Creality3DPrinting/Ender-3/Ender-3 Mechanical/Ender-3 Parts/ender_lcd.png

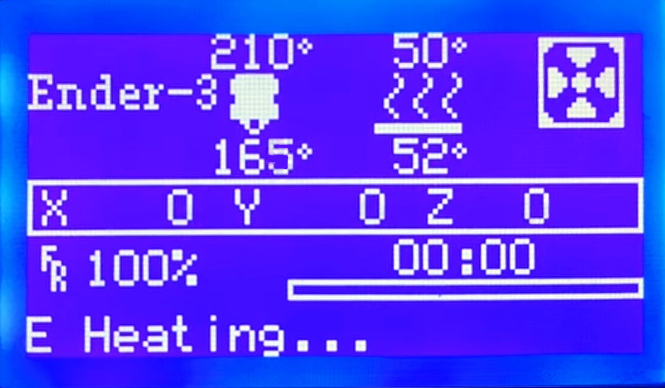
Ender-3 Mechanical/Ender-3 Parts/ender_lcd.png
