Creality3DPrinting/Ender-3/README.md

# Ender-3
The Creality3D Ender-3, a fully Open Source 3D printer perfect for new users on a budget.
