Creality3DPrinting/Ender-3/Ender-3 SD/2.Software and USB Driver/CURA/Reference data/Ender 3 Reference data.pdf

# Ender 3 Reference data

Shenzhen Creality3D Technology CO.,LTD.

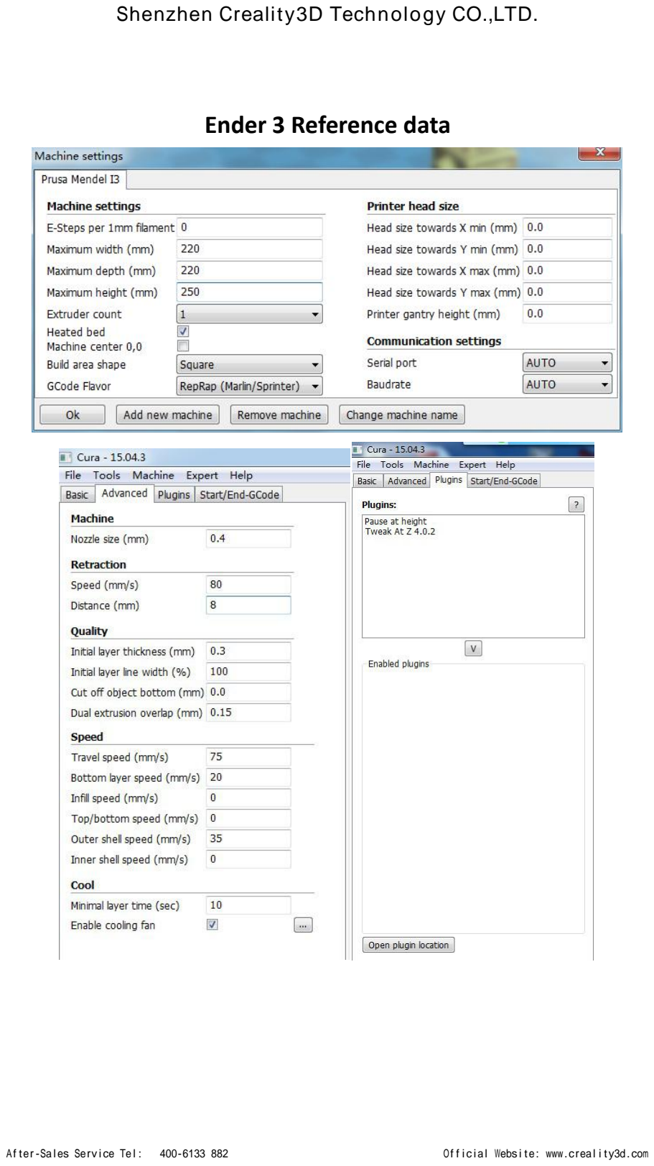
[picture p2: page 1]

After-Sales Service Tel: | 400-6133 882 | Official Website: www.creality3d.com

Shenzhen Creality3D Technology CO.,LTD.

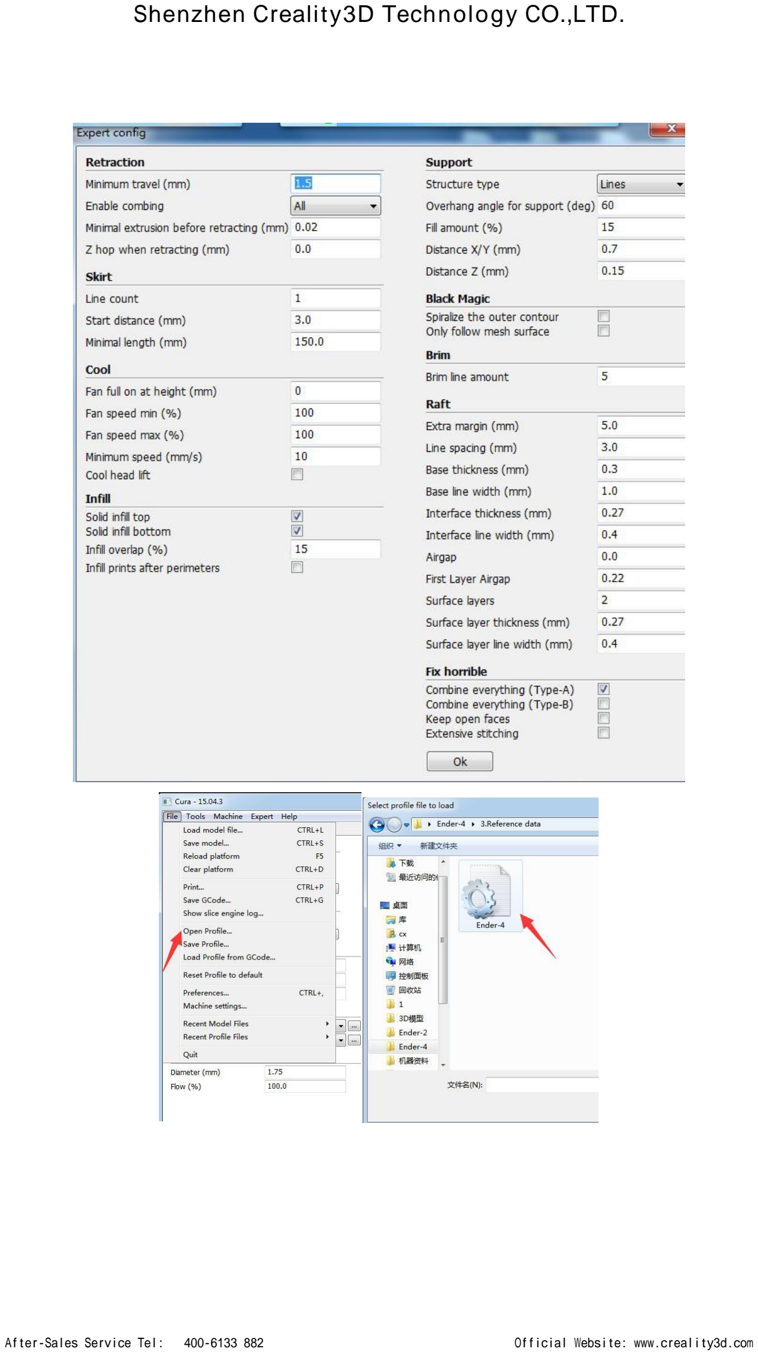
[picture p3: page 2]

After-Sales Service Tel: | 400-6133 882 | Official Website: www.creality3d.com
