Creality3DPrinting/Ender-3/Ender-3 Mechanical/Ender-3 Parts/ender-3.jpg

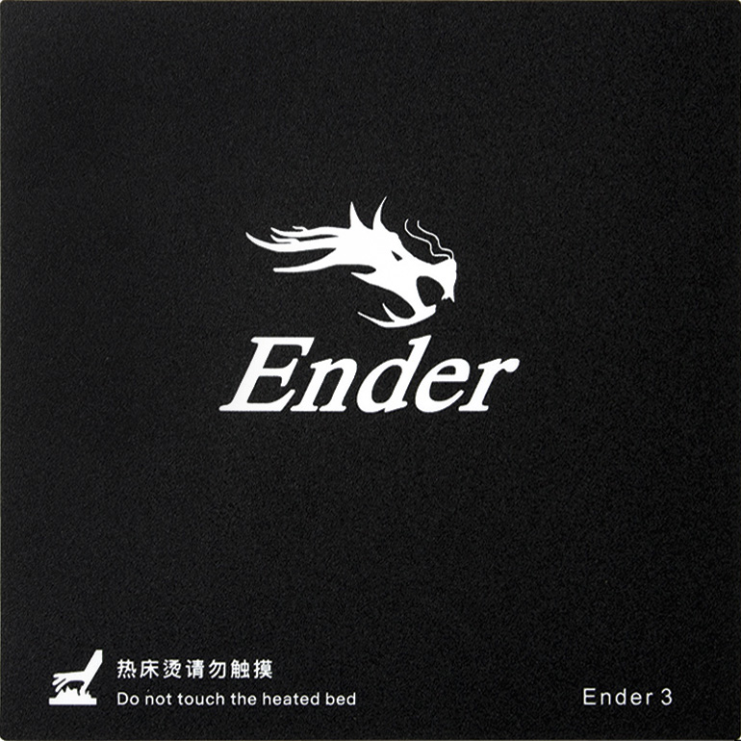
Ender-3 Mechanical/Ender-3 Parts/ender-3.jpg
