Creality3DPrinting/Ender-3/Ender-3 Mechanical/Ender-3 Parts/ASM X-Axis.SLDASM

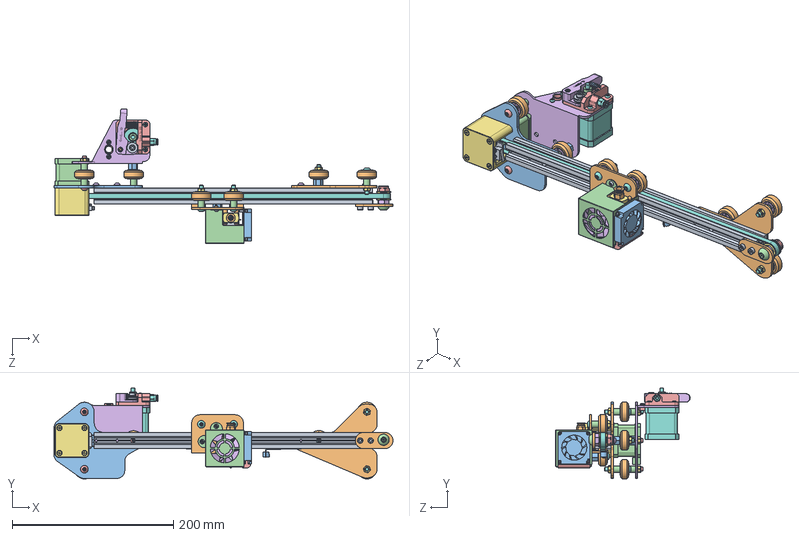
[picture p8: CAD file, 2018-09-13]
Ender-3 Mechanical/Ender-3 Parts/ASM X-Axis.SLDASM
420.0 x 112.6 x 166.7 mm
2020 profile
Z Stent
X motor bracket
42-34 motor
z nut
E motor bracket
X limit switch bracket
X belt
limit switch
2GT-pulley
Copper cover x 2
M4 Split Washer x 5
M3 Split Washer x 4
M4X16 Pan Head Screw x 4
M3X40-P x 4
M3X10 Pan Head Screw x 8
M3X6Pan Head Screw x 4
Rollers x 9
Eccentric column x 3
Spacers for rollers x 9
M5X40 Pan Head Screw x 3
625pillow x 18
M5 Self-locking nut x 9
40-42 motor
624U pillow
M3X18 Socket Head Screw
Extrusion Spring
E gear
E housing 2
E idler tensioner
M3X10 Flush Head Screw
M6 Pneumatic joint
M4X8 Socket Head Screw x 3
X Adjustment Block
M5 T-Slot Nut x 2
M8X25 Pan Head Screw
M8 Self-locking nut
M8 nut
F688 pillow x 2
M5X30 Pan Head Screw x 6
M5 Split Washer
E plate
Cold section fan
Fan cover
Nozzle fan duct
Nozzle fan
Radiator
nozzle
Heat block
Pneumatic joint
Nozzle thermistor
Heater
M3X16 Pan Head Screw x 2
M3×18 Flush Head Screw x 2
M3 Screw x 2
M5 washer
M2X8 Socket Head Screw x 4
