Creality3DPrinting/Ender-3/Ender-3 Mechanical/Ender-3 Parts/ASM Roller Y-Axis.SLDASM

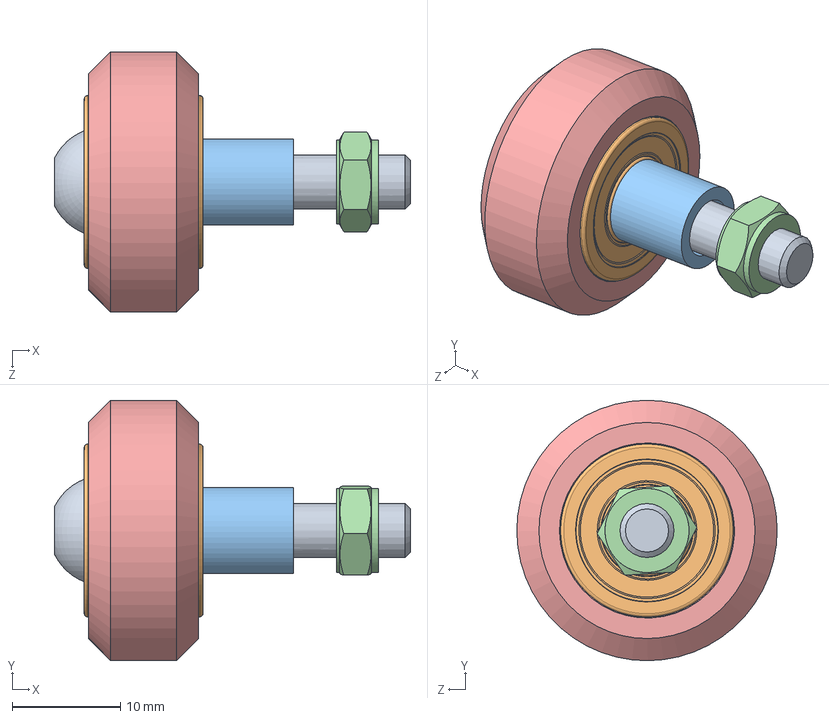
[picture p9: CAD file, 2018-09-13]
Ender-3 Mechanical/Ender-3 Parts/ASM Roller Y-Axis.SLDASM
33.0 x 24.1 x 24.1 mm
M5X30 Pan Head Screw
625pillow x 2
Spacers for rollers
M5 Self-locking nut
Rollers
