Creality3DPrinting/Ender-3/Ender-3 Mechanical/Ender-3 Parts/ASM Extruder.SLDASM

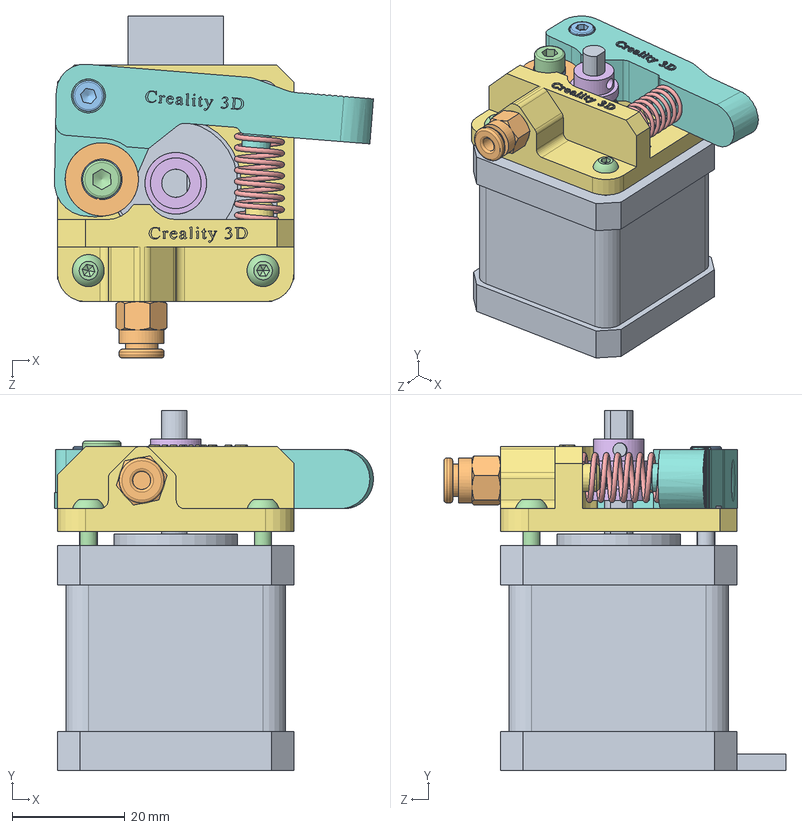
[picture p10: CAD file, 2018-09-13]
Ender-3 Mechanical/Ender-3 Parts/ASM Extruder.SLDASM
56.7 x 64.0 x 60.7 mm
40-42 motor
624U pillow
M3X18 Socket Head Screw
M3X10 Pan Head Screw x 2
Extrusion Spring
E gear
E housing 2
E idler tensioner
M3X10 Flush Head Screw
M6 Pneumatic joint
M4 Split Washer
M4X8 Socket Head Screw
