Creality3DPrinting/Ender-3/Ender-3 Mechanical/Ender-3 Parts/ASM Heating Unit.SLDASM

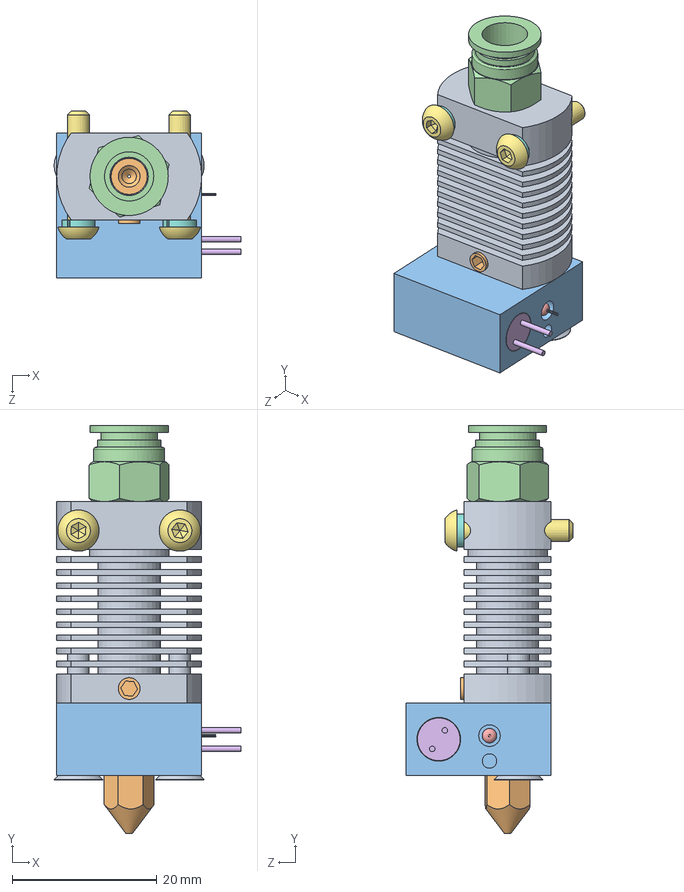
[picture p11: CAD file, 2018-09-13]
Ender-3 Mechanical/Ender-3 Parts/ASM Heating Unit.SLDASM
25.8 x 56.3 x 23.0 mm
Radiator
nozzle
Heat block
Pneumatic joint
Nozzle thermistor
Heater
M3X16 Pan Head Screw x 2
M3 Split Washer x 2
M3×18 Flush Head Screw x 2
M3 Screw x 2
