Creality3DPrinting/Ender-3/Ender-3 Mechanical/Ender-3 Parts/ASM Eccentrical Roller Y-Axis.SLDASM

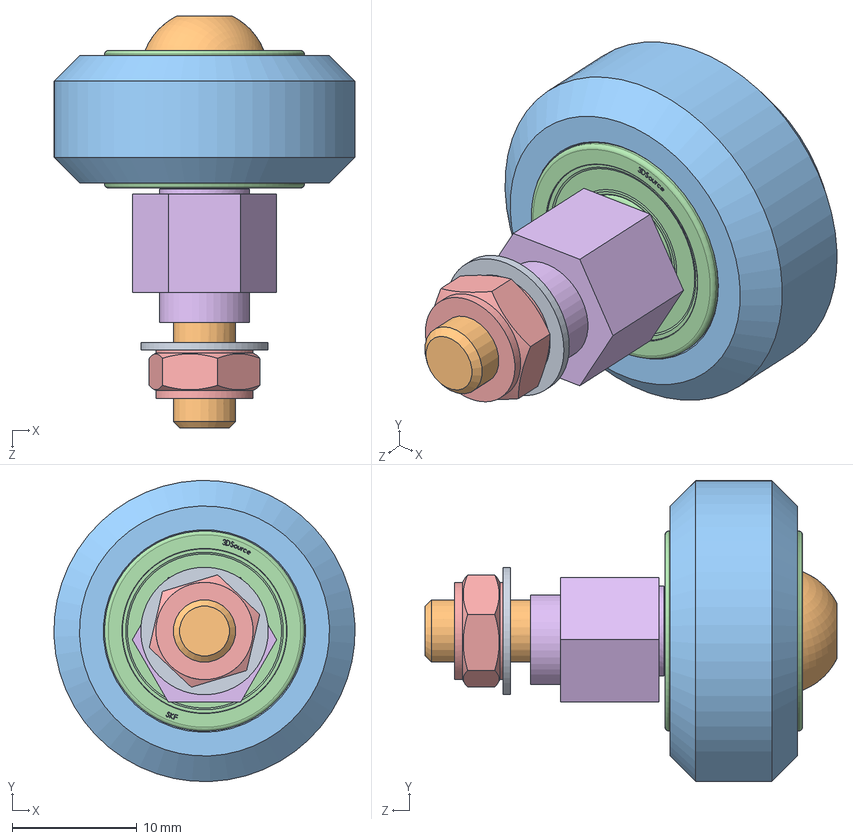
[picture p12: CAD file, 2018-09-13]
Ender-3 Mechanical/Ender-3 Parts/ASM Eccentrical Roller Y-Axis.SLDASM
24.1 x 24.1 x 33.0 mm
M5 washer
M5X30 Pan Head Screw
Rollers
625pillow x 2
M5 Self-locking nut
Eccentric column
