Creality3DPrinting/Ender-3/Ender-3 Mechanical/Ender-3 Parts/ASM X-Belt Tensioner.SLDASM

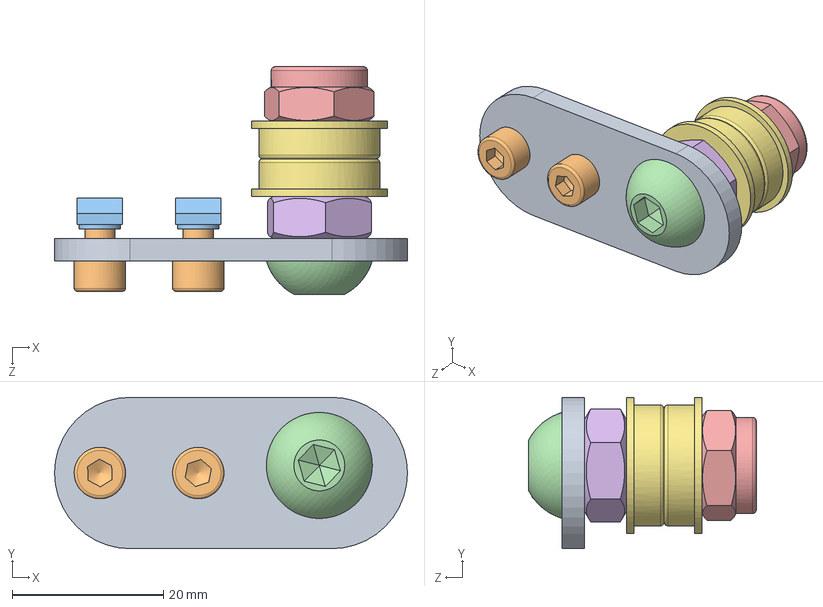
[picture p14: CAD file, 2018-09-13]
Ender-3 Mechanical/Ender-3 Parts/ASM X-Belt Tensioner.SLDASM
46.7 x 20.0 x 30.1 mm
X Adjustment Block
M4X8 Socket Head Screw x 2
M5 T-Slot Nut x 2
M8X25 Pan Head Screw
M8 Self-locking nut
M8 nut
F688 pillow x 2
