Creality3DPrinting/Ender-3/Ender-3 Mechanical/Ender-3 Parts/ASM Printing Head.SLDASM

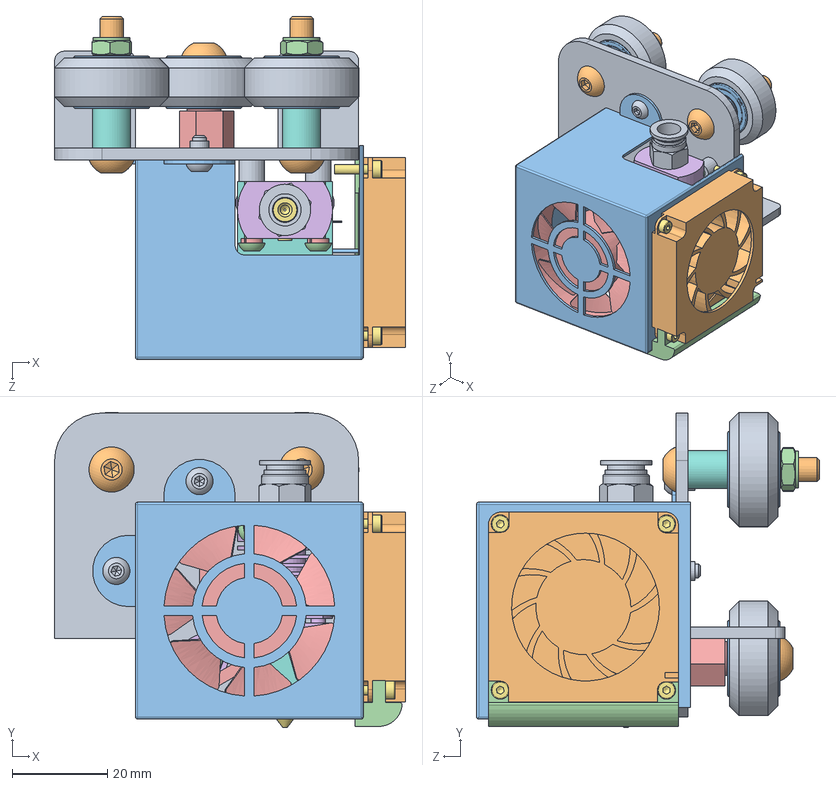
[picture p17: CAD file, 2018-09-13]
Ender-3 Mechanical/Ender-3 Parts/ASM Printing Head.SLDASM
73.9 x 66.4 x 72.2 mm
E plate
Cold section fan
Fan cover
Nozzle fan duct
Nozzle fan
Radiator
nozzle
Heat block
Pneumatic joint
Nozzle thermistor
Heater
M3X16 Pan Head Screw x 2
M3 Split Washer x 2
M3×18 Flush Head Screw x 2
M3 Screw x 2
Spacers for rollers x 2
Rollers x 3
M5X30 Pan Head Screw x 3
625pillow x 6
M5 Self-locking nut x 3
Eccentric column
M5 washer
M2X8 Socket Head Screw x 4
M3X10 Pan Head Screw x 4
M3X6Pan Head Screw x 2
