Creality3DPrinting/Ender-3/Ender-3 Mechanical/Ender-3 Parts/ASM Spool Holder.SLDASM

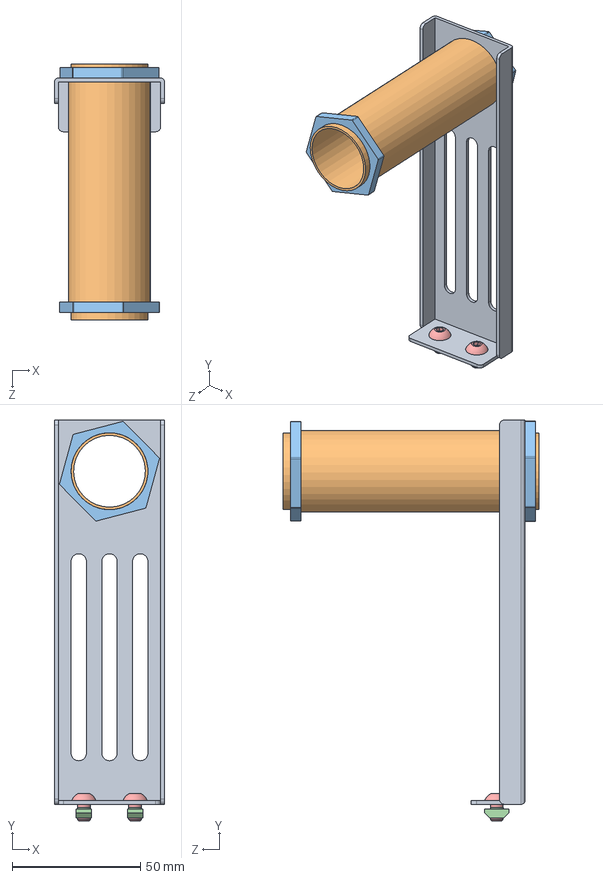
[picture p18: CAD file, 2018-09-13]
Ender-3 Mechanical/Ender-3 Parts/ASM Spool Holder.SLDASM
43.0 x 156.5 x 100.0 mm
Support frame
Support tube
M30 Plastic nut x 2
M4 T-Slot Nut x 2
M5X8Pan Head Screw x 2
