Creality3DPrinting/Ender-3/Ender-3 Mechanical/Ender-3 Parts/ASM Eccentrical Roller Z-Axis Left.SLDASM

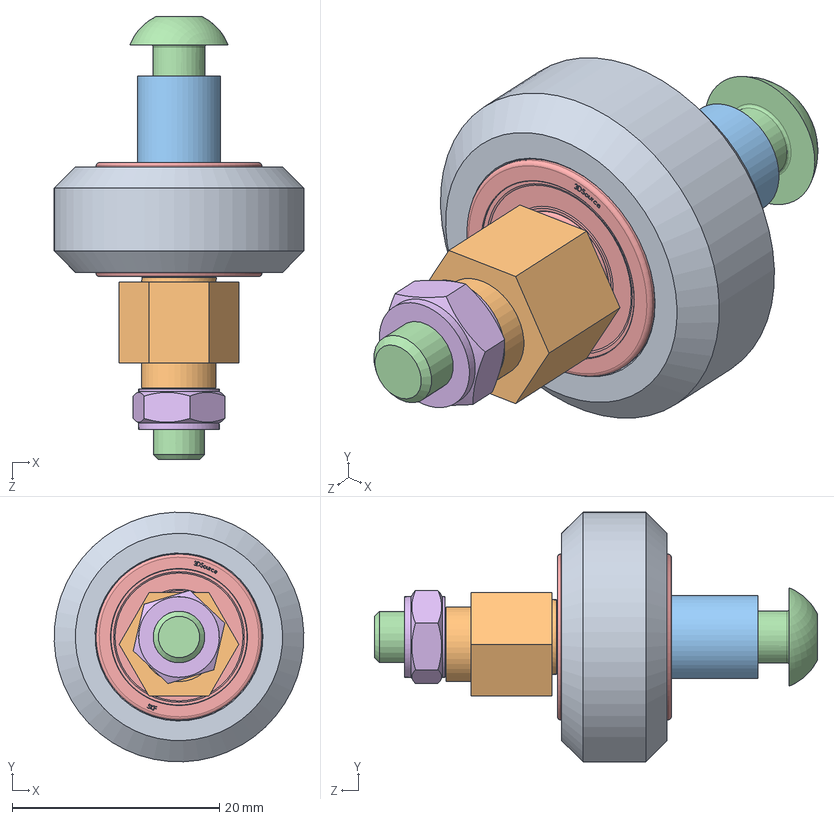
[picture p24: CAD file, 2018-09-13]
Ender-3 Mechanical/Ender-3 Parts/ASM Eccentrical Roller Z-Axis Left.SLDASM
24.1 x 24.1 x 42.8 mm
Rollers
Eccentric column
Spacers for rollers
M5X40 Pan Head Screw
625pillow x 2
M5 Self-locking nut
