Creality3DPrinting/Ender-3/Ender-3 Mechanical/Ender-3 Parts/ASM Roller Z-Axis Left.SLDASM

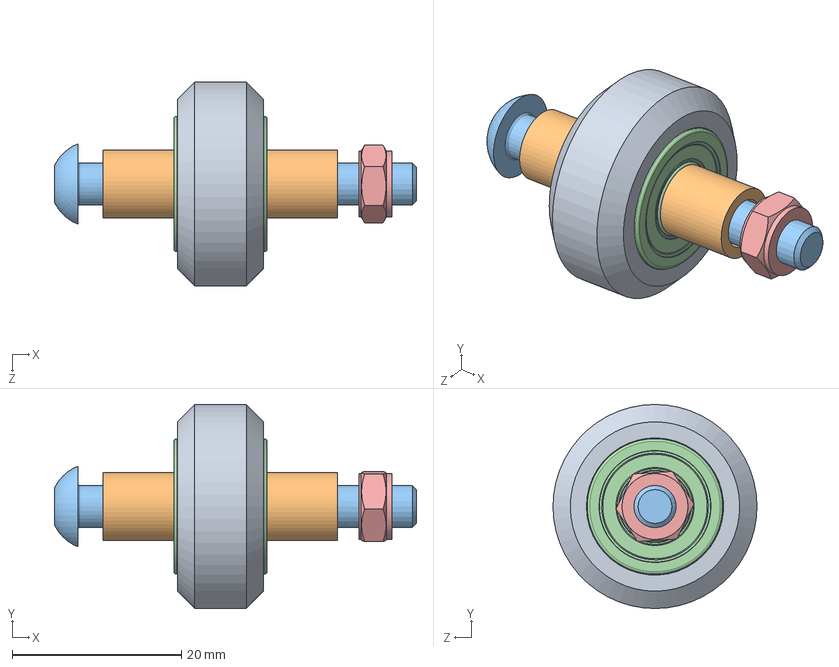
[picture p25: CAD file, 2018-09-13]
Ender-3 Mechanical/Ender-3 Parts/ASM Roller Z-Axis Left.SLDASM
42.8 x 24.1 x 24.1 mm
Rollers
Spacers for rollers x 2
M5X40 Pan Head Screw
625pillow x 2
M5 Self-locking nut
