Creality3DPrinting/Ender-3/Ender-3 Mechanical/Ender-3 Parts/V Wheel Component.SLDASM

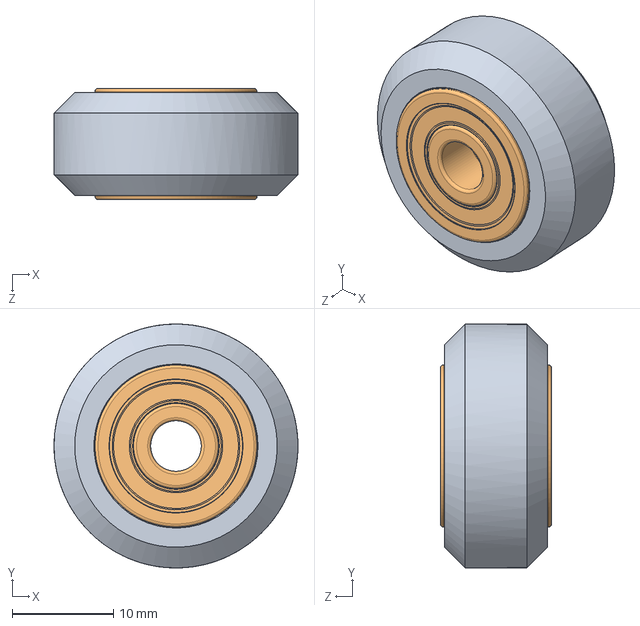
[picture p27: CAD file, 2018-06-30]
Ender-3 Mechanical/Ender-3 Parts/V Wheel Component.SLDASM
24.1 x 24.1 x 11.0 mm
Rollers
625pillow x 2
