Creality3DPrinting/Ender-3/Ender-3 Mechanical/Ender-3 Parts/Fan assembly.SLDASM

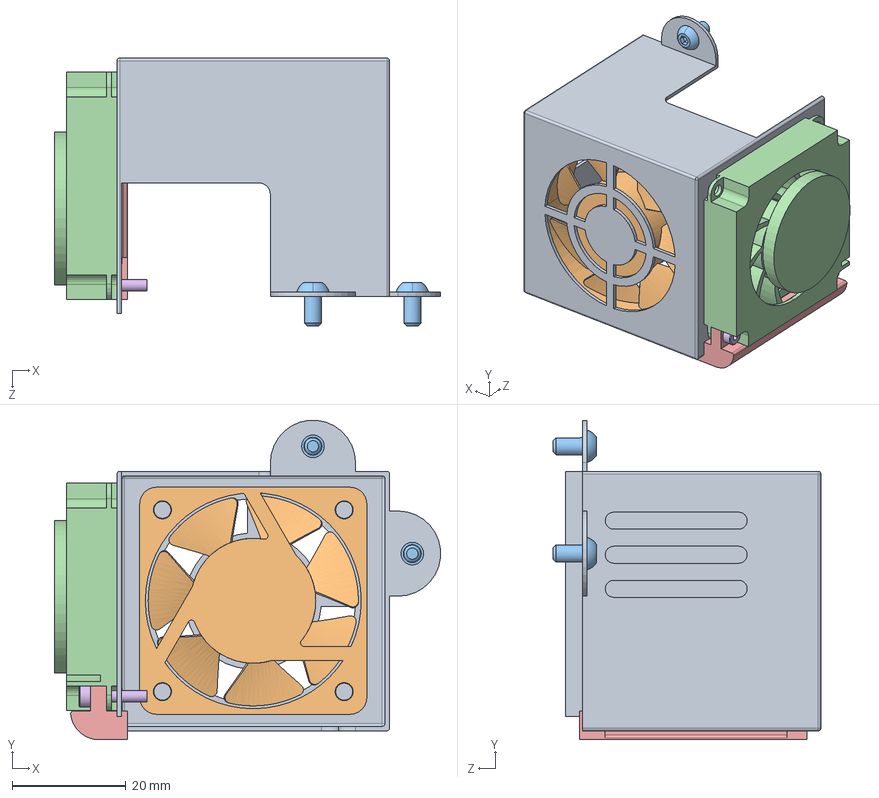
[picture p28: CAD file, 2018-06-30]
Ender-3 Mechanical/Ender-3 Parts/Fan assembly.SLDASM
68.0 x 56.2 x 47.2 mm
Fan cover
Nozzle fan
M3X6Pan Head Screw x 2
Cold section fan
Nozzle fan duct
M2X10杯头 x 2
