Creality3DPrinting/Ender-3/Ender-3 Mechanical/Ender-3 Parts/Z Limit Switch assembly.SLDASM

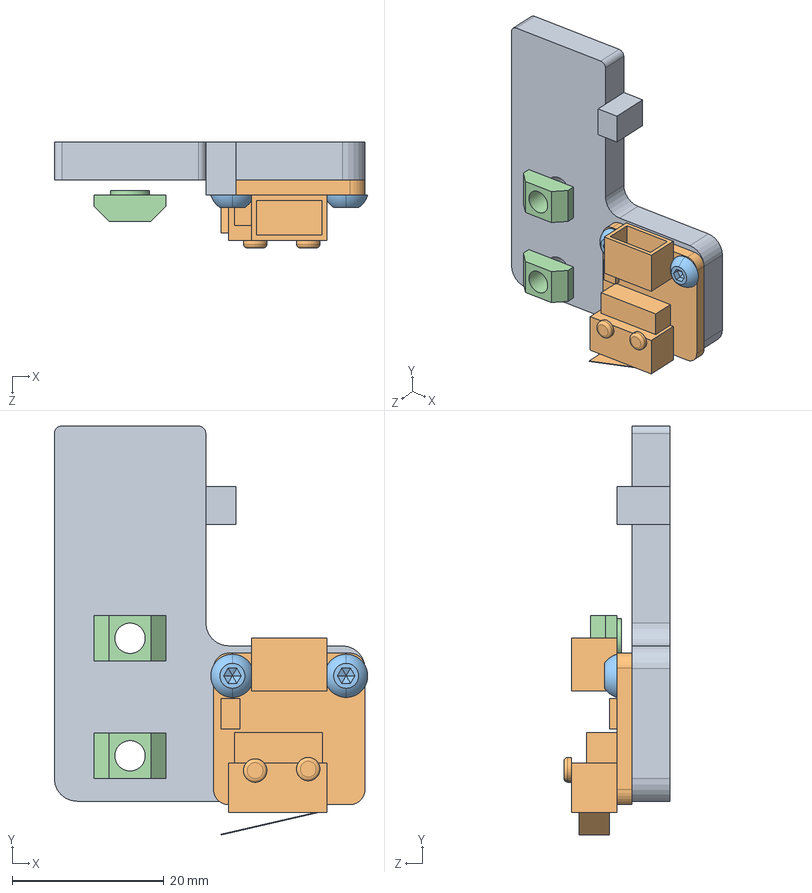
[picture p29: CAD file, 2018-06-30]
Ender-3 Mechanical/Ender-3 Parts/Z Limit Switch assembly.SLDASM
41.4 x 54.0 x 14.0 mm
Z limit switch bracket
limit switch
M3X6Pan Head Screw x 2
M4 T-Slot Nut x 2
