Creality3DPrinting/Ender-3/Ender-3 Mechanical/Ender-3 Parts/Sprinkler assembly.SLDASM

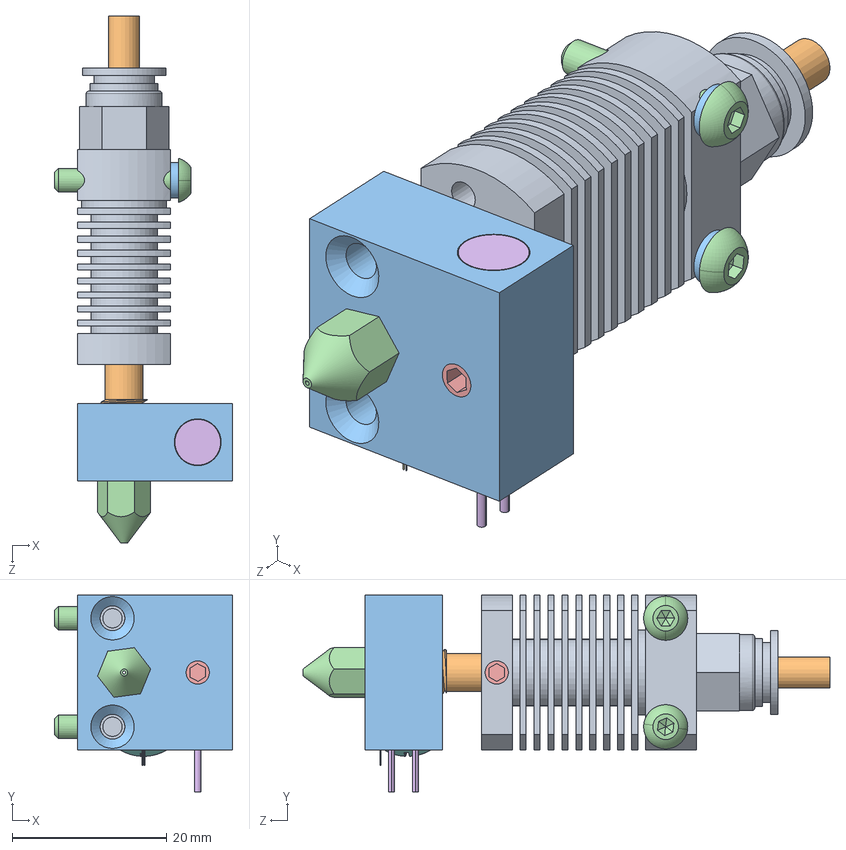
[picture p30: CAD file, 2018-06-30]
Ender-3 Mechanical/Ender-3 Parts/Sprinkler assembly.SLDASM
23.0 x 25.4 x 68.0 mm
Radiator
Catheter
Heat block
nozzle
M3 Screw x 2
Heater
Nozzle thermistor
M3X4 Screw
Pneumatic joint
D4 Teflon tube
M3 Split Washer x 2
M3X16 Pan Head Screw x 2
