Creality3DPrinting/Ender-3/Ender-3 Mechanical/STP/Z Stent.step

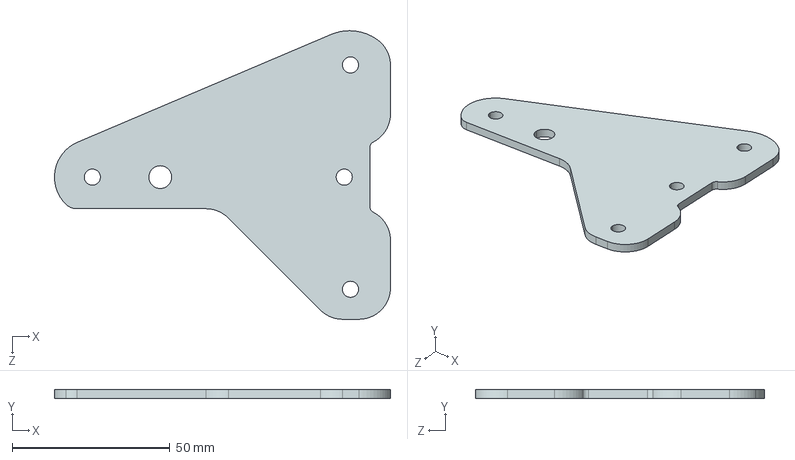
[picture p31: CAD file, 2018-06-30]
Ender-3 Mechanical/STP/Z Stent.step
106.3 x 3.00 x 91.3 mm
