Creality3DPrinting/Ender-3/Ender-3 SD/4.Modle/test/test-dog.stl

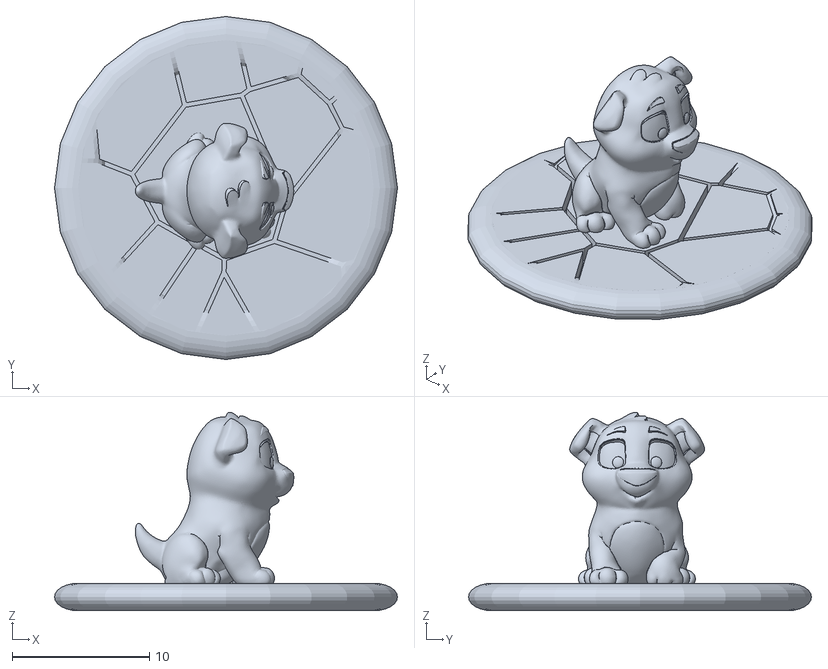
[picture p32: CAD file, 2019-12-11]
Ender-3 SD/4.Modle/test/test-dog.stl
25.0 x 25.0 x 14.5
