Creality3DPrinting/Ender-3/Ender-3 Mechanical/Ender-3 Parts/E housing 2.SLDPRT

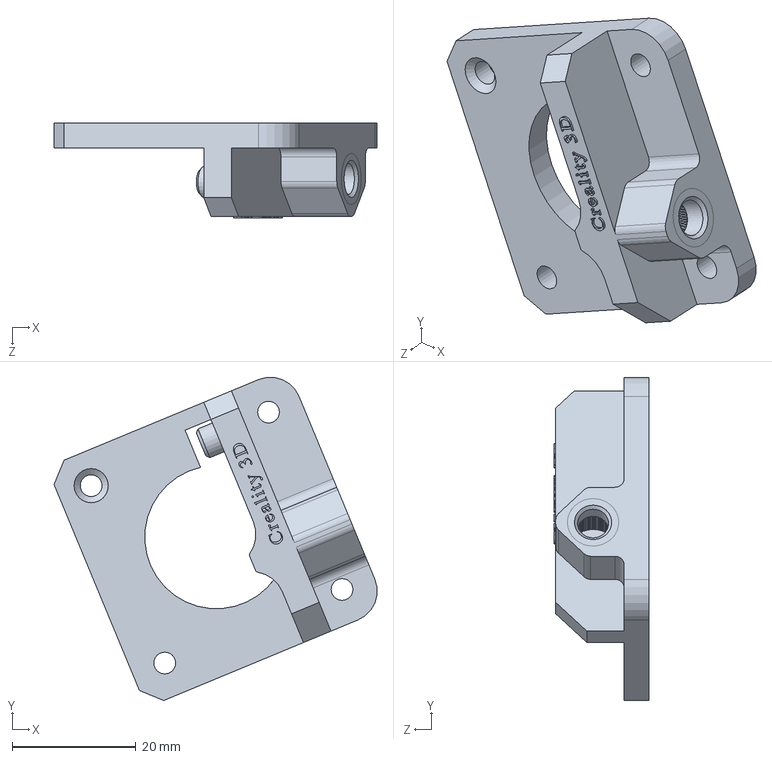
[picture p33: CAD file, 2018-09-13]
Ender-3 Mechanical/Ender-3 Parts/E housing 2.SLDPRT
52.2 x 52.2 x 15.4 mm
