Creality3DPrinting/Ender-3/Ender-3 Mechanical/Ender-3 Parts/2020 Endcap.SLDPRT

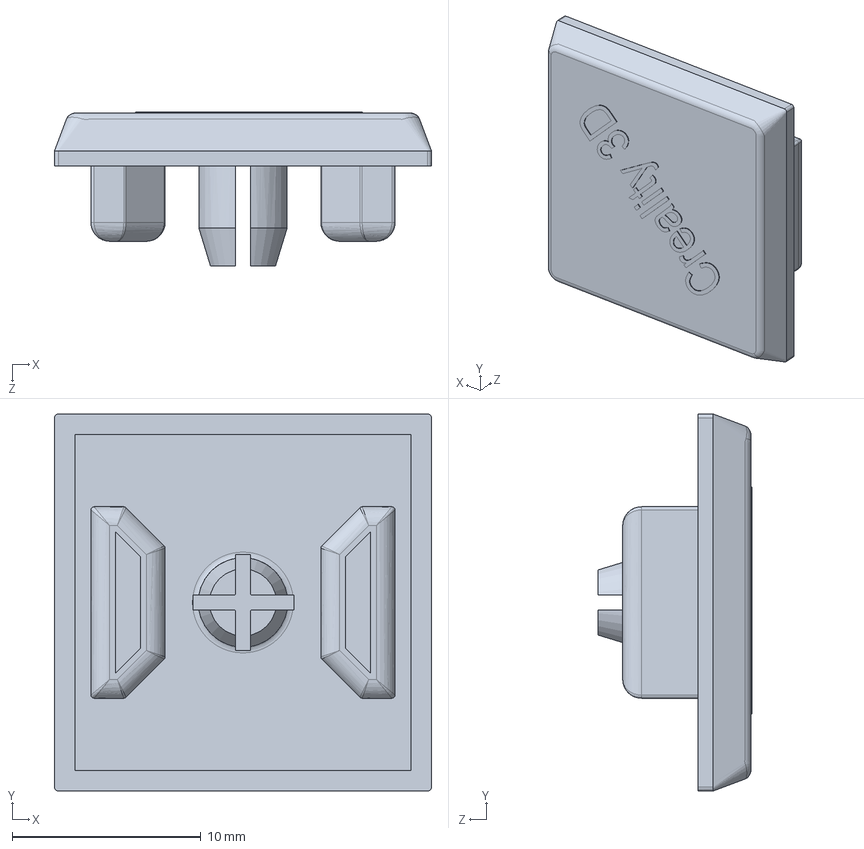
[picture p34: CAD file, 2018-09-13]
Ender-3 Mechanical/Ender-3 Parts/2020 Endcap.SLDPRT
20.0 x 20.0 x 8.15 mm
