Creality3DPrinting/Ender-3/Ender-3 Mechanical/STP/Z threaded rod.step

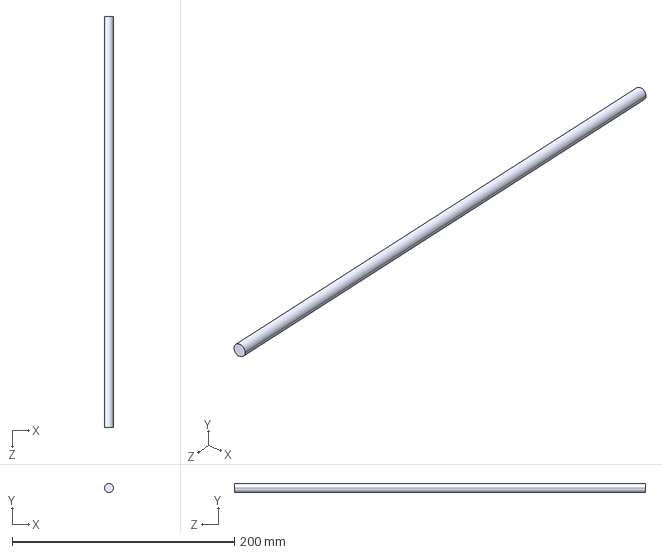
[picture p35: CAD file, 2018-06-30]
Ender-3 Mechanical/STP/Z threaded rod.step
8.00 x 8.00 x 370.0 mm
