Creality3DPrinting/Ender-3/Ender-3 Mechanical/Ender-3 Parts/Y plate.SLDPRT

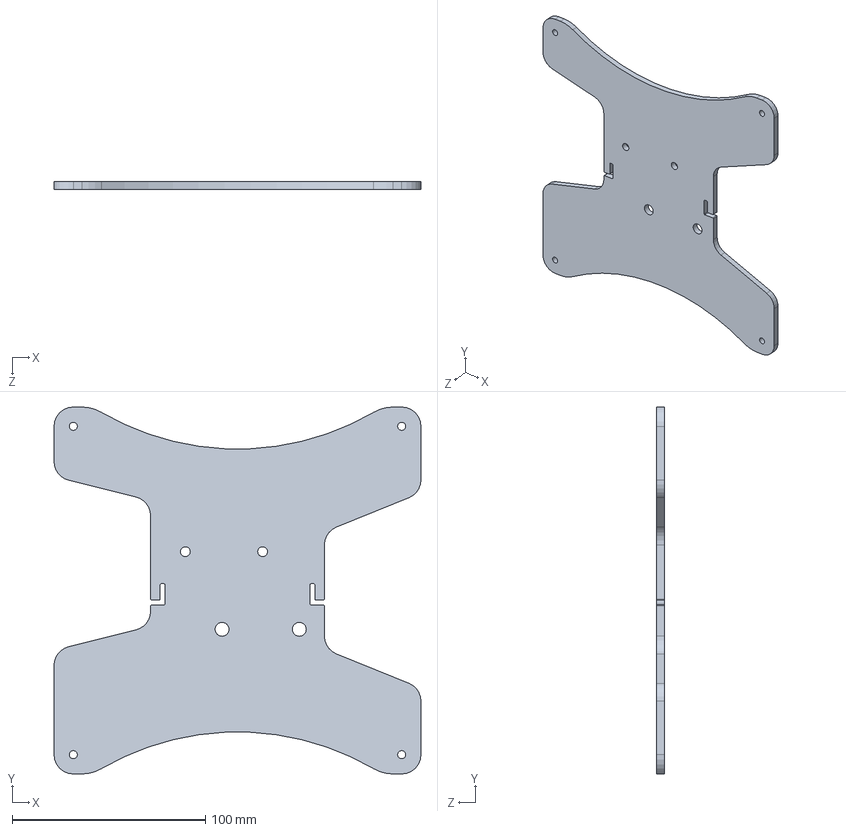
[picture p36: CAD file, 2018-09-13]
Ender-3 Mechanical/Ender-3 Parts/Y plate.SLDPRT
190.0 x 190.0 x 4.00 mm
