Creality3DPrinting/Ender-3/Ender-3 Mechanical/STP/Heat block.step

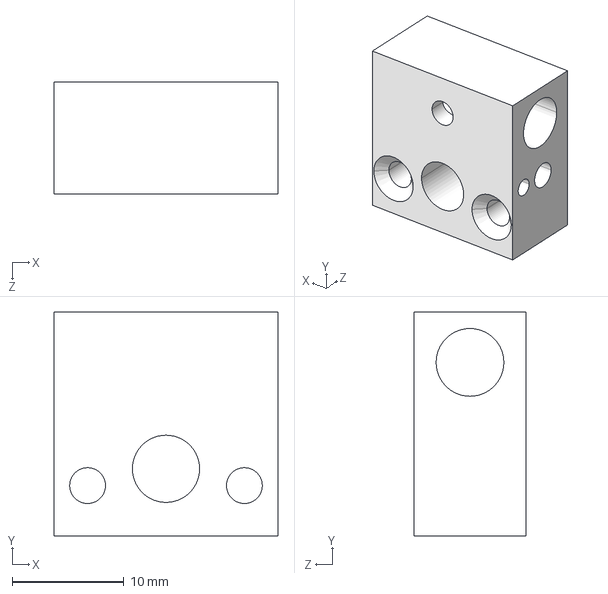
[picture p37: CAD file, 2018-06-30]
Ender-3 Mechanical/STP/Heat block.step
20.0 x 20.0 x 10.0 mm
