Creality3DPrinting/Ender-3/Ender-3 Mechanical/Ender-3 Parts/lcd.SLDPRT

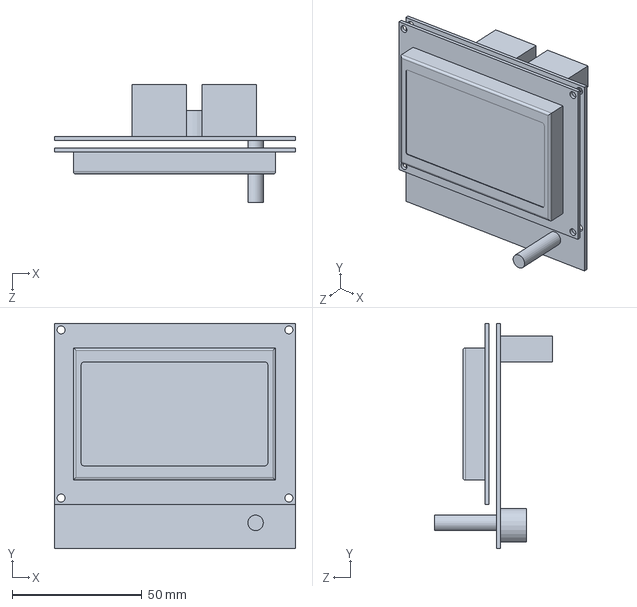
[picture p39: CAD file, 2018-09-13]
Ender-3 Mechanical/Ender-3 Parts/lcd.SLDPRT
93.0 x 87.0 x 45.5 mm
