Creality3DPrinting/Ender-3/Ender-3 Mechanical/Ender-3 Parts/X motor bracket.SLDPRT

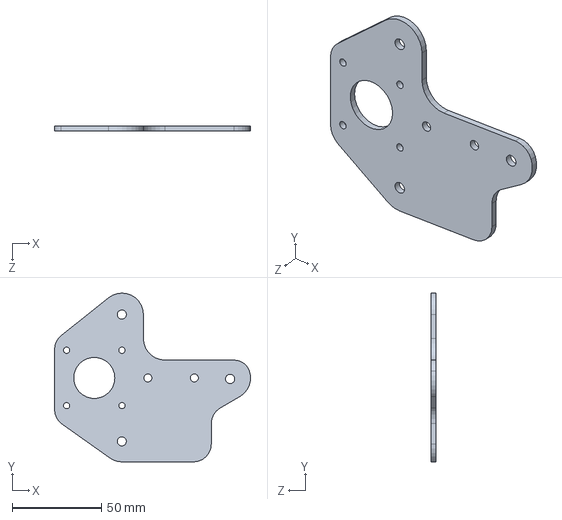
[picture p41: CAD file, 2018-09-13]
Ender-3 Mechanical/Ender-3 Parts/X motor bracket.SLDPRT
109.7 x 94.5 x 3.00 mm
