Creality3DPrinting/Ender-3/Ender-3 Mechanical/STP/42-34 motor.step

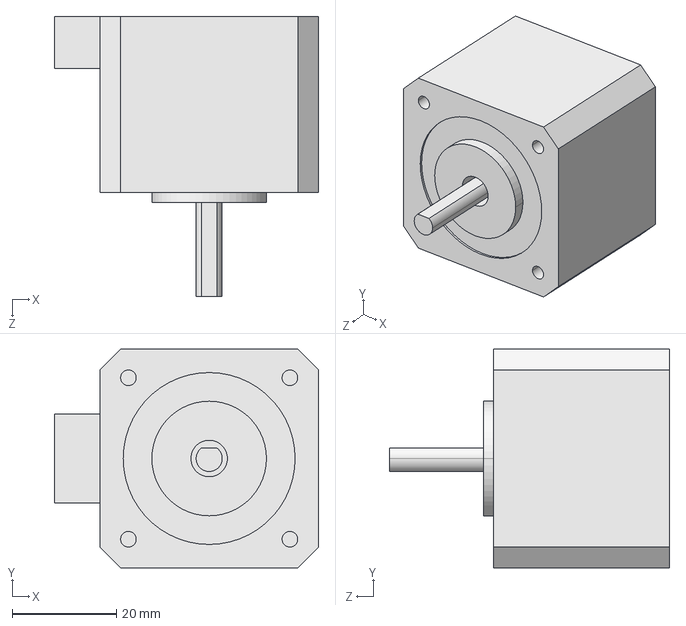
[picture p42: CAD file, 2018-06-30]
Ender-3 Mechanical/STP/42-34 motor.step
50.7 x 42.0 x 53.8 mm
