Creality3DPrinting/Ender-3/Ender-3 Mechanical/Ender-3 Parts/Heater.SLDPRT

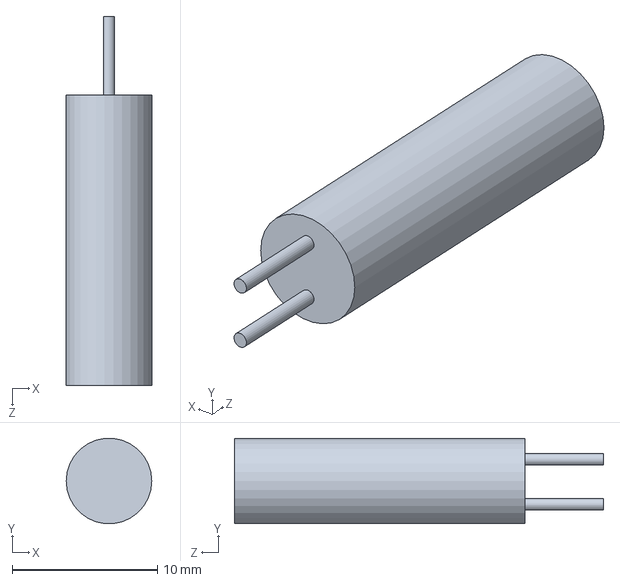
[picture p43: CAD file, 2018-09-13]
Ender-3 Mechanical/Ender-3 Parts/Heater.SLDPRT
5.90 x 5.87 x 25.4 mm
