Creality3DPrinting/Ender-3/Ender-3 Mechanical/STP/Nozzle thermistor.step

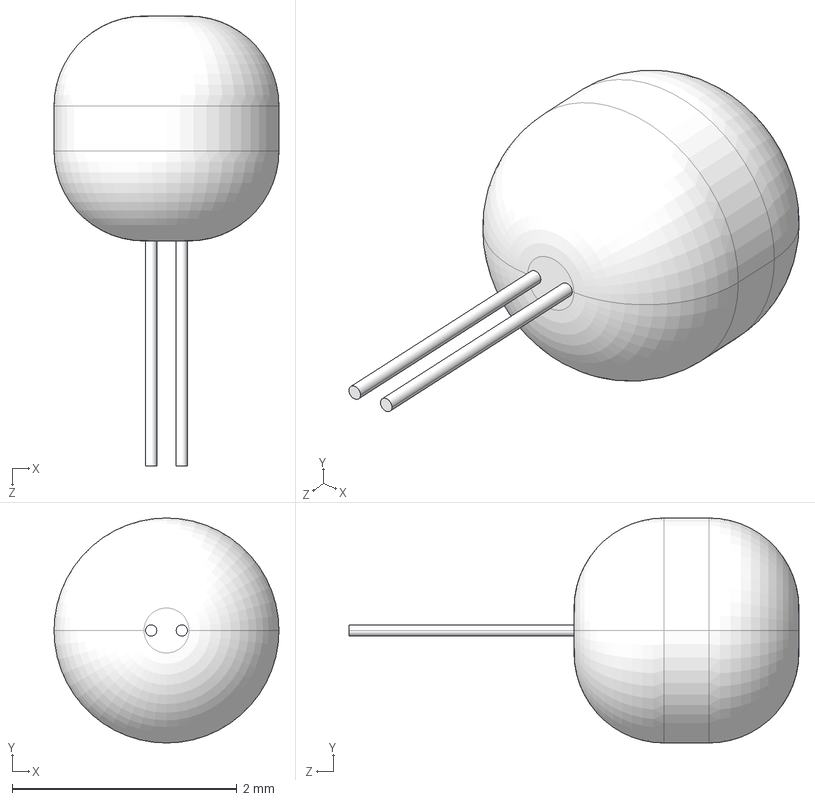
[picture p44: CAD file, 2018-06-30]
Ender-3 Mechanical/STP/Nozzle thermistor.step
2.00 x 2.00 x 4.00 mm
