Creality3DPrinting/Ender-3/Ender-3 Mechanical/STP/X belt.step

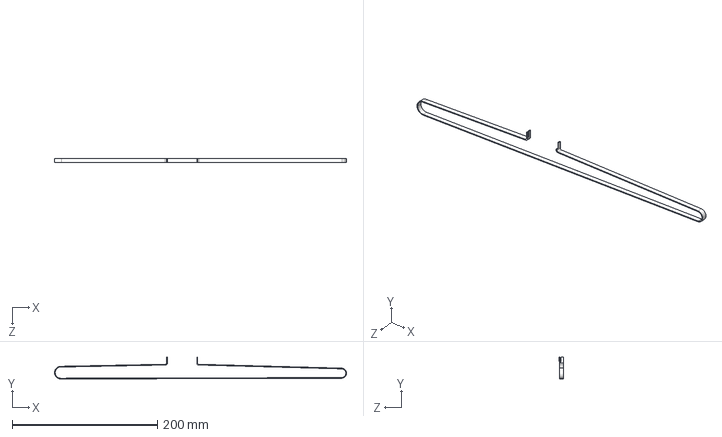
[picture p45: CAD file, 2018-06-30]
Ender-3 Mechanical/STP/X belt.step
401.8 x 30.2 x 6.00 mm
