Creality3DPrinting/Ender-3/Ender-3 Mechanical/Ender-3 Parts/Bed level springs.SLDPRT

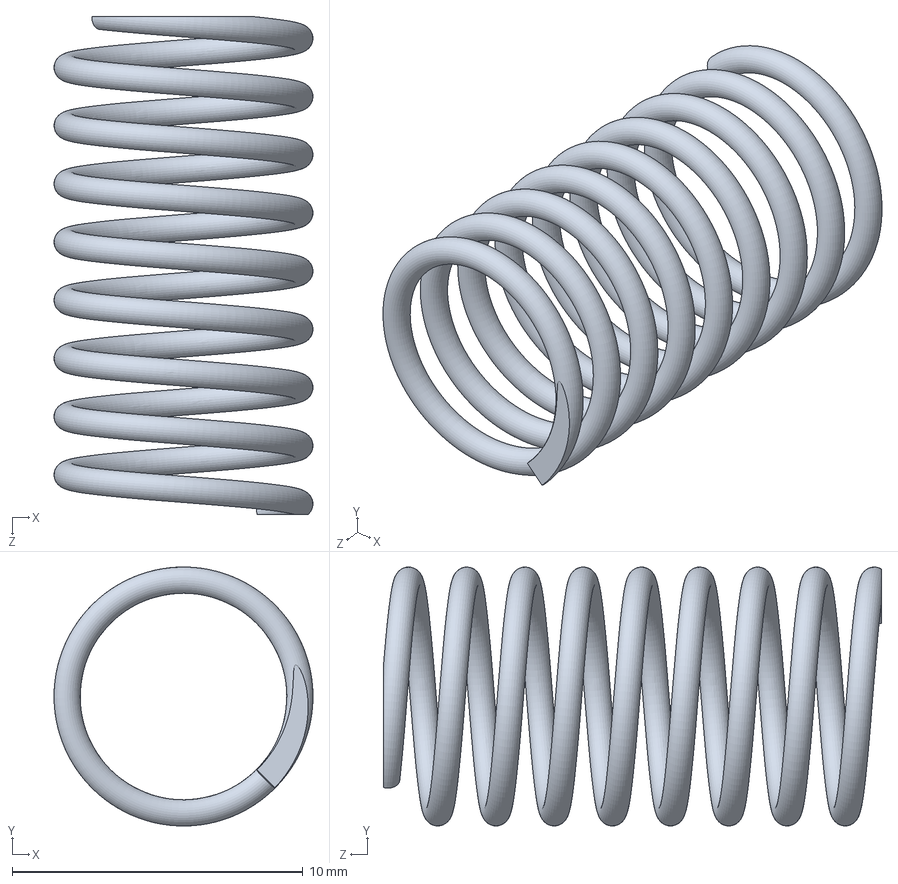
[picture p46: CAD file, 2018-09-13]
Ender-3 Mechanical/Ender-3 Parts/Bed level springs.SLDPRT
8.90 x 8.90 x 17.1 mm
