Creality3DPrinting/Ender-3/Ender-3 Mechanical/STP/625pillow.step

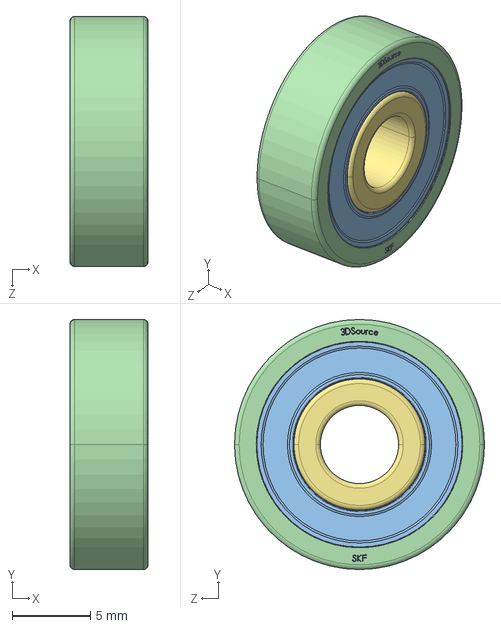
[picture p47: CAD file, 2018-06-30]
Ender-3 Mechanical/STP/625pillow.step
5.00 x 16.0 x 16.0 mm
