Creality3DPrinting/Ender-3/Ender-3 Mechanical/Ender-3 Parts/Sheetmetal enclosure bottom.SLDPRT

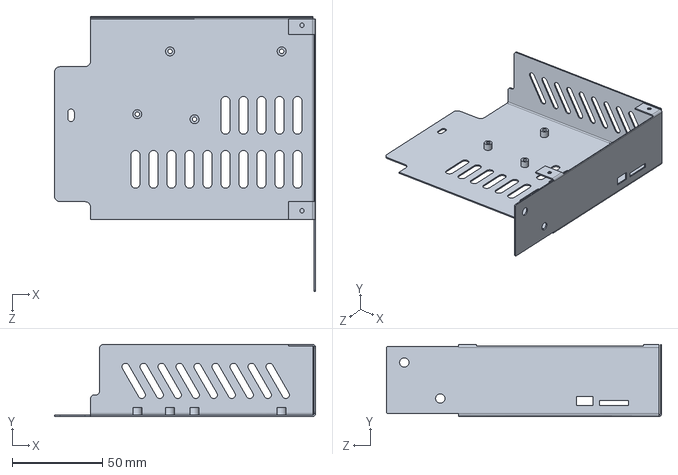
[picture p48: CAD file, 2018-09-13]
Ender-3 Mechanical/Ender-3 Parts/Sheetmetal enclosure bottom.SLDPRT
145.0 x 40.0 x 153.0 mm
