Creality3DPrinting/Ender-3/Ender-3 Mechanical/STP/M6 Pneumatic joint.step

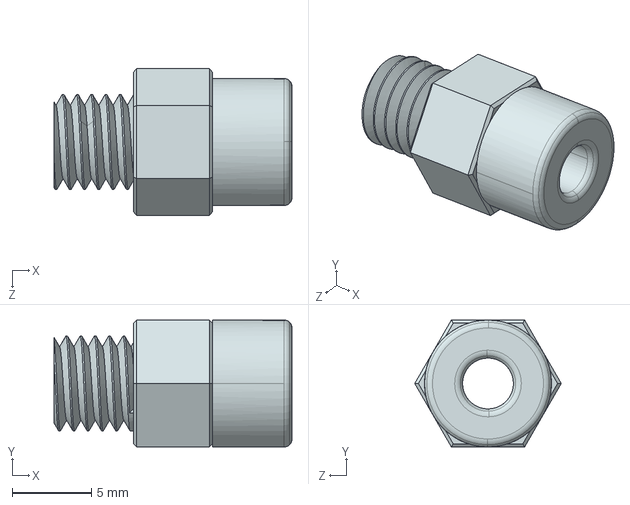
[picture p49: CAD file, 2018-06-30]
Ender-3 Mechanical/STP/M6 Pneumatic joint.step
15.0 x 8.00 x 9.24 mm
