Creality3DPrinting/Ender-3/Ender-3 Mechanical/STP/Cold section fan.step

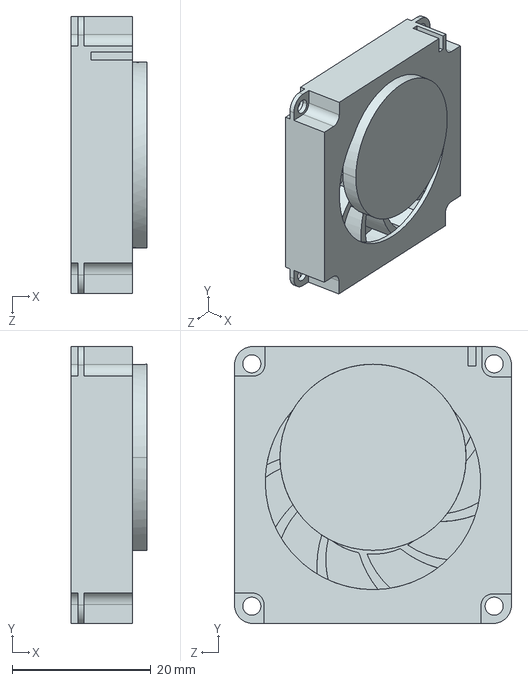
[picture p50: CAD file, 2018-06-30]
Ender-3 Mechanical/STP/Cold section fan.step
11.0 x 40.0 x 40.0 mm
