Creality3DPrinting/Ender-3/Ender-3 Mechanical/STP/Pneumatic joint.step

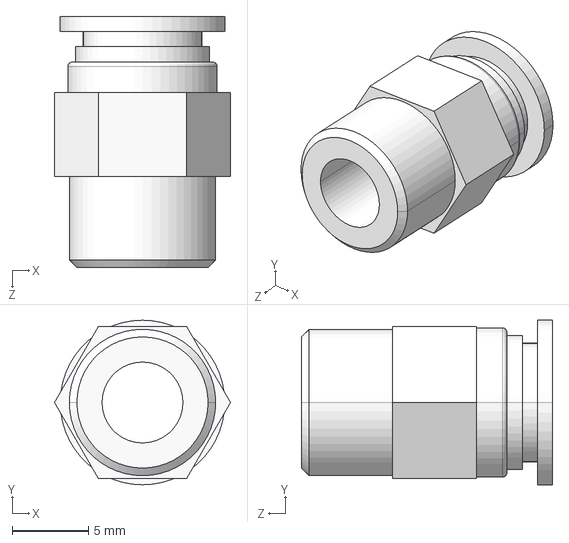
[picture p51: CAD file, 2018-06-30]
Ender-3 Mechanical/STP/Pneumatic joint.step
11.5 x 10.8 x 16.5 mm
