Creality3DPrinting/Ender-3/Ender-3 Mechanical/Ender-3 Parts/E motor bracket.SLDPRT

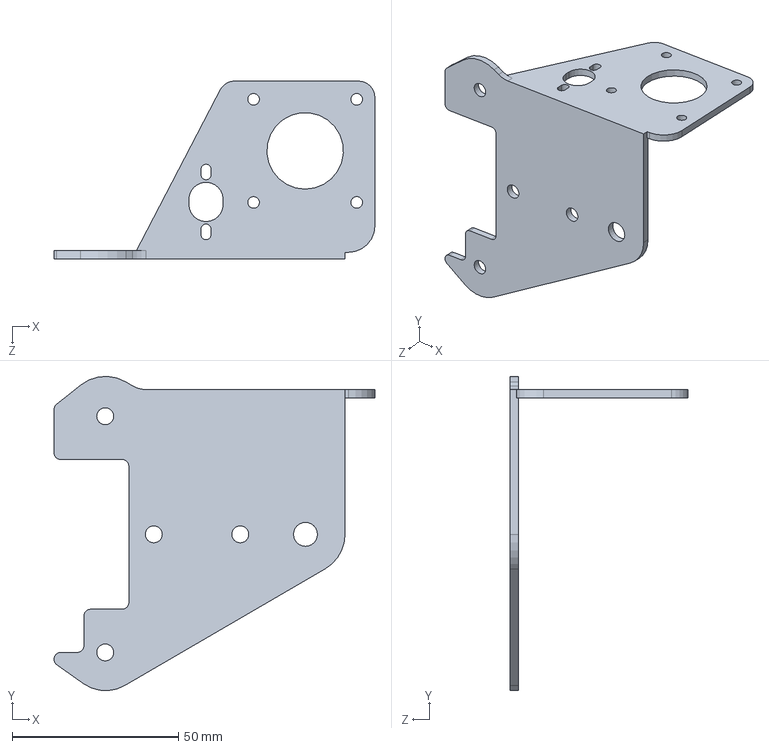
[picture p52: CAD file, 2018-09-13]
Ender-3 Mechanical/Ender-3 Parts/E motor bracket.SLDPRT
96.5 x 94.5 x 53.5 mm
