Creality3DPrinting/Ender-3/Ender-3 Mechanical/Ender-3 Parts/2GT-pulley.SLDPRT

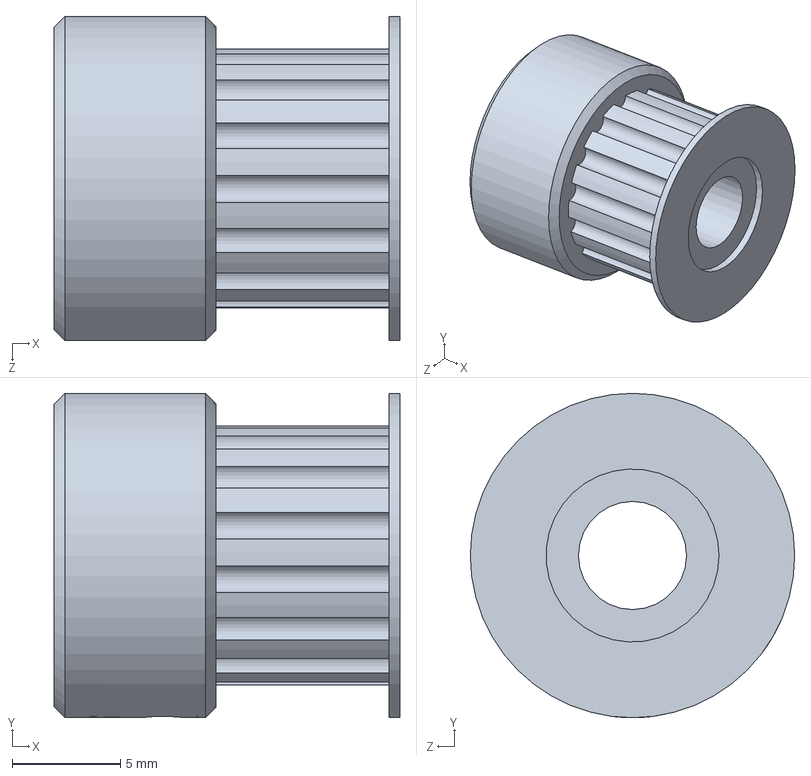
[picture p53: CAD file, 2018-09-13]
Ender-3 Mechanical/Ender-3 Parts/2GT-pulley.SLDPRT
16.0 x 15.0 x 15.0 mm
