Creality3DPrinting/Ender-3/Ender-3 Mechanical/STP/Z limit switch bracket.step

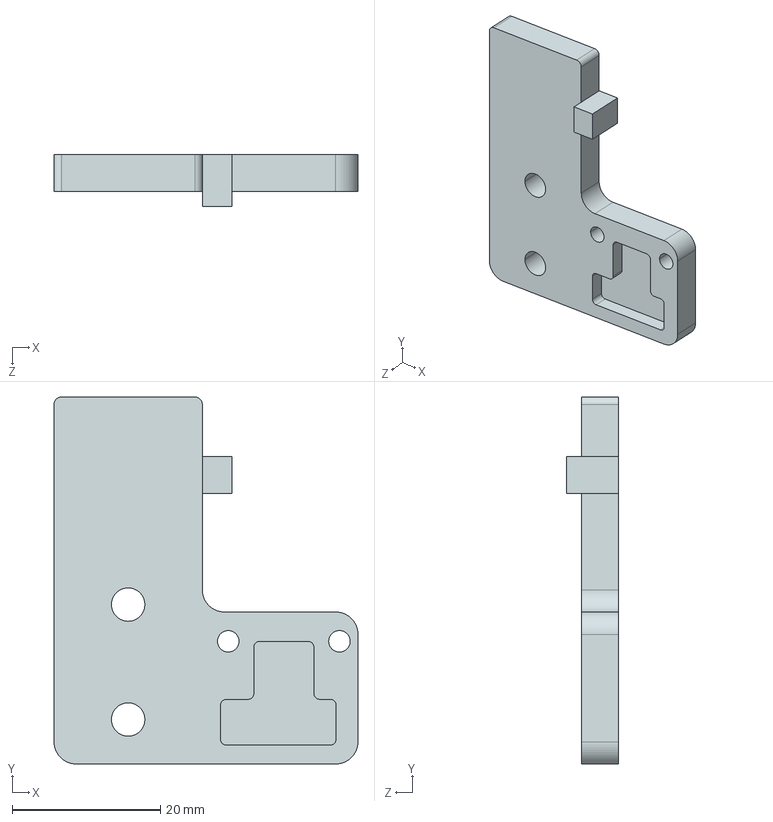
[picture p54: CAD file, 2018-06-30]
Ender-3 Mechanical/STP/Z limit switch bracket.step
41.0 x 49.5 x 7.00 mm
