Creality3DPrinting/Ender-3/Ender-3 Mechanical/Ender-3 Parts/Y Adjustment Block.SLDPRT

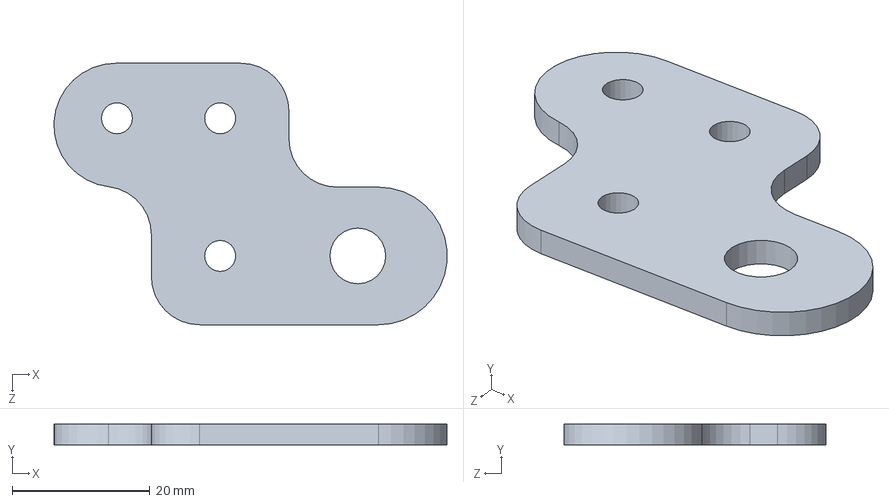
[picture p56: CAD file, 2018-09-13]
Ender-3 Mechanical/Ender-3 Parts/Y Adjustment Block.SLDPRT
57.1 x 3.00 x 38.0 mm
