Creality3DPrinting/Ender-3/Ender-3 Mechanical/Ender-3 Parts/Z motor bracket.SLDPRT

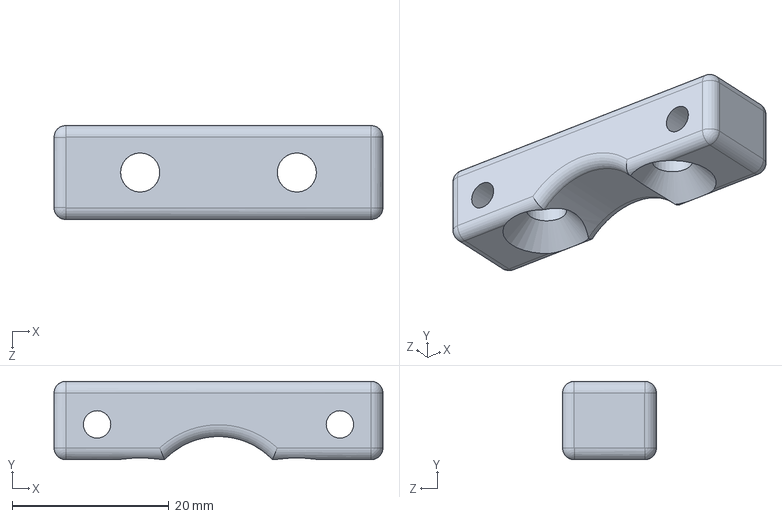
[picture p57: CAD file, 2018-09-13]
Ender-3 Mechanical/Ender-3 Parts/Z motor bracket.SLDPRT
42.0 x 10.0 x 12.0 mm
