Creality3DPrinting/Ender-3/Ender-3 Mechanical/STP/Sheetmetal enclosure top.step

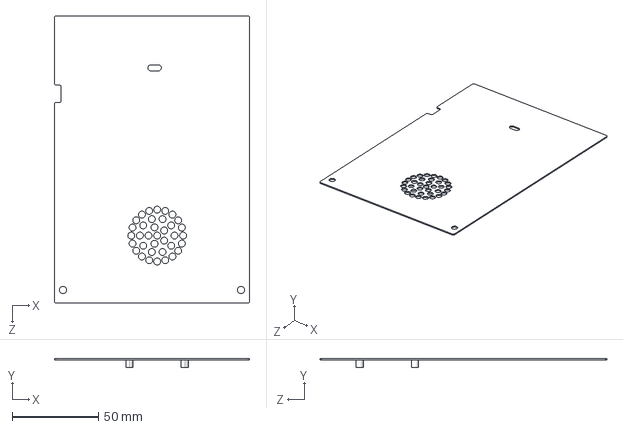
[picture p58: CAD file, 2018-06-30]
Ender-3 Mechanical/STP/Sheetmetal enclosure top.step
113.0 x 5.00 x 166.0 mm
