Creality3DPrinting/Ender-3/Ender-3 Mechanical/STP/Case fan.step

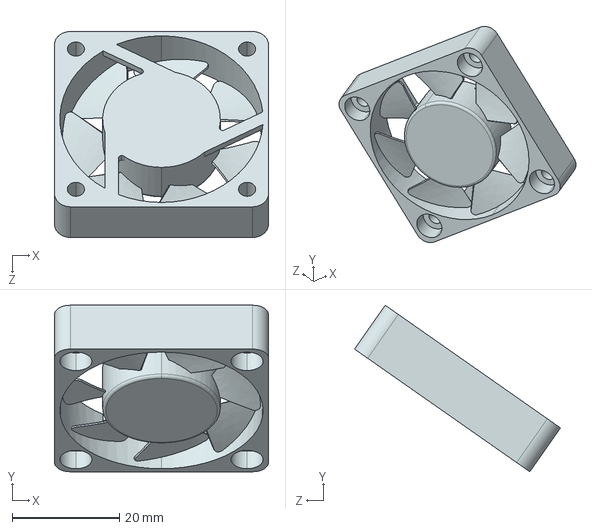
[picture p59: CAD file, 2018-06-30]
Ender-3 Mechanical/STP/Case fan.step
40.0 x 31.1 x 38.5 mm
