Creality3DPrinting/Ender-3/Ender-3 Mechanical/STP/2040 profile.step

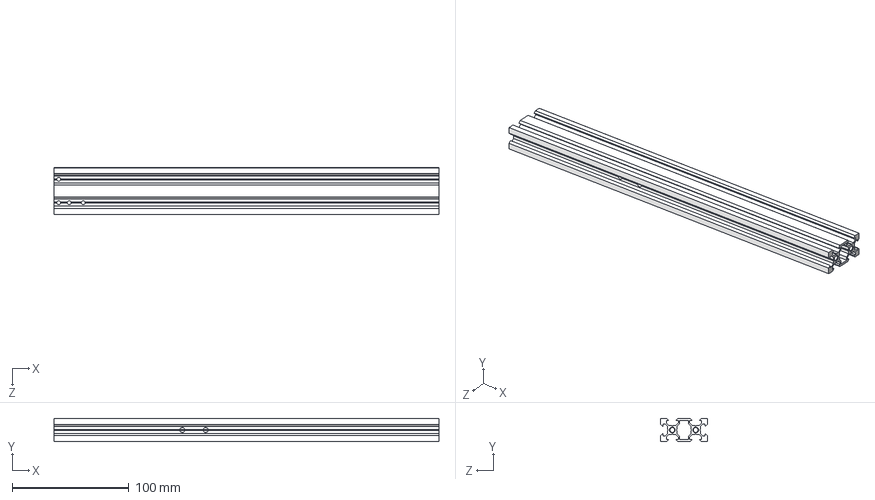
[picture p60: CAD file, 2018-06-30]
Ender-3 Mechanical/STP/2040 profile.step
330.0 x 20.0 x 40.0 mm
