Creality3DPrinting/Ender-3/Ender-3 Mechanical/Ender-3 Parts/Hot bed.SLDPRT

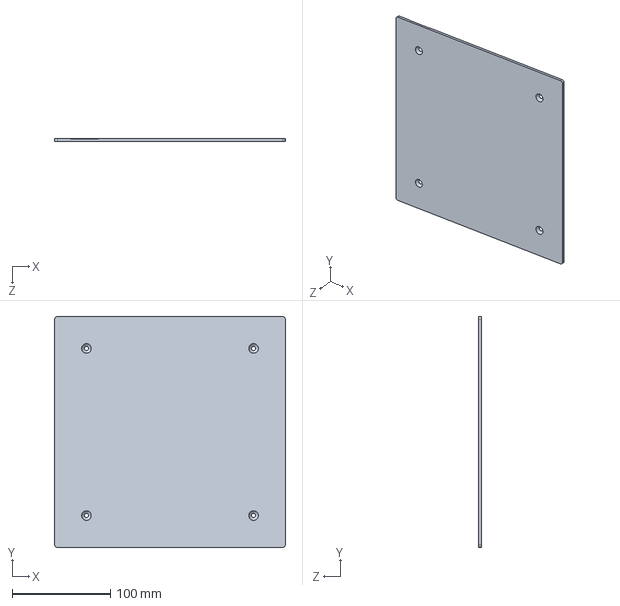
[picture p61: CAD file, 2018-09-13]
Ender-3 Mechanical/Ender-3 Parts/Hot bed.SLDPRT
235.0 x 235.0 x 3.00 mm
