Creality3DPrinting/Ender-3/Ender-3 Mechanical/Ender-3 Parts/Eccentric column.SLDPRT

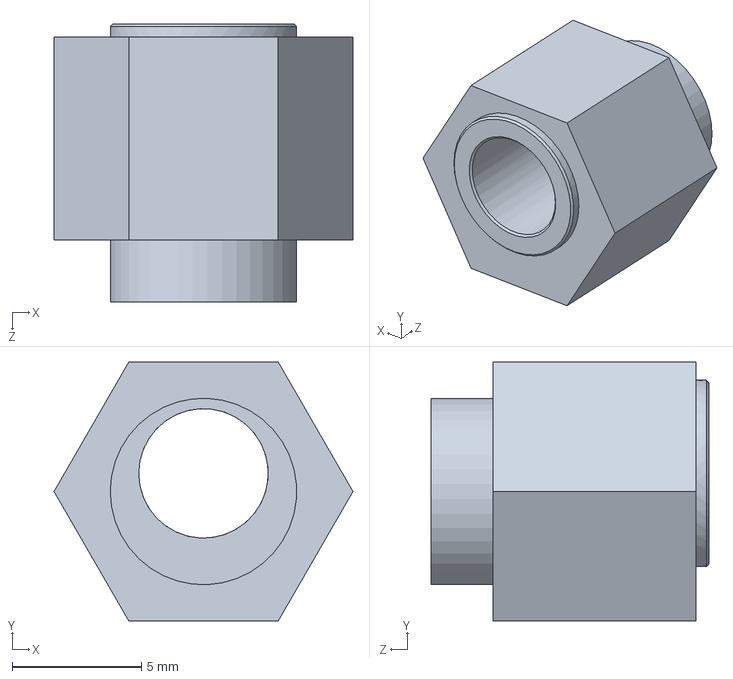
[picture p62: CAD file, 2018-09-13]
Ender-3 Mechanical/Ender-3 Parts/Eccentric column.SLDPRT
11.5 x 10.0 x 10.8 mm
