Creality3DPrinting/Ender-3/Ender-3 Mechanical/STP/Nozzle fan duct.step

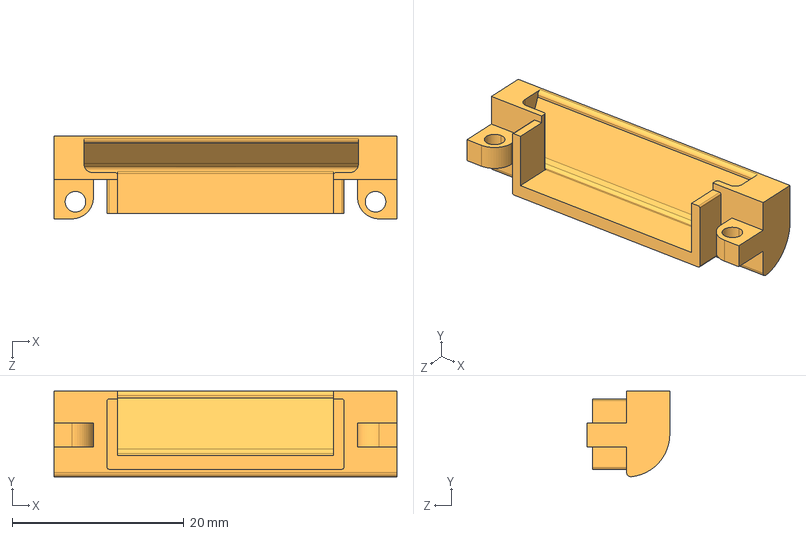
[picture p63: CAD file, 2018-06-30]
Ender-3 Mechanical/STP/Nozzle fan duct.step
40.0 x 9.98 x 9.65 mm
