Creality3DPrinting/Ender-3/Ender-3 Mechanical/STP/Control panel.step

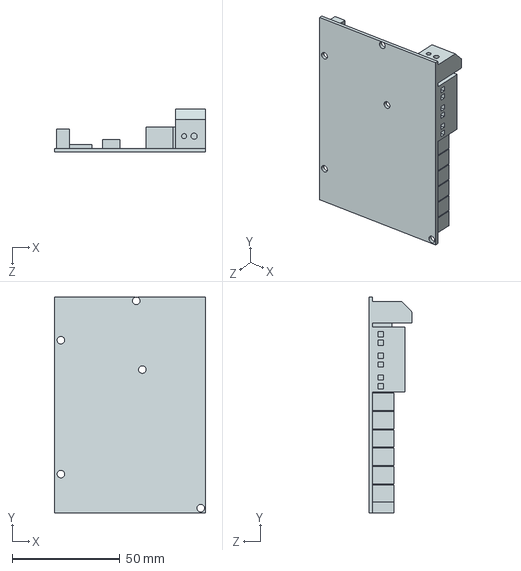
[picture p64: CAD file, 2018-06-30]
Ender-3 Mechanical/STP/Control panel.step
70.0 x 100.0 x 20.0 mm
