Creality3DPrinting/Ender-3/Ender-3 Mechanical/Ender-3 Parts/nozzle.SLDPRT

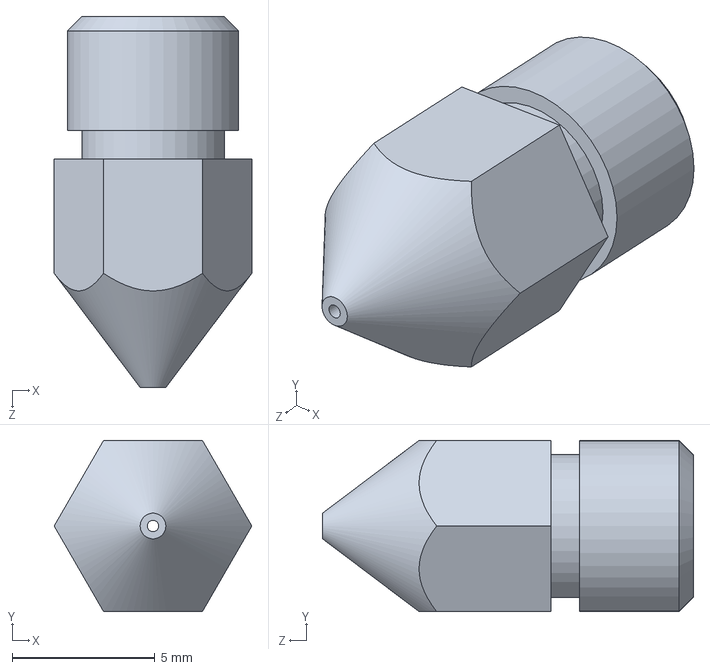
[picture p65: CAD file, 2018-09-13]
Ender-3 Mechanical/Ender-3 Parts/nozzle.SLDPRT
6.93 x 6.00 x 13.0 mm
