Creality3DPrinting/Ender-3/Ender-3 Mechanical/STP/Support tube.step

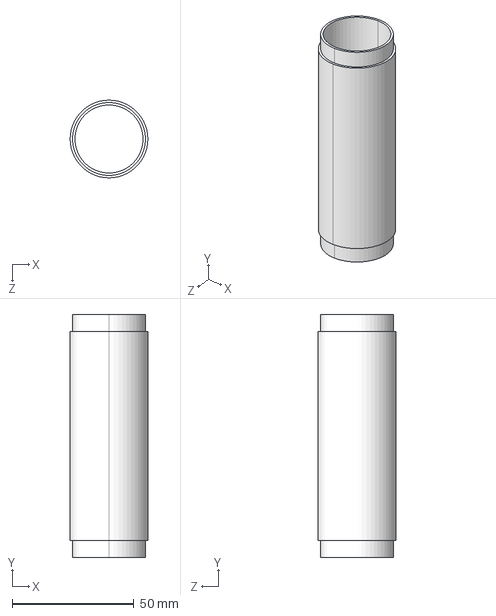
[picture p66: CAD file, 2018-06-30]
Ender-3 Mechanical/STP/Support tube.step
32.0 x 100.0 x 32.0 mm
