Creality3DPrinting/Ender-3/Ender-3 Mechanical/STP/Spacers for rollers.step

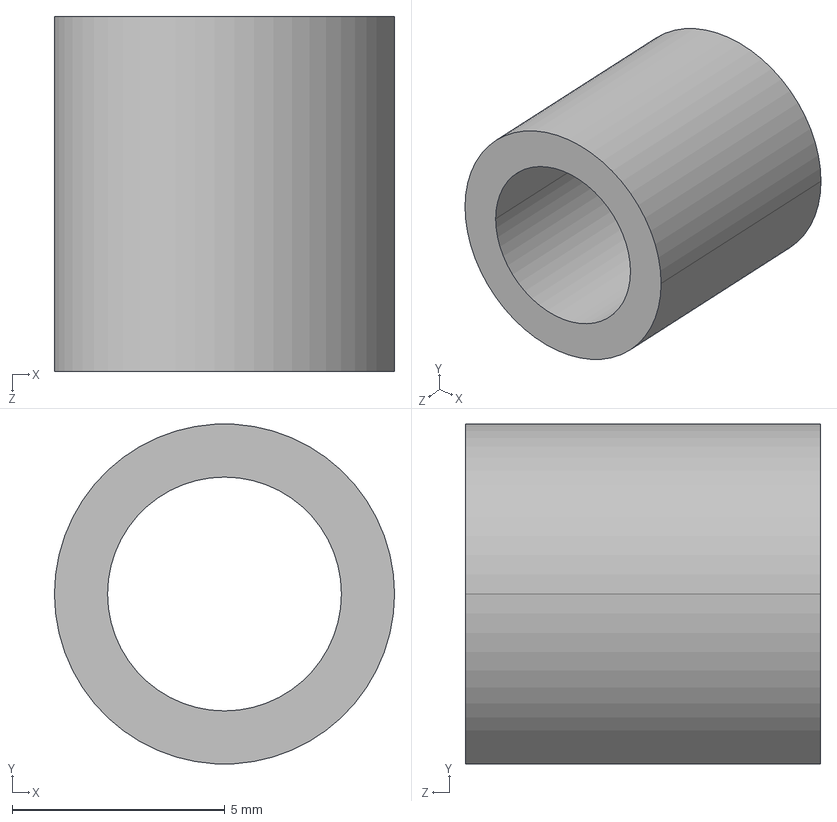
[picture p67: CAD file, 2018-06-30]
Ender-3 Mechanical/STP/Spacers for rollers.step
8.00 x 7.99 x 8.35 mm
