Creality3DPrinting/Ender-3/Ender-3 Mechanical/Ender-3 Parts/E plate.SLDPRT

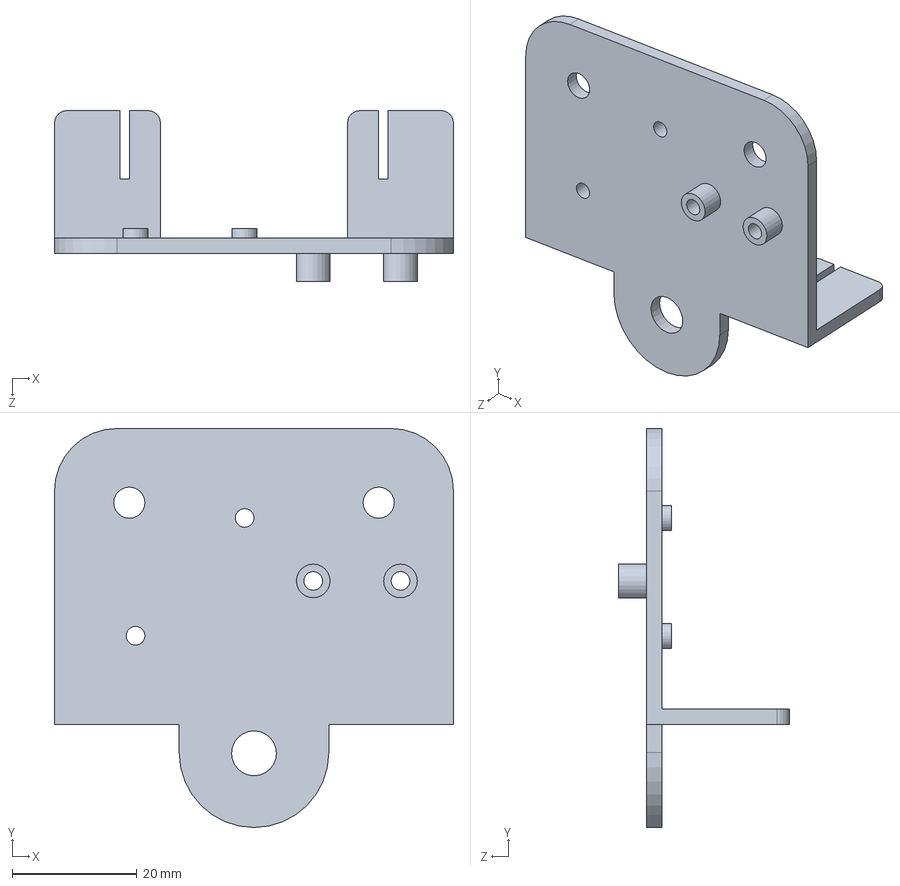
[picture p68: CAD file, 2018-09-13]
Ender-3 Mechanical/Ender-3 Parts/E plate.SLDPRT
64.0 x 64.0 x 27.4 mm
