Creality3DPrinting/Ender-3/Ender-3 Mechanical/STP/24V15A power supply.step

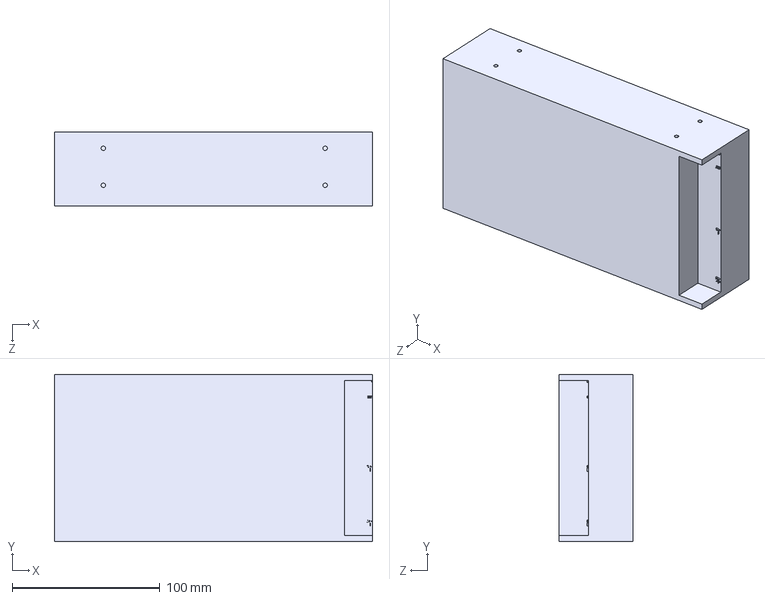
[picture p69: CAD file, 2018-06-30]
Ender-3 Mechanical/STP/24V15A power supply.step
215.0 x 113.0 x 50.0 mm
