Creality3DPrinting/Ender-3/Ender-3 Mechanical/Ender-3 Parts/Z coupler.SLDPRT

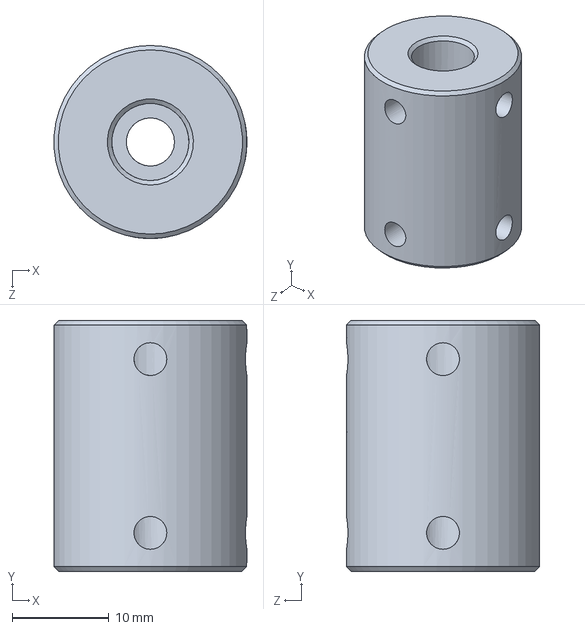
[picture p70: CAD file, 2018-09-13]
Ender-3 Mechanical/Ender-3 Parts/Z coupler.SLDPRT
20.0 x 26.0 x 20.0 mm
