Creality3DPrinting/Ender-3/Ender-3 Mechanical/STP/Y limit switch bracket.step

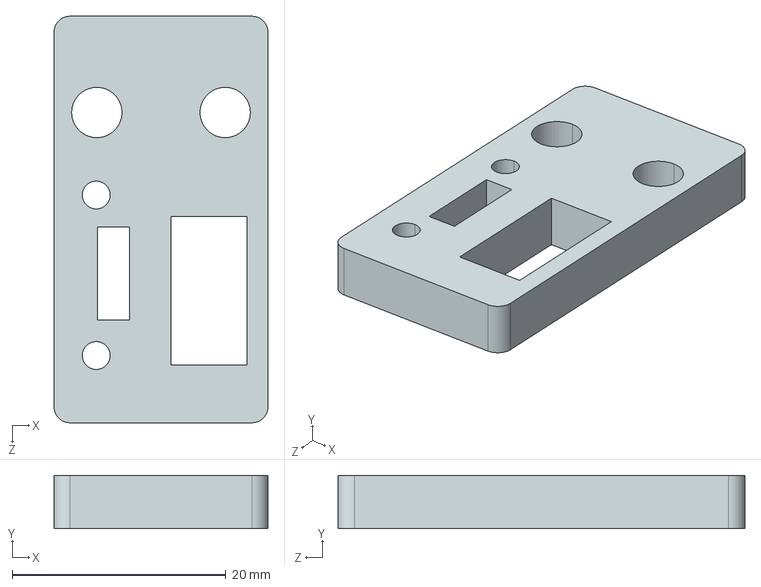
[picture p71: CAD file, 2018-06-30]
Ender-3 Mechanical/STP/Y limit switch bracket.step
20.0 x 5.00 x 38.0 mm
