Creality3DPrinting/Ender-3/Ender-3 Mechanical/STP/LCD support.step

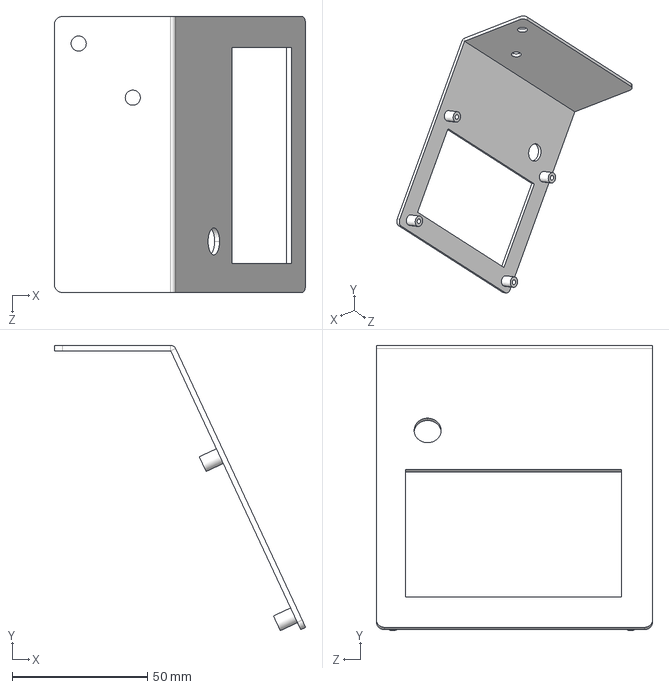
[picture p72: CAD file, 2018-06-30]
Ender-3 Mechanical/STP/LCD support.step
92.9 x 105.4 x 102.0 mm
