Creality3DPrinting/Ender-3/Ender-3 Mechanical/STP/40-42 motor.step

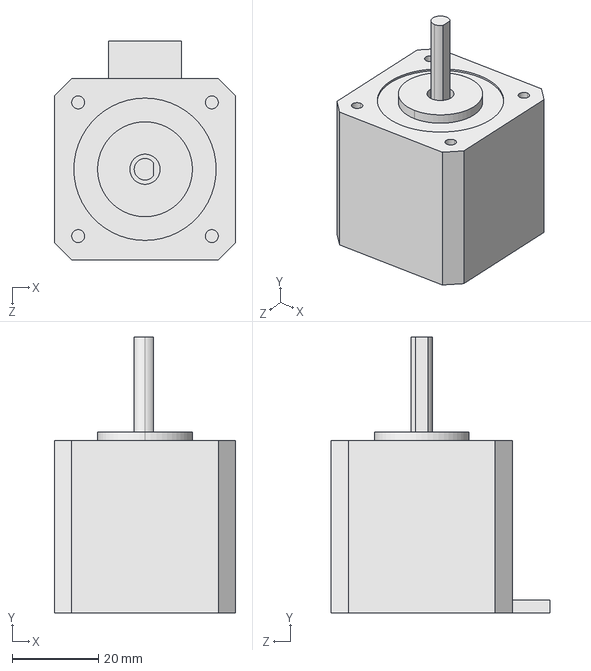
[picture p73: CAD file, 2018-06-30]
Ender-3 Mechanical/STP/40-42 motor.step
42.0 x 64.0 x 50.7 mm
