Creality3DPrinting/Ender-3/Ender-3 Mechanical/Ender-3 Parts/Y Motor holder.SLDPRT

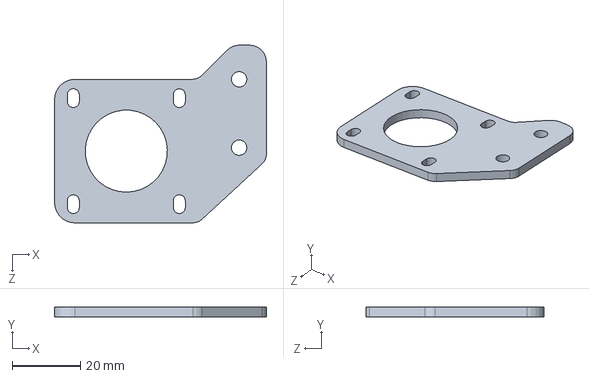
[picture p74: CAD file, 2018-09-13]
Ender-3 Mechanical/Ender-3 Parts/Y Motor holder.SLDPRT
62.0 x 3.00 x 52.0 mm
