Creality3DPrinting/Ender-3/Ender-3 Mechanical/Ender-3 Parts/M6 Pneumatic joint.SLDPRT

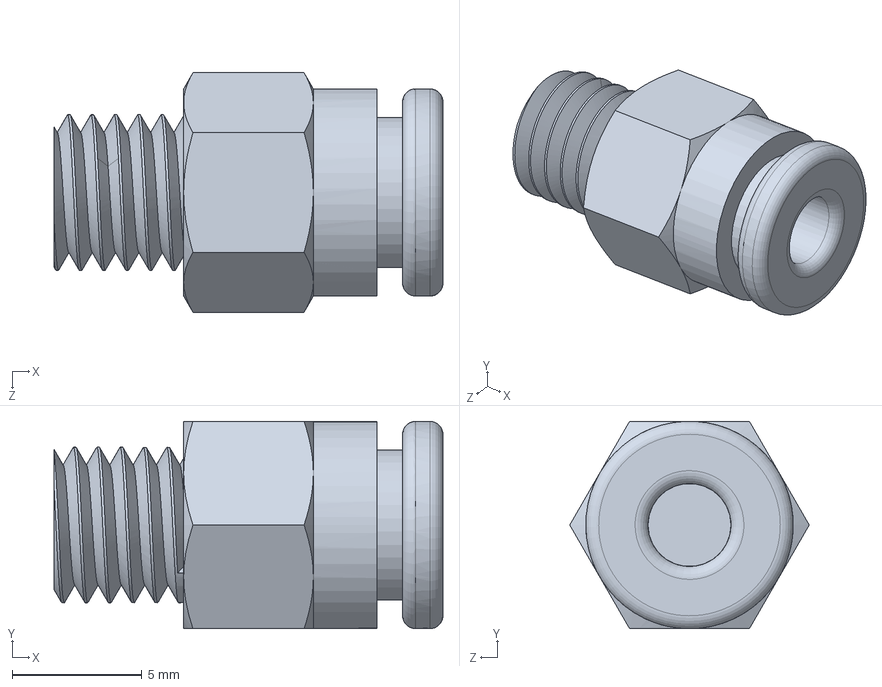
[picture p75: CAD file, 2018-09-13]
Ender-3 Mechanical/Ender-3 Parts/M6 Pneumatic joint.SLDPRT
15.0 x 8.00 x 9.24 mm
