Creality3DPrinting/Ender-3/Ender-3 Mechanical/STP/Power holder.step

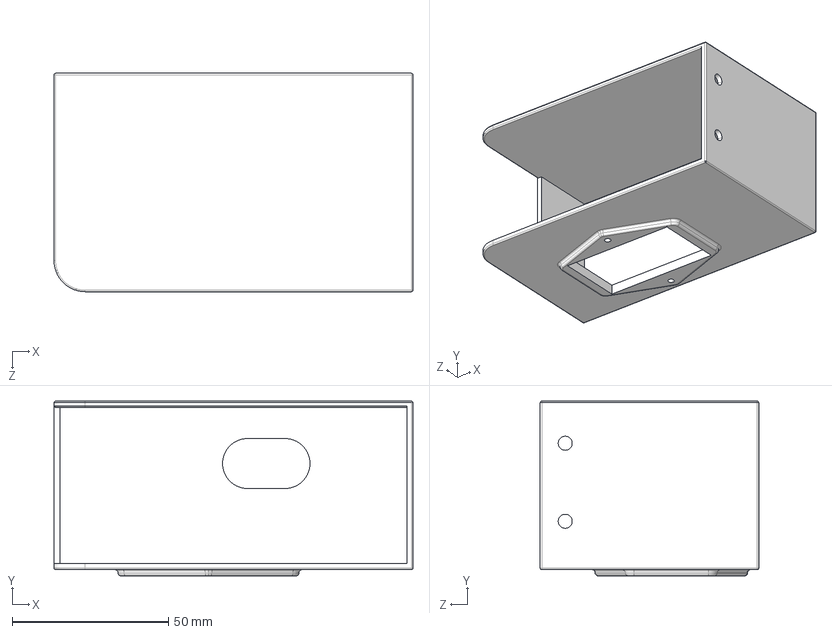
[picture p76: CAD file, 2018-06-30]
Ender-3 Mechanical/STP/Power holder.step
115.0 x 56.0 x 70.0 mm
