Creality3DPrinting/Ender-3/Ender-3 Mechanical/Ender-3 Parts/E idler tensioner.SLDPRT

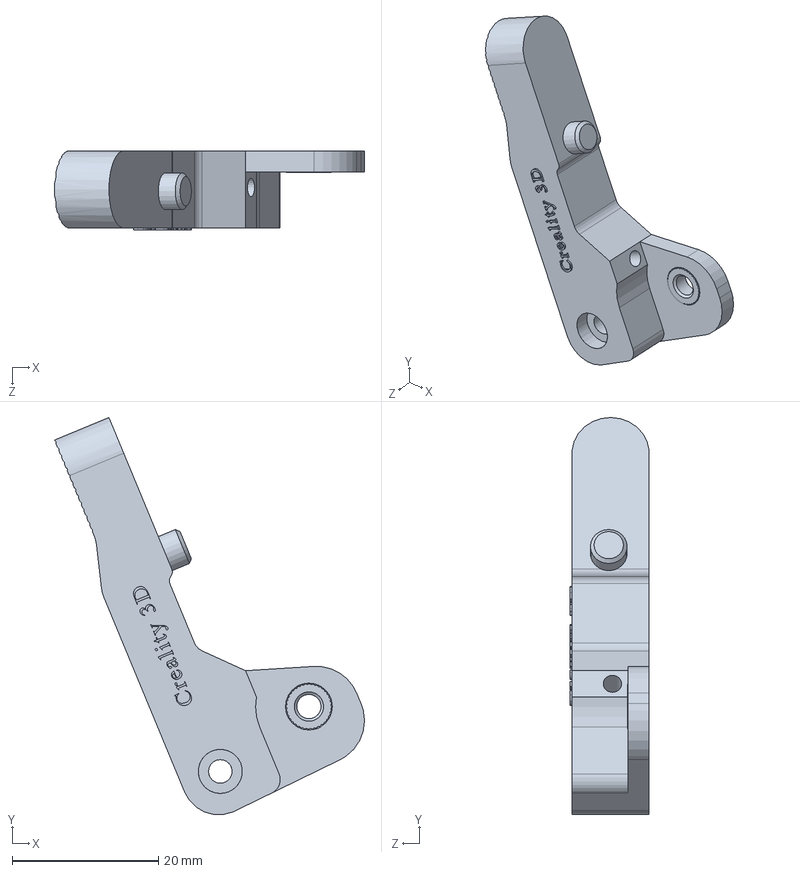
[picture p77: CAD file, 2018-09-13]
Ender-3 Mechanical/Ender-3 Parts/E idler tensioner.SLDPRT
42.4 x 54.2 x 10.9 mm
