Creality3DPrinting/Ender-3/Ender-3 Mechanical/STP/E gear.step

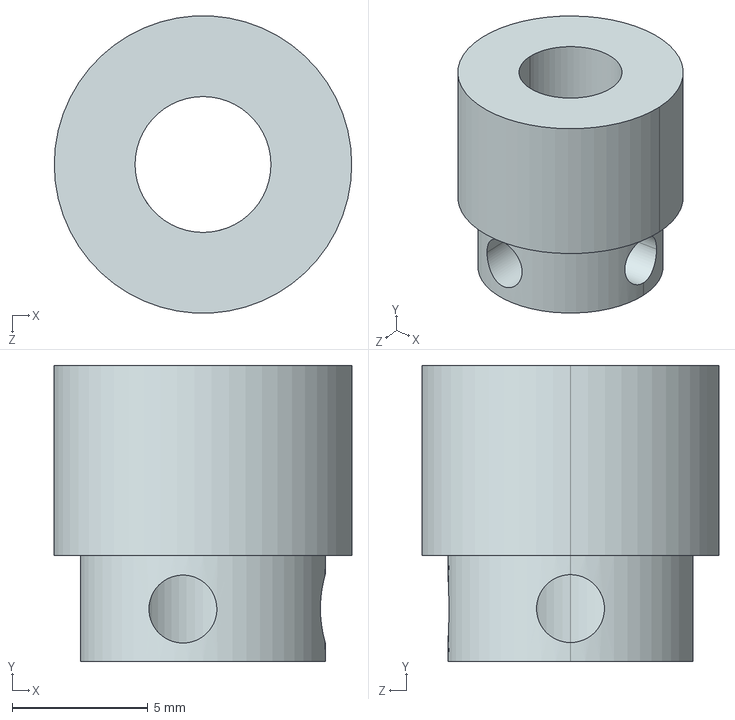
[picture p78: CAD file, 2018-06-30]
Ender-3 Mechanical/STP/E gear.step
11.0 x 10.9 x 10.9 mm
