Creality3DPrinting/Ender-3/Ender-3 Mechanical/Ender-3 Parts/Rollers.SLDPRT

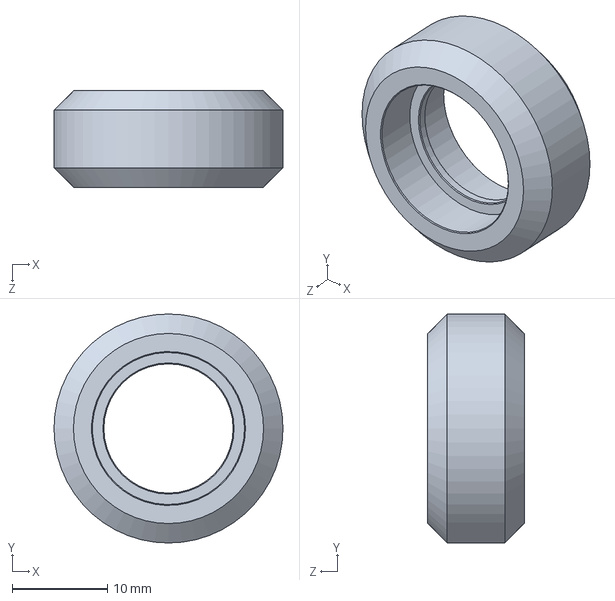
[picture p79: CAD file, 2018-09-13]
Ender-3 Mechanical/Ender-3 Parts/Rollers.SLDPRT
24.1 x 24.1 x 10.2 mm
