Creality3DPrinting/Ender-3/Ender-3 Mechanical/Ender-3 Parts/power switch.SLDPRT

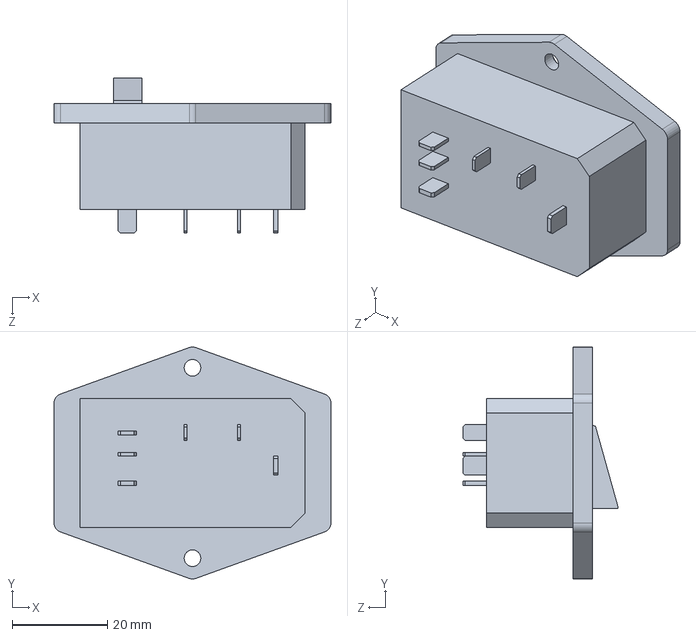
[picture p80: CAD file, 2018-09-13]
Ender-3 Mechanical/Ender-3 Parts/power switch.SLDPRT
58.2 x 48.7 x 32.7 mm
