Creality3DPrinting/Ender-3/Ender-3 Mechanical/Ender-3 Parts/42-34 motor.SLDPRT

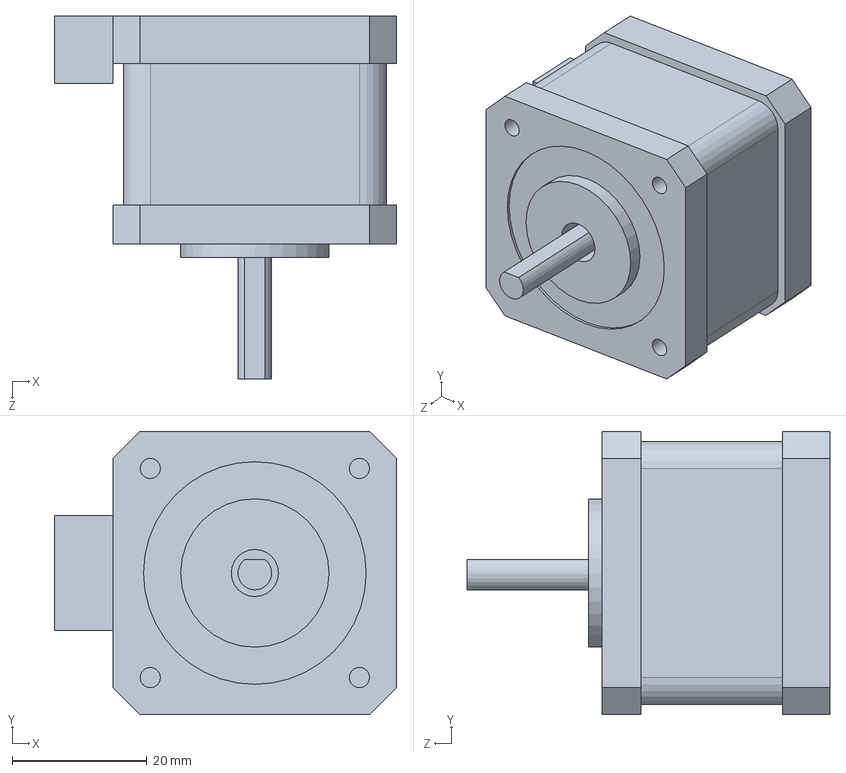
[picture p81: CAD file, 2018-09-13]
Ender-3 Mechanical/Ender-3 Parts/42-34 motor.SLDPRT
50.7 x 42.0 x 53.8 mm
