Creality3DPrinting/Ender-3/Ender-3 Mechanical/STP/D4 Teflon tube.step

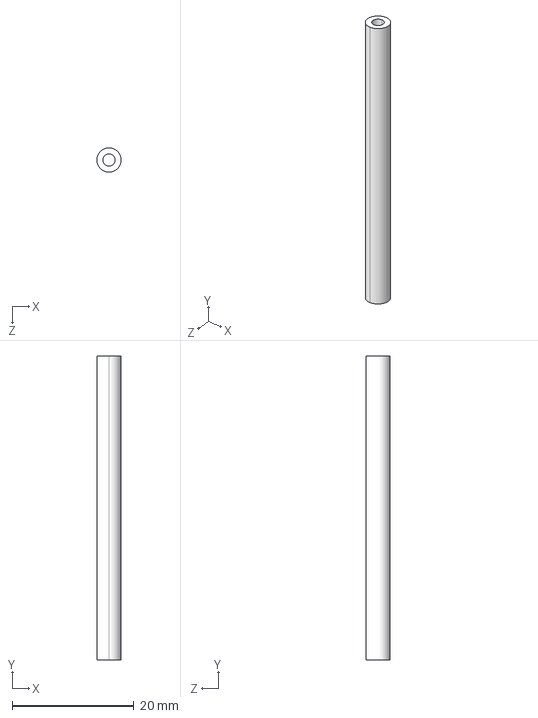
[picture p82: CAD file, 2018-06-30]
Ender-3 Mechanical/STP/D4 Teflon tube.step
4.00 x 50.0 x 4.00 mm
