Creality3DPrinting/Ender-3/Ender-3 Mechanical/STP/624U pillow.step

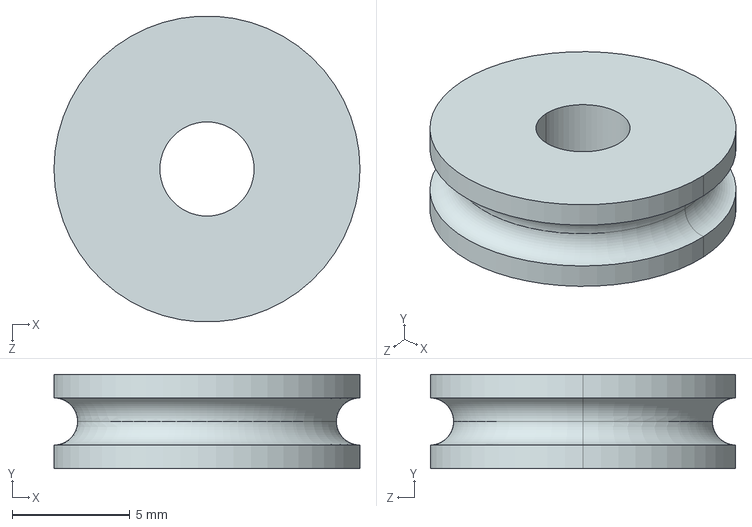
[picture p83: CAD file, 2018-06-30]
Ender-3 Mechanical/STP/624U pillow.step
13.0 x 4.00 x 13.0 mm
