Creality3DPrinting/Ender-3/Ender-3 Mechanical/STP/2020 profile.step

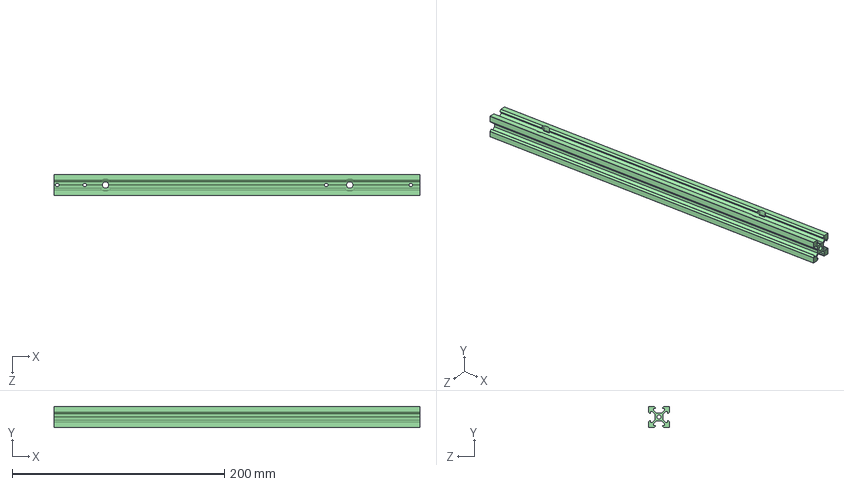
[picture p84: CAD file, 2018-06-30]
Ender-3 Mechanical/STP/2020 profile.step
345.0 x 20.0 x 20.0 mm
