Creality3DPrinting/Ender-3/Ender-3 Mechanical/STP/X limit switch bracket.step

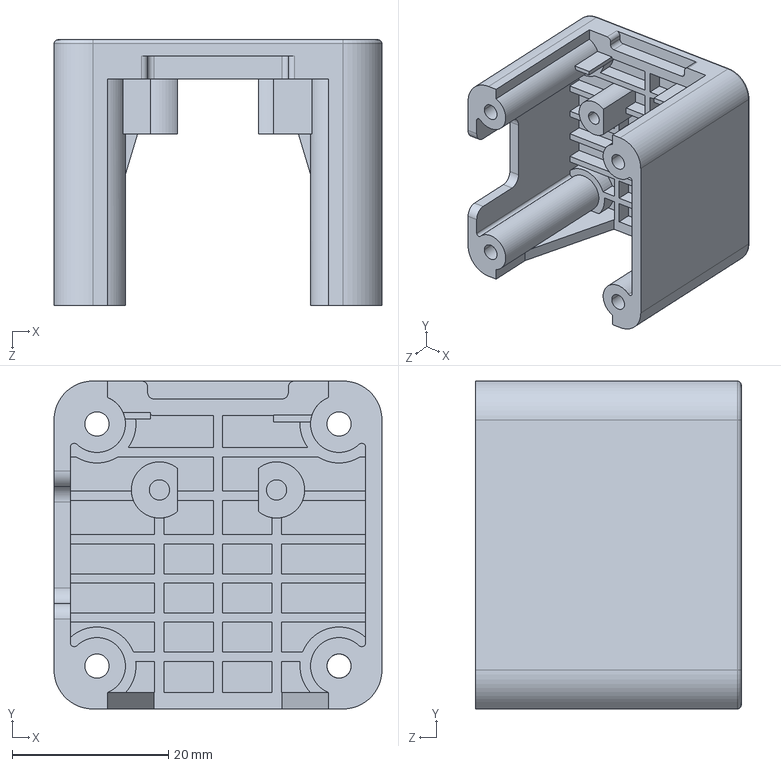
[picture p85: CAD file, 2018-06-30]
Ender-3 Mechanical/STP/X limit switch bracket.step
42.0 x 42.0 x 34.0 mm
