Creality3DPrinting/Ender-3/Ender-3 Mechanical/STP/limit switch.step

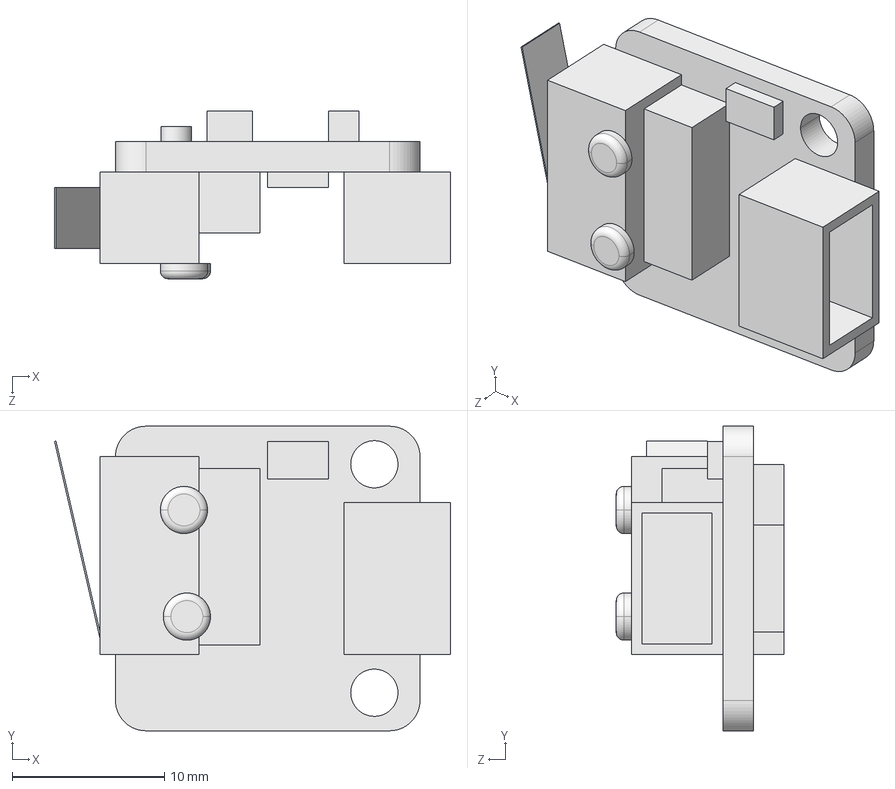
[picture p86: CAD file, 2018-06-30]
Ender-3 Mechanical/STP/limit switch.step
26.0 x 20.0 x 11.0 mm
