Creality3DPrinting/Ender-3/Ender-3 Mechanical/STP/E motor bracket.step

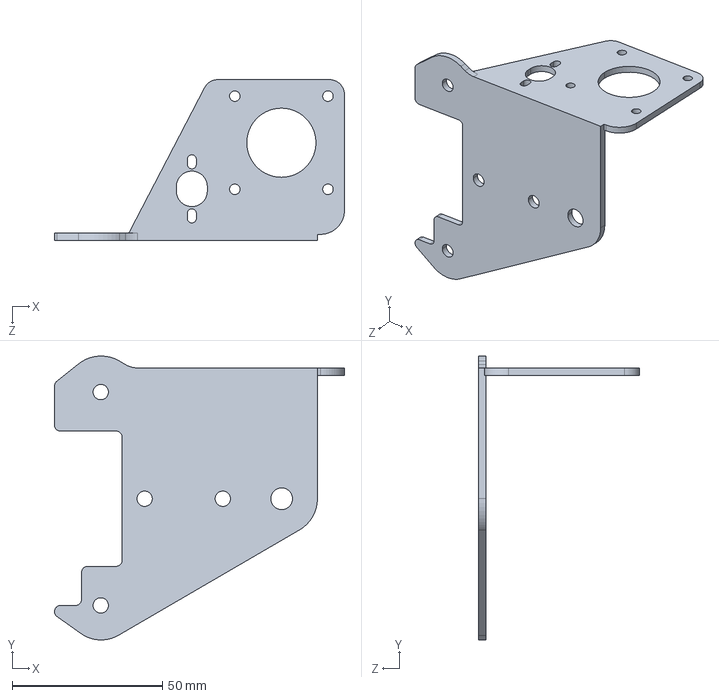
[picture p87: CAD file, 2018-06-30]
Ender-3 Mechanical/STP/E motor bracket.step
96.5 x 94.5 x 53.5 mm
