Creality3DPrinting/Ender-3/Ender-3 Mechanical/STP/F688 pillow.step

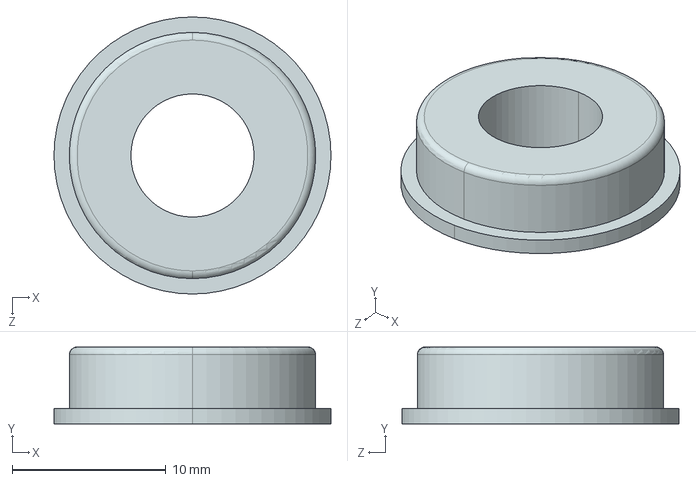
[picture p88: CAD file, 2018-06-30]
Ender-3 Mechanical/STP/F688 pillow.step
18.0 x 5.00 x 18.0 mm
