Creality3DPrinting/Ender-3/Ender-3 Mechanical/Ender-3 Parts/E gear.SLDPRT

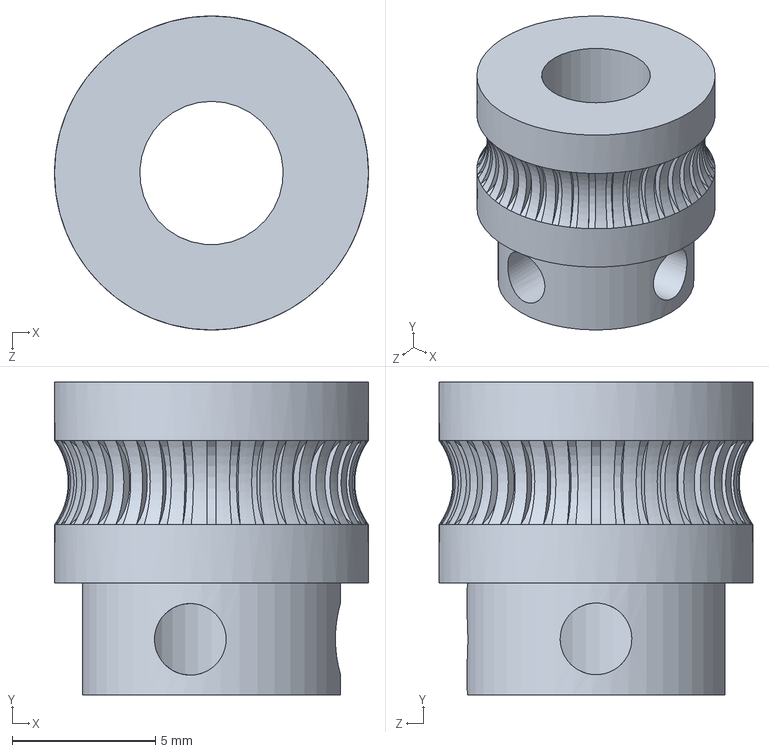
[picture p89: CAD file, 2018-09-13]
Ender-3 Mechanical/Ender-3 Parts/E gear.SLDPRT
11.0 x 10.9 x 10.9 mm
