Creality3DPrinting/Ender-3/Ender-3 Mechanical/STP/4040 profile.step

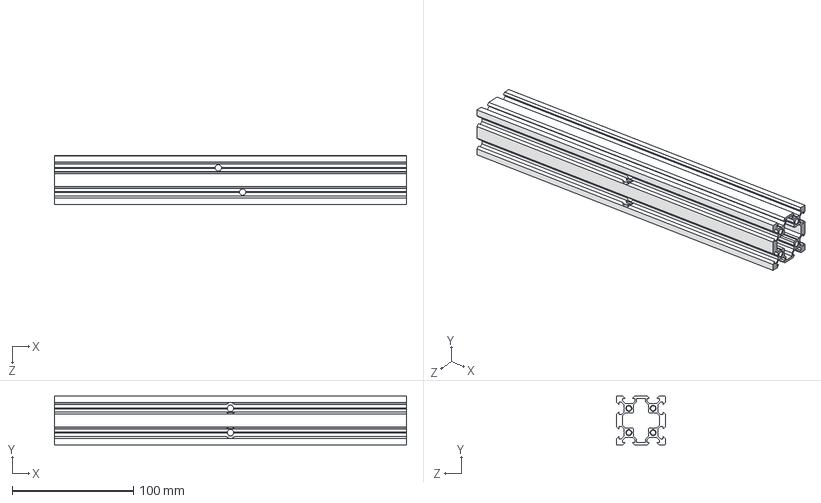
[picture p90: CAD file, 2018-06-30]
Ender-3 Mechanical/STP/4040 profile.step
290.0 x 40.0 x 40.0 mm
