Creality3DPrinting/Ender-3/Ender-3 Mechanical/STP/Support frame.step

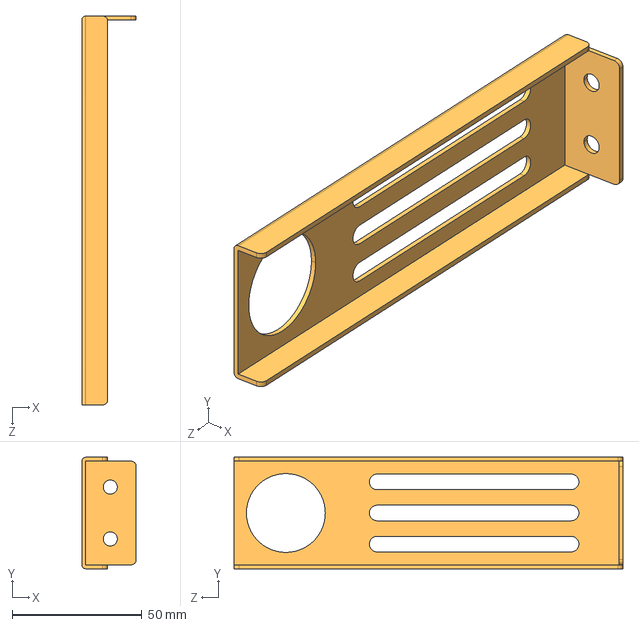
[picture p91: CAD file, 2018-06-30]
Ender-3 Mechanical/STP/Support frame.step
21.0 x 43.0 x 150.0 mm
