Creality3DPrinting/Ender-3/Ender-3 Mechanical/Ender-3 Parts/Hotbed_Surface.SLDPRT

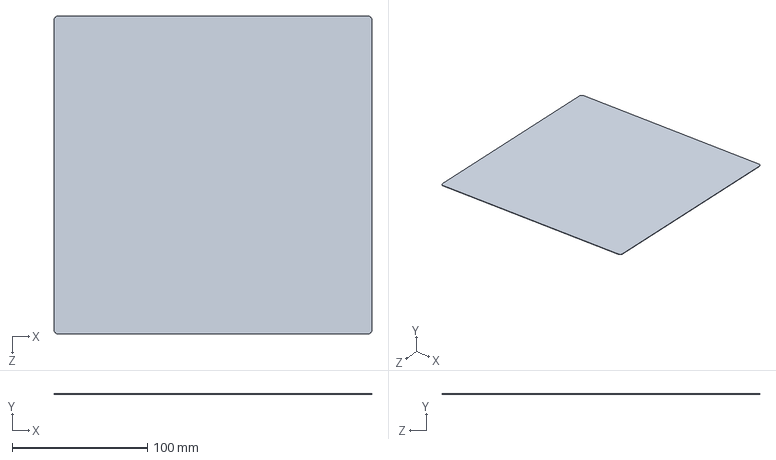
[picture p92: CAD file, 2018-09-13]
Ender-3 Mechanical/Ender-3 Parts/Hotbed_Surface.SLDPRT
235.0 x 0.5 x 235.0 mm
