Creality3DPrinting/Ender-3/Ender-3 Mechanical/STP/4040 Endcap.step

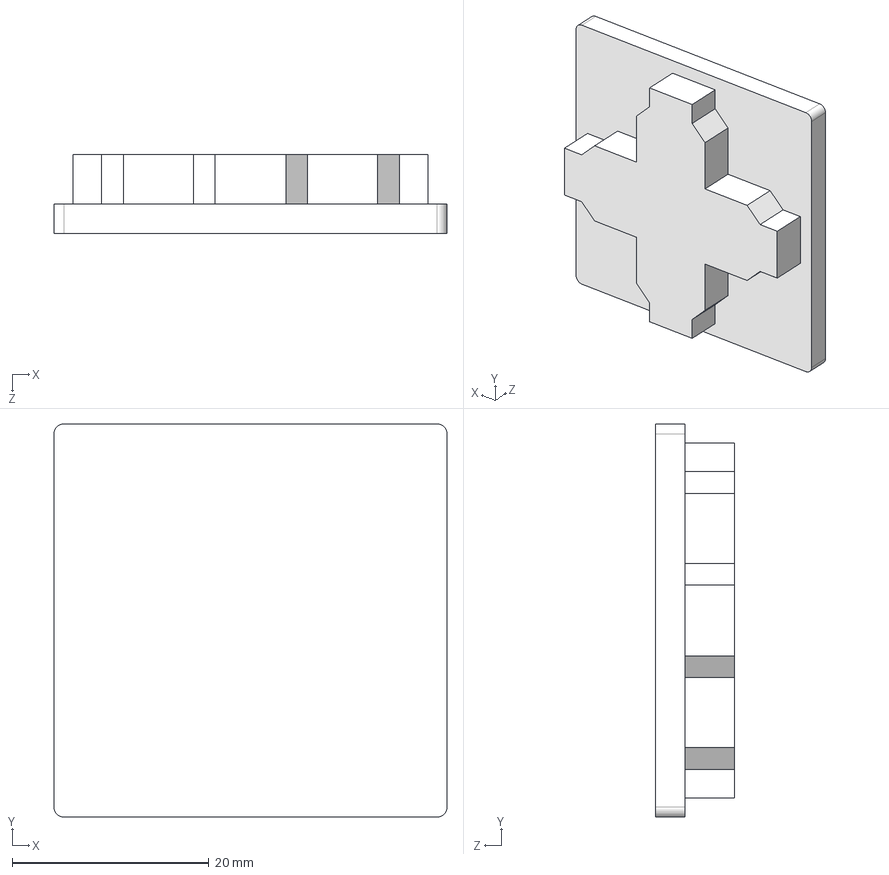
[picture p93: CAD file, 2018-06-30]
Ender-3 Mechanical/STP/4040 Endcap.step
40.0 x 40.0 x 8.00 mm
