Creality3DPrinting/Ender-3/Ender-3 Mechanical/STP/lcd Knob.step

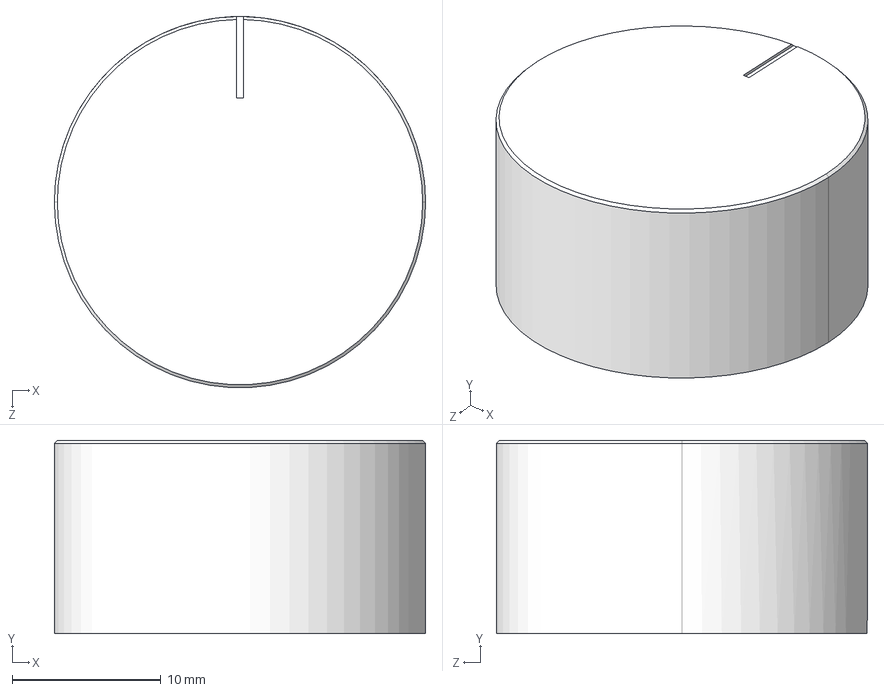
[picture p94: CAD file, 2018-06-30]
Ender-3 Mechanical/STP/lcd Knob.step
25.0 x 13.0 x 25.0 mm
