Creality3DPrinting/Ender-3/Ender-3 Mechanical/STP/Catheter.step

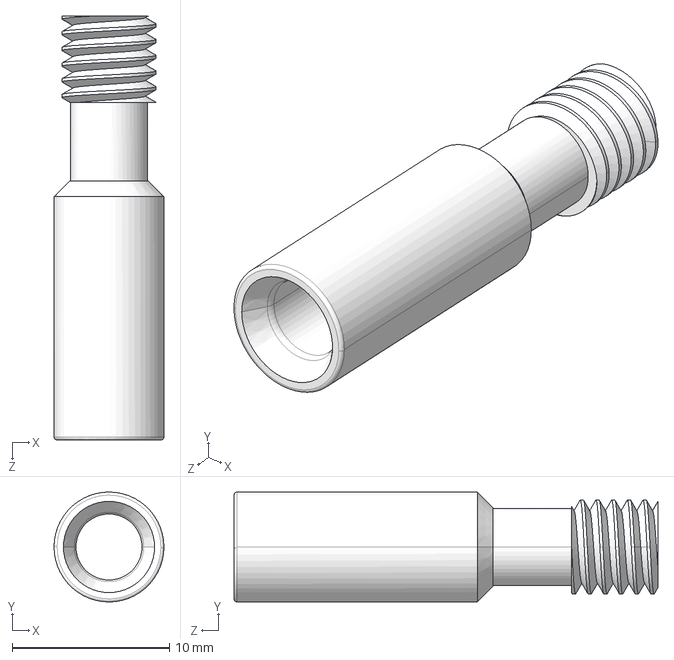
[picture p95: CAD file, 2018-06-30]
Ender-3 Mechanical/STP/Catheter.step
7.00 x 7.00 x 27.0 mm
