Creality3DPrinting/Ender-3/Ender-3 Mechanical/Ender-3 Parts/Fan cover.SLDPRT

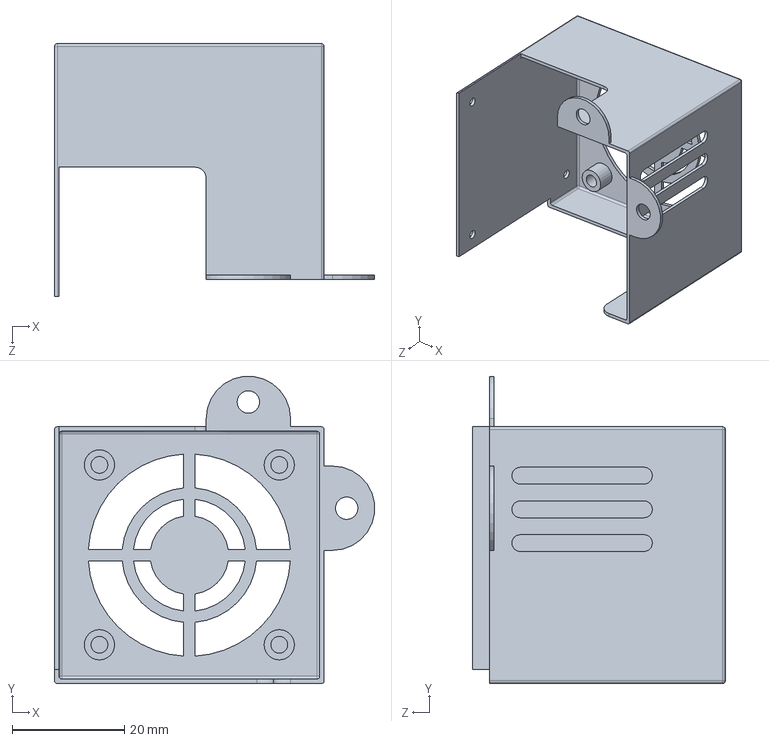
[picture p96: CAD file, 2018-09-13]
Ender-3 Mechanical/Ender-3 Parts/Fan cover.SLDPRT
56.9 x 54.6 x 45.0 mm
