Creality3DPrinting/Ender-3/(list of files, cad)

Other CAD files:
Ender-3 Mechanical/Ender-3 Parts/ASM Roller X-Axis.SLDASM
Ender-3 Mechanical/Ender-3 Parts/ASM Roller Z-Axis Right.SLDASM
Ender-3 Mechanical/Ender-3 Parts/ASM Eccentrical Roller X-Axis.SLDASM
Ender-3 Mechanical/Ender-3 Parts/pulley mount.SLDASM
Ender-3 Mechanical/DWG/2040 profile_3.dwg
Ender-3 Mechanical/DWG/2040 profile_2.dwg
Ender-3 Mechanical/DWG/2020 profile_2.dwg
Ender-3 Mechanical/DWG/2040 profile_1.dwg
Ender-3 Mechanical/DWG/2020 profile_1.dwg
Ender-3 Mechanical/DWG/4040 profile_3.dwg
Ender-3 Mechanical/DWG/4040 profile_1.dwg
Ender-3 Mechanical/DWG/4040 profile_2.dwg
Ender-3 Mechanical/STP/Heater.step
Ender-3 Mechanical/STP/Y Adjustment Block.step
Ender-3 Mechanical/STP/Hot bed.step
Ender-3 Mechanical/Ender-3 Parts/Z limit switch bracket.SLDPRT
Ender-3 Mechanical/Ender-3 Parts/Nozzle fan duct.SLDPRT
Ender-3 Mechanical/STP/X Adjustment Block.step
Ender-3 Mechanical/Ender-3 Parts/Spacers for rollers.SLDPRT
Ender-3 Mechanical/Ender-3 Parts/2040-3L profile.SLDPRT
Ender-3 Mechanical/STP/Nozzle fan.step
Ender-3 Mechanical/STP/E plate.step
Ender-3 Mechanical/Ender-3 Parts/X belt.SLDPRT
Ender-3 Mechanical/STP/2GT-pulley.step
Ender-3 Mechanical/Ender-3 Parts/Z Stent.SLDPRT
Ender-3 Mechanical/STP/lcd.step
Ender-3 Mechanical/STP/Y plate.step
Ender-3 Mechanical/Ender-3 Parts/Control panel.SLDPRT
Ender-3 Mechanical/STP/power switch.step
Ender-3 Mechanical/Ender-3 Parts/Power holder.SLDPRT
Ender-3 Mechanical/STP/Eccentric column.step
Ender-3 Mechanical/Ender-3 Parts/Case fan.SLDPRT
Ender-3 Mechanical/STP/nozzle.step
Ender-3 Mechanical/Ender-3 Parts/X limit switch bracket.SLDPRT
Ender-3 Mechanical/Ender-3 Parts/Nozzle fan.SLDPRT
Ender-3 Mechanical/STP/Y belt.step
Ender-3 Mechanical/STP/Z coupler.step
Ender-3 Mechanical/Ender-3 Parts/LCD support.SLDPRT
Ender-3 Mechanical/Ender-3 Parts/Y limit switch bracket.SLDPRT
Ender-3 Mechanical/Ender-3 Parts/Extrusion Spring.SLDPRT
Ender-3 Mechanical/STP/X motor bracket.step
Ender-3 Mechanical/Ender-3 Parts/625pillow.SLDPRT
Ender-3 Mechanical/Ender-3 Parts/Heat block.SLDPRT
Ender-3 Mechanical/STP/Y Motor holder.step
Ender-3 Mechanical/STP/Bed level springs.step
Ender-3 Mechanical/STP/Z motor bracket.step
Ender-3 Mechanical/STP/Extrusion Spring.step
Ender-3 Mechanical/Ender-3 Parts/F688 pillow.SLDPRT
Ender-3 Mechanical/Ender-3 Parts/Sheetmetal enclosure top.SLDPRT
Ender-3 Mechanical/Ender-3 Parts/42-40 motor.SLDPRT
Ender-3 Mechanical/Ender-3 Parts/Nozzle thermistor.SLDPRT
Ender-3 Mechanical/Ender-3 Parts/2020 profile.SLDPRT
Ender-3 Mechanical/DWG/2020 Endcap.dwg
Ender-3 Mechanical/DWG/Catheter.dwg
Ender-3 Mechanical/DWG/E housing.dwg
Ender-3 Mechanical/DWG/E idler tensioner.dwg
Ender-3 Mechanical/DWG/E motor bracket.dwg
Ender-3 Mechanical/DWG/E plate.dwg
Ender-3 Mechanical/DWG/Eccentric column.dwg
Ender-3 Mechanical/DWG/Fan cover.dwg
Ender-3 Mechanical/DWG/Hand Twisted Nut.dwg
Ender-3 Mechanical/DWG/Heat block.dwg
Ender-3 Mechanical/DWG/LCD support.dwg
Ender-3 Mechanical/DWG/M30 Plastic nut.dwg
Ender-3 Mechanical/DWG/Nozzle fan duct.dwg
Ender-3 Mechanical/DWG/Power holder.dwg
Ender-3 Mechanical/DWG/Radiator.dwg
Ender-3 Mechanical/DWG/Rollers.dwg
Ender-3 Mechanical/DWG/Sheetmetal enclosure bottom.dwg
Ender-3 Mechanical/DWG/Sheetmetal enclosure top.dwg
Ender-3 Mechanical/DWG/Spacers for rollers.dwg
Ender-3 Mechanical/DWG/Support frame.dwg
Ender-3 Mechanical/DWG/Support tube.dwg
Ender-3 Mechanical/DWG/X Adjustment Block.dwg
Ender-3 Mechanical/DWG/X motor bracket.dwg
Ender-3 Mechanical/DWG/Y Adjustment Block.dwg
Ender-3 Mechanical/DWG/Y Motor holder.dwg
Ender-3 Mechanical/DWG/Y limit switch bracket.dwg
Ender-3 Mechanical/DWG/Y plate.dwg
Ender-3 Mechanical/DWG/Z Stent.dwg
Ender-3 Mechanical/DWG/Z limit switch bracket.dwg
Ender-3 Mechanical/DWG/Z motor bracket.dwg
Ender-3 Mechanical/DWG/Z threaded rod.dwg
Ender-3 Mechanical/DWG/lcd Knob.dwg
Ender-3 Mechanical/DWG/nozzle.dwg
Ender-3 Mechanical/DWG/power switch.dwg
Ender-3 Mechanical/DWG/z nut.dwg
Ender-3 Mechanical/Ender-3 Parts/2020 Endcap.SLDDRW
Ender-3 Mechanical/Ender-3 Parts/2020 profile.SLDDRW
Ender-3 Mechanical/Ender-3 Parts/2020-2 profile.SLDPRT
Ender-3 Mechanical/Ender-3 Parts/2040 profile.SLDDRW
Ender-3 Mechanical/Ender-3 Parts/2040 profile.SLDPRT
Ender-3 Mechanical/Ender-3 Parts/2040-2 profile.SLDPRT
Ender-3 Mechanical/Ender-3 Parts/24V15A power supply.SLDPRT
Ender-3 Mechanical/Ender-3 Parts/4040 Endcap.SLDPRT
Ender-3 Mechanical/Ender-3 Parts/4040 profile.SLDDRW
Ender-3 Mechanical/Ender-3 Parts/4040 profile.SLDPRT
Ender-3 Mechanical/Ender-3 Parts/4040-3 profile.SLDPRT
Ender-3 Mechanical/Ender-3 Parts/624U pillow.SLDPRT
Ender-3 Mechanical/Ender-3 Parts/ASM Roller Bolt.SLDASM
Ender-3 Mechanical/Ender-3 Parts/Catheter.SLDDRW
Ender-3 Mechanical/Ender-3 Parts/Catheter.SLDPRT
Ender-3 Mechanical/Ender-3 Parts/Cold section fan.SLDPRT
Ender-3 Mechanical/Ender-3 Parts/Copper cover.SLDPRT
Ender-3 Mechanical/Ender-3 Parts/D4 Teflon tube.SLDPRT
Ender-3 Mechanical/Ender-3 Parts/E housing.SLDDRW
Ender-3 Mechanical/Ender-3 Parts/E housing.SLDPRT
Ender-3 Mechanical/Ender-3 Parts/E idler tensioner.SLDDRW
Ender-3 Mechanical/Ender-3 Parts/E motor bracket.SLDDRW
Ender-3 Mechanical/Ender-3 Parts/E plate.SLDDRW
Ender-3 Mechanical/Ender-3 Parts/Eccentric column.SLDDRW
Ender-3 Mechanical/Ender-3 Parts/Fan cover.SLDDRW
Ender-3 Mechanical/Ender-3 Parts/Hand Twisted Nut.SLDDRW
Ender-3 Mechanical/Ender-3 Parts/Hand Twisted Nut.SLDPRT
Ender-3 Mechanical/Ender-3 Parts/Heat block.SLDDRW
Ender-3 Mechanical/Ender-3 Parts/LCD support.SLDDRW
Ender-3 Mechanical/Ender-3 Parts/M2X10杯头.SLDPRT
Ender-3 Mechanical/Ender-3 Parts/M2X8 Socket Head Screw.SLDPRT
Ender-3 Mechanical/Ender-3 Parts/M3 Screw.SLDPRT
Ender-3 Mechanical/Ender-3 Parts/M3 Split Washer.SLDPRT
Ender-3 Mechanical/Ender-3 Parts/M30 Plastic nut.SLDDRW
Ender-3 Mechanical/Ender-3 Parts/M30 Plastic nut.SLDPRT
Ender-3 Mechanical/Ender-3 Parts/M3X10 Flush Head Screw.SLDPRT
Ender-3 Mechanical/Ender-3 Parts/M3X10 Pan Head Screw.SLDPRT
Ender-3 Mechanical/Ender-3 Parts/M3X16 Pan Head Screw.SLDPRT
Ender-3 Mechanical/Ender-3 Parts/M3X18 Socket Head Screw.SLDPRT
Ender-3 Mechanical/Ender-3 Parts/M3X4 Screw .SLDPRT
Ender-3 Mechanical/Ender-3 Parts/M3X40-P.SLDPRT
Ender-3 Mechanical/Ender-3 Parts/M3X6Pan Head Screw.SLDPRT
Ender-3 Mechanical/Ender-3 Parts/M3X8 Pan Head Screw.SLDPRT
Ender-3 Mechanical/Ender-3 Parts/M3×18 Flush Head Screw.SLDPRT
Ender-3 Mechanical/Ender-3 Parts/M3×40 Flush Head Screw.SLDPRT
Ender-3 Mechanical/Ender-3 Parts/M4 Split Washer.SLDPRT
Ender-3 Mechanical/Ender-3 Parts/M4 T-Slot Nut.SLDPRT
Ender-3 Mechanical/Ender-3 Parts/M4X10 Socket Head Screw.SLDPRT
Ender-3 Mechanical/Ender-3 Parts/M4X16 Pan Head Screw.SLDPRT
Ender-3 Mechanical/Ender-3 Parts/M4X16 Screw.SLDPRT
Ender-3 Mechanical/Ender-3 Parts/M4X18 Flush Head Screw.SLDPRT
Ender-3 Mechanical/Ender-3 Parts/M4X20 Socket Head Screw.SLDPRT
Ender-3 Mechanical/Ender-3 Parts/M4X30 Flush Head Screw.SLDPRT
Ender-3 Mechanical/Ender-3 Parts/M4X8 Socket Head Screw.SLDPRT
Ender-3 Mechanical/Ender-3 Parts/M5 Self-locking nut.SLDPRT
Ender-3 Mechanical/Ender-3 Parts/M5 Split Washer.SLDPRT
Ender-3 Mechanical/Ender-3 Parts/M5 T-Slot Nut.SLDPRT
Ender-3 Mechanical/Ender-3 Parts/M5 washer.SLDPRT
Ender-3 Mechanical/Ender-3 Parts/M5 washer1.SLDPRT
Ender-3 Mechanical/Ender-3 Parts/M5X25 Screw.SLDASM
Ender-3 Mechanical/Ender-3 Parts/M5X25 Socket Head Screw.SLDPRT
Ender-3 Mechanical/Ender-3 Parts/M5X30 Pan Head Screw.SLDPRT
Ender-3 Mechanical/Ender-3 Parts/M5X40 Pan Head Screw.SLDPRT
Ender-3 Mechanical/Ender-3 Parts/M5X45 Socket Head Screw.SLDPRT
Ender-3 Mechanical/Ender-3 Parts/M5X8Pan Head Screw.SLDPRT
Ender-3 Mechanical/Ender-3 Parts/M8 Self-locking nut.SLDPRT
Ender-3 Mechanical/Ender-3 Parts/M8 nut.SLDPRT
Ender-3 Mechanical/Ender-3 Parts/M8X25 Pan Head Screw.SLDPRT
Ender-3 Mechanical/Ender-3 Parts/Nozzle fan duct.SLDDRW
Ender-3 Mechanical/Ender-3 Parts/Pneumatic joint.SLDPRT
Ender-3 Mechanical/Ender-3 Parts/Power holder.SLDDRW
Ender-3 Mechanical/Ender-3 Parts/Radiator.SLDDRW
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
