Creality3DPrinting/Ender-3/Ender-3 SD/Ender 3 User Guide.xls

Ender 3 User Guide
In order to open and read the files can help you finish it better.
1.Installing
Machine installation | Quick Start Guide
Machine installation（video）
2.USB Driver & Software
Cura-3.0.2-win64 | CURA 15 User Guide
Reference Data | Cura_15.04.3
Software Drivers | Online Printing
3.Trouble Shootings
Trouble Shootings
4.Modle
Test Modle | stl Files
5.visit website
About Us (http://www.creality3d.cn)
Modle Download (http://www.cxsw3d.com/moxingxiazai.html) | Cura Download (https://ultimaker.com/en/products/ultimaker-cura-software)
