Creality3DPrinting/Ender-3/Ender-3 SD/4.Modle/test/test-dog.png

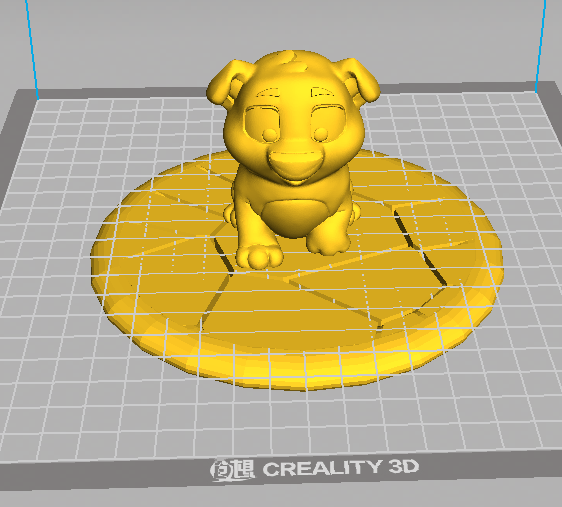
Ender-3 SD/4.Modle/test/test-dog.png
