Creality3DPrinting/Ender-3/Ender-3 Firmware (Marlin)/Ender-3 (includes power failure resume- Chinese)/Marlin/Menu Plans.xlsx

Sheet: Menus V1
Main Screen | Prepare | Control | Card Menu | Move Axis | Temperature | Motion | Preheat PLA Settings | Preheat ABS Settings
Watch | Main | Main | Main | Prepare | Control | Control | Temperature | Temperature
Prepare | Autostart | Temperature | Refresh | X: | Nozzle | Acc: | Fan Speed | Fan Speed
Control | Disable Steppers | Motion |  | Y: | Autotemp | VXY-Jerk | Nozzle | Nozzle
Card Menu | AutoHome | Store Memory |  | Z: | Min | Vmax-X | Bed | Bed
 | Set Origin | Load Memory |  | Extrude | Max | Vmax-Y | Store Settings | Store Settings
 | Preheat PLA | Restore Failsafe |  | Extract | Fact | Vmax-Z
 | Preheat ABS |  |  |  | Bed | Vmax-E
 | Cooldown |  |  |  | Fan Speed | Vtrav-min
 | Move Axis |  |  |  | PID-P | Vmin
 |  |  |  |  | PID-I | Amax-X
 |  |  |  |  | PID_D | Amax-X
 |  |  |  |  | PID-C | Amax-X
 |  |  |  |  | Preheat PLA Settings | Amax-X
 |  |  |  |  | Preheat ABS Settings | A-retract
 |  |  |  |  |  | Xsteps/mm
 |  |  |  |  |  | Ysteps/mm
 |  |  |  |  |  | Zsteps/mm
 |  |  |  |  |  | Esteps/mm

Sheet: Menu Tree
Marlin LCD Menu Tree (V1)

Sheet: Menus V1 CN
主菜单 | 准备 | 控制 | 存储卡菜单 | 移动轴 | 温度 | 运动 | PLA预热设定 | ABS预热设定
信息界面 | 主菜单 | 主菜单 | 主菜单 | 准备 | 控制 | 控制 | 温度 | 温度
准备 | 自动开始 | 温度 | 刷新 | X: | 挤出头 | 加速度: | 风扇速度 | 风扇速度
控制 | 关闭步进驱动 | 运动 |  | Y: | 自动控温 | VXY-Jerk | 加热头 | 加热头
存储卡菜单 | 自动回原点 | 保存参数 |  | Z: | 最小 | 最大速度X | 热床 | 热床
 | 设定原点 | 载入参数 |  | 挤出 | 最大 | 最大速度Y | 保存参数 | 保存参数
 | 预热 PLA | 恢复出厂设定 |  | 回收 | 因数 | 最大速度Z
 | 预热 ABS |  |  |  | 热床 | 最大速度E
 | 降温 |  |  |  | 风扇速度 | 最小移动速度
 | 移动轴 |  |  |  | PID-P | 最小速度
 |  |  |  |  | PID-I | 最大加速度X
 |  |  |  |  | PID_D | 最大加速度Y
 |  |  |  |  | PID-C | 最大加速度Z
 |  |  |  |  | PLA预热设定 | 最大加速度E
 |  |  |  |  | ABS预热设定 | E回收加速度
 |  |  |  |  |  | X轴步每mm
 |  |  |  |  |  | Y轴步每mm
 |  |  |  |  |  | Z轴步每mm
 |  |  |  |  |  | E轴步每mm

Sheet: Menu Tree CN
Marlin LCD Menu Tree 中文版 (V1)
