Creality3DPrinting/Ender-3/(threads)

Thread 1 (2018-07-03):

please re upload solidworks ender 3 part file

quocanhcgd, 2018-07-03:
please re upload solidworks ender 3 part file. All it error. I think you don't change name from chinese to english.Thanks

flowerrobot, 2018-07-03:
Can confirm SW2017 SP5 cannot open these files. I suspect more of a corruption than a language issue.

sexycyborg, 2018-07-04:
Will try, please be patient working on a lot of issues simultaneously.

quocanhcgd, 2018-07-04:
I try with 2015, 2016, 2018 but not luck. Can't open anything (part, assem..)

saLLadEX, 2018-07-04:
I can't open too, i tried to open on SW2017 SP1.

Yeziwaldens, 2018-07-07:
没有一个能打开的  我用stp存储了零件然后覆盖 还是出错，N多的坏面

pyromanci, 2018-07-17:
I have been able to open the Assembly files. But with the eDrawing Viewer, not solid works.

Did notice something intereing int he Ender3-1.sldasm file:

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

interesting to see this one.

TLWhite, 2018-07-24:
I understand all the discussion about the primary purpose repository and version tracking.  The software coding guys are absolutely right about it from their point of view.
  With that said, those of us on the mechanical side that would like to import a workable model into CAD program, would it be possible for someone at Creality to use the "Pack and Go" function of the CAD program, then upload the generated Pack and Go file.  Yes, it is called a ZIP, and it will have version tracking issues for die-hard git hub users.  However, it will give us an assembly that we can work with-without converting over 400 part files and then assembling them.

I really don't want to get in the middle of that other conversation on file tracking and the purpose of Git.  I just want a working CAD Assembly File (As I'm guessing a few others do also).

Thank you,

sexycyborg, 2018-07-24:
Completly reasonable, let me get a bunch of stuff, are you folks willing to help me sort out what's useful so I can update things?

TLWhite, 2018-07-25:
Sure, I’d be glad to help.  The beauty of that “Pack and Go” within Solidworks, is that it includes all the linked files that are needed, and not the ones that aren’t.  Plus a lot more benefits relating to the assembly package.  (Pardon me if you already know all that).

Just talk to the CAD person at Creality, he will know what we are talking about.  He may also have some recommendations on how we track mechanical change-logs to compensate for the revision issues outside of the normal github.

techmach, 2018-07-26:
I have one.  Who wants it?  As long as you are running IronCAD you can have it.

techmach, 2018-07-26:
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

quocanhcgd, 2018-07-27:
Techmach please share it. Thanks. My email: quocanhcgd@gmail.com.

sexycyborg, 2018-08-01:
I'm having a hell of a time getting this stuff- I'll keep asking and try to find an angle. They're a little disenchanted with OSH at the moment. There's no excuse, I know. I'm really sorry about this and will keep trying😔

shoreliner, 2018-08-02:
You should try and disenchant them as much as possible... major US printing companies are going open source/open hardware.  I will be in Shenzhen in the next few months to start a project, perhaps we could put a discussion group together.

techmach, 2018-08-02:
Thanks for responding.  From what I've seen especially with folks like Lulzbot there are several degrees of OSH.  I've been a TAZ 3 user for 4+ years and their idea is a mix of Openscad and FCad files interspersed with SW files.  I'm sure they did their designs in SW but they still have a mix of CAD formats on their site which makes no sense but that's how they roll.

If there is a fear of cross pollination with other companies I wouldn't sweat that because at the commercial level there are few secrets in China as you know.  These 3D printers aren't like full blown CNC metal cutting machines so maybe someone there at Creality will realize that posting the SW files isn't that big of a deal.  The STEP files were enough to build an assembled model from.  The important bits are there.

rulas9327, 2018-08-03:
I have a fatal solidworks error, i cant use the solidworks filesin 2018 sp1 please re upload and thx naomi for your awesome work

acristallini, 2018-08-13:
Hi,
which version was used to save this project ?
All files are reported as "saved with a future version" of SW.
I use SW 2018 SP1
Thanks in advance

SIeeepy, 2018-08-17:
Hi,
I also faced errors when trying to open the published Ender 3 Solidworks files, so I've used the provided STEP files to create a Solidworks 2015 assembly.
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
Some models were missing and I had to create them. I've used the "pack and go" feature.
You can **download the CAD files** here (~85mb): https://s3-eu-west-1.amazonaws.com/krimskrams/Ender_3_CAD_Solidworks2015_STEP_IGS.zip
Updated STEP and IGS files are included. Hope this is ok with you @sexycyborg .

sexycyborg, 2018-08-17:
This is great thank you! I'll put in the repo shortly.

Once again sorry for the delays everyone. Juggling a lot of things and the engineers are all using old pirated versions of everything I think. Thanks so much for your patience...

Agniusm, 2018-08-17:
Perfect, thanks

croplaninec, 2018-09-03:
thank you sleeepy :-)

steenerson, 2019-12-13:
Looks like this is resolved, closing out this old issue.

Closed 2019-12-13.

Thread 2 (2018-07-03):

PCB Design

alekssobolewski, 2018-07-03:
Hi Naomi!

Can you please upload the PCB files in format that does not require a paid PCB design software?
Or at least Eagle files.

What program creates that .PCB file?

Moorviper, 2018-07-03:
try kicad i think this could open it

NikiSchlifke, 2018-07-03:
>try kicad i think this could open it

Probably not.
A pcb layout isn't sufficient anyway, for open hardware we need the circuit diagram, the part libraries **and** the layout.

alekssobolewski, 2018-07-03:
Exactly @NikiSchlifke.
I already tried some programs, and it turned out to be an Altium Designer PCB layout. There is no elements and schematic within the file, so it is basically useless :/

NikiSchlifke, 2018-07-03:
>I already tried some programs, and it turned out to be an Altium Designer PCB layout.

Well it's the status quo in industry... as for us Hardware Hackers we really need KiCad

@Creality3DPrinting
@sexycyborg
Have a look at this, maybe this will help us out:
https://github.com/thesourcerer8/altium2kicad

Moorviper, 2018-07-03:
ok it can't open it but it would be nice.
Prusa also switched to kicad

sexycyborg, 2018-07-04:
I agree KiCAD would be best, I'll see if something can be done.

RudolphRiedel, 2018-07-04:
I am missing the schematics as well.
And the Ender-3.PCB is not really an Altium Designer file.
Altium uses .PcbDoc for the layout files.
This is an old Protel format that AD happens to be able to open, really old,
the last Protel version was 99SE. Altium Designer started in 2004.
It barely opens with two warnings generated for AD release 12 and 13.
The only component that has a 3D-model is the connector EXT-A2.

And there are really quite a number of real issues with this design.
But I have no idea if this repository means that we should point these out to Creality in order to let them eventually fix these.

alekssobolewski, 2018-07-04:
> And the Ender-3.PCB is not really an Altium Designer file.

@RudolphRiedel Well, maybe it is a Protel file. I just found it opens without a problem in Altium. I'm not a specialist in in, just downloaded a free demo to open a file.
But it does not matter, we need a real schematic and pcb design file created in a free software (like KiCAD).
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

RudolphRiedel, 2018-07-04:
> But it does not matter, we need a real schematic and pcb design file created in a free software (like KiCAD).

While yes, the schematic is missing I do not agree that Creality needs to supply the data in any form they are not actively using. In fact they do not "need" to supply anything and we can considers us lucky already that they supplied as much as they have now.
If asked nicely they may supply a set of .pdf files along with their original design data.
Or someone could just fork this repository and add more files.

And for what purpose do you really "need" the files?
Do you plan to build your own improved PCB? How many out there would do that?
I could do that and already with the data available but the important thing for me here is repairability rather than the need to create a new board from this.
Maybe tweak a few things.
If I wanted a new board I could chose one of the other available options like an Einsy-Rambo which btw. is released as Altium-Designer project.

RudolphRiedel, 2018-07-04:
Here, I just created a project for the board and created an assembly plan with my default output job and not editing anything.

[Ender3_pcb_parts.PDF](https://github.com/Creality3DPrinting/Ender-3/files/2164340/Ender3_pcb_parts.PDF)

alekssobolewski, 2018-07-05:
> And for what purpose do you really "need" the files?
Do you plan to build your own improved PCB? How many out there would do that?

Well, my CR-10 is currently connected to MKS L just because I like to do everything on my own, but I have also two not working Creality boards that I broken accidentally. It would be nice to have a schematic to repair the board or add something new. For example improve the 5V supply and maybe change Allegro steppers to Trinamic.

RudolphRiedel, 2018-07-05:
Repairability, exactly.
In the meantime this could be helpfull: https://github.com/RudolphRiedel/CR-10_wiring

I started to draw a schematic for the CR-10 controller-box a while ago, the whole thing including the pcb.
This is as complete as I needed it to be so far.
And the Ender-3 has the same controller-board as the CR-10, well at least later models came with the V1.1.2 version of the board we see in the Ender-3.PCB now.

With the PCB data I could easily improve my schematic further but at the same time I would prefer if Creality supplies the original schematics.

alekssobolewski, 2018-07-05:
Wow! Thanks a lot @RudolphRiedel 😃 I need to replace the stepper drivers, so now I can make an adapter to plug them for example on breadboard (I really have to learn how to properly solder QFN uCs 😛).

RudolphRiedel, 2018-07-05:
It is a start, I was more interested in the controller. And with the wiring of the box I tried to figure out a way to add an auto-bed-level sensor more elegantly to the control-box.

Soldering QFNs is not really that difficult. An affordable hot-air station, flux, something to mask off the rest of the nearby area of the board like capton-tape.

The A4988 only have a QFN-28 case and the board has only two layers, so these should come of quite easily.

Regarding tweaking, I was thinking about changing the config for the Z-Stepper from 1/16 steps to full steps.
And now that we have the layout I can check that in detail without the need to remove the heatsinks.
It turns out that each stepper driver has resistors on every single config line including MS1, MS2 and MS3 which control the microstepping resolution.
I could easily remove R35, R36 and R37 and connect their pins that lead to U7 with GND.
Sure that reduces the resolution of the Z-axis to 0.04 mm per step and you have to keep that in mind with the layer-heights. But going full step gives it more strength.

Or in other words, Creality delivered, if not all than most of it and in some regards with a suprising level of detail. We can hope that they are so kind to provide even more information but it is up to the community now to take part in this.
Stop demanding that everything is handed to you, apreciate what you got and do something with it!

And no, I am not adressing you specifically with this Aleks, more the community overall. :-)

I did not like the supplied BOM, so I exported a new one and started editing it.
[Ender-3_BOM.xlsx](https://github.com/Creality3DPrinting/Ender-3/files/2167733/Ender-3_BOM.xlsx)
Miss something? Add it!

digitaljunk, 2018-07-06:
@RudolphRiedel thanks for your efforts. Great work.
But Creality should fulfill the OSHW certification. Especially when they start to do marketing with that OSHW and Open Source hardware term.

@Creality3DPrinting please publish all files in a file format that can be used for improving the hardware.

RudolphRiedel, 2018-07-06:
@digitaljunk

The schematic is missing, okay. And probably the project file and a few files around them.
Above the parts library has been requested but the parts are just embedded into the PCB file and can be generated from it: [Ender-3_PcbLib.zip](https://github.com/Creality3DPrinting/Ender-3/files/2171505/Ender-3_PcbLib.zip)

But otherwise releasing the original design files in whatever format is fully compliant with the OSHW definition: https://www.oshwa.org/definition/

For crying out load, they went this far and released their original data.

If it is not in some weird custom format no one ever has heard of you will find someone who can convert it. Regarding converting, I took a quick look at the https://github.com/thesourcerer8/altium2kicad from above and it uses .PcbDoc files from Altium Designer and not .PCB files.
So I just saved the file with AD17:
[Ender-3_PcbDoc.zip](https://github.com/Creality3DPrinting/Ender-3/files/2171524/Ender-3_PcbDoc.zip)

Have fun with it and post a KiCad file if you can.

Would you like a set of Gerber files as well?

sexycyborg, 2018-07-07:
Guys, it's literally just me doing this and there's a million other things going on. Unless your 3D printing parts for your failing iron lung cut me a little slack and give it some time😉

DuncanAmos, 2018-08-11:
Let's get things in perspective:

Creality did their design in what is probably the best Schematic/PCB/Workflow/3D combined package out there - why the heck wouldn't they?

Eagle is a far more common 'maker/enthusiast/hobbyist' package that KiCAD so, for a moment, let's get real...

Altium does have the capability of exporting their design files in file form called ACCEL ASCII format. This is a data structure EAGLE is able to import. If you wish to import a schematic, click on File/Import/Pcad, Altium, protel option. Then follow the prompts on the dialog box.

I don't know what file imports exist in KiCAD, but maybe this is a start?

Naomi is doing her best - thank you Naoni...

sexycyborg, 2018-08-15:
I just uploaded a bunch of PCB files that I got in different formats, sorry I'm a bit out of my depth if they are useful, or can be converted to something useful I can also upload please let me know.

https://github.com/Creality3DPrinting/Ender-3/tree/master/Ender-3%20PCB

UrsBruetsch, 2018-08-15:
I'm a happy user of Altium and my idea is to change the Atmel 8bit processor to ESP32 for more power of the printer and maybe (later) for network compatibility. But it is exhausting and time-consuming to develop the circuit diagram from the board. So it would be great if the documents were complete. So that the community could participate in the development of Ender, CR10 and other...

DuncanAmos, 2018-08-15:
Urs I don't think anyone would disagree with you that schematics and board
files for all the popular packages would be ideal...

Natalie is doing her best but, as she freely admits, she's out of her
depth, so it's up to us to step up and make the process easier.

What's the first thing we need to know? Which software package are Creality
using to generate the schematic and board files - right? That's something
that Natalie can probably discover fairly easily.

Once we know that, then Natalie may be able to obtain 'latestVersion.abc'
and 'latestVersion.xyz' files, from which we can (hopefully) create
conversions for other software packages and provide them here, with
supporting information.

A specific request is likely to get a more positive and helpful response.

On a slightly different angle - why would you want to swap out the Atmel 8
bit processor for an ESP32?

Octoprint does a fantastic job of networking the printer already (and is a
'de facto standard') and is there really a requirement for 'more power' in
a device that is, basically, driving stepper motors and
monitoring/controlling two temperatures? All that is well within the
capabilities of the existing hardware.

I can see a need to split out the two fans, but beyond that, the existing
hardware works and, in general, works very well - even if it is close to
using all the available memory.

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

On 15 Aug 2018 11:03, "Urs" <notifications@github.com> wrote:

I'm a happy user of Altium and my idea is to change the Atmel 8bit
processor to ESP32 for more power of the printer and maybe (later) for
network compatibility. But it is exhausting and time-consuming to develop
the circuit diagram from the board. So it would be great if the documents
were complete. So that the community could participate in the development
of Ender, CR10 and other...

—
You are receiving this because you commented.
Reply to this email directly, view it on GitHub
<https://github.com/Creality3DPrinting/Ender-3/issues/2#issuecomment-413138157>,
or mute the thread
<https://github.com/notifications/unsubscribe-auth/AXX1IOGTb2xVT22q-AYAd4eRyaoAAOgmks5uQ-PygaJpZM4VBpFN>
.

UrsBruetsch, 2018-08-15:
Duncan, thanks for your answer. Yes, you're right, it's not really necessary to change the Atmel to ESP.
And you can go with RasPi and Octoprint. That's a safe solution and it works
but it is also a complicated way to print.
Wifi is defacto a standard in the printer industry.
The ESP also has the advantage that it is much faster than an 8-bit Atmel.

Solutions like Klipper are very charming, but you always have to make the detour via a RasPi and reprogram the printer hardware. Not very comfortable for the people (beginners).
My idea is to update the printer electronics directly to have more speed and comfort without special external hardware and software. The RasPi solution costs more time and money to install and requires a lot of expert knowledge ...
So to bring the printer into a network and improve the speed, the ESP is certainly a good solution.

RudolphRiedel, 2018-08-15:
Sorry Naomi, but I went thru the files and do not see how these would be of any more use than the ones we already had,

The *schematic* is missing and not more versions of the same board file.

And btw. the board file has no 3D information except for one connector that is not even populated for the Ender-3 but replaced with a capacitor.
Plus the PCB has a few pretty obvious design flaws.
Without schematic and project file and everything else connected to the pcb-project it is however not that easy to contribute anything.

Would Creality even be interested in contributions?

RudolphRiedel, 2018-08-15:
I am pretty sure that Naomi knows what a schematic file is even when not beeing told to lock for a file called .sch or .schdoc.

RudyFiero, 2018-08-15:
My two cents. Do you really think that Naomi can just go looking for whatever engineering files she can find, that she has access to the engineering documents they have? I would think not.

If she isn't getting the kind of material that would be useful then I think it is because whoever she is dealing with is either not being as helpful, or they have been directed to not provide very useful information.

DuncanAmos, 2018-08-15:
I wasn't implying in any way that Naomi wouldn't know a schematic file,
merely saying that the process of her obtaining the files for those who
seem to disparage her efforts so far, might be easier if we actually knew
what software was in use, and thus which file formats are Involved.

The schematic may be a ".sch" but it's very possible that it's not...

I certainly agree with the first part of Rudy's post and I think that the
second part is a distinct possibility.

Although Creality are supposedly open-sourcing things, that may not be 'all
at once' and it certainly won't be in file formats to suit everyone...

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

sexycyborg, 2018-08-15:
Okay so are we saying the new files I just uploaded are not useful? What format that can be exported from Altium Designer would be useful?

No, I don't know a whole lot about PCBs, no insult there or anything. That's why I'm asking.

RudyFiero, 2018-08-16:
I use a layout program from Mentor Graphics called PADS. It is supposed to open Altium Designer files. The Ender-3.PcbDoc has the right extension and maybe I can open that. Unfortunately I will not be able to try it until tomorrow. I need to use a dongle (hardware key)  to run the program and it is at work.

So if I can translate the pcb file I would be able to move things (traces, components) on the layout but I couldn't do anything else with it. I couldn't add or remove parts or connections. For this we would also need the schematic files. I expect it would be called Ender-3.SchDoc.

I have never imported Altium Designer files. I just looked at a couple of Youtube videos on importing them to PADS. It seemed straightforward but I will need to try it.

@UrsBruetsch  You said you are a happy user of Altium. Were you able to open any of the pcb files.

There is an online Altium to KiCad converter. http://www2.futureware.at/KiCad/
https://github.com/thesourcerer8/altium2kicad
Since I don't have KiCad I didn't try it.

RudolphRiedel, 2018-08-16:
>Okay so are we saying the new files I just uploaded are not useful?

No, we are not saying that the files are not usefull, they might be for someone. :-)
I wrote more usefull than the first file because the new ones do not add any depth for me.

>What format that can be exported from Altium Designer would be useful?

Asked like this nothing else.
I already provided a file converted to AD17 to be used for the KiCad Converter.

But it would be nice to know what software Creality is really using, and exactly down to the version.
If that first Ender-3.PCB really is the original design file that Creality is using, they are not even using Altium Designer, they are using its predecessor which was Protel.

And a PCB project always has at least two files, the schematic and the pcb.
Naomi, do you have access to any more files?
In doubt just nake a screenshot and we help point out a few more files.

RudyFiero, 2018-08-16:
I am able to open and translate the **Ender-3.PcbDoc** file (only did one so far) for my PADS program. Some routing information has been lost (eg. ground plane) but that doesn't surprise me. I will try and have a better look at it tonight.

At minimum the  **Ender-3.SchDoc** file (I assume that is what it is called) is what is needed.

RudolphRiedel, 2018-08-17:
There are revision 1.1.3 boards out?
https://github.com/Creality3DPrinting/Ender-3/issues/12

Can we please have design files for this one as well?
But regarding repairability and seeing that CR-10 printers are also built with the 1.1.2 boards I would very much apreciate this as additional set of files and have the 1.1.2 file-set also completed.

UrsBruetsch, 2018-08-17:
@RudyFiero Yes, i can open the "Ender-3.PcbDoc" but the Design Rule Check has more then 500 Errors.
I think, with some Work on the PCB-Rules and creating new Nets from connected Copper, it will be a usable PCB-File.
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

RudolphRiedel, 2018-08-17:
Yes, I can confirm that, I just ran the DRC with AD17 and increased the amount of  violations reported to 5000.
Came out with 8 warnings and 629 rule violations.

I would guess though that a good portion of that are more or less false positives due to the file beeing converted from an older version.

But this like this are just silly:
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

The connection is not missing, the signal at pin 5 is named incorrectly, it should be SD_SCK or similar.

UrsBruetsch, 2018-08-17:
@RudolphRiedel Jepp, thats an Error (in Altium).
Let's hope there are not too many of these mistakes on the board ...

RudolphRiedel, 2018-08-17:
I would not call that an error in Altium, that one is an error in the data.

I actually wonder now if Creality has a schematic for that board.

RudolphRiedel, 2018-08-20:
A friend asked me something about the FETs on board and so I had a closer look.
First is that these are named REP30N06LE in the board and the BOM while it is likely that these are RFP30N06LE.

Okay, we have an external FET for the bed and the fan does not draw much power which leaves the hot-end FET sending some amperes thru the board.
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

Looking at the GND from the board though I find no solid connection between the three FETs and the GND connector on the board from the PSU.
The same applies to the stepper drivers.

adamtegen, 2018-08-21:
I opened the files in a trial version of Altium and exported the top and bottom layers as pngs.  I made a pull request for them: https://github.com/Creality3DPrinting/Ender-3/pull/14

Additionally, I've gone through the exercise of tracing the lines for the 6-pin ISP connector and the 10-pin LCD connector.  I don't exactly know how/where is the best place to document those.  If anyone has any suggestions, please let me know.

Gazza-USA, 2018-09-15:
Guys, if you point me to the files I will take a look too.  I professionally use Altium and can take a look at the netlist etc.  If the native file is in another format (PADS, Allegro) send me that too.   If anyone has the schematics in any form too that would help.

Gazza-USA, 2018-09-15:
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

Yeah, I found exactly the errors you did.  They obviously don’t know how to use the tools properly as there are stacks of pads and component pads that are incorrectly defined.  Via stitching would solve the GND break and sorting out the polygon pour order would fix other things.  I did a cleanup myself for fun.  It looks like some things have been added after the schematics too like a resistor for an LED.  This is all just physical copper with no nets so it generates DRCs.

RudolphRiedel, 2018-09-15:
Have you even read the thread?
It's been 2 1/2 months now and there still is no schematic for the control-board from Creality.
It is like they do not even have a schematic.
Maybe this is annother contract job like they told us the modification of the software was.
And that the original .PCB is in a 20 year old Protel format without almost not 3D models is rather strange, together with  apprentice-level flaws like the grouping of C41/C42/C43.
I am tempted to re-work the  board but so far there has been no sign of apreciation of what is going on here whatsoever from Creality, so far this is a dead repository.

sexycyborg, 2018-09-15:
Sorry I've been working on getting the CAD files uploaded. What can I get you from them?

RudolphRiedel, 2018-09-15:
>What can I get you from them?

Well, the whole project directory they are actually using for development would be nice.
And as the same PCB is used at least in the CR-10 that is rather unlikely to have "Ender-3" in any of the files.
I even doubt that the actual board file is named xxx.PCB since that would mean the board is beeing developed with software that is 20 years old.
So, the real files would be a kicker, board.PcbDoc, board.SchDoc and board.PrjPcb at the very least if the board is indeed designed with Altium Designer. Plus board.PrjPcbStructure and the xxx.PcbLib, xxx.SchLib.

If that is for some reason not possible at the very least a Ender-3.SCH would be nice and of course the latest version of the Ender-3.PCB as this one was outdated even before it was released here.

sexycyborg, 2018-09-15:
Does anyone want to ask for something without calling the people being asked liars or making accusations of duplicity in the same post?

DuncanAmos, 2018-09-15:
Well said Naomi...!!!

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

RudyFiero, 2018-09-15:
Could we please get the current documentation for board. The Ender 3 I have has a pcb revision of 1.1.3.

Personally I want the schematic. I have no intention of ever producing a replacement board. I want accurate information so that I make proper decisions on firmware upgrades.

sexycyborg, 2018-09-15:
Any documentation will be in Chinese- if there is any. I'll ask.
Ok- different versions of boards.
If it helps they are using Altium Designer 6.9

This is not an issue of the bosses being reluctant. I'm facing no resistance here, I'm talking directly to the engineer- but he does not speak English and I'm not an engineer. I can say "export in every format you can" and he has- and I've uploaded that. If there is something specific in terms of file suffix, or a screenshot of where to go to get you something useful, an example of some kind, that helps.

This constant assumption of bad faith is exhausting and counter-productive. The same time spent complaining in this thread could have been spent providing instructions that a layperson (me) could pass on.

RudolphRiedel, 2018-09-15:
>Does anyone want to ask for something without calling the people being asked liars

As this is clearly is addressed to me, please point out where I did that.
That is just your interpretation of what I wrote.
I was throwing around some facts and assumptions based on these facts.
I did not write that Creality is trying to lie to us here or they acting in bad faith.
The renaming of the .PCB to Ender-3.PCB is easily explained by the fact that this is the Ender-3 repository and this was done in order to have everything named alike.
All the files could have chinese names, again I am not saying that would be bad, this is just a possible explanation.

I saw no statement before that Creality is developing this in-house so the assumption that this is a contract work was only made to explain why  after 2 1/2 months the schematic is still missing.
And this would be a totally legit explanation.
I am glad that this assumption is not correct as this means Creality must have the schematics.

>or making accusations of duplicity in the same post?

And I do not get how you come to this conclusion either.
Please point it out to me.
All I see is that I pointed out the fact that the data is not complete without assesment as of which this is the case. And I offered help with this by listing all the extensions of the files that should be in the directory and that are now missing.
The Ender-3 is sold with the V1.1.3 board but the data released is for the V1.1.2 board - it says so in the silkscreen. Again, nothing but a fact.

>If it helps they are using Altium Designer 6.9

Yes, this helps since in that case it really is not a Protel file and I was wrong in assuming it is.
I just checked the Ender-3.PCB with a hex-viewer and found the string "PCB 6.0 Binary File".
While older and a few things have changed since this, this still is a Altium Designer file and at least files saved with AD17 still have that 6.0 tag.
I was wrong and I admit that.

However, you could have pointed out that I am wrong two months ago.
And when I right-click a pcb file and select save-as, only PCB versions 3.0 and 4.0 get named .PCB while 5.0 and current is named .PcbDoc.
Sure, it is totally possible that the engineer uses old file extensions, really old file extensions.
But I should be allowed to find that strange.
And me finding that strange does not mean he is doing it wrong.

Please just let him .zip the directory he is working with.
Maybe make a copy and clean out a few sub-directories before that like "_Previews", "History" and "Project Outputs...".
On August 16 I offered to point out the needed files if you provide a screenshot of the directory.

I am really trying to be helpfull here.
And just look at the timelime and the posts, if that does not reflect patience I do not know what would.

RudyFiero, 2018-09-15:
> "Does anyone want to ask for something without calling the people being asked liars"
>
> As this is clearly is addressed to me, please point out where I did that.

It was **not** addressed to you. Not specifically I would think. Yes you have been coming across as ... not someone I would want to know.

> If she isn't getting the kind of material that would be useful then I think it is because whoever she is dealing with is either not being as helpful, or they have been directed to
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

Thread 3 (2018-07-03):

[REQ] publish the firmware as a proper git repository

NikiSchlifke, 2018-07-03:
The firmware right now is all in one dump, as it stands there is no way to tell which code came from creality, and which code is from the original authors.
This is also a licence issue currently, as it's not all gplv3. (Not to mention the huge problem a binary blob that contains this code was..)

So if the code already is in version control (which considering the scope of the project seems almost certain) create a new repository on github and add it as a remote.

zoide, 2018-07-04:
I think adding the changes from creality as a PR to Marlin would be a great thing. The hexdump of the resume feature is actually pretty useless in this form.
Other than that, Marlin 1.1.x already works on the Ender-3.

Nevertheless, cudos for opensourcing all of this.

pyromanci, 2018-07-16:
Currently i'm wrapping up and testing Marlin 1.1.8 with the resume feature i've ported from this code. Should be submitting a pull request to the Marlin bugfix branch in the next couple days along with 2 example configurations for the Ender 3.

stevegibbings, 2018-07-17:
@pyromanci would you post back here with an update on your PR please son can refer to it please?

pyromanci, 2018-07-17:
I am still tinkering with it. It crashed once and failed a second time, but work 3 other times. So the port wasn't as good as it appeared. once i'm done i will commit it to my Marlin Fork and comment here.

rmcolbert, 2018-07-18:
I tracked back the closest commit to the original Marlin repo before Creality forked it. Here's a link to that commit: https://github.com/MarlinFirmware/Marlin/tree/c4fbb44d6d42b84137a89ab7aa5ab7143116184d

Thread 5 (2018-07-11):

File handling

techmach, 2018-07-11:
Fix the SW files so they are properly exported and save the Solid Assembly file with the sldprt files so you can download all in a single file with all the individual files.  Learn to use Pack and go so they can be properly saved.  Learn how to handle Step files.  These are not script or text files so don't handle them like that sort of files.  Zip them into a single file so you can download everything at once and not piecemeal.

https://www.bing.com/videos/search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

oziee, 2018-07-24:
geez.. your a very rude, abusive, demanding person aren't you!!.. two posts in here, and you think this is how you write things??
you have been on github for 20 days.. if you don't know how it works, go and learn. You don't like the ways its been done, then fork it and make your own.
Learn yourself!

techmach, 2018-07-24:
The SW files are corrupt.  STEP files are not supposed to be handled as TEXT files because they aren't TEXT files.  You can't change the reality because you don't like the perceived tone of the message.

francisalbar, 2018-07-25:
Git repositories are not limited to text files - they work with any files including binaries, images, etc. What you are viewing right now is the Github web interface which attempts to detect mime-types and utilizes an HTML based previewer.

The web interface is not the only way to access these files. If you prefer more granularity or prefer to view these files with your own preferred viewers, please use a different interface such as a GUI Git client like SmartGit, Tortoise, or Github Desktop.

TLDR Learn to Git.

techmach, 2018-07-25:
STEP files like DXF or IGES don't require viewers and they were never meant to be handled like simple ASCII text files.  These file types are generated via translators from 2D and 3D CAD/CAM systems from the 3 dimensional data resident in the source file on that CAD/CAM system.  STEP files are not meant to be edited by hand as are Arduino or Marlin files.   At issue here is that Github handles them as if a user needed to use snippets of code for programming devices.  The clue is the file extension which is everything in this case. The STEP extension has to mean that your system understands that this file is not a man editable file and doesn't need to be read in an editor unless the user wants to.  The end result should be that I can simply right click and save the link as a *.STEP file with the name and the extension intact as I would to with a *.sldprt file that is also hosted here.

Do you understand this concept?

techmach, 2018-07-25:
My attitude is irrelevant.  What is relevant is performance.  You either can or you can't.  If this is supposed to be a file handling hub it should learn how to handle files.  The Empire will bring order soon enough.  At least Microsoft understands the concept of file extensions and their significance.

techmach, 2018-07-25:
Github's own definition:

"Git

Git is an open source program for tracking changes in text files, and is the core technology that GitHub, the social and user interface, is built on top of."

As I explained earlier STEP files are not just TEXT files and as such are not meant to be handled as TEXT files.  Sounds to me like STEP files just stretch the "Git" to the breaking point.  Better Git with it or be left behind.  There's a whole wide world out here.

TLWhite, 2018-07-25:
techmach, you are correct, the STEP files that are uploaded are corrupted, and are of little use.

Naomi is working on getting us a properly exported "Pack and Go" file for the community to work from.

francisalbar, 2018-07-25:
The Git Version Control Platform handles non text files perfectly fine. The Github WEB INTERFACE is incorrectly treating STEP files as text, and as such, the Github WEB INTERFACE is causing your issue.

If you would like the Github WEB INTERFACE to handle it appropriately, log a defect to Github, or better yet, submit a pull request that fixes the issue. You know, the way open source works. Creality has nothing to do with how the files are handled by the interface.

Your other option is to utilize a different interface to handle binary files directly as I've mentioned before. You won't have to worry about an HTML interface or your browser misrepresenting the files.
- https://git-scm.com/ Command Line
- SmartGit
- SourceTree

9ae8sdf76, 2021-07-19:
@TLWhite @techmach et al,

It sounds like the repository needs a `.gitattributes` file that defines the `.STEP` files as binary files so that a) git won't try to change line endings, and b) won't try to diff them, or c) anything else that happens with text files that would corrupt binary files.

Creating a file at the root of the project called `.gitattributes` and adding the following line would solve this problem:

```
*.step binary
```

Source: https://www.git-scm.com/docs/gitattributes#_using_macro_attributes

PS. @techmach, while you mean well and are technically correct, the way you come across is off-putting and aggressive. This does not encourage others (as you've witnessed) to listen to what you have to say. In fact, it often times will have the reverse effect. It's also worth while to remember that not everybody knows what they don't know, not should they be expected to. We are all here to learn and help, and should approach these kind of situations in that spirit. :)

Thread 7 (2018-07-15):

Missing parts

techmach, 2018-07-15:
You've left out the 250 mm long section of 4040 extrusion that serves as the center crutch of the printer.

For God's sake please Zip all the files so they can be downloaded as one download and correct the handling of STEP files.  STEP files are not to be handled as text files.

pyromanci, 2018-07-16:
why should they zip it?
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

Also It's GitHub that is classifying the files that way. It's the site's limitations not them. Welcome to repo system. This is not Thingiverse so it has no ability to view models.

techmach, 2018-07-16:
It's cumbersome to handle STEP files as text as well a having to deal with
them on a one on one basis.  Why not zip them a one file?

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

pyromanci, 2018-07-16:
Because this is a git system. If you just have a zip file with all the step files. You change 1 file you have to rezip and re upload all the files instead of just the signal file. Which is one of the main points to a repository system such as git, cvs, svn, mercurial, ect.

Again you can just run a git clone or click the download zip button on the main page if you don't want to manually download each file. .

techmach, 2018-07-16:
It's not an efficient use of a filing system and it still doesn't alleviate missing files.

pyromanci, 2018-07-16:
neither does just a zip file.

bergstar, 2018-07-24:
techmach this is not how github works. It is not a download page. Please take a moment to learn and understand git. What is "cumbersome" for you, is actually the correct way of doing things.

techmach, 2018-07-24:
Correct is always relative to a certain POV.

pyromanci, 2018-07-24:
@techmach are very much correct. Correct is relative to point of view. In this case Point of View is from the design intent and implementation of a repository system such a GIT.

Which is to track and manage individual file changes. With the ability for other to fork off the files, create branches, and submit user changes/improvements to the master branch or use it as a base for their own work (like what they did with the marlin code).

So your demand for zip files (which again, you can generate on demand right of the main page of the repository if you look) in incorrect.

Give your account creation date being the same day this repo opened. I'm guess (just like @bergstar ) this is your first time ever using a repository system and like @bergstar highly recommend you read up on what they are and how they operate.

Here are a few links to get you started:
http://lmgtfy.com/?q=how+does+github+work
http://lmgtfy.com/?q=what+is+a+code+repository

techmach, 2018-07-24:
I've been a member under several different long forgotten usernames in the past so I know how it works.  STEP files aren't Arduino snippets nor are they TEXT files.  This system is handling them like TEXT files; they are not.   Why should I have to download a Zip of the entire upload just to get the files I need in a folder?

techmach, 2018-07-24:
BTW, STEP files aren't user modified or edited at the character level so it's not efficient to handle them like Arduino script.  STEP files are generated by translators in the CAD systems themselves.

pyromanci, 2018-07-24:
This site see's the step files contain only ANSI characters. So of course it's gonna register it as a text file. Complaints about it here will not do you any good. you need to go to the bottom of the page and click that Contact Github link and complain to them. As they are the only ones who can do anything about it.

However again. you replace any file. Code, image, text file, solidworks file, step file. When you replace the and commit it to the repository the older version will still be present for us to retrieve. So hand editing doesn't matter. the revision that the file changed will still be present.

Still don't understand what is so hard to just download the entire thing and delete the extra. Which i'm pretty sure is common practice for any site or download system. Thingiverse when you download a thing, you get a bunch of extra stuff with it. HP or Dell, you download drivers, which are normally a bunch of different drivers all bundled together for the same product  family. Download and SDK, you get tons of unwanted platform and examples.

Bundling everything together for something like this IS A GOOD THING.

techmach, 2018-07-24:
Have you been on Thingiverse lately?  You can download individual files zips, STEP's native CAD formats or STL/OBJ files independently and it seems to understand what the individual files are and how to handle them unlike NotepadHub.  I can't believe Microsoft is buying this site.

pyromanci, 2018-07-24:
Maybe cause Billion dollar companies use this system as well.

Of course thingiverse knows how to handle those files with viewers and custom Mime types. It's a site specific designed for 3d files. Where this system as a generic file repository.

But i will stop here. I don't think i have the brain cells left to continue this round about and how wrong you are.

techmach, 2018-07-24:
They have viewers for STL files but that's it.  Everything else they seem to know how to handle.  It's real simple; GitHub only handles text files.  I get it.  It's not rocket science but here's the rub; Creality made a big deal out of going open source and in reality the ONLY thing they should have posted here was the Marlin files because that's the ONLY type of file this system seems to understand how to handle.

It's your prerogative to claim I'm wrong and that may be from your POV but not being able to handle a very simple file type like a STEP or IGES file and recognizing it as a simple TEXT file is lame.  Billion dollar companies may use this site but Billion dollar companies make toys too.   For the rest of that inhabit the custom metalworking business like myself we expect a different level of expertise which is not here.  Microsoft just gave up too soon.  I bet the Empire knows how to handle STEP files.

francisalbar, 2018-07-25:
Git repositories are not limited to text files - they work with any files including binaries, images, etc. What you are viewing right now is the Github web interface which attempts to detect mime-types and utilizes an HTML based previewer.

The web interface is not the only way to access these files. If you prefer more granularity or prefer to view these files with your own preferred viewers, please use a different interface such as a GUI Git client like SmartGit, Tortoise, or Github Desktop.

TLDR Learn to Git.

techmach, 2018-07-25:
STEP files like DXF or IGES don't require viewers and they were never meant to be handled like simple ASCII text files.  These file types are generated via translators from 2D and 3D CAD/CAM systems.  STEP files are not meant to be edited by hand as are Arduino or Marlin files.   At issue here is that Github handles them as if a user was using snippets of code for programming devices.  The clue is the file extension which is everything in this case. The STEP extension has to mean that your system understands that this file is not a man editable file and doesn't need to be read unless the user wants to.  The end result should be that I can simply right click and save the link as a STEP file with the name and the extension intact as I would to with a *.sldprt file that is also hosted here.

Do you understand this concept?

francisalbar, 2018-07-25:
The Git Version Control Platform handles non text files perfectly fine. The Github WEB INTERFACE is incorrectly treating STEP files as text, and as such, the Github WEB INTERFACE is causing your issue.

If you would like the Github WEB INTERFACE to handle it appropriately, log a defect to Github and NOT this repository. Or better yet, submit a pull request that fixes the issue. You know, the way open source works. Creality has nothing to do with how the files are handled by the interface.

Your other option is to utilize a different interface to handle binary files directly as I've mentioned before. You won't have to worry about an HTML interface or your browser misrepresenting the files.
- https://git-scm.com/ Command Line
- SmartGit
- SourceTree

techmach, 2018-07-25:
Francis,  This isn't my problem, it's Github's.  If y'all want to fix it that your decision.  As ubiquitous as STEP files and other 3D tranlation files are Github should want to make the required changes without me having to initiate a request for correction.  The Chinese are quick learners, they will figure this out.

francisalbar, 2018-07-25:
Let me put it this way - you're posting a complaint to a television network because your old CRT TV can't display their HD broadcast correctly. Your options are to complain to the manufacturer of the TV, or get a different, FREE High Definition 4K TV. You're posting in the wrong place.

Please find the appropriate repository in https://github.com/github and post your issue there.

techmach, 2018-07-25:
The STEP files are here in this repository Francis, not on the main page.  I 'm done.   Y'all want it your way and that's fine, you can have it your way but the problem still remains, unsolved until someone like yourself wants to make the correction.  I've spent way more time on this than it deserves.

Autotonic, 2018-07-25:
```
STEP-File is the most widely used[citation needed] data exchange form of STEP. ISO 10303 can represent 3D objects in Computer-aided design (CAD) and related information. Due to its ASCII structure, a STEP-file is easy to read, with typically one instance per line.
```
[Source: Wikipedia](https://en.wikipedia.org/wiki/ISO_10303)

techmach, 2018-07-25:
Good job, Google is a great thing isn't it?  Here is some history to add to the discussion.  I was part of the STEP process back before 1994 along with thousands of my close personal friends in the metalworking business.  https://www.mmsonline.com/articles/step-ncthe-end-of-g-codes

francisalbar, 2018-07-26:
@techmach as I've mentioned before, Creality3D, @sexycyborg, nor any of the authors for this repository are capable of fulfilling your request. Git is a platform. GitHub is just one of many hosting solutions for Git repositories. GitHub also happens to provide a closed source web interface to repositories they host, however, most users do not use this web interface to access the files. If you want them to update their web interface, please email your request support@github.com

And again, you can just as easily access this repository via other interfaces such as command line or any of the multitude of gui git tools. This will solve your issue. And since you are so fond of documentation, I highly recommend going over https://git-scm.com/book/en/v1/Getting-Started

techmach, 2018-07-26:
STEP files are ASCII text but they are not edited by the user like an Arduino file or Marlin file.  They are translated by a CAD translator.  The SW files are corrupt and useless to anyone, even a SW user.   Your example of a model with 1000 holes is a non sequitur since the user will not go into the STEP file and change a value and save the file.  That change will come from a Translator after the model is changed so your premise is very weak.  Try again dude.  Your arguments aren't making it.

The Contributing part is fine for Marlin code but contributing to a production solid model isn't going to work either because let's say that I import the SW files when they get fixed at some point and say that I use Pro E or NX to make changes which is highly unlikely since their face editing tools are minimal to none so those users are left to basically assembling the model in an assembly mode but they can't actually change the BREP's.  There are no translators to translate those native files back to SW so the next file type that I might use is a STEP, IGES, Parasolid or ACIS file.  How is the STEP file going to be generated?  By a translator, not by hand and not at the text level.

I don't know what y'all do for a living but designing or machining isn't it.  Unless your CAD system is capable of hybrid modeling and face editing like ZW or IronCAD editing at the face level is not a strong suite of most proprietary CAD systems like Pro/E, NX or SW, those systems don't like to work with imported geometry.   The majority of users that are interested in a solid model like the Ender 3 aren't CAD professionals with current software that they paid for and up to date, those folks are using free stuff like F360, Freecad, Sketchup or Openscad.

The SW models that Creality provided came from a  2016 version of SW which is now 3 years behind.  SW translators are notorious for how bad they are with STEP translations so keeping the translators up to date is paramount in the manufacturing world.   Why would you want to access STEP files at the character level and seriously mess things up?

shoreliner, 2018-07-26:
Perhaps you should contact Github on their policy for handling these types
of files and proprietary grouping.. .I have a feeling they would be totally
confused.  I've had a full model of the printer since maybe the day after
the cad files were released.... it's aluminum extrusion, is it really that
difficult to generate for yourself for the time being?  I think some
expectations on what open hardware is and what it isn't need to be set....
this is something I will bring up during upcoming AMF meetings that involve
open hardware... I'm not sure if you understand the way Github or similar
repos/hubs work or that this isn't Customer Service. This stuff is provided
AS IS my friend.

shoreliner, 2018-07-26:
Open Hardware is such a new concept; we've only seen it this far in things
like microcontrollers.   Are you truly having a fit over one one of the
first attempts at doing this having some issues?  This is blowing my mind.
I just want you this techmach:  I don't think this community is for you.
Sometimes we cobble things together, sometimes they don't work, sometimes
they fail.. and well, I think you might be too much of a snowflake for that
sort of an environment.  I am truly being honest, you seem to have a very
very "corporate" approach to this, indicated by your constant spouting off
of random pieces of CAD software and acronyms most of the people here don't
know and won't bother to look up.  3d printers are INCREDIBLY simple
machines, and anyone that has been in the 3d printing realm for a while
would choke to anyone this caught up over file structure. lol.

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

techmach, 2018-07-26:
I'm not having a fit.  This is a discussion.  Y'all are missing the point.  I've got the bloody model.  Like shoreline said it's aluminum extrusions.  It took all of 2 hours to put it together in CAD and I did it while I was talking on the phone with an associate.   The issue is file handling and it's real simple; I'll lay it out for everyone.  STEP files are not to be handled like they are ASCII text files.  They don't work like Marlin script files because they aren't generated like Marlin files.

File structure is important especially to Open Source.  I've been playing with these little Stepper motor incarnations for a while now and with CNC's for a lot longer.  Let's say that someone wants to design a new upgrade for their 3D printer.  They download just the affected STEP files they want, import them into their CAD system of choice and voila, they assemble just enough of what they need to prove out the design, create the model, slice it and print it; they have exact data to model from as opposed to getting out a pair of Calipers and scabbing dimensions off of an actual printer.  Isn't that what Open Source allows the owner to do?   In order for Open Source to work you have to have accurate data and the files need to be handled properly.  Just imagine if someone when into a STEP file thinking it worked like a Marlin file changed a bunch of coordinates and the uploaded it for review.  What a time waster.  Now you have a translation file that has no original model to reference.

Don't worry though, the corporate world is coming as soon as the Empire buys this place.  If Linkedin is any indication of what is to come be prepared.  At least the Empire understands how file extensions work and what they mean.

techmach, 2018-07-26:
BTW, STEP files are corporate files just like SW *.sldprt and *.sldasm files.  Marlin files are not.

shoreliner, 2018-07-26:
So now you're warning of the impending takeover of Github by 'The Empire'
-- in case you weren't aware, GitHub is owned by Microsoft.  Open Source
allows YOU, or me, or anyone else to branch/merge and pull/commit these
changes, without requiring the original designer to retain the full
responsibility... this many times results in a number of branches being
created.  Some of these branches may turn into projects all thier own.  As
I had stated previously, the schematic for the missing file was there from
the start; you could have added it and put in a pull request.... but you
haven't taken the time to even learn this environment, let alone the open
source ecosystem as a whole.

If you had, you could have branched the repo, added the missing file,
corrected the assembly, and put in a PR....

Instead, you seem to be 'warning' that soon this concept will no longer
exist?  I mean, do you feel as if somehow it would make sense to 'threaten'
people that contribute their designs? lol... what planet are you from, man?

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

shoreliner, 2018-07-26:
You also seem to be under the impression that github is unable to handle
non-ascii files.. or something like that? It is really unclear.  This is
100% not true and i have absolutely no idea where you got this concept
from.... are you confusing versioning and diffing?

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

francisalbar, 2018-07-26:
The partial file changes are what is relevant to Git, you know, the source control system these files are currently being shared in. Whether it is auto generated or written by hand, source control tracks changes as they happen, when they happen - which, to most users, is important historical reference.

As any of these files are provided "as is", your $180 investment in a 3D printer hardly qualifies the harassment you are engaging on. You either put up, or shut up.

shoreliner, 2018-07-26:
Can you please close this or do you want me to put the model there for you, @techmach ?

techmach, 2018-07-26:
I'm putting up.   I already have the model so save your effort for something more productive.   I didn't post the files here, that's Creality's decision but they are here nevertheless.  I don't consider a discussion as harassment but y'all are welcome to live in the "opensource ecosystem"  for as long as you want.   Schematic's relate to wiring, electrical and electronic representation while Blueprints are related to mechanical drawings.  You should learn the difference shoreline.

<<<"You also seem to be under the impression that github is unable to handle
non-ascii files.. or something like that? It is really unclear.  This is
100% not true and i have absolutely no idea where you got this concept
from.... are you confusing versioning and diffing?">>>  I never said they can't handle non ASCII files, you just said that.    The SW files are fine they are just corrupt because Creality didn't understand the simple concept of Pack and Go.  Github is unable to handle the STEP files properly unless you Zip the whole archive and time will prove that.  Perhaps Creality will see the light and translate their model files to something more corporate to avoid all this nonsense.

Case closed.

Closed 2018-07-26.

Thread 8 (2018-07-16):

Firmware test

TalZiv, 2018-07-16:
Hi,

Did anyone actually flashed the firmware posted in the repo the HEX or the actual files?
Or did some one dumped the firmware from the printer itself and compered it to the HEX?

pyromanci, 2018-07-16:
I've not tired the Hex File, but did try the code after I put the bootloader on the board. Which did work for me.

TalZiv, 2018-07-16:
And everything works fine?, If so this is great news, a lot of people wanted to know that the files are OK.
and have the option to go back to original firmware from marlin.

pyromanci, 2018-07-16:
From what i can tell. I didn't test every feature. It compiled flashed and booted, heated the hot end, and moved it around a little.

Though honestly I wouldn't go back to stock. It's based on Marlin 1.0.X. So it's a bit of pain to flash if you flash anything else. Need to use a different version of arduino (i ended up using 1.0.6), libraries from the Marlin 1.0.X branch, reburn the boot loader from that version of arduino (which was odd), ect ect. and vsersa to back to another copy.

rmcolbert, 2018-07-17:
I have done both. I compiled (after fixing issues caused by newer versions of the Arduino Studio) and everything worked. I also flashed the hex file directly and it went fine as well.

pyromanci, 2018-07-17:
Might be worth while to create a pull request with the fix to allow it to compile with the latest copy of arduino.

Gradimilo, 2018-08-09:
@rmcolbert what version of Arduino IDE did you use ? I'm with a problem in the LCD. The graphics are distorted. I had try Arduino IDE to 1.6.8 version, change u8glib version, compare with others marlins versions and nothing has worth.

rmcolbert, 2018-08-14:
I used Arduino 1.6.8 but had to downgrade u8glib for the graphics to work.

Stev-O95, 2018-10-19:
Hi,

i would like to Update my Ender 3 by using the "Ender-3-Power-Fail-Resume-EN.hex" file by using Octoprint running on my raspi. Thanks for the help.

rmcolbert, 2018-10-19:
>           Hi,
> i would like to Update my Ender 3 by using the "Ender-3-Power-Fail-Resume-EN.hex" file by using Octoprint running on my raspi? Thanks for the help.

You will need to install the bootloader to use the .hex file if you haven't already done so.

steenerson, 2019-12-11:
Closing out this old issue, the firmware source+hex have been updated to 2019-04-26 version and compiles on latest (1.8.10) Arduino as-is.

Closed 2019-12-11.

Thread 9 (2018-07-16):

Marlin not possible to verify in IDE

2000game, 2018-07-16:
I tried to verify and upload your Marlin version via the 1.8.5 and the 1.6.5 Arduino IDE. However I get this error. (I have the newest version of u8glib via the Arduino Library Manager installed.)
`
In file included from dogm_lcd_implementation.h:38:0,
                 from ultralcd.cpp:36:
dogm_font_data_marlin.h:12:25: fatal error: utility/u8g.h: No such file or directory
 #include <utility/u8g.h>
                         ^
compilation terminated.
Error compiling.
`
After that I tried to create a utility folder in the src folder of the library. I put there the u8g.h file.
`
Cannot run program "C:\arduino-1.6.5-r5\hardware\tools\avr\bin\avr-gcc" (in directory "."): CreateProcess error=206, The filename or extension is too long`

Now I'm getting this error. Did anybody got these errors as well?

2000game, 2018-07-17:
Thanks that worked for me.

Closed 2018-07-17.

Thread 10 (2018-07-26):

wrong file name ?

joewulf, 2018-07-26:
Ender-3/Ender-3 Mechanical/Ender-3 Parts/40-42 motor.SLDPRT
should be
Ender-3/Ender-3 Mechanical/Ender-3 Parts/42-40 motor.SLDPRT ?

steenerson, 2019-12-11:
Hi, thanks for the report! I have updated the filename, closing this out.

Closed 2019-12-11.

Thread 11 (2018-07-26):

wrong Qty on Ender-3 BOM.XLS?

joewulf, 2018-07-26:
400201001 | 42-34 Motor | JK42HS34-0844YA-03F | PCS | 3
400201004 | 42-40 Motor | JK42HS40-1004AC-01F | PCS | 1

should be

400201001 | 42-34 Motor | JK42HS34-0844YA-03F | PCS | 1
400201004 | 42-40 Motor | JK42HS40-1004AC-01F | PCS | 3

steenerson, 2019-12-11:
Hi @joewulf, only the extruder has a 40mm motor while the XYZ motors are 34mm, the BOM is correct. Closing this out

Closed 2019-12-11.

Thread 12 (2018-08-06):

Thosiba FashAir not work in the ender3. seems need more power in the microsd slot

sl1pkn07, 2018-08-06:
Hi

I want add the Toshiba FlashAir W-04 16Gb (Wifi module + SD card)

https://www.flashair-developers.com/en/discover/overview/

 in the ender3 with this microsd/SD adapter

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

the SD part is read OK (formated in FAT32) in the printer, but whe wifi module seem need more power signal. because the module is never active due a low power signal from the microsd slot (tested with PC/camera with/o external card read. all work OK. but in the ender 3 the wifi never activate (i can't ping to the unit)

is possible, in the new revision of the board. add support for this type of SD?

how i can add support/hack for this card in the actual 1.1.3 revision of the mainboard?

datasheet
https://www.toshiba-memory.com/products/toshiba-wireless-sd-cards-flashair-w-04/?pdf
http://www.geocities.jp/bokunimowakaru/diy/arduino/flashair.html (japanese, extracted from https://www.flashair-developers.com/en/support/forum/#/discussion/70/power-requirements-for-cards)

greetings

RudolphRiedel, 2018-08-17:
The boards design is generally flawed in this aspect since the SD-Card is powered by the internal LDO of the FT232RL which ihas a nominell output current of 50mA.
This is not even enough for reading from some cards,.
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

In order to hack this one would need to cut the highligted trace and connect an additional 3.3V/200mA regulator to it.
I would cut it on the top side right before C31 and connect the 3.3V to C31.

>how i can add support/hack for this card in the actual 1.1.3 revision of the mainboard?

Wait, what? There is a 1.1.3 out?
The picture is from the 1.1.2 data.

sl1pkn07, 2018-08-17:
Hi

yep. my ender comes with the 1.1.3 revision of this board

you can see one here https://www.amazon.com/Creality-Original-Mainboard-Replacement-Control/dp/B07FYJVW1M

RudolphRiedel, 2018-08-17:
Just looking over the pictures and the V1.1.2 data I have no found any differences so far.
There must be some but at least it is safe to say that these are very similar.

sl1pkn07, 2018-08-21:
with regulator, you mean something like this? (stepdown)

https://www.banggood.com/es/Mini-AIO-DC-DC-Step-Down-Module-4_5-24V-Integrated-Adjustable-Fixed-Voltage-Multirotor-Spare-Part-p-1284818.html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

RudolphRiedel, 2018-08-21:
Basically yes, but I would not recommend this module or any else since I normally do not use pre-assembled modules, I like to design my own boards and I like to be the one beeing responsible in the odd case something goes wrong. :-)

RudyFiero, 2018-08-22:
That power supply in your banggood link is expensive. You could use this instead. https://www.banggood.com/Small-Mini-360-Adjustable-DC-Power-Supply-Module-Mini-Step-Down-Module-p-917568.html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

I have designed that into some of the products at my work. We have used more than 500 so far. It is a good voltage regulator.

You need to adjust the voltage before you connect it to a circuit. We replace the potentiometer with a fixed resistor so that our customers will not alter the set voltage.

RudolphRiedel, 2018-08-22:
Well, it does say "Input voltage: DC 4.75V-23V" but the Ender-3 has a 24V PSU, doesn't it?
I would go with a 30V rating at least.
And since the cheap modules tend to have high ripple voltages on the output I would test it first outside of the circuit I would like to connect it to.
That second module does look to me like they cheaped out on components, especially with the capacitors.
By testing I mean adding resistors to the output for the max load I expect and checking with an oscilloscope what the voltage looks like.
Would really not suprise me to see ripple in excess of 500mV on the second module.

RudyFiero, 2018-08-22:
@RudolphRiedel  Why would you use 24 volts when there is 12 volts readily available?

> That second module does look to me like they cheaped out on components, especially with the capacitors.

The capacitors look small but they are 10uF.  Considering that the switching frequency is 340KHz the are adequate. If more filtering is needed then it can be added but for the purpose of powering the FashAir, it would not need more.

> Would really not suprise me to see ripple in excess of 500mV on the second module.

Why would you expect that, do you know how switching regulators work?  The peak to peak ripple is  60mV at 5.2 volts. With the output set for 3.3 volts the peak to peak ripple is 42mV.  That was at 1/2 amp output. That doesn't change much with variations in load.

The data sheet for that part is here. https://www.mouser.ca/datasheet/2/277/MP2307_r1.9-1384272.pdf

This is a very good synchronous buck converter. The inductor used on the module is very good. The only issue I have is the edge or the board is so close to the connection holes that they is little structural strength. So you need to be a little careful if you use wires connected to it and you are going to flex things.

I first bought some of these for my own projects. I was so pleased with it that I designed it into a number of products at my work. It was cheaper to buy the modules and populate it as a through hole part than to buy the components and implement the parts as part of the surface mount assemblies. In one design I did need to integrate the converter as part of the surface mount stage. I needed access to the enable pin of the regulator chip.

The cost of this module is low but it is in no way a "cheap" design as far as performance is concerned. The only thing I have changed is removing the adjustment pot and set the voltage with a fixed resistor. This is so electricians can not adjust it and screw things up.

sl1pkn07, 2018-08-22:
> @RudolphRiedel Why would you use 24 volts when there is 12 volts readily available?

the ender 3 use 24v output power supply

RudolphRiedel, 2018-08-22:
>Why would you expect that, do you know how switching regulators work?

Because I have seen enough of cheaply made crap already.
And note, not saying that this one is, just saying to be generally cautions with switching regulators, especially inexpensive ones.

RudyFiero, 2018-08-22:
@sl1pkn07
> the ender 3 use 24v output power supply

I have not received my printer yet. In transit. I saw the silk screen layer marked as 12 volts so I though that was present. If there is not 12 volts then my preference would be to use an available +5 volt supply (assuming 5v is used by the CPU) to generate a 3.3 volt supply. I would prefer not using a higher voltage supply that drives motors to generated a low voltage, low current supply.

sl1pkn07, 2018-08-22:
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

RudolphRiedel, 2018-08-22:
And I would not add annother 150,mA+ load to the 5V supply.
The PSU can take it, especially since a switching regulator reduces the 200m@3.3V to about 30mA@24V.
But can the regulator on the controller-board take the additional load?

RudyFiero, 2018-08-22:
It really would help if they released the schematic.

sl1pkn07, 2018-09-06:
Its working!

Pics later

Greetings

sl1pkn07, 2018-09-14:
hi,

bad news. i have notice freezes in the printer like when unplug the SD card durning print

also have notice between C31 and stepdown output have 4.00v+/-, but if unplug the stepdown output wire from the mobo (welded in the C31) , and test the stepdown output without load, have 3,3v

then i back the mobo to start point, and again have notice the C31 to GND is 4.00V!

now in test unweld the pin 4 in the microsd/sd external adapter and connect the stepdown output in it. the voltage is now 3,3v, and the flashair unit work, at te moment, without problem (need test more more time)

greetings

Pointer-de, 2018-12-09:
@sl1pkn07
Hi. I use the Flashair W-04 16Gb on my CTC Bizer printer, so I want to use it on the Ender3 as well. Can you already say something about your long-term test with the Flashair?

sl1pkn07, 2019-05-26:
sorry. i'm switch to Re-ARM+Ramps some time ago (still work in progress)

greetings

probonopd, 2019-06-30:
A working alternative is https://github.com/probonopd/WirelessPrinting (if you can find a way to connect to RX and TX on the Creality PCB). It uses an ESP8266 or ESP32 for wireless printing. More flexible and much cheaper than a FlashAir.

sl1pkn07, 2019-06-30:
yes, but very very very (y say very?) very slow in file transfer (because the transfer is via serial protocol)

RudolphRiedel, 2019-06-30:
Why would it be painfully slow?
As with Octoprint the serial connection is used to send gcode commands, not to transfer files.

sl1pkn07, 2019-06-30:
becausei don't want any external thing control the printer/prints

probonopd, 2019-06-30:
@sl1pkn07 the software i linked is not slow at all, it streams the gcode to the printer line by line as it is being printed. It does not transfer the file to the printer's SD card.

sl1pkn07, 2019-06-30:
yes, know how works that soft, like the soft i use (ESP3D) and the knowed pronterface. but i dont whant that

i principal use the flashair because i what tharnsfer the files to te print without phisical conenction (the printer is in other room), and the flashair do it flawessy. the ESP-01 unit (with ESP3D) is used only as brigde between pc and the printer only on few cases i need send codes manually

probonopd, 2019-06-30:
Then software I linked works different than ESP3D. It uploads the gcode to the ESP or an SD card attached to the ESP (fast), then you don't need the WLAN connection anymore as it sends the gcode to the printer.

sl1pkn07, 2019-06-30:
both can able send gcode trougth the esp (ESP aso can send codes/control the printer directly from the ESP, wifiprintoing needs slicers (no simplify32 :(). i not need both of that funcionality, only need a simple serial bridge com port over wifi, like the HC-05/06 can do (but over Bluetooth stack). ESP3D include it, wifiprint i'm not sure

siochs, 2019-12-02:
Those FlashAirs are quite expensive and my research lead me to this issue here.
However, on [this blogpost](https://www.instructables.com/id/3D-Printing-Over-SD-Card-Wi-Fi-Hack/) they wrote that the WiFi feature is only be enabled when you start writing to the FlashAir. But Marlin never writes to the sd card thus leading the WiFi disabled.
A guy named gearsawe commented something I found very promising and may I am be so bold to cite him here:

> So if your printer is running Marlin and you don't feel like messing with editing firmware you may be able to get this to work by using marlins auto run feature. First edit the file on the SD card as instructed above then make a file in the root of the SD Card named auto0.g ,(that is a zero after auto) edit the file and put the following 3 lines.
M28 EnableSD.g
G0 X0
M29 EnableSD.g
this will write one command "G0 X0" to a file named EnableSD.g which would effectively cause the card to enable the wifi.

Could someone please verify if this workaround also works with the Ender3 and the FlashAir? Probably the problem observed here was never related to insufficient power supply?

sl1pkn07, 2019-12-02:
Is problem of the power supply, with the external DC, or with other board, like the ReARM i now use, all works as expected

siochs, 2019-12-02:
I was aiming for a solution without hacking/replacing hardware parts. Something like this may also work in combination with a Raspberry Pi:
* [sd card multiplexer](https://hackaday.com/2014/06/08/the-in-circuit-sd-card-switch/)
* [sd wire](https://wiki.tizen.org/SDWire)

sl1pkn07, 2019-12-02:
remember, the power supply for sd port in the creality boards comes from the FTDI chip, which can output only 50mA

https://www.ftdichip.com/Support/Documents/DataSheets/ICs/DS_FT232R.pdf
(pin 17, 3v3out)

RudolphRiedel, 2019-12-02:
And with the new boards they made it worse by switching to a CH340 which does not even have a 3.3 regulator with a current rating but just a reference output.

siochs, 2019-12-03:
Took a look into the pcb files and your fotos. I acknowledge the design flaw. My ender 3 is recognized as CH340 from the kernel. My goodness... My suggestion would be to interrupt Vcc in the SD adapter cable, but I saw you already did that...
> now in test unweld the pin 4 in the microsd/sd external adapter and connect the stepdown output in it. the voltage is now 3,3v, and the flashair unit work, at te moment, without problem (need test more more time)

sl1pkn07, 2019-12-03:
Boards 1.1.4 and 1.1.5 i remember have CH340 instead of FTDI chip

GayCavalier, 2020-07-04:
So here's the lazy-man's solution...    I found a 'plug-in' type DC transformer and set it to 3.3V (supplies up to 2000mA), snipped the end off and wired it directly into the SD>Micro-SD adaptor board.

When viewing connectors facing you, from the left:
Ping 4 is +3.3VDC supply
Ping 6 is GND.

One thing I like about it is that the Toshiba FlashAir drive is still powered and accessible on the network even when the Ender 3 Pro is powered-down.

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

RudolphRiedel, 2020-07-05:
At least cut the 3.3V that is going thru the adapter into the board.

siochs, 2020-07-16:
I also experimented with this micro sd adapter (was it from cablecc?) when i tried to switch between the ender and the raspberry using a relay.

Unfortunately, it seems the FlashAirs are discontinuoued. What is left on the market is extremely expensive.

I was so annoyed by this I built my own WiFi enabled SD card with an ESP32. [See here](https://github.com/siochs/ESP-ShareDisk)

sl1pkn07, 2020-07-16:
Bigtreetech have this https://www.aliexpress.com/i/4000991425856.html

siochs, 2020-07-16:
Dude, you don't know how long I was searching for solutions like those you posted and did not find them. However, I had the parts lying around and learned a lot ;-)

sl1pkn07, 2020-07-16:
that solutions is released from may or june in this year

RudolphRiedel, 2020-07-16:
What is the point of these anyways?
I mean I still need to go the printer and start the print-job from "SD-card".
And at least with the original Ender-3 boards you either need to modify the board or supply these cards externally somehow.

siochs, 2020-07-18:
> What is the point of these anyways?
> I mean I still need to go the printer and start the print-job from "SD-card".
> And at least with the original Ender-3 boards you either need to modify the board or supply these cards externally somehow.

Not with my solution, hit "Autoprint" and toggle your printer power from remote using an intelligent switch. You know Marlin's auto0.g feature do you?

RudolphRiedel, 2020-07-18:
> You know Marlin's auto0.g feature do you?

I did not but I guess this makes this a whole lot more interesting.

siochs, 2020-07-27:
Just saw there is a new version of the Ender-3 on sale (https://www.creality3dshop.eu/collections/ender-series-3d-printer/products/creality3d-upgraded-ender-3-v2-3d-printer). They probably fixed the 3.3V power issue on the SD slot? Didn't find a PCB layout so far...

RudolphRiedel, 2020-07-27:
I found a picture of the 4.2.2 that is used in the Ender3-V2:
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

They are apparently using a 2A step-down converter for the 5V, followed by an ANS1117 for the 3.3V.
Oh yes, they went 32 bit, there is a STM32F103 on the board, so the 3.3V for the SD-card *should* no longer come out of the CH340 they are also still using.

That does not mean though that the board works flawlessly with a WLAN card but it is not looking bad either.

Thread 13 (2018-08-09):

LCD graphics are distorted

Gradimilo, 2018-08-09:
I download the firmware and I use de arduino IDE to upload de files to ender 3, but the LCD screen are distorted and its almost impossible to read the lines. I tried others IDE versions, others u8glib versions and nothing has work.

At others Marlins versions (news) the LCD works fine.

bmcdaniel74, 2018-12-17:
I have the same issue. Has anyone else experienced this?

Snakefreak, 2018-12-20:
I have a Workaround remove the LCD with bezel. Try out. Mount mine with pla printed bolts and washers.

tkuan, 2019-02-22:
I just want to post this solution for anyone has scrambled LCD problem. I got it resolved by commenting out #pragma GCC optimize (3) in ultralcd_st7920_u8glib_rrd.h file.

steenerson, 2019-12-13:
Thanks for posting the fix, I believe this was fixed by an arduino/library/firmware update along the way as it works now without that line commented out. Closing out this old issue.

tkuan, 2019-12-13:
Sent from Yahoo Mail for iPhone

On Friday, December 13, 2019, 1:06 AM, steenerson <notifications@github.com> wrote:

Thanks for posting the fix, I believe this was fixed by an arduino/library/firmware update along the way as it works now without that line commented out. Closing out this old issue.

—
You are receiving this because you commented.
Reply to this email directly, view it on GitHub, or unsubscribe.

Closed 2019-12-13.

Thread 15 (2018-08-27):

firmware upload ender 3 - Cura 3.x Updates

Dexsys, 2018-08-27:
Please make Cura 3.x instructions for update new firmwares. Inglish / Spanish

steenerson, 2019-12-13:
@Dexsys there is no normal way to update Ender firmwares through Cura, you must use Arduino or a similar platform to compile/load firmware. Closing out this old issue.

Closed 2019-12-13.

Thread 16 (2018-08-28):

Motor Manufacturer? / Motor SLDPRT seem corrupted

GerOTEC, 2018-08-28:
Hello! / 您好!
I work for a company in Germany, where I lead the development of a new prototype.

I recently bought an Ender 3 and was astonished by the precision of the motors, so we wanted to try some of them out for a new prototype (no 3D Printer, it's a measuring-device with an XYZ-table).
Unfortunately, I can't find the motors anywhere on the Internet, nor the manufacturer.

Also, the files for the motors seem corrupted, it doesn't work for me on various programs.

Is it possible to get this Information? Would be very happy about it!

谢谢 and greetings from Germany,
Jan

wqh227, 2020-04-22:
You can buy it from Taobao China.

Thread 17 (2018-09-04):

Error with U8glib on Mac OSx

RoCoUT, 2018-09-04:
So the only error that I am getting is the following:

sorry - this program has been built without plugin support
Using library U8glib at version 1.18 in folder: /Users/xxxxxxxx/Documents/Arduino/libraries/U8glib
exit status 1
Error compiling for board Sanguino(1284P Boards).

Is their a plugin that will work on Mac and can someone direct me to it?

sl1pkn07, 2018-09-15:
more log please

WesselWessels, 2018-09-18:
You need v1.17 of U8glib.

steenerson, 2019-12-11:
Closing out this old issue, feel free to open a new one if this is ongoing.

Closed 2019-12-11.

Thread 18 (2018-09-05):

Upload with USBtinyISP: Version of Arduino IDE

mrsashh, 2018-09-05:
On newer versions of arduino ide were a bunch of problems loading the firmware. When I used v. 1.0.6, the firmware loaded flawlessly and is working nicely.

Closed 2018-09-07.

Thread 19 (2018-09-20):

Extrusion Fan doesn't automatically turn off when below 50'C

steckdev, 2018-09-20:
Based on my studying I believe this is caused by the EXTRUDER_0_AUTO_FAN_PIN not being set properly. Please let me know if anyone else has this issue and hopefully we can find a quick resolution to this.

https://github.com/Creality3DPrinting/Ender-3/blob/master/Ender-3%20Firmware%20(Marlin)/Ender-3%20(includes%20power%20failure%20resume-%20English)/Marlin/temperature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

Here is where these are set to "-1" and then just ignored in the temperature.cpp
https://github.com/Creality3DPrinting/Ender-3/blob/f903950df9f815ba03f5acf2b0ec9a39e31f2589/Ender-3%20Firmware%20(Marlin)/Ender-3%20(includes%20power%20failure%20res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

Please refer to these files and articles for more information:
https://github.com/MarlinFirmware/Marlin/issues/3234

pusewicz, 2019-05-31:
Yeah, I have the same problem.

buitre-buitaker, 2019-05-31:
The extruder fan is directly connected to the main power rail of the PCB.

steenerson, 2019-12-11:
Hi @steckdev, @buitre-buitaker is correct that the extruder fan is always powered and there is no hardware support for marlin to be able to control it. Closing this issue.

Closed 2019-12-11.

Thread 20 (2018-10-04):

Profiles for Cura 3.x and Slic3r

probonopd, 2018-10-04:
Please post profiles for Cura 3.x and Slic3r.

The profile on the microSD card that comes with the printer is for an outdated version of Cura.

Trying to [import](https://ultimaker.com/en/resources/21341-old-cura-profiles-in-new-version) it into Cura 3.4 results in

> File Ender 3.ini does not contain any valid profile.

jewirth, 2018-10-05:
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

Nice! But why has the Extruder Diameter been set to 2.85 mm when using the Ender-3 in Cura?

probonopd, 2018-10-05:
@jewirth possibly this is a bug. I think 2.85 mm is the global default in Cura, so machine profiles that use 1.75 mm need to specify that.

Reference:
https://github.com/Ultimaker/Cura/issues/4468#issuecomment-426884623

probonopd, 2018-10-08:
Some Slic3r profiles are here: https://github.com/sn4k3/Ender3

probonopd, 2018-10-11:
Simplify3D profile by [Nerys](https://www.youtube.com/channel/UCusgqRXg90d7Nau1rqa4WqQ) at https://drive.google.com/drive/folders/0B-XVTPUBrxzwRTVmM0Fwd3hDblE

scruss, 2018-11-10:
If you use Cura 15.04 or CuraEngine with OctoPrint, here's a default profile extracted from `test-dog.gcode` (aka MakerBot's [Niko the Puppy](https://www.thingiverse.com/thing:220609)) on the Ender 3 SD card: [scruss/Ender3Cura15.ini](https://gist.github.com/scruss/63ce52b7057b3802d6b7824c9e788318)

You'll still need to set the printer size (220/220/250), nozzle diameter (0.4) and enable bed heating.

probonopd, 2018-11-10:
Now, how do we convert this to today's Cura? @scruss

scruss, 2018-11-11:
You don't need to: Cura 3.5 includes Ender 3 support directly. If you're meaning CuraEngine, I don't know. only ever used the older one that works with  OctoPrint

joelhuebner, 2019-03-31:
OctoPi uses the 15.0.4 Cura engine. I've downloaded the full 15.0.4 app & built "a profile" that I then imported into OctoPi. It seemed to work, but I'm going to troll the other profiles listed here & see what I can build.  I'll post my results! I'm building a profile for an Ender 3 Pro and a Monoprice Mini v.1 (which I may gut & put an opensource board in it) a piece at a time re-build.

karl0ss, 2019-04-01:
> OctoPi uses the 15.0.4 Cura engine. I've downloaded the full 15.0.4 app & built "a profile" that I then imported into OctoPi. It seemed to work, but I'm going to troll the other profiles listed here & see what I can build. I'll post my results! I'm building a profile for an Ender 3 Pro and a Monoprice Mini v.1 (which I may gut & put an opensource board in it) a piece at a time re-build.

Can you post your Ender 3 Pro profile for the CuraEngine please?

joelhuebner, 2019-04-14:
find the profile above...

steenerson, 2019-12-11:
I have added the latest SD card contents to the repo. Newer versions of Cura support Ender 3 out of the box and older ones can use the profile from the SD card - closing this out.

ZoomDomain, 2019-12-31:
Here's a video with a link to 8 ender 3 profiles for prusa-slicer https://www.youtube.com/watch?v=wnJ24KTBF7U and he sais there's one on thingiverse too

Closed 2019-12-11.

Thread 24 (2018-11-07):

Z support in the X axis (X, extrusor and Z nut piece) is missaligned

sl1pkn07, 2018-11-07:
vid of the issue and fix: https://www.youtube.com/watch?v=xnzNd_FIMKY

PS: i'm not the autor. all credits to https://www.youtube.com/user/RonaldWalters47

Thread 25 (2018-11-26):

(Missing) Universal LCD 12864 3D Printer Display PCB Diagram

LeonVolta, 2018-11-26:
Would it be possible to have the PCB and Wiring Diagrams for the Universal LCD 12864 3D Printer Display uploaded? As far as I can tell they are currently missing from the supplied files, although the Ribbon Cable and Display Mount has been included.

Thread 26 (2018-12-21):

Mosfets for hotend and bed

Astra-arch, 2018-12-21:
Hello. There are 3 of mosfets in datasheet named SOT-252 (D522), but I can't find them on the internet. Maybe some replacement? If Somebody got them please give a link or replacement models. Thanks!

Lion5608, 2018-12-21:
Hi, use IRF522, there are plenty of them available.
_Merry Christmas._

RudolphRiedel, 2018-12-21:
These are named REP30N06LE in the PCB file.

Astra-arch, 2018-12-25:
Thanks, but found only R**F**P30N06LE and it's 60V.
On the body of mine, there is an Alfa&Omega Semiconductor logo and D522P marking.
There is AOD522P and it's 30V N-Channel AlfaMOS in Alfa&Omega Semiconductor's data sheets
Going to replace it with IRF3707ZS
Thank you all for the reply

draugnim, 2019-02-13:
Hi. I have a similar problem. Today my new all metal hotend from AliExpress arrived and I swapped it with the old one. While replacing it I disconnected the old one from the motherboard and when moving the bed or other axes I noticed that the display lights up. After I put everything together there seemed to be no problem. I starded the printer and everything was ok, put when I hit 'Prepare PLA' the nozzle satrted warming up but would exceed the set temperature and throw a max temp error. Sometimes it would start to drop the temperature before reaching the max temperature and throwing a error.
So, did the induced voltage from the steppers that was generated from me moving them  killed the mosfet while the heater was disconnected?
I'll post a video of me testing the mosfets with a multimeter when it's done uploading. It seems that all 3 of them are gone, but my bed was working just fine.
@Astra-arch  Did you had any success?

Astra-arch, 2019-02-15:
Hi. In my case it was hotbeds mosfet with burned diode (bed started heating without any control after turning on the printer ). I've just replace broken mosfet and it works fine now. Moving parts can generate voltage that can kill drivers not temp. mosfet, I think.

draugnim, 2019-02-15:
@Astra-arch Thanks for the reply. Yes, I checked all three mosfets with an ESR Meter and all of them are dead. I think that static electricity killed them. So you ended up using IRF3707ZS?

Astra-arch, 2019-02-18:
IRLR3103PBF, 30V 46А [D-PAK]

draugnim, 2019-02-18:
@Astra-arch I have a IRLR3705Z at hand. Do you think it would be an adequate replacement. I would really appreciate if you could take a look.

https://www.tme.eu/gb/Document/17c174c6b2956661b95edec73a0e835d/irlr3705z.pdf

cooldoodsm, 2019-03-12:
@draugnim From my experience with building switching power supplies (a dozen or so, so far--I'm not an expert), I think it would be a problem.

I'm new to stepper motors, but from what I've researched so far, the _frequency_ has to be varied in order to change their speed (unlike plain old DC motors, which can have their speed adjusted by the _duty cycle_). Assuming the duty cycle stays the same, this will affect the amount of time your FET is able to be on and conducting current without breaching the safe operating area (SOA) limits.

The original FET can handle a lot of current at 25V (rounded up for easiness of calculating). It's relatively linear in terms of derating, at all the different pulse lengths.
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

Compared to the above (original FET), the one you suggest has bad current ratings at the longer duration end of the pulse widths, and it's also not very linear. You may breach those limits and end up burning the FET.
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

If only the SOA curve was similar, you would have been good to go.

RudolphRiedel, 2019-03-12:
Well, the Hotend and the Bed are resistive heating elements and not steppers or swiching power supplies.

And since these are pulsed with very low frequencies, typically below 10Hz or are even switched on for minutes at start, what really matters for a FET is the RDSon.
The switching losses can be neglected.

If the original FETs really are RFP30N06LE (and we do not know because Creality does not tell), then these have a RDSon of 47mR.
The suggested IRLR3705Z have 8mR.
The bed draws about 8A, probably less.
That makes 3W for the original FET and 0.5W for the IRLR3705Z.

cooldoodsm, 2019-03-13:
Apologies! overlooked the detail about it being the hotend.

You're right, it's possible that it's drawing pure DC until temperature is reached. According to Google search, the hotend for the Ender 3 is rated 24V, 40W. PSU is 24V, so the hotend will draw at most 1.67A of current (easy enough to handle for many power MOSFETs at continuous DC).

_Most_ FETs aren't meant to be operated at high continuous DC currents at _higher_ voltages, according to their SOA curves. With that being said, I would be cautious and use a FET that can handle continuous DC current. Here's an example of a FET that can handle ~2A continuous at 25V, see page 3 (and really inexpensive too, 30 cents USD): https://www.arrow.com/en/products/tsm090n03cprog/taiwan-semiconductor

draugnim, 2019-03-26:
I replaced the MOSFETs and it is working again. But as it turns out the hotend is also bad. I had to put back the old hotend. The new one has trouble keeping the temperature stable. It constantly shifts +- 5 to 10 degrees Celsius. I don't know if it is the heater or the thermistor.
in the meantime, the the AOD514 (the original ones) MOSFETs that I ordered online arrived, but I'm gonna keep them as spares for now.

steenerson, 2019-12-11:
@draugnim when you replace the hotend, usually you also need to run PID tuning or else the temperature can overshoot/oscillate like you describe. If PID tuning doesn't fix the oscillations, check that the heater and thermistor screws are tight - bad mechanical connections will increase overshoot.

The bed+hotend mosfets on my 1.1.4 board are also Alpha Omega but marked I4144 / GA2515 which I'm not finding the datasheet anywhere. Wouldn't be surprised if they change it frequently since almost any logic level mosfet with low RDSon that can handle 24V and amps should work fine... The IRLR3705Z ones mentioned above should work fine.

Closing this issue

Closed 2019-12-11.

Thread 27 (2018-12-30):

Schematic for the Controller-Board

RudolphRiedel, 2018-12-30:
I gave up on pushing Creality for the Schematic of the controller-board but that does not mean that I stopped caring.
And recent remarks by Naomi on Youtube regarding the Ender-3 still left me a bit angry.

So today I sat down and did my own version of the schematic by building an Ender3.SchLib piece by piece, assigning the footprints used and building it from scratch following the data in the Ender-3.PCB.

https://github.com/RudolphRiedel/CR-10_wiring/blob/master/Ender3_schematic.PDF

Yes, it is not finished yet.
But what has been implemented yet should be accurately reflecting the state the CR-10/Ender-3 board is in - including quite some things I would like to see corrected.

RudolphRiedel, 2018-12-31:
Okay, I just updated that .pdf and now it should be complete.
I also tried to make it more readable.

I am down to this:
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

The 10 nets that AD reports to be removing do not show up at all on the board.
There is no bit of copper for any of these ten nets, these do not exist in the board.

One component without a name is removed.
Yet nothing seems to be missing after removing it.
Unfortunately there is no way to display a component without a designator as these should not exist in the first place.
There were more but I found the three unpopulated jumpers at the FETs and renamed them in the board-file to JS1, JS2 and JS3.

The components comments that are changed are for components which have just "Comment" in the comment field and I did not even change all of them.

The change of component parameters are for U8, the micro.
I added two parameters that hold information of what this actually is since "AEMEGA44A" felt so odd.

The added net "Net1k_1" is for the resistor "R1-1" and "LED2" which someone just patched into the board like he was using Paint.

This is a complete Altium Designer project with all the files necessary to make it a project.

Lion5608, 2019-01-01:
Hello and many thanks. It is useful. However, few of us are using Altium designer. We will be stick to use annotated .pdf files. Could you evaluate to use circuit designer or similar in the future?

RudolphRiedel, 2019-01-01:
Okay, for some reason Altium Designer keeps destroying my .pdf files and I tried AD17, AD18 and AD19.
And on top of that I uploaded a file under the wrong name yesterday.

Now this should be fixed, the linke above points to a .pdf that I created with CircuitMaker (after a couple of tries).
Let me know if you find something funny.

And poking around on Github I also found this:
https://github.com/Creality3DPrinting/CR-10
https://github.com/Creality3DPrinting/CR10-Melzi-1.1.2

Very much apreciated these have schematic files.

Makes me wish I had seen this earlier. :-)

Lion5608, 2019-01-02:
Interesting, many thank's. I plan to replace the original board with some better one during the 2019 year. But this is depending on amount of time available :)
I will watch the development closely. If anyone has a good board for ENDER 3 suggestion please post.

RudolphRiedel, 2019-01-02:
An upgrade would be nice, even if it would be only for more program-memory.
But I have not found a board that I really would like to buy.

Maybe we will see some more 32 bit boards in 2019.
I would be in the market for something simple but powerfull, based on the 64-Pin Version of the SAMD51 perhaps.

jgueydan, 2019-01-12:
The Melzi schematic has the motors showing completely different connections than the one you made...trying to wire up a new motor and can't seem to get it working. Thanks for your work on this!

RudolphRiedel, 2019-01-12:
The header J5 clearly shows that the provided "CR-10 Schematic.pdf" is not for the V1.1.2 version of the board but for the earlier revision that did not have a revision printed on the silkscreen.
The V1.1.2 board does not have the jumper to switch 5V from VREG_5V to USB.

This may explain why every component has a different name and almost all headers have their polarity reversed.
In any case, the "CR-10 Schematic.pdf" Creality provided is not the source file, even more so as it is not in binary form but only a picture.

RudolphRiedel, 2019-01-16:
Apart from adding it to CircuitMaker here:
https://workspace.circuitmaker.com/Projects/Details/Rudolph-Riedel-2/Ender3controller-board
I did only release the .pdf so far.

I am still waiting for any response from Creality on this.
But it looks like they left us again after dumping annother bunch of files on Github, that much for "building a community around the repository"...

I give it a few more days then I'll upload the whole project to a new repository.

picman100, 2019-01-16:
Ok , i can defo help to verify it and check the project over, then im going to make some changes and re-up it..

RudolphRiedel, 2019-01-16:
Well, verify, the schematic matches the board file now.
The board file needs fixing though.
And then some. But that would end up in a new board and I do not pick up here that anyone would apreciate the effort.
So for now, my main focus is on repairability.

RudolphRiedel, 2019-02-01:
I put everything here: https://github.com/RudolphRiedel/CR10-Melzi-1.1.2

svenyonson, 2019-04-16:
> Interesting, many thank's. I plan to replace the original board with some better one during the 2019 year. But this is depending on amount of time available :)
> I will watch the development closely. If anyone has a good board for ENDER 3 suggestion please post.

I upgraded my Ender 3 with a Duet 3D WiFi. OMG, what a difference. Gone is the display and that painful interface, and a nice web based UI in its place.  But one HUGE difference is the super quite stepper drivers. Yes, $169 is a lot to spend on a $180 printer, but now I have a very, very nice small footprint printer that is now my main printer. Another reason I upgraded was for dual extruders, which I now have, using an E3D chimera which combines two hot ends into one heat sink. A surprisingly easy upgrade.

You can find bolt on extruder mounts on AliExpress
that are exactly designed to mate the chimera to the Ender 3 / CR-10.

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

You can see that I printed an endcap for the left bottom rail and then moved the controller case forward. The Duet controller fits nicely in that box with a few mods (drill/file)

svenyonson, 2019-04-16:
Sorry, github likes to turn pictures upside down

thetazzbot, 2019-12-28:
Ender 3 board uses ATMEGA1284P, your schematic says atmega44..

RudolphRiedel, 2019-12-28:
Yes, I forgot about the old version that I put in https://github.com/RudolphRiedel/CR-10_wiring, thank you.
I just replaced it with a renamed copy of "CR-10 Schematic.pdf" from https://github.com/RudolphRiedel/CR10-Melzi-1.1.2

And yes, I messed up the commit message by writing the file came from https://github.com/RudolphRiedel/Ender-3 ...

funkypawz, 2020-11-16:
Hey, can you please suggest how I can get the text from the LCD screen as an output, which I can then convert to speech via TTS on an arduino (or something)?  I have a group of blind people with whom I work, and I want to make the Ender 3 accessible to them.

wjsteele, 2020-11-16:
It might be better to go to the Marlin github and ask them, as Creality didn't write the base firmware.  But, there is a text file for each language that the code "points" to when it needs to display some text.   My guess is you'd have to add some type of hook to it and then stream that text out to the serial port in order to process it with anything.

It might be better to go a different route and simply use OctoPrint to control the printer, as it's already a web based app and standard Windows/Mac assisted technologies already work with the browsers, so no modifications to the firmware or the electronics would be necessary.

Thread 28 (2019-01-11):

Fusion 360 file produced

Avaviel, 2019-01-11:
Hi,

I was having trouble opening the mechanical files in Fusion 360. They all needed to be converted by the program before they would work, and that took a few days. However, I now have a Fusion 360 compatible file that could be uploaded. I do not have the authority to upload it myself, so here is a ~dropbox~ github link.

Thank you,
Paul

https://github.com/Avaviel/Ender-3/blob/master/Ender-3%20Mechanical/Ender%203.f3d

steenerson, 2019-12-11:
Hi Paul,

Thank for for providing the file! I have added it here:

https://github.com/Creality3DPrinting/Ender-3/blob/master/Ender-3%20Mechanical/F360/Ender%203.f3d

Closing this out

tomihofmann, 2021-12-06:
Hi!
I'm kinda late to the party, but I believe the f3d file is missing the heat brake/chimney altogether.
Is there a corrected version anywhere?

Thanks!

tomihofmann, 2021-12-06:
Also, in nitpicking mood the labels/names for the 'Part Fan' and 'Cold Section Fan' have been interchanged.

Tom

Closed 2019-12-11.

Thread 29 (2019-01-13):

Bad bowden fittings

turolfant, 2019-01-13:
The originaly bowden fittings tend to loosen the ptfe tube. This issue produces a gap between the tube and the Nozzle. This results in underextrusion problems. To fix this, it would be recommend to replace the fittings by better ones

bergstar, 2019-01-15:
Do you have pictures to illustrate what you are talking about?

Thread 31 (2019-02-10):

Ender3- USB connection randomly getting lost

ender3-user, 2019-02-10:
Hello,
I have an issue with USB connection to my Creality Ender 3.
When printing over Octopi (Raspi) or Repetier/Cura/... (different Windows PCs) garbage symbols suddenly occur in the terminal window, print stops.
I tried different USB cable (long/short/shielded...,, 5V pin isolated or not), result is always the same, failure probabinity remains unchanged.
On the other hand- print from SD worksfine.

So, I hoped to improve the behavior using new Marlin version.
I uploaded the bootloader over SPI from RaspberryPi, which semt to work.
However, it is not possible to flash the firmware over USB connection of Ardruino compiler, since the conenction is unstable and after several retries will be aborted. The last messages I could see in Ardruino mentioned connection unsync...

So, now my Ender 3  has an activated bootloader with blue LCD and there is no reaction to the control cnob.

What can be done there?
Can I flash the whole Marlin firmware over SPI (I have Raspi or Arduino Nano as possible programmer) or at least restore the original firmware?

Thank you in advance

steenerson, 2019-12-13:
@ender3-user it is possible to flash using an Arduino, here's instructions

steenerson, 2019-12-13:
It's possible to load firmware over serial using an arduino, here's some good instructions:

https://all3dp.com/2/ender-3-with-marlin-how-to-install-marlin-firmware-on-your-ender-3/

Closing out this old issue

Closed 2019-12-13.

Thread 32 (2019-02-27):

Compilation troubles

F4HFM, 2019-02-27:
Hello.
I've some troubles trying t "compile" (Verify) the _Marlin.ino_ project:
using Arduino version 1.8.8
using U8glib 1.19.1
declaring "Sanguino" as board, and "ATmega 1284 or ATmega 1284P (16Mhz)" as processor

When I try a "verif" I have a lot of errors:
- multiple declarations of _FAN_PIN_
- _using typedef-name 'fpos_t' after 'struct'_ error in SdBaseFile.h

Any idea of what I missed?
Thank you!

fesiqp, 2019-03-04:
@F4HFM I'm submitting PR to fix this right now.

fesiqp, 2019-03-04:
Fix PR submitted.
PR #33

F4HFM, 2019-03-05:
Hello fesiqp.
Nice, it seems to be fixed!
Thanks a lot, now I'm waiting for receiving my Ender3 Pro to test it :)
Thanks a lot.

tlhintoq, 2019-06-22:
Arduino software 1.8.5 or 1.8.9 makes no difference for this.
Trying to compile Marlin 1.1.9 with Ender3 sample conf files (no changes yet, just the out-of-box files for the Ender3.
Compile (verification) fails saying to choose the Sanguino board.  But that's already the board selected.  Version 1.0.2 as specified int he documentation.
Thoughts?
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

ochefe, 2019-06-22:
@tlhintoq can you show me which file is in this screenshot? And which version of the repository are you working with?

Also, can you list me which "Processors" are within the "Processor" dropdown, right below the "Board" one you highlighted

steenerson, 2019-12-11:
I have merged PR 33 and this is complete.

@tlhintoq if you're still seeing an issue let me know and we can reopen this or open a new issue. It's working for me with Arduino 1.8.10 Windows, Sanguino 1.0.3 and U8glib 1.19.1.

Closed 2019-12-11.

Thread 34 (2019-03-06):

Frequent problem with step motor driver failure

rcoscali, 2019-03-06:
In a short period of time I had two failure of step motor drivers (A4988) circuits. First with Y axis and second with E. I found no other solution than changing the board. Is this a known problem ? Is there something I failed to do to avoid such failures ? Measures with oscilloscope shows no current on the failing driver capacity (c17 for Y) and didn't yet measure it but wwill do shortly, I expect  c25 current to be null.
Can you help about it ?
Thanks

wjsteele, 2019-03-16:
Is your motor current set correctly?  If it is not, it will quickly burn them out.

steenerson, 2019-12-13:
@rcoscali is this ongoing or did you find a resolution? Are we clear to close this old issue?

Thread 35 (2019-03-16):

What happened?

RudolphRiedel, 2019-03-16:
Here is a transcript of part of the sub-titles from Naomi WUs video on youtube called "Naomi Wu speaking at COSCon'18 (China Open-Source Conference)".
This was back in November 2018:

"I'm an Open Source evangelist."
"I am the person behind the first Open Source Hardware Association certified projects in China."
"Nice words but nothing gets done."
"Everyone talks about Open Source- show me the certification, not just a logo on a PCB."
"As I said, I think that doalog with the community is key to successful Open Source engagement."
"Every file you needed- CAD files, BOM, board schematics, firmware, everything to clone it was posted on GitHub."
"Creality3D has maintained their commitment to Open Source and have continuously released source files and maintained GPL compliance."

"You have to be relatable, not just a faceless company."
"Every successfule Open Source project has an online community."
"If your engineers are not an active participant in those communites, don't communicate with the community, the community will abandon you eventually."
"Just dumping a load of files on Github is not engagement."
"If your engineers can't manage pull requests, can't collaborate with Western developers, you aren't going to reap the full benefits of Open Source."
"Especially with Western developers."
"Then you get nothing."
"All of these things require open-minded thinking that Chinese tech companies might not be accustomed to."

What happened?
There have been no significant contributions to the Ender-3 repository after the first upload.
Almost none of the issues have been resolved.
There is no communication going on with anyone from Creality3D or Naomi Wu on their repositories.
All they do is dump, run and ignore.
And my personal favourite, we still do not have the schematic for the board used in the Ender-3.

wjsteele, 2019-03-16:
But you already did that, didn't you?  "I gave up on pushing Creality for the Schematic of the controller-board but that does not mean that I stopped caring.... So today I sat down and did my own version of the schematic..."

Seems you haven't given up.  Stop worrying about it... you have what you need, obviously, so there is no point in pursuing this further in my opinion.  They've given us 99% of what is wanted... and 100% of what was required (which was only the firmware.)

RudolphRiedel, 2019-03-16:
No, what I did is a reconstruction of the V1.1.2 controller board schematic after the board file they released - and that is most likely not 100% accurate because the board file is not.
That is the board my CR-10 has been delivered with.
The Ender-3 is delivered with the V1.1.3 version of this controller board and we still have no answer to the question what the differences to the V1.1.2 board are.

So, first of all, they did not put out the data for the Ender-3 in this repository. Then the data that they uploaded was incomplete.
That alone makes me wonder why the OSHWA certificate still has not been revoked.
We are talking about 9 months without a real contribution now.

And talking about "what was required".
They admitted by now that the controller board is a clone of the Melzi design which is under GPL.
Their repository is even named "CR10-Melzi-1.1.2".
So they would have been required to release that data when they started selling the CR-10 at least.
The Ender-3 is still in violation of the GPL.
And so is the CR-10 since the schematic that they released with the board data does not match that board data. And it is not even the source-data, it is just a .pdf.
And I pointed that out as an issue almost three months ago.

On top of that you have "Just dumping a load of files on Github is not engagement.".

So, bottom line, we have no engagement whatsoever but GPL violations and a handfull of certificates that would not stand a review.
A little bit of engagement would have gone a long way and changed everything.

And you are telling me this is all fine?
I can not shake the feeling that we have been played and llied to and this makes me angry.

Just look at the issues with this repositories and their contributions.

I am not even making a big fuzz about this, I could post this on twitter and the various facebook groups instead of just here. Plus I could try to contact a couple of Youtubers.
This here will go mostly unnoticed, this is just me blowing off a little steam of disappointment.

RudyFiero, 2019-03-16:
I have to agree with Rudolph. They have not supplied the required information. What they have provided is inaccurate and incomplete. None of the issues have been dealt with.

> I can not shake the feeling that we have been played and lied to and this makes me angry.

Yes.

bergstar, 2019-03-17:
This issue is close to being trolling by github standards.

Unfortunately it is true that Creality has proven not to care about open source. And did what all other company in China do - **dump & forget.** And again unfortunately OSHWA dose not care about post open-sourcing support and it is not a requirement.

And frankly expecting "Naomi Wu" to do anything about it is a bit naive to say the least. After all problem is with a huge companies with thousands of workers - you can't blame person who is not even working there.

So as with any other dead github project - the only way forward is to fork it and maintain it "our self".

sexycyborg, 2019-03-19:
Honestly @RudolphRiedel constant harassment every time I logged was so discouraging it was a large part of the reason I've given up on this repo. Nothing I did was enough- even though no one else had ever successfully done half as much, everyone was always angry and accusing. Why make it personal? How is this my fault? I'm a millionaire 3D printer company owner? I fight for what no one else has gotten before- and I've gotten it, but when I can't I deserve personal abuse?

I'm only paid to shoot videos for Creality, caring about Open Source does not mean I'm willing to be a punching bag for every entitled rando out there.  I have an enormous amount on my plate, a lot to worry about and precious few resources- why keep helping people that don't give a shit and treat me like garbage? It's just not worth it- Chinese have zero interest in Open Source so I burn bridges here fighting for it, then no matter what I get done I'm still get told it's not enough and am attacked by people like @RudolphRiedel. Why would I keep putting myself through that?

I'm not your dog, I'm tired of people snapping their fingers, telling me to fetch and then smacking me when I do. If you want something from Chinese bosses ask them yourselves, as successful as I've been at times, fighting for your so-called "community" has just left me bruised, broke and exhausted.

RudolphRiedel, 2019-03-19:
This is the way you want to play this, really?
All I see there is an ivite for a personal attack towards you and this is really low and dishonest.
Why do you make this personal about you?
And this while anyone can check out for themself what has been going on here.

So, okay, what did I do wrong?
I provided additional files like the "Ender3_pcb_parts.PDF" that went straight into the repository while I technically have not been asked if this is okay.
I did try to be helpfull and to provide anwers to a couple of questions.
I did offer my help directly here on Github and even tried to contact Naomi in private, but I was ignored.
I defended Creality3D and Naomi a couple of times.
I put quite some hours of my spare time into this without getting paid for it at all or bragging about this on my youtube-channel - because I do care about the product.
I have been attacked and no one stood up to it.
I did not even really ask for aynthing untill three months in and after not getting any answers.
I admitted to beeing wrong when I found out.
I do not like to be ignored, played or lied to.
Maybe I did not use enough smilies.
Oh yes, I expressed my opinion while trying to be clear that this is my opinion and I pointed out facts.

RudyFiero, 2019-03-19:
The problem here was that Creality didn't really buy into the open source mindset. If they did then Naomi would have had the support she needed. Without that support this was bound to end as it did. She gets it, but she is not in charge. She did the best she could.

sexycyborg, 2019-03-20:
Creality will do it if I ask them. I offered to ask them before as you recall and was immediately attacked so walked away. @RudolphRiedel's super creepy demands to my personal email account did not help that situation. I'm still not going to ask them because it's not my job and I don't exert myself for people who attack me for trying to help them.

If something is at the right point in the product lifecycle I might Open Source it, but I'm not going to put a push on. As things stand there's no upside for a Chinese company, attacked if they do, attacked if they don't. It's not really a defensible business decision based on community conduct at this point. Chinese 3D printer companies with no OSHWA certified projects get no abuse or demands because they are not even trying so there's nothing to have a discussion about. Why create that kind of negative buzz around an already leading brand?

Dumping files is- as I've said is a bad strategy and a real problem I've warned other Chinese companies to avoid. I spoke about it at COScom specifically based on my experience with this repo. What I didn't say because I did not want to discourage Chinese companies or give credence to their counterarguments is that the blame is shared. I've pointed Creality engineers at this repo and they saw an absolute dumpster fire they wanted no part of- even though it would save them a lot of work it's just not worth dealing with the crazies. There's a reason the files got dumped and no one is signing up and logging in so you can treat them like coolies.

This behavior is unimaginably stupid and short-sighted. Chinese companies have massive incentives- cash incentives to file dubious patents. Local government is actively hostile to Open Source as it conflicts with targets to achieve a certain number of patents (and so innovation unfortunately in central governments mind- yes I know, there's only so many fights I can fight). The OSH community does not contribute a penny to the work I do here. Despite all the progress, I've made I have no resources and no help with OSHWA work in China. Zero. It's just me. When thermal runaway was burning down houses I took three buses and walked to get to the factory in the middle of nowhere to demonstrate the problem in person. I don't have time or money to take a day off to do that- and I still get screamed at because it's 100% all at once or "They don't really care about Open Source".

This relentlessly hostile attitude spills over- I scraped up enough money and an invitation letter to go to MWRR this year and I've got attendees making physical threats against me- with not a word from the community. It's insane, you can't keep attacking people who are trying to give you what you want and expect that to work out well.

If we make Open Source happen and you can't be civil and encouraging as things progress it in no way affects China or Chinese people in the slightest- but puts you at risk of being locked out of the hardware ecosystem unless you have the resources to fight bullshit patents on Open Source derivatives in a Chinese court. I just dealt with a Chinese company the other day patenting a modification to a RAMPS board- the community tagged me to fix it for them, didn't give a shit when I got on WeChat and did and that's another burnt bridge with an angry Chinese company that will complain to everyone I'm on the "foreigners side".

TLDR; You got an Open Source Hardware certified commercially successful product from a Chinese company which is far more important in the larger scheme of things than any individual schematic. But short-sighted fuckwits who can't see the big picture of the IP situation in China, be patient and work with what's provided decided to fuck everything up and will now claim we acted in bad faith rather than look to their own conduct.

RudolphRiedel, 2019-03-20:
Stop it with the attacks against me already and apologize.

I sent you three messages and not one was creepy in any way.
2018-09-30 - I reached out thru Facebbok - which you ignored
2018-10-11 - I readched out to your ProtonMail account - which you ignored.
2018-10-27 - My last mail over ProtonMail - which you ignored.

This failure of a repository is not my fault and you obviously have no idea what a dumpster fire even looks like since there was not even much going on here.
We all put on the velvet gloves.
And this now still is not anything remotely like a dumpster fire.

I reached out to you privately to not turn this into into a shit-show.
You chose to ignore me instead of at least answering me that you are not interested in discussing this.
I did not even know that my messages reached you untill you brought it up.

And shame on you to talk about patience when the one thing that has been demonstrated over and over again was patience.
Stop pretending this all happened in the last two weeks.

I can agree to what RudyFiero wrote, at least to a certain degree.
The lack of communication is not entirely on Creality3D though.

bergstar, 2019-03-21:
@RudolphRiedel She is not obligated to reply to you or in anyway care about you or your personal messages. You will not get anyway by being a rude person attacking people on GitHub. I hope you understand that this is an open source project - not a support channel to Creality3D. And even their are not in any shape or form obligated to maintain or support this project here on GitHub.

Please take time to read a few code of conducts:
https://github.com/docker/code-of-conduct/blob/master/code-of-conduct-EN.md
https://github.com/twitter/code-of-conduct/blob/master/code-of-conduct.md

If you are so patient about this project, what stops you from forking and maintaining it your self?

RudolphRiedel, 2019-03-21:
>@RudolphRiedel She is not obligated to reply to you or in anyway care about you or your personal messages.

Where did I even imply that she is obligated to answer me?
I merely pointed out that she did not answer me, not even to tell me to stop.
She dragged it out while wrongfully accusing me.
And I stopped after three messages roughly two weeks apart to each other, it is not that
I was constantly nagging her.

>You will not get anyway by being a rude person attacking people on GitHub.

Gertring anyway with what now? The only one beeing openly attacked is me.
I could respond much more directly to the accusations but chose not to.
I had left it there but she had to attack me.

I am not aware of any attack towards Naomi here.
If you find something from me that you count as an attack, please point it out to me and I will either try to explain better what I meant then or flat out apologize for it - or both.

>If you are so patient about this project, what stops you from forking and maintaining it your self?

It is not about maintaining, it never was.
Problem still is that the information provided is incomplete and in case of the controller board not accurate while they turned this into a marketing instrument by putting a certificate onto it.
They had to take it one step further.
And on top, they are still in violation of the GPL.
If you can show me that any of this is not a fact but an accusation without grounds I will apologize.

This whole thing is pointless now, the outcome is clear already.
But I will not stand down when I am getting attacked.

bergstar, 2019-03-21:
@RudolphRiedel My bottom line point is - for issues related obligations of the Creality 3D as a company - either related to support or service or legal issue one may contact the company directly using appropriate channels - not github repository. I have no experience in HR - I don't think I can comment any further on that subject.

When it comes to the OSHWA and GPL - there is ways to complain. For instance:
`Any party detecting an alleged violation can submit a complaint to certification@oshwa.org and OSHWA may, at its discretion, conduct an investigation.`

As and owner of Ender-3 Pro I think it is sad that it ended up being dump & forget repository. At the same time, we have a great starting point to fork the projects and make it really 100% open source.

rex, 2019-03-26:
@RudolphRiedel You are the worst kind of troll. I bet you're a delight at parties. The fact that you can type and re-read what you've said above and not realize that you're not just in the wrong but also a horrible person speaks volumes about where you are at this time in your life.

Who hurt you? What happened to you that you became the kind of person who lashes out at people in an issue in a code repo? Is your life really that empty and sad?

Go outside. Read a book. Turn the computer off. Your days of being a malicious, petty, neckbearded fucking incel _can be behind you_ if you let them.

@sexycyborg I highly recommend closing and locking this issue, this is absurd that you have to deal with this.

RudolphRiedel, 2019-03-26:
@rex So you are saying that I am a bad person by attacking me?
And you do not have any arguments to demonstrate why I am wrong?
Stop emberassing yourself.

Theaxiom, 2019-04-21:
I agree with @RudolphRiedel while his communication style may be a bit abrasive to those with sensitive skin, I do have to say that the personal attacks against him are absolutely uncalled for and clearly a violation of the community standards. That all being said, can't we all just get along and love each other? I am sure you all have much more enlightening and soul-expanding things you could be doing instead of perpetuating negativity.

Closed 2019-12-13.

Thread 36 (2019-03-31):

Pause does not work instantly.

kaovilai, 2019-03-31:
When pausing print when printing first raft layers, temperature drops as heating elements are turned off but the nozzle still moves around for a little bit as if it;s still printing. Extruder also continue pushing the filaments through the cold head which obviously clogs up the line especially my flexible filaments.

When I pause, it's usually serious issues like leveling is not quite right and the nozzle is literally scratching the board.

It seems to only occur on rafts section that is created by Ultimaker Cura 4.0.0

Pausing are quicker but still not instantaneous on actual models. I assume there is some kind of G-Code buffer that has already been loaded and pause commands aren't executed right away.

Please advise if this is a bug.

bergstar, 2019-03-31:
I have tested pause feature with code from Simplify3D and it is working perfectly. The only issue with pause is inaccurate limit switches which are +/- 1mm or so - which can sometimes results in a layer shift.

kaovilai, 2019-03-31:
> I have tested pause feature with code from Simplify3D and it is working perfectly. The only issue with pause is inaccurate limit switches which are +/- 1mm or so - which can sometimes results in a layer shift.

I have updated the issue.

kaovilai, 2019-03-31:
Seems like commands from the display is sent right away but the module responsible for movements is the issue.

Thread 37 (2019-04-02):

New Ender-3

Jesscatz, 2019-04-02:
First of, my apologies, this not so much an issue but a report about things I found when I put my second Ender-3 together today.

There is a new spool holder included, it is a little longer and has a special nut that locks like a BNC connector.

The heater block is covered by a black silicone sock.

Much to my surprise the belt pulleys are pressed onto the axis of the stepper-motors now.
So we could not install the vibration dampers I bought in preparation.
 I guess I need to find a replacement for these and figure out how to remove the pulleys without damaging the stepper motors.
These are 2GT with 20 teeth and 5 mm hole?

And when I opened the control-box I found that my Ender-3 was delivered with a V1.1.4 version of the controller board.
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

I did not notice it right away but it looks like this new version has a different USB chip.

dodox1, 2019-04-12:
https://www.creality3donline.com/creality3d-new-upgrade-silent-114-mainboard-for-ender-3-pro-ender-5-customized-und-non-standard-matching_p0147.html

Jesscatz, 2019-04-12:
This is interesting and the pictures on there are much better than the quick shot I uploaded, thank you. :-)
So the new USB chip is a CH340G.

Does it say anywhere why it is called "silent"?

At least mine does not seem to be any quieter than the old Ender-3, not that I am complaining, I knew what I was getting when I bought it.
But I still would like to install dampers and could not figure out yet how to remove the pulleys.
I removed the Y-stepper but the pulley refuses to budge.
Okay, maybe I am a little concerned about damaging the stepper.

dodox1, 2019-04-12:
Old stepper motor driver A4988 changed for TMC2208.
This is the reason why is it "silent". Hopefully there is no reason for dampers....

Jesscatz, 2019-04-12:
Watching the video from Creality again I got pointed by Youtube to this one: https://www.youtube.com/watch?v=_wEZOAFZhB4
The pinned comment from Teaching Tech is:
"After reading the comments on here and Facebook, it seems that printers shipped with this board don't have the bootloader or TMC2208s. To get this functionality you need to order this 'upgrade' version from their website. If you just received a printer with the 1.1.4 board, I can imagine how frustrated you are!  "

Well, no, I am not frustrated since I did not expect an upgraded board in the first place.
I would have been a sweet surprise, sure, but I got exactly what I paid for.

Now I still need to figure out how to install the dampers I bought at the same time as the Ender-3.

Well, if the board is the same, maybe one of you guys can figure out how to change the drivers?

Melissa3920, 2019-04-28:
I found this video with a good idea on how to install dampers with press-fit pulleys without a hammer. Yes, I found a video like that too. Anyway: https://www.youtube.com/watch?v=IjzrNoFnbcI&t=602s

Jesscatz, 2019-04-28:
Thank you, that is interesting and I will try this.
I was planning on changing the firmware anyways, now this gives me another reason to do it.

I already bought a "Profi Motor Pinion Gear Puller Remover for RC Helicopter Motor" on EBay,
but it won't be delivered before end of may anyways.

The CH340G worries me a tiny bit.
In the absence of data that supports that this really is working I do not have much trust in that the "Internal 3.3V reference" of the CH340 can reliably power the SD-card.
In case it blows I can have it fixed on short notice, but I rather not have to.
Adding a <5 ct 3.3V LDO like an AP2120N-3.3 would have done the job just fine.

steenerson, 2019-12-13:
@Jesscatz thanks for the report, I'm closing out this old issue.

Closed 2019-12-13.

Thread 38 (2019-05-09):

Ender 3 Pro Enclosure - Where are the model files?

bugsysiegals, 2019-05-09:
The sheetmetal enclosure files do not appear to be the Pro and flipping them upside down doesn't appear correct either.  I'm trying to use the Pro model to create a custom enclosure for Duet Maestro ... please advise how I find the Pro model files.

jxmot, 2019-12-05:
I'd like to see the Pro files too. Any chances of these showing up?

Thread 40 (2019-07-07):

Ender 3 Bed wire strain relief model missing

Bukethead, 2019-07-07:
The strain relief model for the heated bed wires is missing from the repository.

Thread 44 (2019-10-26):

LCD schematic ?

tablatronix, 2019-10-26:
I am not finding any resources on the LCD pcb/schematic, am I missing it?

Thread 45 (2019-11-19):

PCB and BOM for 1.1.5 Silent Board?

fivesixzero, 2019-11-19:
While working with my new V1.1.5 Silent Board I’ve found some subtle but important dIfferences between the 1.1.2 board detailed in this repo. It’d help a lot, especially with any future repairs, to have an accurate BOM and layout for this board.

The main difference I’ve noticed is the use of R150s for the sense resistor pairs instead of R100s. Based on the TMC2208 data sheet it looks like this effectively caps the output of the motors at about 15% below the max RMS for the 2208 part at 1.28 Amps (against a 1.4 A RMS max in the 220x data sheet).

That seems like a wise decision with the new drivers, helping to avoid burning out the chips. With this design, if Vref is set to 2.5V or higher it would avoid an over-current situation in the driver. Which is good.

Given that minor change I’m also curious what else has changed, if anything, between the 1.1.2, 1.1.4 and 1.1.5 boards as well as what’s different between the 1.1.5 and the 1.1.5 Silent Board beyond the drivers and the sense resistors.

I’m also curious about the stability of the Vref coming out of the trim pots. The 2208 data sheet has some strong warnings about layout and design for stable analog Vref as well as sense resistor grounding. Reviewing the design without reverse engineering the physical board to verify things would require updated design and BOM data.

TL;DR

1. What changed in BOM or layout between the 1.1.2, 1.1.4, and 1.1.5 board revisions?
2. What changed in BOM or layout between the “normal” and “silent” board revisions?

rickyrockrat, 2019-12-28:
They removed the FTDI chip and replaced it with a HL-340. Unfortunately, the USB port STILL powers that LCD backlight when 24V is off. It would be very nice to see a PCB layout so I can fix that like I did on the 1.1.3 version.

RockyTV, 2020-01-07:
They should publish it as RAMPS is open-source, they haven't published the source code for their silent board yet.

Thread 48 (2019-12-26):

Where is the Ender 3 part in Marlin

thesaint7281, 2019-12-26:
I have looked and all I see is the Marlin for the CR-10. I am supposed to look in the Example Configs. Should I not be looking for the Ender 3 to upload on my printer?

zero4281, 2019-12-26:
It was added 2 days ago to Marlin 2.0.1
https://github.com/MarlinFirmware/Marlin/tree/2.0.x/config/examples/Creality/Ender-3

Thread 49 (2020-01-07):

Ender 3 making print Taller.

Johnathan2581, 2020-01-07:
Hello,

I'm currently printing with some new PETG I got for Christmas. I started a common (20x20x20 XYZ cube ) print to check and make sure everything is okay. Well, I run into an issue for some reason it has doubled the z of the print and I can't figure out why it's doing so. My sliced CURA file sliced it like a 20x20x20 so I don't think it's that. I also looked at the Z-axis steps and it's set to the default 400/mm. I also took a look at the two little bolts on the Z screw coupler and they are tight.

Any other ideas would be a great help
Thank you!
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

wjsteele, 2020-01-07:
Are you sure you're gcode is not setting the M92 value for the Z axis incorrectly?  The defaults are shown in M502, but what is active is M503.  If not, try setting the steps per mm to half the value, using M92 Z200, which will tell it it only needs 200 steps to make a complete revolution.  This is actually a common failure mode of stepper motor controllers, where they loose a micro stepping increment.  For example, it's no longer at 16th stepping mode... but only at 8th step mode, so it's doubling the distance it is travelling.  The M92 command will fix that... then you can save it using the M500 command... or simply insert it into your start gcode for each job.

Bill

________________________________
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

Johnathan2581, 2020-01-07:
Thank you for the advice it was the steps I reduced it to 200mm/s and it printed a pretty good cube
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

Closed 2020-01-07.

Thread 50 (2020-04-14):

Pins on Creality3D 1.1.4 Board

fedekrum, 2020-04-14:
Hi,

I am willing to know the number of the pins assigned to each connector of the board.
The idea is to use this board in a non 3D printer project programmed with an arduino IDE.
I was able to install a bootloader on it and I need, for example, to move a single stepper motor.

Can you provide that information?
Thanks

hille78, 2020-04-14:
Maybe this sheds some light of the pins
[https://github.com/MarlinFirmware/Marlin/blob/2.0.x/Marlin/src/pins/sanguino/pins_MELZI_CREALITY.h](url)

Thread 53 (2020-05-15):

Please fix filename extensions and the whole repo.

i5okie, 2020-05-15:
There are several files where file names overlap.
```shell
$ git clone https://github.com/Creality3DPrinting/Ender-3.git
Cloning into 'Ender-3'...
remote: Enumerating objects: 1273, done.
remote: Total 1273 (delta 0), reused 0 (delta 0), pack-reused 1273
Receiving objects: 100% (1273/1273), 364.64 MiB | 9.28 MiB/s, done.
Resolving deltas: 100% (376/376), done.
Updating files: 100% (1008/1008), done.
warning: the following paths have collided (e.g. case-sensitive paths
on a case-insensitive filesystem) and only one from the same
colliding group is in the working tree:

  'Ender-3 Mechanical/Ender-3 Parts/M5X8Pan Head Screw.SLDPRT'
  'Ender-3 Mechanical/Ender-3 Parts/M5X8Pan Head Screw.sldprt'
```

Not all systems are configured to be case sensitive. Arguably, most are case insensitive. Meaning that the Solidworks assembly file for Ender-3 is now broken.

jriwanek, 2020-07-16:
Arguably, *windows* is case sensitive, most **other** operating systems can handle mixed cases just fine, I agree with your point however, but inaccurate claims help nobody.

mistic100, 2020-10-10:
I cannot figure out how the repository can have such name conflicts as Solidworks is only available on Windows...

Thread 54 (2020-06-11):

3D Model Still Utilizing Old Versions

EricSchubert, 2020-06-11:
I've noticed multiple components in the Ender 3 3D model files are incorrect.  In particular, the LCD display/control PCB is incorrect, only showing 2 EXT connections and the buzzer is in the wrong location.  I imagine other components require updating, as well.

Could you please provide a current 3D model for the Ender 3 design?

Thread 57 (2020-07-24):

No CAD model for Creality Mainboard

jrgilman, 2020-07-24:
Basically as the title says, I can't seem to find any CAD model that can be used for designing enclosures, etc. for the mainboard. I've been using the SKR cad model for the moment since it has the same dimensions largely, but having the official one would be nice.

RudolphRiedel, 2020-07-25:
I would generate a .step file for the board but the old V1.1.2 board design file up on Github almost has no 3D models:
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

Thread 58 (2020-07-28):

Ender 3 V2 (4.2.2 Board)

lavanyaarora97, 2020-07-28:
I can't find any board images or diagram.
Please upload creality

RudolphRiedel, 2020-08-06:
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

sagarreddypatil, 2020-12-14:
Is there a schematic for this board?

Ducati87, 2021-02-14:
any news??? is it top secret?

sexycyborg, 2021-02-15:
v2 isn't Open Source

kvartz-tlt, 2021-02-15:
@sexycyborg I have v1 with 4.2.2 board. It is not open source too?

sagarreddypatil, 2021-02-15:
> v2 isn't Open Source

Considering V2 is derived from V1, isn't that a violation of the GPL license?

wjsteele, 2021-02-15:
> isn't that a violation of the GPL license?

No... the author of the original work is free to choose any license they want to.

Jesscatz, 2021-02-15:
> No... the author of the original work is free to choose any license they want to.

Well, Creality is not the author of the original work, it is derived from the Melzi boards which are under GPL.

VinnyCordeiro, 2021-02-15:
GPL is only valid for open source _software_, open source hardware needs an specific license. So, as long as Creality releases the sources for their Marlin implementation, they are not in breach of the GPL.

sagarreddypatil, 2021-02-16:
If the entirety of the Creality Ender 3 v2 is not open source, this would be a clear violation of GPL considering v2 is not using the same code as the original Ender 3(evident by the screen UI), right?

Jesscatz, 2021-02-16:
>GPL is only valid for open source software, open source hardware needs an specific license.

That is an entirely different can of worms.

The point made was that the original author can change the license and while that is true this argument
is invalid for this discussion since Creality is not the original creator of the Melzi boards.

I stongly disagree with the assesment that GPL is an invalid license for open source hardware since we are talking about
the source files here from which the hardware is build, schematic and layout.

But okay let us say, for the sake of the argument, GPL is indeed an invalid license for schematic and layout files.
What does that actually mean?
I means that the files are per default under the copyright of the original author and do not have a license
that can be applied.
It does not mean that the work of the original author is placed in the public domain.
This would make the V1 a copyright violation which is a lot worse than a GPL violation.

This still may not apply to the V2 since it may be that it has seen enough changes to be recognized as original work.

feadot, 2021-05-18:
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

RudolphRiedel, 2021-05-20:
That looks helpfull, thanks, I just ordered an Ender3 Max and it should have either this one or the 4.2.7 installed or the next version.

But please provided a source for that file, especially as it is not yours and there is no copyright string on the document and no license information. As it is you are violating someones copyright.

Also, from the looks of it this appears to be redrawn in KiCad and if there is a public repository and if it has KiCad files, this might be even more interesting as this might allow changes and collaboration for these around who use KiCad.

ellensp, 2021-05-21:
Not possible I found it on github, but I can no longer find the original.

RudolphRiedel, 2021-05-21:
That is very unfortunate and I can not find it either.
So we can only hope for now that whoever created the document comes across this.

dwery, 2021-05-25:
It’s probably from https://github.com/Jyers/Marlin/discussions/814

ellensp, 2021-05-25:
yes that is it, Since it been updated I have removed the old one.

apsillers, 2021-07-19:
> But okay let us say, for the sake of the argument, GPL is indeed an invalid license for schematic and layout files.
> What does that actually mean?
> I means that the files are per default under the copyright of the original author and do not have a license
that can be applied.

This is definitely a misreading of the argument about how the GPL applies to circuits.

The argument here, "circuits cannot have the GPL applied to them," is rooted in the basis that circuits are not eligible for copyright, insofar as they are functional articles. Circuit diagrams can be protected by copyright as written/pictorial works (and so the GPL may apply to them, as it may be applied to any copyrightable work) but the physical, functional artifact of a circuit is not copyrightable, so the GPL doesn't have anything to say about it. There cannot be a copyright violation for the manufacture of a circuit for the same reason the GPL cannot apply to a physical circuit: the circuit is not copyrightable in the first place.

From 17 USC S.101:

> Such works shall include works of artistic craftsmanship insofar as their form but not their mechanical or utilitarian aspects are concerned; the design of a useful article, as defined in this section, shall be considered a pictorial, graphic, or sculptural work only if, and only to the extent that, such design incorporates pictorial, graphic, or sculptural features that can be identified separately from, and are capable of existing independently of, the utilitarian aspects of the article.

Related discussion: https://opensource.stackexchange.com/q/2223/50

spuder, 2021-12-18:
@jbrahy Thank you for sharing the schematic. Where did you get it? I believe the UCH245 pinout is slightly wrong. This is the pinout on the 4.2.3 board

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

G-Pereira, 2022-07-20:
has anyone found out how to control the part cooling fan?

xcasxcursex, 2022-07-21:
> has anyone found out how to control the part cooling fan?
You're asking in the wrong place and it's very annoying. Use your search engine instead of spamming us all with a notification because you want a howto

G-Pereira, 2022-07-21:
wow lighten up a little sir!

Given this poorly documented board the information on the internet is scarce and that was what led me to post it in here. I am sorry if I annoyed you. You can and should disable notifications if you don't want to be notified about this topic. Actually GitHub has improved its notification system quite considerably and you can fine tune your preferences of what you should be notified by default or not.

Concerning the issue at hand, I could solve it, the fan pin is PA0 which one would easily find by looking at the board file. What I didn't realized is that it is the same pin that drives both the part cooling fan and the motherboard fan. Turns out my part cooling fan was simply stuck on the plastic housing of the hotend, a gentle push solved it.

xcasxcursex, 2022-07-24:
> wow lighten up a little sir!

You realise that you're part of a widespread problem, right? No? Well, now you know. I WAS light with you. You'll know for sure, when I'm not.

> Given this poorly documented board the information on the internet is scarce and that was what led me to post it in here.

Just because you can't find an answer anywhere else doesn't mean post on github in an unrelated issue. You're making the problem worse by decreasing signal to noise, with "how do I use my thing" posts, in a rare place where people are trying to get board files. One more time: YOU'RE MAKING THE PROBLEM WORSE

> I am sorry if I annoyed you.

And yet here you are trying to redirect blame, make excuses, all while doing it again. You're not sorry.

> You can and should disable notifications if you don't want to be notified about this topic.

I should, if I didn't, but I do want to be notified about this topic. The topic is sourcing the creality 4.2.2 board drawings. Every single post here except for yours and my replies to them, are on-topic. What you've posted is not on-topic. The problem is not my notification settings, it's you. You can and should post in appropriate places so you don't create annoying notifications for people with the correct settings.

>  Actually GitHub has improved its notification system quite considerably and you can fine tune your preferences of what you should be notified by default or not.

Actually, no, they don't have an option to filter out off-topic posts. Stop making excuses, you screwed up, just stop.

> Concerning the issue at hand,... Turns out my part cooling fan was simply stuck on the plastic housing of the hotend, a gentle push solved it.

You might want to solve that properly, because what you've described there (improperly mounted hardware prevents fan from turning and cooling) is a potentially serious problem (no cooling + heater = fire), and what you've described is not a solution at all (If a gentle push can unjam it, a gentle push like the G forces of your printer, can jam it). As much of a pain in the back side as you are, I don't want to see your house catch fire. GO ASK SOMEWHERE ELSE HOW TO DO IT. **NOT HERE.**

AkashicSeer, 2023-02-06:
Thanks for the diagrams.
You got to love these Chinese companies and their lack of understanding of documentation and why such seemingly simple things as standards are important.  They don't comprehend that we the users will flock to the better companies that actually do provide such simple things as documentation, datasheets, specifications etc. etc. etc.

Why is this such a hard concept for Chinese companies? They stole all of the manufacturing from the West, yet threw out all of our standards and QA etc. Do they really think we came up with all of the standards just to waste time, or does it hurt their ability to be dishonest? Or is it both? In the past you could go to a companies page or open a published book to view specs about components. Now you can't trust a single electronic component, much less complex things like mainboards.

I wish more things were made in places other than China, THEY SUCK AT ELECTRONICS.

xcasxcursex, 2023-02-06:
> Given this poorly documented board the information on the internet is scarce and that was what led me to post it in here.

No, what led you to post in here was a complete lack of regard for the intention of this thread.

> such a hard concept for Chinese

How hard is it to post about the PCB in a thread about the PCB. This isn't the "How do I use my printer" or "let's rant about racist nonsense" thread. Actual tards.

Cozmo77, 2023-04-22:
> I can't find any board images or diagram. Please upload creality
[1623133432-Creality422-Schematic (3)_220129_211224.pdf](https://github.com/Creality3DPrinting/Ender-3/files/11301969/1623133432-Creality422-Schematic.3._220129_211224.pdf)

rennieboudreaux, 2023-08-13:
@ghost Karen, is that you?

Thread 59 (2020-08-11):

Ender 3 v1 + 4.2.7 v2 Board

badouuuuuu, 2020-08-11:
Hello,

I got a ender 3 v1, with a 4.2.7 board, but i can't found a recent firmware and it's impossible to update to marlin 2.0.6.
Can someone give me more info about this board ?

Flawioo, 2020-08-17:
Hi, the same here. I have dozens of this boards and all of them have no stepper movements. Please can you help all of us?

eduardoluism, 2020-08-20:
Same here, no movements.

christianjou, 2020-09-28:
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

thanks a lot.

However, how activate the Bltouch ? I try but no success

Thread 62 (2020-12-03):

Please provide CAD Model for Ender 3 V2 Mechanical

jottr, 2020-12-03:
Please provide CAD models for the new Ender 3 V2 [mechanical](https://github.com/Creality3DPrinting/Ender-3/tree/master/Ender-3%20Mechanical) components.

nathanshearer, 2021-01-02:
Please also provide them in a format that can be opened by free open source software. Models saved in a proprietary format is not very useful.

One-Armed-T-Rex, 2021-03-30:
You can download the full STEP file here. In inventor you can import is as a complete assembly with all the loose parts

https://d2t1xqejof9utc.cloudfront.net/cads/files/314516fe20262f5973d02158734142fa/original.STEP

lemacs, 2021-04-30:
Does anyone have a new link that works?

Darthkakarot, 2021-09-18:
> You can download the full STEP file here. In inventor you can import is as a complete assembly with all the loose parts
>
> https://d2t1xqejof9utc.cloudfront.net/cads/files/314516fe20262f5973d02158734142fa/original.STEP

Can we get a link the works pls?

Sukumiku, 2022-05-23:
Here ya go:
https://grabcad.com/library/creality-ender-3-v2-3

Cheers

xcasxcursex, 2022-05-24:
> Here ya go: https://grabcad.com/library/creality-ender-3-v2-3
>
> Cheers

I can't download from there, the site is full of spyware and won't even load in a secure browser, when I use an insecure browser it asks for an account to download it.

Thanks for trying though!

Panda7556, 2023-10-01:
https://www.printables.com/model/255019-ender-3-v2-step-file-for-easy-modification-and-des

Thread 63 (2020-12-08):

Ender 3v2 - 4.2.2

konraddg, 2020-12-08:
Please, give me a diagram of the board (from my ender 3v2) 4.2.2. The fans are not running. Diagram needed for repair.

sagarreddypatil, 2020-12-13:
I would also like the schematics to find the Serial RX TX pins to bypass the USB port as I find it too unreliable, but it seems the repo is dead, as none of the new upgrades are on here. So much for the OSHWA certification.

@sexycyborg @Creality3DPrinting

schlameel, 2021-02-18:
Could we please get the CAD (F360) files for the 3v2, including the mainboard?  Thanks.

NickSlash, 2021-02-25:
@sagarreddypatil I've been looking to do that too.

Assuming the CH340G is the USB-Serial interface we need to steal the TX/RX from (its the only one on the board) the image below should show the route from the CH340G to the ARM chip.

Hesitant to test it myself as the vias are a lot smaller than they look in the pictures/videos and my soldering skills are hit and miss.

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

acremonezi, 2021-12-28:
> Please, give me a diagram of the board (from my ender 3v2) 4.2.2. The fans are not running. Diagram needed for repair.

Please!

I am also looking for any diagram.
My ender 3 v2 mainboard stop sending any Z axis output. I am looking for ways to debut and  fix it.

Please anyone can help anyway?

Thanks!!!

xcasxcursex, 2021-12-28:
I have these files. I don't even know where I got them. They are not official schematics and I can't guarantee they are any good at all. But I've used them for a few things, they seem good. Good luck
[Ender.3.V2.4.2.2.-.Schematic.pdf](https://github.com/Creality3DPrinting/Ender-3/files/7785695/Ender.3.V2.4.2.2.-.Schematic.pdf)
[Ender.3V2.4.2.2.-.Schematic.160521.pdf](https://github.com/Creality3DPrinting/Ender-3/files/7785696/Ender.3V2.4.2.2.-.Schematic.160521.pdf)

acremonezi, 2021-12-29:
> I have these files. I don't even know where I got them. They are not official schematics and I can't guarantee they are any good at all. But I've used them for a few things, they seem good. Good luck [Ender.3.V2.4.2.2.-.Schematic.pdf](https://github.com/Creality3DPrinting/Ender-3/files/7785695/Ender.3.V2.4.2.2.-.Schematic.pdf) [Ender.3V2.4.2.2.-.Schematic.160521.pdf](https://github.com/Creality3DPrinting/Ender-3/files/7785696/Ender.3V2.4.2.2.-.Schematic.160521.pdf)

Thank you Very much in did!

Thread 64 (2020-12-11):

trying to find pin out for creality 4.2.7. retailer claims it is compatible with btt tft35 e3.

cdhunter1010, 2020-12-11:

cdhunter1010, 2020-12-11:
trying to find A pin out for the creality 4.2.7 board. Comgrow claimed it was compatible not seeing any header for it.

jmartens2, 2021-03-29:
Hopefully I’m not too late. could I ask the same question? I’m really interested to find the serial out for a touchscreen board

cdhunter1010, 2021-03-30:
This board doesn't support touch screens. I couldn't get a response from
Creality. I don't think they plan for this to happen with this
particular board. I tested this board for a third party other then the lack
of touch screen support it performed very well.

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

jmartens2, 2021-03-30:
I love the board that’s why I don’t wanna change to a different manufacturer. But I would also like to get rid of the encoder knob. It’s 2021, for heavens sake! Thank you for the reply. Have a great week!

Sent from my iPhone

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

cdhunter1010, 2021-03-30:
Try octoprint gives wifi ability to the printer and can be customized with
plug-ins to better suit your needs

On Tue., Mar. 30, 2021, 5:01 p.m. jmartens2, ***@***.***>
wrote:

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

jmartens2, 2021-03-30:
Info taken. I’m not sure I’m ready for that yet

Sent from my iPhone

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

jmartens2, 2021-03-30:
Thanks

Sent from my iPhone

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

ellensp, 2021-05-20:
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

jmartens2, 2021-05-21:
I’m sorry but I only speak English.

ellensp, 2021-05-21:
The Russian is quite irrelevant, you don't need to it under stand the pin names.

Thread 66 (2021-04-13):

Files are in Altium format.

trininite, 2021-04-13:
Hey was wondering how to open or convert the .pcb file you have attached. I have Eagle CAD and Ki Cad

VinnyCordeiro, 2021-04-13:
>
>
> Hey was wondering how to open or convert the .pcb file you have attached. I have Eagle CAD and Ki Cad

There's a project here on Github called altium2kicad that you try: https://github.com/thesourcerer8/altium2kicad It's still very rough, but it works.

Closed 2023-02-07.

Thread 67 (2021-04-28):

LCD Screen Not Working

adcallow, 2021-04-28:
BRAND NEW straight out of the box Ender 3. Everything set up properly. Triple checked. Disassembled then reassembled. Followed all the Creality and external Youtube video guides which confirmed everything I've done...still nothing. Best next step?

wjsteele, 2021-04-28:
This isn't a technical support group for the hardware... it's best you go back to the vendor you bought it from for technical support.  This is the public repository for the design files for the printer and no one is here from the company that can help you.

adcallow, 2021-04-28:
Got it, sorry I thought this _was_ the company site, as that is who I bought it from...Thanks for not making me feel like an idiot by incorrectly posting here, I appreciate it...I've seen other boards where I would have been lambasted for such a post. Thx

Gismo12, 2021-08-09:
I recently had the same problem blue screen no response, Using 240v 13 A outlet found a 13A fuse in the mains plug, 15A  fuse on the control board and the capacitor C11 near the X limit switch socket completely destroyed along with the adjacent resistors R11 and R4. replaced the fuse in the mains plug with 2 A fuse, probably try a 5A fuse in the control board. There is also a fuse in the power supply socket Switch which is my next target. When I have finished doing this I might fit another 4.27 board ( fitted with a 5A fuse) and re-flash the the firmware. QC control at the factory might have averted the problem if they had fitted the correct fuse on the control Board.

Thread 68 (2021-05-22):

Pinout for creality 4.27 extruder

chRLESCHAVEZ, 2021-05-22:
I replaced my stock extruder on my ender 3v2 with a biqu h2 direct drive the cable was too short so I used the stock cable . I believe the pinout connections of the  H2 stepper motor are different than the stock 42-40 motor. has anybody had the same problem ?.I need the pinout of the mainboard extruder pins so I get the a+,a-,b+,b-, correct. I believe that I damaged the stepper driver  when I used the stock cable when i hooked up the old 42-40 stepper it stutters .

lospheris, 2021-06-26:
Don't right click and save as. Click the link and it will open up telling you that you can't open it in GitHub. There will be a download button. Click that and it will download for you, and open. It did for me anyway.

Thread 69 (2021-05-22):

Help with my extruder Biqu H2 install on ender 3 v2

chRLESCHAVEZ, 2021-05-22:
I replaced my stock extruder on my ender 3v2 with a biqu h2 direct drive the cable was too short so I used the stock cable . I believe the pinout connections of the  H2 stepper motor are different than the stock 42-40 motor. has anybody had the same problem ?.I need the pinout of the mainboard extruder pins so I get the a+,a-,b+,b-, correct. I believe that I damaged the stepper driver  when I used the stock cable when i hooked up the old 42-40 stepper it stutters .

Thread 71 (2021-07-18):

Ender 3 Pro BLTouch + Direct Drive + 4.2.7 Motherboard

birdybro, 2021-07-18:
Hi, the latest firmware provided on the website doesn't seem to include the source code for the changes made to Marlin. I was wanting to use your source code as a base of comparison to modify my own spinoff in Marlin 2.0.8. Are there any changes to the source code of Marlin by Creality that aren't the same in their example configurations repo? If so can you provide the source code so I can see it?

Thank you.

starttraveller, 2021-12-11:
I also am having issues with the Ender 3D PRO upgraded with 4.2.7 board and BLTouch. Anyone have Marlin source code which works?

birdybro, 2021-12-12:
I later found it is best to just figure out how to compile the code yourself, unfortunately. Such a huge pain in the neck. Definitely replacing this with a Prusa hopefully soon. Creality's support is lacking, they don't comply with the GPL, and their build quality is getting worse over time.

starttraveller, 2021-12-13:
Yes, I originally bought the Ender 3PRO which had the 4.2.2 board. I thought upgrading to the 4.2.7 board was going to provide some improvements. Seems that was a waste of $. Then I thought seeing as a lot of my prints weren't sticking to the bed, figured that the BLTouch would have been a good solution. I even ordered the glass bed for ABS prints. Well after so many weeks trying to get the Creality BLTouch to work with the Creality 4.2.7 board and Marlin firmware, I am realizing that in reality it has never been prepared to work together. What a shame! So many unhappy customers. What are they thinking? It would be so easy to make them work together, yet they don't seem interested. Wonder why they are not listening to their customers?

Sent from my iPad,
Regards Lawrence

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

Closed 2021-12-12.

Thread 72 (2021-07-19):

[Ender-3 (includes power failure resume- English)] Extending Filename Length for Ender 3 v2 Factory LCD

9ae8sdf76, 2021-07-19:
Good day!

I have a Creality Ender 3 V2 (4.2.2) with the factory LCD screen (i.e., in portrait mode with the selector knob). I would like to customize my firmware so that it (1) removes the file icon and (2) allows more characters to reach the true edge of the screen.

I do see that the Conditionals_LCD.h defines the `LCD_WIDTH`/`LCD_HEIGHT`, but I am unfamiliar with how to go about adjusting them (if at all) to achieve the effect I'm looking for. I also assume that I need to focus primarily on the [_drawmenu_sd](https://github.com/Creality3DPrinting/Ender-3/blob/master/Ender-3%20Firmware%20(Marlin)/Ender-3%20(includes%20power%20failure%20resume-%20English)/Marlin/ultralcd_im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) function for actually printing the filename? Or is there a better place to look?

Thank you.

Thread 74 (2021-08-25):

Creality3D V1.1.4 + MKS LCD12864A V1.0 screen not working

Kearvan, 2021-08-25:
A new screen has been installed on the stock motherboard. The screen works on the SPI bus, and has contacts DOGLCD_A0, DOGLCD_CS, MOSI, SCK. On the Arduino Uno controller, the screen works correctly when using the u8glib.h library (class U8GLIB_MINI12864).
On Creality3D V1.1.4, the screen does not work. In the Configuration.h file, the screen is written as MKS_LCD12864A.
The DOGLCD_A0 pin of the screen is connected to the LCD_PINS_D4 pin (according to pins_SANGUINOLOLU_11.h).
The DOGLCD_CS pin of the screen is connected to the LCD_PINS_RS pin (according to pins_SANGUINOLOLU_11.h).
Also, to check, the MOSI pin and SCK pin of the screen were connected to the MOSI pin and SCK pin on the board. But the result turned out to be negative - the backlight, the encoder key and the beeper are working, but there is no image at all on the screen.
For verification, a definition was added:
#define DOGLCD_MOSI BEEPER_PIN
#define DOGLCD_SCK LCD_PINS_ENABLE
Defined pins were connected to the screen, but again with no result.

Thread 75 (2021-11-22):

Reading PDF Drilling

davemaster, 2021-11-22:
Greetings,

I bought v-slot profiles and I will try to drill the holes for assembly the frame.

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

What is the meaning of the picture above:
1-    4 x 5.2 are 4 holes of 5.2 mm diameter?
2-   9.5 +- (symbol) 5.8 what it means?

Thanks in advance

VinnyCordeiro, 2021-11-22:
It means that you have 4 through holes of 5.2mm of diameter, and those holes have a counterbore of 9.5mm of diameter that goes 5.8mm deep.

davemaster, 2021-11-22:
All Clear, thanks a lot

El lun., 22 de nov. de 2021 14:49, VinnyCordeiro ***@***.***>
escribió:

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

Closed 2022-01-17.

Thread 76 (2021-12-16):

Ender 2 Pro (Creality 4.2.3 mainboard)

spuder, 2021-12-16:
I can't find any documentation / firmware for the Creality 4.2.3 mainboard. Could you please create a new repo with Ender-2 configs?

## Related
- https://github.com/MarlinFirmware/Marlin/pull/23307
- https://github.com/MarlinFirmware/Configurations/pull/633
- https://3dprinting.stackexchange.com/questions/18567/how-to-tell-if-i-have-tmc2208-or-a4988-drivers-on-creality-silent-v4-2-3-board

Thread 77 (2021-12-28):

Ender 3 V2 "Z movement Stop working"

acremonezi, 2021-12-28:
Hi everyone,

**My issue:** My Ender 3 V2 (Mainboard v4.2.2), Z output Stop working.

I believe that the problem is on the main board once I have already checked cabling, motor and mechanics eliminating the possibilities out of main board.

Looks like the Z output is Dead.

I have also uploaded new **jyers** firmware to eliminate any software issue.

I would like to fix it before consider change the main board. Probably there are any driver's  protection component opened.

Please anyone have the circuit diagram? Or any information that can help me debugging this issue?

Thank you very much in advanced.

Alcides

Thread 78 (2022-01-13):

Help Needed with Printing

Easylemon24, 2022-01-13:
Hello,

i just bought a Ender 3 V1 and i am pretty new at 3D printing with the Ender. I have the Issue if i try to print even the standard things like the Dog that comes with it starts printing like normal but the Filaments dont stick to the Plate. Does anybody know how i can fix this?I am using PLA

sincerely Easylemon

davemaster, 2022-01-13:
This is a leveling issue. Did You read the manual? Search about "leveling". Also, You can try put some glue to your plate.

Best regards

Easylemon24, 2022-01-14:
Thanks gonna try it out later

Easylemon24, 2022-01-14:
This really worked out thanks again :D

Easylemon24, 2022-01-14:
Okay now i have another Problem, it does print know but the parts dont stick longer then 20 Minutes on the Plate... What can i do?

davemaster, 2022-01-14:
pls, share pictures, sometimes, those says a lot more than words.

Try to work on your slice software, I mean, the slice size

Easylemon24, 2022-01-14:
How do i calibrate it? and i send you some Pictures in a few minutes

davemaster, 2022-01-14:
Did the printer kit come with a Manual-Quick Start guide?

Easylemon24, 2022-01-14:
no

Easylemon24, 2022-01-14:
![Uploading t2{c8bc4ca} (be0301fd-f6ab-4ddd-85b3-75de9bd6d9a9 id=0x7f0a039e tag=BaseCommentFragment) …]()

Easylemon24, 2022-01-14:
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

zero4281, 2022-01-14:
You can find a number of Youtube videos that explain how to level it.

davemaster, 2022-01-14:
First, download or read those files in here:

https://github.com/Creality3DPrinting/Ender-3

let me know when You done.

It's not an easy job to make a calibration, You must learn/read a lot. In Youbute are a lot of material, but, I don't know what exactly 3D Printer do You purchase (without manual? ... a cheap one)

davemaster, 2022-01-14:
try

https://www.youtube.com/watch?v=6PL_rSPZ3M8
or
https://www.youtube.com/watch?v=M8bTi2C67nI

Easylemon24, 2022-01-14:
> It's not an easy job to make a calibration, You must learn/read a lot. In Youbute are a lot of material, but, I don't know what exactly 3D Printer do You purchase (without manual? ... a cheap one)

It was the Ender 3 v1
and i watched the Youtube Video for the Ender 3

I am currently making some tests on my Bed to see if anything is right there...

Easylemon24, 2022-01-15:
Okay i did the "Guide" and it helped very much i found out that idk why i need to move the filament ca. 4 mm away from the extruder and then it prints nearly perfectly.

davemaster, 2022-01-16:
Share a printing picture. Best regards

Easylemon24, 2022-01-16:
> Share a printing picture. Best regards
I just wanted to remove a Print that i did over night and this got left on the plate but i cant get it off...do you know any tips?
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

Easylemon24, 2022-01-17:
Okay i got it off i am currently wondering if i can get it to work now because now it does print but the print doesn´t stick and yes i leveled it... if i doesn´t get it fixed with in the next hour i send a pic

Easylemon24, 2022-01-17:
Okay so i got it to work but after the print i am currently doing i am going to clean my Plate thanks to you all for the Help 🗡️

Easylemon24, 2022-01-17:
Okay i thought so until it just got off....

Easylemon24, 2022-01-17:
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

Easylemon24, 2022-01-17:
I also dont know if this has something to do with this but the Plate is also very smooth in the middle... i just hope i dont need a new plate/cover...

davemaster, 2022-01-17:
but, the printer is NEW, right? Do an extruder calibration too

Easylemon24, 2022-01-18:
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

Yea i did if you mean this

Easylemon24, 2022-01-18:
Yea i did if you mean this but i do it again today

davemaster, 2022-01-18:
The Z alignment? Then, Print the 20mm cube... you have a Z - axis problem I
think, don't give up
 video(3).MP4
<https://drive.google.com/file/d/1bm-mwoAn_rBVA9fr1rNzEMQ-eS2ltmxp/view?usp=drive_web>

El lun, 17 ene 2022 a las 23:38, Easylemon24 ***@***.***>)
escribió:

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

--
David Elias Flores Escalante
TeleTracking SAC

Easylemon24, 2022-01-18:
I cant open the drive link... but i look if i find some tutorial for the z axis

davemaster, 2022-01-18:
this goo... convert into a link instead attach the video,

El mar, 18 ene 2022 a las 1:34, Easylemon24 ***@***.***>)
escribió:

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

--
David Elias Flores Escalante
TeleTracking SAC

davemaster, 2022-01-18:
Ill try to share with your email

El mar, 18 ene 2022 a las 1:37, David Elias Flores Escalante (<
***@***.***>) escribió:

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

--
David Elias Flores Escalante
TeleTracking SAC

davemaster, 2022-01-18:
https://drive.google.com/drive/folders/1_vxXh78No0t47qwWoflvh0ZX1Urmu71y?usp=sharing

Easylemon24, 2022-01-21:
I have to say that i did that and I even seaeched for other Videos but it didnt help/ i couldnt do it for e.g. there where Some thing i didnt had on my printer

Closed 2022-04-06.

Thread 83 (2022-07-23):

Ender 3 won't maintain printing temp. - Electrical/firmware?

PrinceDisciple, 2022-07-23:
I run 2 Ender 3 model printer, just the regular ancient Ender 3machines, one I run on 0.8mm nozzles for some less detailed jobs and the other I run at 0.4mm.

After years I've finally upgraded them to all metal hot-end's, now that I'm mostly printing PETG or other CoPolyesthers - I used Bi-Metal Heatbreak inserts for this (titanium/copper). (I tried microswiss hot-ends but they just were to finnecky to get dialed in with PLA and kept jamming even with all the recommended tuning to retraction printing temp and print speed etc.).

In general this seemed to work great on my 0.8mm machine, only with PLA I still had too many issues, especially when printing at lower speeds due to heat-creep.
So after some searching online I concluded that I had to switch out the hot end coolling fan. I went from the Stock Ender Fan to a cheap 4020 fan producing roughly 9.7 CFM @ 0.1A 24V. Which eliminated the issue for the most, but still there was an occasional jam, with heat-creep being the culprit again.
So I upgraded the fan to a 16.2 CFM @ 0.2A 24V and that worked perfect.

However on my 0.4mm machine I noticed when running it that at first I had a lot of underextrusion, printing PLA @ 200C.
I figured this was reasonable as it is recommended to turn up the temperature a bit when going all-metal.
When printing at 225C it printed perfect again with PLA.
Then on one occasion I was monitoring a specific print and I noticed the heating cycle of the 0.4mm machine took quite long, I also noticed that when the machine had reached the printing temp. It instantly dropped to 195-200C within the first two layers, never getting back up to 225C again...

Because of this I've ran several tests to figure out what's wrong, but it's throwing me for a loop... It seems regardless of what temperature I choose it now permanently hovers 5-15C lower than any temp I assign it to, with part-cooling on even as much as 25C. When I run a diagnostic without any cooling at all (no hot-end fan on or part-cooling on) the hot-end heats up to any desired temp, no issue at all.
It's almost as if the hot-end is not getting enough current or something?

What I've tried so far in more or less chronological order.:

re-tune PID
Did not make a significant difference.

replace the stock heater cartridge and thermistor - suspecting one or both to be damaged.
Worsened the issue since stock is 40W and I only have 30W as spares. Ran the test with and without part cooling, both tests with hot-end cooling on.
Hot-end was not able to get even close to 260C maxing out at 220C.

Put in a 12V 50W cartridge I had lying around, and tested it with hot-end cooling on as well as max power on the part cooling fan. - assuming the cartridge is still the culprit.
Firstly, I am aware of how stupid and dangerous this is and that [@24V](https://www.thingiverse.com/24V/about), you're running a 200W unit, but it was just to test and under controlled conditions. It did however heat up and maintain temp (with some 6-9C jumps) without any issue at all.

Run a diagnostic with no cooling at all. To see how severe the influence of cooling would be.
Which worked, printer was able to attain all desired temperature settings with decent ease.
Leading me to believe that maybe the power of the hot-end cooling fan was the issue and that 16.2CFM is simply too much, or the hot-end cartridge is still to anemic.

Changed the geometry of the hot-end housing I designed so that less air is blowing directly on the heat-block.
Ran another diagnostic with the improved hot-end housing, both with the 9.7 CFM fan and 16.2 CFM.
The printer was completely incapable to get up to temp (target 260C), this was worse with the more powerful fan of course.
So the geometry change made no real difference unfortunately.
Everything is using a silicone insulating sock on the heater block as well.

It's really confusing, since the 0.8mm machine which has the exact same set-up than the 0.4mm machine, has none of these issues.
The 0.8mm machine heats up to 260C with the 16.2CFM fan as a hot-end cooling fan and a 9.7CFM fan for part cooling both at full blaze. And it does so in less than 5 minutes. It 'maybe' drops 2C at most @ 260C. The most infuriating, is that the 0.8mm machine runs a 30W heater...

So I'm a bit lost, the only thing I haven't looked into is how old both machines exactly are and if they're running different boards.
Or if the boards produce different currents. Or if it's maybe firmware related.

The 0.8mm machine is one I bought new in 2019 and I have update the firmware in 2021 on it.
The other printer I bought second hand and have no idea how old it is and what firmware it runs exactly.

Has anobody got any suggestions? So far what I'm going to try still is put a heavier heater on there, I've ordered both 50W and 70W @ 24V.
Although I don't want this as a permanent fix because of safety tbh.
Maybe the board is toast? Or is the firmware messed up? - I really have no real issue where to look especially since my electromechanics isn't up to par.

Any help would be greatly appreciated.

TL;DR
Upgraded my two [Ender 3](https://www.amazon.com/Official-Creality-3D-Removable-220x220x250MM/dp/B07K3SZBHJ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) printers to all metal, one machine is running without issues, other machine cannot get up to temp not even to save it's own life. One runs 0.8mm nozzle the other 0.4mm, the 0.4mm machine has issues.

I swapped out:
The heat break for a titanium/copper heatbreak.
The hot-end Fan for a 4020 CFM 9.7 fan and later for a 4028 14.6 CFM unit
The heatercartridge on the 0.8mm machine from 24V 40W to 24V 30W - other machine runs stock 40W cartridge.
A custom housing for the hot end to direct cooling as much towards the heatbreak and heatsink as possible.

Other than the heater cartridge the machines are 100% identical in terms of hot-end set up.

The 0.4mm machine just can't seem to hold temperature or get to temperature when cooling is on.

kiki126, 2024-11-05:
hi, If your Ender 3 isn’t maintaining printing temperature, the issue could be either electrical or firmware-related. Here’s how to troubleshoot:
1. Check the Thermistor and Heater Cartridge
Loose or Damaged Wires: Inspect wiring to the thermistor and heater cartridge. Loose or frayed connections can cause temperature fluctuations.
Connector Pins: Ensure connectors are securely plugged into the mainboard and show no signs of damage or corrosion.
2. Power Supply
Voltage Setting: Verify that your power supply is set to the correct voltage for your region (110V or 220V).
Stable Output: A faulty power supply may drop voltage, affecting temperature stability. If the power supply shows signs of inconsistency, consider replacing it.
3. Firmware Settings
PID Tuning: Run PID tuning in the firmware to help the [3d printer](https://kingroon.com/collections/fdm-3d-printer) maintain a stable temperature. Many issues with temperature fluctuation can be resolved this way.
Firmware Updates: Ensure your firmware is up to date, as newer versions may include fixes for temperature management.
4. Heater Cartridge Replacement
If none of the above resolves the issue, the heater cartridge itself might be faulty and unable to maintain heat. Consider replacing it as a last step.
By checking these areas, you can isolate and resolve temperature maintenance issues on your Ender 3.

Thread 84 (2023-01-26):

ender 3 - temp issue on display with bed and nozzle temp PLZZZZ HELP!!!

mikedattolo, 2023-01-26:
Hey, I have been working on a 3d printer prototype using an ender 3 frame and a btt octopus board and Marlin, my only issue right now with the printer is that when I set the nozzle temp, it sets it and raises it, which is normal, what's not normal is that it also raises the temp number on the bed even though a number isn't set and it doesn't heat either and that when I do go and set a temp for the bed it does heat up, but it is not displaying a temp when heating, it only shows the nozzle temp and doesn't register the bed thermistor and gives an error that the bed isn't heating even though it is, I have tried redefining the pins for the thermistor and changed the pin to another slot, but it gives me a TMC error when doing this, I don't know why or how this is happening either. if I could have help with this, it would be greatly appreciated.

davemaster, 2023-01-26:
Greetings,

First, what firmware are You trying to use...

mikedattolo, 2023-01-26:
> Greetings,
>
> First, what firmware are You trying to use...

I am using Marlin 2.0.9.5

davemaster, 2023-01-26:
what thermistor in bed? Model and picture pls

mikedattolo, 2023-01-26:
> what thermistor in bed? Model and picture pls

100K ohm NTC 3950FB Thermistor is used, and I should be home shortly to send images

davemaster, 2023-01-26:
As soon you get home, try to check the connection of the therm... with the board... even with a len, check the cables are properly inserted in the thermistor board. This is the most common issue. If the connection are 100% probed well, try with another thermistor, may be you are unlucky and buy a defective therm...

best regards

mikedattolo, 2023-01-26:
I checked both connections and even on the bed as well. Here are some photos I took. The first one is the board with the two thermistors plugged in, the second is what the display normally shows, and then the third photo is what happens when I set the nozzle temp without touching the bed temp at all
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

mikedattolo, 2023-01-26:
i hope these help

> As soon as You get home, try to check the connection of the therm... with the board... even with a len, check the cables are properly inserted in the thermistor board. This is the most common issue. If the connection are 100% probed well, try with another thermistor, may be you are unlucky and buy a defective therm...
>
> best regards

I hope these help

davemaster, 2023-01-26:
If You remove the bed therm.... what happens? preheat the noozel heat, then disconnect (with the noozle in heat) the bed therm and puth the noozle/head in the bed place... check lectures in the lcd

mikedattolo, 2023-01-26:
> If You remove the bed therm.... what happens? preheat the noozel heat, then disconnect (with the noozle in heat) the bed therm and puth the noozle/head in the bed place... check lectures in the lcd

When the bed pin therm is removed, nothing happens, it still shows that there is a temp on the bed, which obviously isn't normal considering the therm is removed. I tried heating the nozzle, but it still shows the bed heating up alongside the nozzle. When the nozzle is disconnected the bed shows 0 and an error on the nozzle. I tried plugging the bed therm into another port other than the dedicated therm bed port, and it still doesn't change anything

mikedattolo, 2023-01-26:
I also tried switching the pin config with the other port for the bed, and it does show 0, which is new, but.... now when I go to heat it, it comes up instantly with a heating error

davemaster, 2023-01-26:
The thing is, make that change, whatever is working will change temperature, so the voltage over the connection in the board, this is for know if its the sensor/therm or worst, THE BOARD input for sensor, this Analog port can be broken, that's why I would change sensor in the other port to test if as well as it cooled, then show changes in temperature over the LCD

pictures to your code, do You define the EXACT model of board in #define board MY_BOARD (OR Whatever), the  ports (analog) are different between different boards... check it out

davemaster, 2023-01-26:
> I also tried switching the pin config with the other port for the bed, and it does show 0, which is new, but.... now when I go to heat it, it comes up instantly with a heating error

It never CAN SHOWS zero, but the environment/room temperature .... if it is OK

davemaster, 2023-01-26:
the heating error is because once you activated the heating process, the thermistors reading are not showing appropiate lectures, the port of your board can be broken too

mikedattolo, 2023-01-27:
> the heating error is because once you activated the heating process, the thermistors reading are not showing appropiate lectures, the port of your board can be broken too

So I had my friend, who knows more than I look at it, and we actually fixed the problem. Apparently, the bed pin on the btt octopus was broken somehow jumping and connecting to the nozzle thermistor pin which is why it also read the same as the nozzle, and we figured out why we simply couldn't change the pin to another thermistor port and change the config so that it was changed to that new port without an issue and now have resolved the issue and now everything works, thank you for your help it was greatly appreciated :)

davemaster, 2023-01-27:
Great You can fix your issue... best regards

Closed 2023-03-24.

Thread 85 (2023-01-29):

Ender 3 Filament slipping, tried everything to fix help plzz

mikedattolo, 2023-01-29:
So I recently just fixed a thermistor issue with a modified ender v2 that I am using for a prototype 3d printer. I am using a btt octopus board and marlin 2.0.9.5 to run this printer, and I just tried running my first print, and it failed because of the fact that the extruder motor is trying to push filament into the hot end, and for a couple of seconds it flows smoothly and then it proceeds to make a noise as the gear pushing the filament skips. However, I have looked at everything by taking apart both the extruder and the hot end, even going as far as replacing the extruder motor, and the issue still is here. Nothing is wrong with either the hot end or the Boden tubing. The hot end gets up to temp, which I have set to 220C, and the Boden tubing isn't clogged or deformed in any way. I have been told to try increasing the temp, which didn't work. I have also ensured that there is no clogging and tried to tighten the spring and handle on the extruder. Yet nothing seems to help my problem. Before I go out and buy a new extruder assembly or a new hot end/nozzle, I was hoping someone could help me figure this out plzzz and thank you

mikedattolo, 2023-01-29:
> So I recently just fixed a thermistor issue with a modified ender v2 that I am using for a prototype 3d printer. I am using a btt octopus board and marlin 2.0.9.5 to run this printer, and I just tried running my first print, and it failed because of the fact that the extruder motor is trying to push filament into the hot end, and for a couple of seconds it flows smoothly and then it proceeds to make a noise as the gear pushing the filament skips. However, I have looked at everything by taking apart both the extruder and the hot end, even going as far as replacing the extruder motor, and the issue still is here. Nothing is wrong with either the hot end or the Boden tubing. The hot end gets up to temp, which I have set to 220C, and the Boden tubing isn't clogged or deformed in any way. I have been told to try increasing the temp, which didn't work. I have also ensured that there is no clogging and tried to tighten the spring and handle on the extruder. Yet nothing seems to help my problem. Before I go out and buy a new extruder assembly or a new hot end/nozzle, I was hoping someone could help me figure this out plzzz and thank you

Another note to add is that the filament is new but is making a popping sound when coming out of the hot end, and I have tried reducing the print speed to 30mm rather than the normal stock speed at 60mm which didn't work either

mikedattolo, 2023-01-31:
please can someone help

zero4281, 2023-01-31:
I had something similar happen once and all I had to do was take the extruder apart and clean it.

mikedattolo, 2023-01-31:
> I had something similar happen once and all I had to do was take the extruder apart and clean it.

I have taken apart the extruder , cleaned it , checked the Boden tubing , even replaced the motor on the  extruder , yet idk what would still be causing this problem

zero4281, 2023-01-31:
> > I had something similar happen once and all I had to do was take the extruder apart and clean it.
>
> I have taken apart the extruder , cleaned it , checked the Boden tubing , even replaced the motor on the extruder , yet idk what would still be causing this problem

If you push the filament through manually, does it still have issues?  If not then it's probably related to the extruder, if it is then look closer at the hotend.

mikedattolo, 2023-01-31:
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

it flows alright for a couple of seconds but then resists and the filament starts to circle around itself when coming out of the extruder, yet the hotend/nozzle is at 220C so IDK why that would be happening, I disassembled the whole extruder and it wasn't clogged at all either and the boden tube is sitting correctly inside so

zero4281, 2023-01-31:
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

It sound like a clog that you can't see.  I had this happen once.

Try taking the bowden tubing off of the hot end and push the filament into the hotend after it's at temp.  Then turn it off and wait for the hotend to cool down to about 160 and then try pulling it out.  It should have some resistance, but you should be able to get the whole thing out.  This is called a cold pull and it can remove any debris, like carbonized filament from the nozzle.

mikedattolo, 2023-01-31:
I tried this however i could not achieve

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

I tried this however could not achieve a cold pull , something did come out tho , however still having the issues and with the tub removed and manually pushing the filament through I hear a faint clicking noise pushing the filament through the nozzle

zero4281, 2023-02-01:
Okay, so you did remove the bowden tubing from the hotend and tried a cold pull?  Try only heating it to 185 and trying the cold pull again.  You just have to find the right temp to pull at.  Once you get it you should see a larger bit of filament at the end.  If you can't get it I'd try replacing the nozzle, but it could be a small clog.

mikedattolo, 2023-02-01:
> Okay, so you did remove the bowden tubing from the hotend and tried a cold pull? If you're not using the extruder and still have bad results then it's probably not the extruder. Try heating it to 185 and trying the cold pull again. You just have to find the right temp to pull at. Once you get it you should see a larger bit of filament at the end. If you can't get it I'd try replacing the nozzle, but it could be a small clog.

I've tried it 3 times now and have been doing 185C so

mikedattolo, 2023-02-01:
and i tried switching the tip on the nozzle and its still happening and its not a heating issue so

zero4281, 2023-02-01:
Maybe try the filament in a different printer.

mikedattolo, 2023-02-01:
its a brand nre

> > and i tried switching the tip on the nozzle and its still happening and its not a heating issue so
>
> Did you try a different filament. Popping can be moisture content.

its a brand new spool of filament got it not even 2 days ago

zero4281, 2023-02-01:
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

Unfortunately that doesn't answer my question.....

mikedattolo, 2023-02-01:
I dont have any other brands of filament at the moment

zero4281, 2023-02-01:
> I dont have any other brands of filament at the moment

You could try drying over night it in your oven at the lowest temp it will go to, but this isn't a great method.  I have had some success with it though.  Crack the oven door to let the humidity escape.....I'm running out of tips an tricks.

Closed 2023-03-24.

Thread 86 (2023-02-04):

Nozzle temp keeps dropping and Im not sure why Plllz help!!

mikedattolo, 2023-02-04:
So I am working with a Btt octopus board inside of an Ender 3 V2, and I have been coming here a lot for help because of unforeseen problems. As I keep fixing these issues, I keep running into more. My most recent issue is that I am trying to do a first print, and my nozzle temp is set to 220C, and the bed is set to 50C. It is fine as it starts, but as soon as the part cooling fan kicks on, the temperature crashes down to 200C or lower. It tries to bring itself back up but usually ends with a Thermal runaway error. Yet this isn't the first appearance of this issue, even sometimes without the bed heated or any fans on at all, and I try to heat the nozzle, this also happens. I have a silicone sock on the nozzle, as I was told that it might be losing heat due to a fan, yet this doesn't seem to be causing the issue because I disabled the fans and tried heating it, and it still occurs. I have checked all connections, and there are no loose cables or anything. I have even tried doing PID autotuning with the fans on, as I have been told that this might help, and I still have this issue. I was even told that it could be a bad nozzle and that I should replace it, yet I wanna hear someone else's input. I have even been told that it might be a weak power supply or an electrical issue, yet when asked how to fix it or what is causing it, I was never given an answer. So I would really appreciate some help here, and thank you in advance.

mikedattolo, 2023-02-05:
anyone plzzz help

davemaster, 2023-02-06:
check firmware, the top temperature for your nozzle, it can be

mikedattolo, 2023-02-06:
> check firmware, the top temperature for your nozzle, it can be

It can be what?? and my top temp is 260

davemaster, 2023-02-06:
the MOSFET of nozzle can be then...
check the nozzle alone

mikedattolo, 2023-02-06:
> the MOSFET of nozzle can be then... check the nozzle alone

wdym can you give a full explanation plz

mikedattolo, 2023-02-06:
> the MOSFET of nozzle can be then... check the nozzle alone

if it were the mosfet it would be a maximum temp error, I am having thermal runaway because of the temp dropping low

mikedattolo, 2023-02-06:
but I have no clue anymore and I need a better explanation

davemaster, 2023-02-06:
> but I have no clue anymore and I need a better explanation

Do You know what a MOSFET is??? NO??? try same nozzle with another BOARD, try also the nozzle alone

Thread 87 (2023-03-24):

output specs of the Bed and Fan+ connections on a V4.2.7 board.

moltra, 2023-03-24:
I am getting ready to install a BIGTREETECH SKR Mini E3 V3.0 board Ender 3 Pro board in my Ender 3 Pro, but the Sovol3D 40 watt laser instructions recommends jumpering the Bed and Fan+ terminals.

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

Does anyone know what the current / power limits are for the bed and fan circuits are?

Thread 88 (2023-03-28):

Ender 3 pro not heating for print

KSI-Starshot, 2023-03-28:
My Ender 3 pro is having a software issue very similar to a pid issue back in 2021. I have recently upgraded to a crtouch and updated the software but ever since I cannot get it to heat to operating temp on cold start or even while printing. Changed out the hot end and that’s not the issue. But it hovers 10c below and hops up to 10 below then cools rapidly and heat’s slowly back up to 230 instead of the 240 target temp. My board is a 4.2.2. No upgrade to board just dual z and direct drive

KSI-Starshot, 2023-04-23:
found out the problem was in the software. changed it to a third part code and works fine ever since. the crtouch software still has the old heating bug in it.

Thread 90 (2023-06-25):

Can I reverse diode on +5V USB

cypamigon, 2023-06-25:
Hello,

I would like to know if it's possible to reverse the diode between +5 V and USB VBUS ? I would like the printer to act as USB HOST so that she can provide power through micro USB port.
Thanks !

cypamigon, 2023-06-25:
I am talking about this diode :

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

Thread 91 (2023-07-27):

Ender 2 pro vith V2.4.S4 mainboard

Klulle, 2023-07-27:
I don't think the board is a problem but when I try to compile Marlin (downloaded from https://github.com/CrealityOfficial/Ender-2-Pro)
I get an error message, STM32F103RET6_creality FAILED.
I know the compiler (VS Studio Code) cannot know what board I have.
I there something I'm missing? What changes should I make in the congiration an platformio.ini files to make it work?

Thread 92 (2023-09-14):

Ender 3 pro extruder plastic support broken - looking to change the extruder?

andreigabriel4, 2023-09-14:
Hello everyone,

I had an issue with my Ender 3 pro printer, nothing came out from the hotend, filament feed wouldn't work. First thing I did was to check the nozzle for clogging but that was not the issue (I also changed the nozzle to a brand new one) and then I tried to manually feed the filament and that worked so I thought that the issue must be from the extruder.
I checked some youtube videos and came across one named "Ender 3 Filament Feed Issue - Solved" where a guy showed that you should check the U-Shaped Bearing, "just adjust the bearing to align it with the gear". So, naturally, I pulled the plastic support trying to adjust the bearing and broke it so I need to replace either the part or the extruder.

This is a good opportunity to make an upgrade so after making some research I would like some recommendations. What should I choose?
1. Just replace the broken part (probably just the plastic block with an aluminium block)
2. Replacing with a dual drive extruder [the red cheap one]? (I saw some mixed opinions regarding this option)
3. Switch from a bowden tube to a direct drive extruder (solutions like the BMG, swiss, sprite or other extruders)
4. Other solution?

PS. I'm mainly using my Ender 3 printer to make lithophanes and litho' housing. (will upgrade in the future)

Thank you and I appreciate all of your help.

andreigabriel4, 2023-09-14:
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

I just added a picture of my extruder so you can see how nicely I broke it.

VWguyBruce, 2023-09-14:
If you're planning to keep it as your workhorse until you upgrade, keep it stock.

Fastest way to get back up and running.

https://www.amazon.com/Creality-Official-Extruder-3D-Aluminum/dp/B09LQKN5WG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

andreigabriel4, 2023-10-03:
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

Thank you for recommending @VWguyBruce, I bought the Aluminum extruder, installed it and works perfectly. This should do the job until i upgrade. (I'm currently trying to decide between the Bambu lab P1P or Creality K1 Max)

Closed 2023-10-03.

Thread 93 (2023-11-23):

Princore pellet extruder

Ravishankar333, 2023-11-23:
Im having trouble with the connection of pellet extruder. extruder stepper motor is not working. anyone know how to give the connections? there is no circuit diagram to connect.

Thread 94 (2024-02-19):

Thermal runaway

Kwiatens, 2024-02-19:
I had many thermal runaways. I replaced the thermistor - and it's fine, but it should not happen in the first place.

Closed 2024-02-19.

Thread 95 (2024-08-15):

The role of using bulk PLA filaments in 3d printers for furniture

master611, 2024-08-15:
The use of [bulk PLA filaments](https://kingroon.com/products/10kg-pla-filament-1-75mm) in 3D printing of furniture can offer several advantages and benefits, and buying bulk PLA filaments is often more economical than buying pre-packaged rolls. This can save costs, especially for projects that require a large number of printed furniture parts.
The length can be customized, and the use of bulk PLA filaments can be tailored to the required length, avoiding waste and ensuring more efficient use of filaments.
Bulk PLA filaments can reduce the use of packaging materials and help reduce plastic waste.
You can tailor the color and length of PLA filaments to the specific needs of your furniture project to meet your design requirements.

Thread 96 (2024-08-15):

Why is it safer to use petg filament for printing?

master611, 2024-08-15:
There are several reasons to consider PETG material as a relatively safe 3D printing material:

Non-toxic: PETG (Polyethylene terephthalate) is a food-grade material that is generally considered non-toxic. This means that no harmful substances are released when printing and handling PETG.
Food contact safety: Because PETG is commonly used in food-contact applications such as food packaging, it is considered safe and does not pose a risk to human health.
Heat and chemical resistance: PETG has good heat and chemical resistance, which makes it more suitable for some applications that need to withstand high temperatures or contact with chemicals.
Low volatile organic compounds (VOCs) release: Compared to some other plastic materials, such as ABS, PETG releases less VOCs during printing, so it has less health impact when used indoors.
Easy to print: Compared to some other engineering plastics such as ABS, PETG is easier to print and does not require a high temperature heating bed, reducing the impact of thermal stress on the printer parts.
So using [petg filament](https://kingroon.com/collections/petg-filament) for printing is safer.

Thread 100 (2024-09-07):

Benefits of using PEGT in furniture 3D printers

kiki126, 2024-09-07:
With the continuous progress of science and technology, 3D printing technology has penetrated into various fields, and furniture manufacturing is no exception. PEGT (polyethylene terephthalate), as a commonly used 3D printing material, has shown many advantages in furniture manufacturing.
PEGT material has excellent mechanical properties, high strength, good toughness, and can meet the durability needs of furniture in daily use. This means that furniture printed using PEGT materials can withstand greater pressure and impact, and is not easy to damage, thus extending the service life of the furniture.
PEGT materials also have excellent heat and chemical resistance. In the process of furniture use, it is inevitable to encounter high temperature or chemical corrosion, and PEGT materials can effectively resist the influence of these external factors to maintain the stability and safety of furniture.
In addition, the surface smoothness of the [PEGT filament](https://kingroon.com/collections/petg-filament) is high, and it is easy to carry out subsequent processing and treatment. This provides more possibilities for the design of furniture, and designers can carry out personalized engraving, painting and other processes according to needs to create unique and beautiful furniture works.
It is worth mentioning that the PEGT material generates less waste during the printing process, and the material itself can be recycled, which is in line with the concept of environmental protection. This makes furniture 3D printing not only in technology, but also in the environmental level has been widely recognized.
In summary, the application of PEGT materials in furniture 3D printing has brought higher efficiency, lower cost and more design possibilities to the furniture manufacturing industry, and also provided consumers with more durable, safe and environmentally friendly furniture choices.

Thread 99 (2024-09-07):

The problem of ABS filament shrinkage

kiki126, 2024-09-07:
About the shrinkage rate of ABS filament
In the 3D printing process, the shrinkage rate is an important factor that cannot be ignored. The shrinkage rate of ABS materials is usually between 0.4% and 0.9%, which is affected by many factors such as material composition, processing temperature, mold design, and so on. Higher processing temperature may lead to increased material fluidity and increased shrinkage. The design of the mold, such as gate location, runner layout, etc., will also have an impact on the shrinkage rate.
In order to reduce the shrinkage rate of ABS filament, some measures can be taken, such as adding glass fiber or other reinforcing materials to the raw material, which can effectively reduce the shrinkage rate to 0.2-0.4%. In addition, making PC/ABS alloy materials is also an effective way to reduce the shrinkage rate, which can be reduced to about 0.4-0.5%.
Understanding and controlling the shrinkage rate of [ABS filament](https://kingroon.com/collections/abs-filament) is essential to ensure dimensional accuracy and stable performance of 3D printed products. In the actual production process, it is necessary to consider various factors comprehensively, and reduce product size deviation and deformation by adjusting processing parameters and optimizing mold design.

Thread 101 (2024-09-09):

How to adjust Core XY printer to improve print quality

kiki126, 2024-09-09:
Core XY printer as an efficient printing equipment, in the process of use, we can improve its print quality through some simple adjustments. As a long-time[ core xy printer ](https://kingroon.com/products/kingroon-klp1-corexy-3d-printer-with-klipper-firmware)enthusiast, here are some of my key steps and tips to help you get clearer and more accurate prints.
Choose the right paper: The choice of paper is crucial to print quality. Using high-quality, printer-specific paper can significantly improve printing results. Make sure the paper specifications (such as size and type) match the printer Settings to avoid using damaged or bent paper.
Adjust the print resolution: Increasing the resolution setting (such as 600 DPI or above) in the print preferences can make the printed text and images clearer and more detailed. This step can be adjusted through the printer control panel or Print Preferences in your computer software.
Clean print heads: Clogged print heads are a common cause of poor print quality. According to the user manual of the Core XY printer, periodically use the printer's built-in cleaning function or manually clean the print head to ensure an even distribution of ink.
Update printer drivers: Outdated drivers can cause a variety of printing problems, including reduced print quality. Check and update printer drivers regularly to the latest version to ensure optimal printer performance.
Adjust the printing speed and temperature: In the pursuit of high print quality, the appropriate reduction of the printing speed can ensure that the ink is fully attached. At the same time, depending on the type of material used, the printing temperature is adjusted to optimize the printing effect.
Through the above methods, you can effectively improve the print quality of Core XY printers. Regular maintenance and proper setup are the key to keeping the printer running efficiently. Hopefully, these steps will help you get a satisfactory print result.

Thread 102 (2024-09-13):

An effective method to solve the problem of PLA wire plug

kiki126, 2024-09-13:
In the 3D printing process, the plug problem of PLA wire often causes problems for makers and enthusiasts. The plug not only affects the printing efficiency, but also may lead to the decline of the printing quality. This article will introduce several methods to solve the problem of PLA wire plug in detail, to help users effectively deal with this common fault.

First of all, clogged nozzle is one of the most common problems. After each printing, the nozzle is not cleaned in time, and the residual material solidifies in the nozzle is the main cause of blockage. Methods to solve this problem include: first heating the nozzle to the normal temperature of PLA consumables melting, usually between 195 ° C -220 ° C. Then, try to manually insert the wire into the nozzle. The downward pressure of the manual feed will cause the consumable wire to penetrate and bring out the blocked residue. If the nozzle still does not produce the wire normally, you can use a 1.5mm six-edge wrench to dredge the throat or nozzle. In daily maintenance, the nozzle must be emptied as soon as possible after printing to avoid solidification and blockage of residual materials.

Secondly, the loss of the consumable line is also one of the common reasons for the plug. In the feeding process, if the consumable line is damaged, it is easy to get stuck in the pipe, affecting the normal feeding. The solution includes: return the material and cut off the damaged part of the consumable line, and then re-feed, pay attention to maintain the smoothness of the consumable line. The use of high quality PLA wire can reduce the plug problems caused by impurities and expansion.

In addition, the nozzle heating temperature is not up to standard is also an important reason for not producing silk. Check whether the heating temperature setting of the nozzle matches the melting temperature of the consumables. If the temperature setting is correct but the nozzle is not heated normally, check whether the heating rod and heating resistor are in poor contact. The ABS printing nozzle temperature is between 210 ° C and 230 ° C, and the PLA printing nozzle temperature is between 195 ° C and 220 ° C, ensuring that the correct temperature setting can effectively prevent plugs.

The cold pull technique is another effective solution. The trick is to wait for the temperature to drop slightly below the freezing level and quickly pull the wire out, at which point most of the wire should be solid. In this process, the solid wire will carry out scattered residue in the hot end. Cut off the contaminated part and repeat the process until the pulled out wire is clean. Then, insert the real wire into the extruder, replace the piece of wire used for cleaning, and try to extrude some plastic, which should work normally.

If the preceding methods fail to solve the problem, turn off the power immediately and contact after-sales engineers. In daily use, regular maintenance and cleaning of 3D printers, the use of high-quality [PLA filament](https://kingroon.com/collections/3d-printer-pla-filament), and following the correct temperature Settings can effectively reduce the occurrence of plug problems.

Through the above methods, makers and enthusiasts can effectively solve the plug problem of PLA wire, improve the efficiency of 3D printing and the quality of the work.

Thread 104 (2024-09-21):

Application of bulk PLA wire in furniture field

kiki126, 2024-09-21:
The following is an article on the application of bulk PLA wire in the furniture field for your reference:

In modern furniture design and manufacturing, the choice of materials is very important. As a new material, bulk PLA wire has gradually emerged in the field of furniture with its unique advantages. This paper will discuss the application of bulk PLA wire in furniture field and its influence.

First, introduce what is PLA wire. PLA, or polylactic acid, is a biodegradable material made from renewable resources such as corn starch and sugar cane. PLA wire is made of PLA material through a special process of wire material, with good plasticity, environmental protection and mechanical properties.

In furniture manufacturing, the application of bulk PLA wire is mainly reflected in the following aspects:

1. 3D printing furniture: With the continuous development of 3D printing technology, PLA wire is widely used in furniture manufacturing as one of the main materials for 3D printing. With 3D printing technology, designers can have more freedom to be creative and design furniture with unique shapes and complex structures. Moreover, 3D printed furniture can be customized according to individual needs to meet the diversified needs of consumers.

2. Traditional furniture manufacturing: In addition to 3D printing, PLA wire can also be used in traditional furniture manufacturing through weaving, winding and other ways. For example, chairs, stools and other furniture woven with PLA wire are not only beautiful in appearance, but also have good air permeability and comfort. In addition, PLA wire can also be used in combination with other materials (such as wood, metal, etc.) to create a more diversified furniture product.

3. Environmental protection advantages: Compared with traditional furniture materials (such as plastic, wood, etc.), PLA wire has more obvious environmental protection advantages. Since PLA material is derived from renewable resources, its carbon emissions in the production process are low, and it can be biodegraded after use, reducing environmental pollution. Therefore, furniture made of PLA wire is in line with modern people's pursuit of environmental protection and sustainable development.

4. Performance advantage: PLA wire has good mechanical properties, such as high strength, wear resistance, etc., so that the furniture made by it has a long service life. In addition, PLA wire also has a certain waterproof, moisture-proof performance, suitable for a variety of environments.

However, the application of [bulk PLA filament](https://kingroon.com/products/10kg-pla-filament-1-75mm) in the furniture field also faces some challenges. For example, the cost of PLA wire is relatively high, which to some extent limits its application in large-scale furniture manufacturing. In addition, the heat resistance of PLA wire is poor, and it is easy to deform in high temperature environment, which is also a problem that needs to be solved.

To sum up, the application of bulk PLA wire in the field of furniture has broad prospects. With the continuous progress of technology and the gradual reduction of costs, it is believed that PLA wire will play an increasingly important role in furniture manufacturing, bringing more environmentally friendly, comfortable and beautiful furniture products to people.

Thread 105 (2024-09-21):

Why is it safer to print with PETG wire

kiki126, 2024-09-21:
With the increasing popularity of 3D printing technology, it is particularly important to choose the right printing wire. As a high performance material, PETG wire has been widely used in 3D printing field. Its unique characteristics not only make it excellent in transparency, hardness and chemical resistance, but also have significant advantages in safety. Here's why printing with PETG wire is safer.

First, PETG wire is almost odourless during the printing process. This feature greatly reduces the potential hazards of harmful gases to operators. In contrast, some other types of 3D printing wire, such as ABS, produce pungent odors when printed, and prolonged exposure may have adverse effects on human health. The low odor characteristics of PETG materials make it safer to use in closed environments such as homes and offices.

Second, PETG wire has excellent heat resistance and mechanical strength. This means that PETG wire is less likely to deform or break due to high temperatures during the printing process, reducing printing failures and potential safety risks due to material issues. Its semi-rigid physical strength makes the print more durable, reducing the possibility of breakage during use and further improving safety.

In addition, the transparency of PETG wire is one of its highlights. High transparency in certain applications, such as medical equipment, laboratory equipment, etc., can provide better visibility to help operators more accurately monitor and operate, thereby avoiding safety incidents caused by obstructed vision.

PETG wire also has excellent chemical resistance. This means that PETG prints are not easily corroded or damaged when exposed to common chemicals, ensuring their stability and safety in harsh environments. This feature makes the application of PETG wire in chemical, medical and other fields more extensive and reliable.

Finally, the printing process of [PETG filament](https://kingroon.com/collections/petg-filament)  is relatively stable. Due to its good fluidity and adhesion, PETG wire is not prone to problems such as plugs or layering during printing, reducing printing failures caused by equipment failures. This not only improves printing efficiency, but also reduces safety risks due to material waste and equipment damage.

In summary, the wide application of PETG wire in the field of 3D printing is not only due to its excellent physical and chemical properties, but also because of its high level of security. From the health protection of the operator to the stability of the printing process and the durability of the finished product, PETG wire is a safer and more reliable choice. With the continuous progress of technology, the application prospect of PETG wire in the future 3D printing will be broader.

Thread 106 (2024-10-14):

Deviation Calculation in Core XY 3D Printers: Understanding and Minimizing Errors

kiki126, 2024-10-14:
Core XY 3D printers have gained popularity due to their precise movement mechanics, which offer improved speed and accuracy compared to traditional Cartesian setups. In a [Core XY printer](https://kingroon.com/products/kingroon-klp1-corexy-3d-printer-with-klipper-firmware), the movement of the print head is controlled by a system of belts and pulleys that drive the X and Y axes simultaneously. This allows for faster, more stable motion, making it ideal for complex and high-precision prints. However, like any mechanical system, errors and deviations can occur, leading to inaccuracies in the final printed object. Understanding and calculating these deviations is crucial for optimizing print quality.

**What is Deviation in Core XY 3D Printers?**
Deviation refers to the difference between the intended position of the print head (as dictated by the G-code) and its actual position during printing. These deviations can result from various factors, such as mechanical inaccuracies, belt tension imbalances, or calibration errors. In a Core XY setup, small deviations can accumulate over time, leading to misaligned layers, distorted prints, or inconsistent dimensions in the final object.

**Causes of Deviation in Core XY Systems**
Belt Stretch and Tension: The Core XY system relies heavily on belts for movement. If the belts are too loose or too tight, they can stretch or slacken over time, leading to deviations in print head positioning. Uneven belt tension can cause one axis to move more than the other, resulting in geometric distortions.

Pulley and Bearing Wear: Over time, the pulleys and bearings that guide the belts may wear out, causing slight shifts in the motion system. These mechanical imperfections can lead to small but significant deviations, particularly in larger or more detailed prints.

Firmware and Stepper Motor Calibration: Incorrect calibration of the stepper motors can cause movement deviations. If the firmware is not configured correctly or if the stepper motors skip steps, the print head may not move as precisely as intended, leading to discrepancies between the intended and actual positions.

Frame Rigidity and Alignment: The rigidity and alignment of the printer frame are also critical in minimizing deviations. Any misalignment in the frame or movement system can introduce errors, especially when printing at higher speeds.

**Calculating Deviation in Core XY Printers**
To ensure precise printing, it’s essential to quantify the deviation in your Core XY 3D printer. Deviation can be calculated through a combination of manual measurements and software tools.

Test Prints and Dimensional Measurement: One of the simplest ways to calculate deviation is by printing a calibration object, such as a cube or cross, and then measuring the dimensions of the final print. Compare these measurements to the intended dimensions, and calculate the difference. For example, if you printed a 20x20x20 mm cube but the actual size measures 19.8x20.1x20 mm, the deviations are -0.2 mm, +0.1 mm, and 0 mm on the X, Y, and Z axes, respectively.

Firmware Adjustment: Once you’ve identified the deviation, you can adjust the firmware’s steps-per-millimeter settings to compensate. By adjusting the number of steps the motors take per millimeter of movement, you can fine-tune the printer’s accuracy.

Belt Tension and Pulley Alignment: Another way to correct deviations is by checking the belt tension and ensuring that all pulleys are aligned correctly. Use a belt tension meter or perform a visual inspection to make sure the belts are evenly tensioned. Any imbalances should be corrected to ensure symmetrical movement.

Advanced Tools for Measurement: For more precise deviation calculations, you can use digital dial indicators or laser measuring tools to monitor print head movement in real time. These tools can detect even minute deviations, allowing for more precise calibration.

**Minimizing Deviation for Optimal Results**
After calculating the deviation, it’s important to take steps to minimize it for optimal print quality. Regular maintenance of the belts, pulleys, and bearings is essential for maintaining consistent accuracy. Additionally, fine-tuning the firmware, ensuring the frame is rigid, and regularly recalibrating the stepper motors will help reduce errors.

By understanding and calculating deviation, Core XY 3D printer users can significantly improve print accuracy, resulting in cleaner, more precise models. The ability to control and correct for deviations is a key factor in achieving high-quality 3D prints with a Core XY system.

Thread 107 (2024-10-22):

How to Prepare a Mini 3D Printer for Optimal Performance

kiki126, 2024-10-22:
I have found that properly preparing a mini 3D printer is essential to ensure smooth operation and achieve high quality printing. Whether you are a beginner or an experienced user, I will summarize and share some of my experiences with mini 3D printers, following these basic steps will help you get the most out of your [mini 3D printer](https://kingroon.com/products/official-kingroon-kp3s-3d-printer).

**1. Unpack and assemble**
The first step in preparing a mini 3D printer is to unbox and assemble the parts. Mini 3D printers are usually semi-assembled, but you may need add-ons such as spool holders or extruders. Please refer to the manual for step-by-step instructions to ensure that each part is securely attached together to avoid problems during printing.

**2. Level the platform**
Proper bed formation is essential to achieve strong first layer adhesion. Many mini 3D printers have automatic levelling, but for those that don't, manual levelling is required. Use a piece of paper to ensure the best distance between the nozzle and the print bed, usually around 0.1mm. Repeat this process at different points on the bed until the surface is flat.

**3. Silk loading**
Next, make sure your filament loads properly. Mini 3D printers typically support 1.75mm filaments, including PLA and PETG. Heat the extruder to the recommended temperature for your filament type, then gently feed the filament into the extruder. Use the printer's menu to start the filament loading process and check that it extrudes smoothly before you start printing.

**4. Software Settings**
Prepare your 3D model using slicing software. Many mini 3D printers are compatible with popular slicers such as Cura. Adjust the print Settings according to your project, including layer height, print speed, and fill percentage. After slicing, the file is transferred to the printer via SD card, USB, or Wi-Fi, depending on the model.

**5. Test printing**
Before proceeding to more complex printing, run test printing to ensure that the printer is functioning properly. A small calibration cube or benchmark will help you evaluate the performance of your printer and make necessary adjustments.

By following these preparation steps, you can maximize the capabilities of your mini 3D printer and ensure that it consistently produces high-quality prints. I hope my suggestions can help you.

Thread 108 (2024-10-25):

Pearlescent Treatment of ABS Filament: A Guide to Stunning Finishes

kiki126, 2024-10-25:
Pearlescent treatment of ABS (Acrylonitrile Butadiene Styrene) filament opens up creative possibilities in 3D printing by adding a subtle, metallic sheen to finished prints. This technique, popular among makers and industrial users alike, enhances the aesthetic appeal of 3D-printed objects, giving them a high-end, iridescent appearance. The process involves the incorporation of fine pearlescent pigments into [ABS filament](https://kingroon.com/collections/abs-filament) during manufacturing, resulting in a filament that produces a glossy, pearl-like finish.

ABS, known for its durability, impact resistance, and excellent heat stability, provides an ideal base for this treatment, as it readily takes on pigments while maintaining its structural integrity. Pearlescent ABS filament is particularly well-suited for decorative items, architectural models, and functional prototypes requiring both resilience and visual appeal.

For best results, ensure proper print settings, as temperature and print speed adjustments can affect the pearlescent effect. High gloss finishing techniques, such as sanding and vapor smoothing, can further amplify the filament’s reflective quality, creating a striking and sophisticated look. Pearlescent ABS filament provides a unique solution for 3D printing enthusiasts looking to create eye-catching and durable prints that stand out with a lustrous sheen.

Thread 109 (2024-10-25):

Careful Maintenance to Extend 3D Printing Filament Life

kiki126, 2024-10-25:
Proper maintenance can significantly extend the lifespan of [3D printing filament](https://kingroon.com/collections/3d-printer-filament), preserving its quality and ensuring consistent print results. Filaments, especially those prone to moisture absorption like PLA, ABS, and nylon, can degrade over time if not stored correctly. Exposure to humidity and temperature fluctuations can lead to issues like brittleness, clogging, and poor extrusion quality.

To maintain filament life, store spools in a cool, dry environment. Airtight containers with desiccants or specialized filament storage boxes are effective solutions for keeping moisture at bay. Vacuum-sealed bags also help preserve filament quality during extended periods of inactivity.

Regularly inspecting filament for signs of wear, such as discoloration or surface imperfections, is essential. If filament absorbs moisture, drying it with a filament dryer or a preheated oven at low temperatures can help restore its printability.

For optimal performance, track storage dates and use older filaments first. Periodic maintenance, like re-spooling and checking for tangles, ensures smooth extrusion and prevents nozzle jams. By following these steps, users can maximize their filament’s shelf life and enjoy consistent, high-quality prints over time, making careful maintenance a wise investment for any 3D printing enthusiast.

Thread 110 (2024-10-28):

Enhancing Print Quality with the Recovery Function of Filament Dryers

kiki126, 2024-10-28:
In 3D printing, filament quality directly impacts the final print outcome. Over time, filaments, especially hygroscopic materials like PLA, ABS, and Nylon, can absorb moisture from the air, leading to printing issues such as poor layer adhesion, stringing, and inconsistent extrusion. Filament dryers are crucial for maintaining filament quality, and the recovery function within these devices plays an essential role in restoring optimal printing conditions.

The recovery function in [filament dryer](https://kingroon.com/collections/3d-filament-dryer) is designed to eliminate moisture that filaments accumulate during storage or exposure to humid environments. By heating the filament to a controlled temperature, the dryer draws out absorbed moisture, preventing issues like bubbling, warping, and reduced structural integrity. Most filament dryers allow temperature adjustments, ensuring that each filament type is dried safely without reaching melting points, which could compromise filament quality.

This drying process is especially beneficial for filaments that have been stored long-term or exposed to fluctuating environments. The recovery function enables users to rejuvenate old or improperly stored filament, making it usable once again and reducing material waste. For frequent users, this not only saves money but also promotes sustainable printing practices.

Advanced filament dryers with a continuous recovery function can keep filaments dry even during printing, maintaining filament integrity throughout the process. This capability is essential for long prints that require consistent filament quality from start to finish, reducing the likelihood of print failure and improving the precision of intricate details.

By investing in a filament dryer with an efficient recovery function, 3D printing enthusiasts and professionals alike can enhance print quality, prevent common issues caused by moisture, and extend the lifespan of their filaments, ensuring that each print reaches its full potential.

Thread 111 (2024-10-28):

Efficient Information Management for Bulk Filament in 3D Printing

kiki126, 2024-10-28:
Managing [bulk filament](https://kingroon.com/products/10kg-pla-petg-filamento-1-75mm-pla-impresora-3d) effectively is essential for 3D printing operations that rely on large-scale or continuous production. Information management in this context involves systematically tracking filament types, quantities, storage conditions, and usage patterns to optimize inventory and ensure that materials are readily available and in top condition.

One of the primary aspects of managing bulk filament is inventory control. Tracking stock levels, filament types, and spool weights allows users to avoid shortages and maintain a consistent supply of materials. Many companies employ inventory management software, which can monitor real-time filament usage, forecast future needs, and set reorder points for each filament type. This helps to reduce waste and ensures that filament is available without excessive overstocking, which can lead to storage complications.

Storage conditions are another critical factor in maintaining filament quality. Proper information management involves noting each filament’s moisture sensitivity and setting up storage environments with temperature and humidity controls. Hygroscopic materials, such as PLA, Nylon, and TPU, benefit from filament dryers or sealed storage units with desiccant packs. Logging these details helps ensure that each spool remains dry and ready for use, reducing print failures associated with moisture absorption.

Usage data is equally valuable for 3D printing professionals managing bulk filament. Recording information on how much filament each project requires and analyzing material use patterns over time can lead to better forecasting and budgeting. By understanding filament consumption rates, companies can make informed purchasing decisions, allocate resources more efficiently, and maintain smooth production flows.

Incorporating information management practices for bulk filament allows 3D printing businesses to streamline inventory processes, preserve material quality, and optimize production efficiency, ultimately reducing costs and improving output consistency across all projects.

Thread 113 (2025-05-16):

Plane Umbau von meinem lk 5pro
Da ich gern denn Drucker über WLAN an Steuern möchte ist das dirn verbaute nicht aus reichend hab jetzt Eder 3 und Robin nano mit extra WiFi Chip drauf so welches ist besser geeignet

lamasast, 2025-05-16:

Thread 114 (2025-07-04):

Unbelievable issues with bootloader.

WeWerrSeededHere42, 2025-07-04:
I have never done so much research and gotten nowhere in my life.

borrowed a friends ender 3. accidently tripped the power cord while printing, and have had a blue screen ever since.

Ive tried so many different methods to CREATE a BOOTLOADER ( on my printer. ) ... because low and behold... its 8b doesn't have an ability to change its own firmware.

when first starting out with this process, any newb will see that Creativity has all of the files your going to need... UNLESS!!! wait, wait wait, your MOTHERBOARD has a GD in front of it!!!! ( yep i have the 4.2.2 GD board, so guess what? none of those bootloaders work.

Being told from videos that i can use an ardino board to create a bootloader.. i assumed i was fine, using my board i  got from a Cosworth city free gift months ago.

After getting the other board out, and attemping to wire it to the computer, and the freakin mother board already installed into the printer... YET ANOTHER ISSUE GUYS----  the 4 pin isp!! instead of the 6 pin isp.

ANOTHER rabbit hole.

Currently have given up, days wasted on nothing. i have a Official Creality 3D Printer Ender 3 Upgraded Silent Board Motherboard V4.2.7 with TMC2225 Driver Marlin 2.0.1 for Ender 3/ Ender 3 V2/ Ender 3 Pro/Ender 3 Max/Ender 3 Neo/3 V2 Neo/3 Max Neo

Board coming on Monday from amazon.. and im PRAYING i can just plug and play this thing,. because someone that was COMPLETLY intrigued by a new hobby.. has been COMPLETLY let down by the lack of true answer within the community, that fix the issues at hand.

I Understand 3d printing is a new thing.. but seriously? you couldn't create the first one with a motherboard that can be flashed,, and has wifi???

WeWerrSeededHere42, 2025-07-05:
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

Now, I'm assuming if you crash this board it's allows bootloading from the SD card.

Which firmware should I use ? Orig ender 3?

Thread 115 (2025-08-11):

The temperature of Nozzel starts increasing on turning on the Ender 3

quickmaking, 2025-08-11:
Hi Everyone
I have come across an issue due to which my Ender3 has come to a halt
As soon as I power on the printer the temperature of the nozzel starts increasing without any command to heat the nozzel.
I have tried replacing the thermostat but that has not worked. I have also updated the firmware but the problem continuous.
I feel it is a circuit issue on the motherboard 4.2.2. How can I solve the problem

Thread 116 (2025-08-13):

Clipper Datei fürs nebula Pad Versuch Nummer 1

lamasast, 2025-08-13:
#--------------------------------------------------
# Drucker: Ender-3
# Mainboard: Creality v4.2.7
# Firmware: Klipper
# Host: Nebula Pad
# Sensor: BLTouch
#--------------------------------------------------

[stepper_x]
step_pin: PB9
dir_pin: !PC2
enable_pin: !PC3
microsteps: 16
rotation_distance: 40
endstop_pin: ^PA5
position_endstop: 0
position_max: 235
homing_speed: 50

[stepper_y]
step_pin: PB8
dir_pin: !PC0
enable_pin: !PC1
microsteps: 16
rotation_distance: 40
endstop_pin: ^PA6
position_endstop: 0
position_max: 235
homing_speed: 50

[stepper_z]
step_pin: PB7
dir_pin: !PC4
enable_pin: !PC5
microsteps: 16
rotation_distance: 8
endstop_pin: probe:z_virtual_endstop
position_max: 250
position_min: -2

[bltouch]
sensor_pin: ^PB1
control_pin: PB0
x_offset: -44
y_offset: -9
z_offset: 0.0
speed: 5.0
samples: 2
sample_retract_dist: 5.0
samples_result: average

[safe_z_home]
home_xy_position: 117,117
speed: 50
z_hop: 10
z_hop_speed: 5

[extruder]
step_pin: PB3
dir_pin: PB4
enable_pin: !PB5
microsteps: 16
rotation_distance: 33.500
nozzle_diameter: 0.4
filament_diameter: 1.75
heater_pin: PA1
sensor_type: EPCOS 100K B57560G104F
sensor_pin: PC5
control: pid
pid_Kp: 21.527
pid_Ki: 1.063
pid_Kd: 108.982
min_temp: 0
max_temp: 250

[heater_bed]
heater_pin: PA2
sensor_type: EPCOS 100K B57560G104F
sensor_pin: PC4
control: pid
pid_Kp: 54.027
pid_Ki: 0.770
pid_Kd: 948.182
min_temp: 0
max_temp: 110

[fan]
pin: PA0

[mcu]
serial: /dev/serial/by-id/usb-1a86_USB_Serial-if00-port0
restart_method: command

[printer]
kinematics: cartesian
max_velocity: 300
max_accel: 3000
max_z_velocity: 5
max_z_accel: 100

[bed_screws]
screw1: 30,30
screw2: 200,30
screw3: 200,200
screw4: 30,200

[bed_mesh]
speed: 100
horizontal_move_z: 5
mesh_min: 10, 10
mesh_max: 190, 190
probe_count: 5,5
fade_start: 1.0
fade_end: 10.0
fade_target: 0

[display]
lcd_type: uc1701
cs_pin: PB13
a0_pin: PB14
encoder_pins: ^PB10, ^PB12
click_pin: ^!PB15
kill_pin: ^!PB2
