Creality3DPrinting/Ender-3/Ender-3 Mechanical/PDF/E plate.pdf

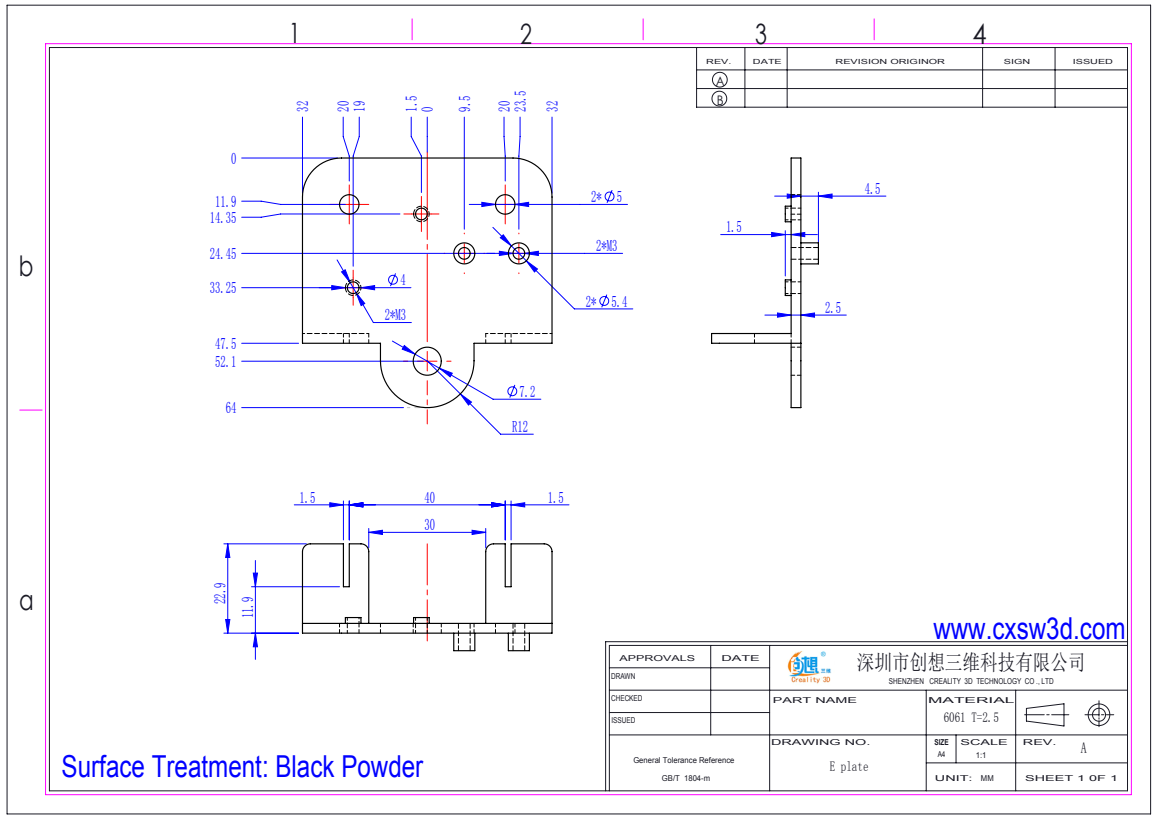
[picture p148: page 1]
Surface Treatment: Black Powder; SIZE SCALE; UNIT: MM; DRAWING NO.; REV.; DATE; REVISION ORIGINOR; SIGN; ISSUED; PART NAME; E plate; SHEET 1 0F 1

SHENZHEN CREALITY 3D TECHNOLOGY CO ., LTD

General Tolerance Reference
