Creality3DPrinting/Ender-3/Ender-3 Mechanical/PDF/Heat block.pdf

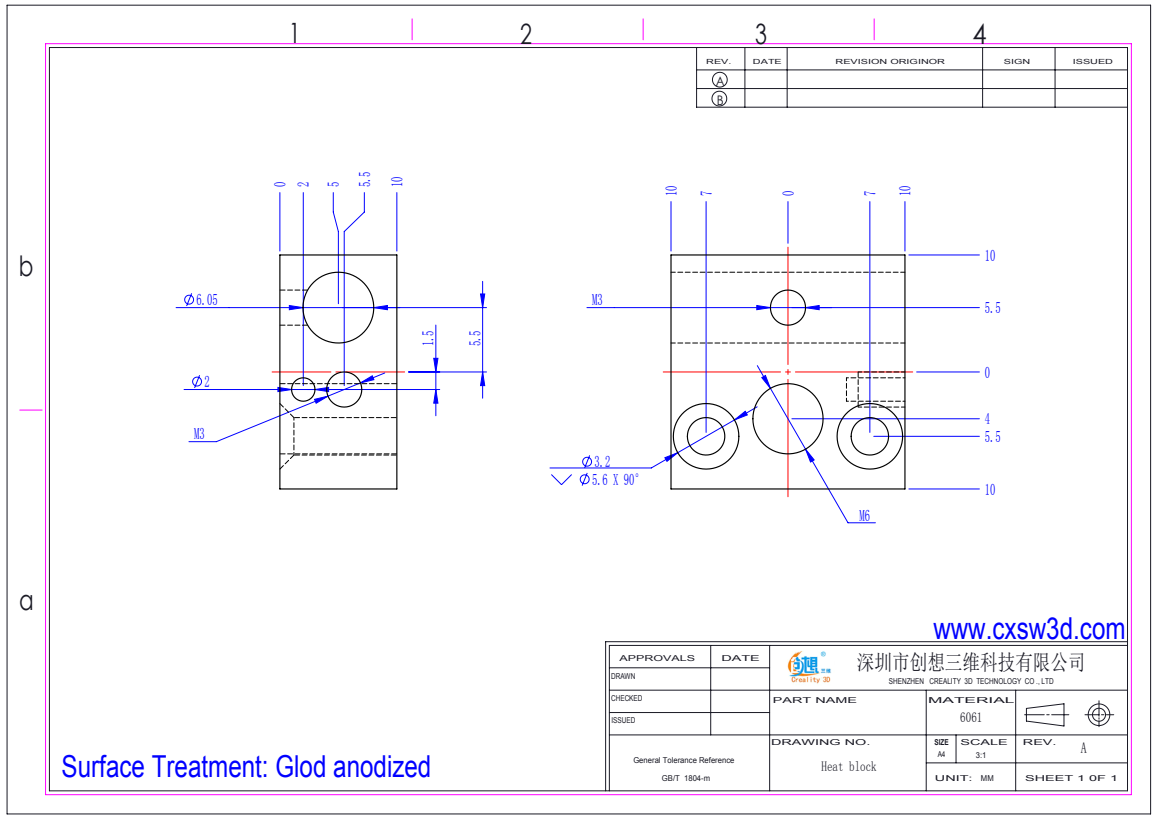
[picture p149: page 1]
Surface Treatment: Glod anodized; SIZE SCALE; UNIT: MM; DRAWING NO.; REV.; DATE; REVISION ORIGINOR; SIGN; ISSUED; PART NAME; Heat block; SHEET 1 0F 1

SHENZHEN CREALITY 3D TECHNOLOGY CO ., LTD

General Tolerance Reference
