Creality3DPrinting/Ender-3/Ender-3 Mechanical/PDF/power switch.pdf

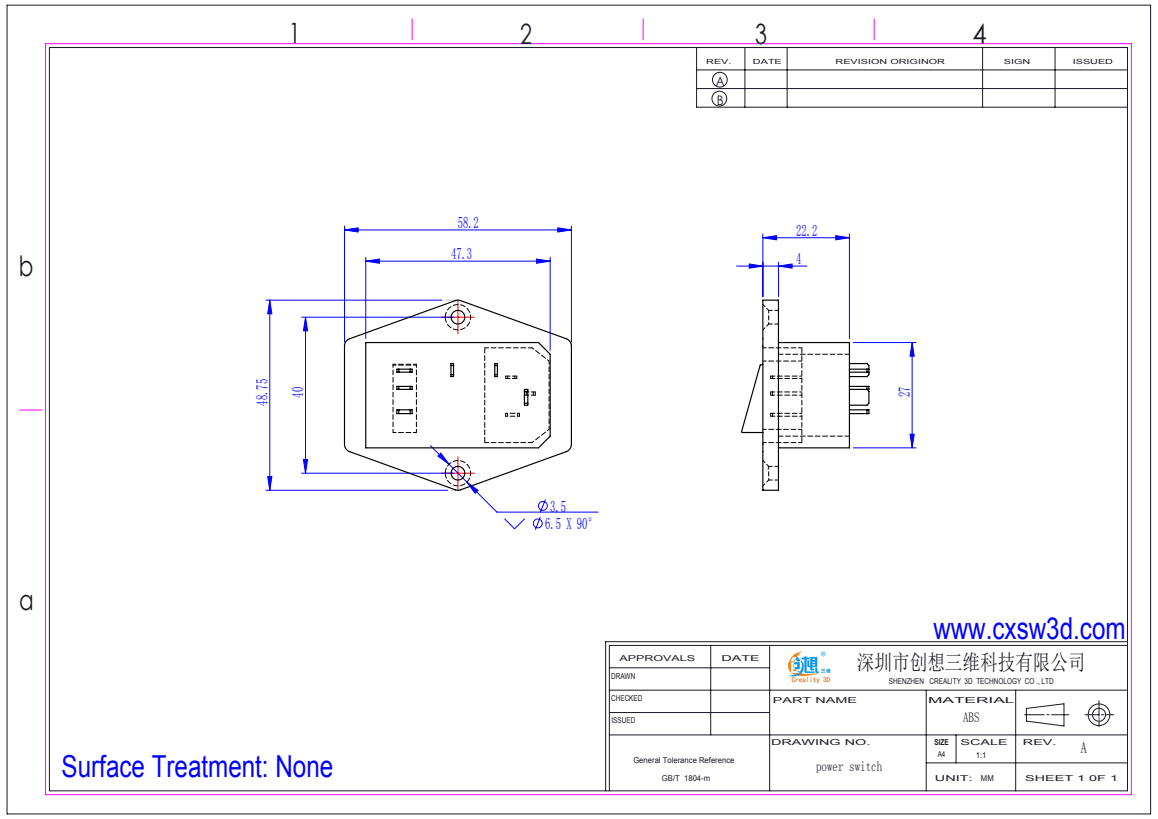
[picture p153: page 1]
Surface Treatment: None; SIZE SCALE; UNIT: MM; DRAWING NO.; REV.; DATE; REVISION ORIGINOR; SIGN; ISSUED; PART NAME; power switch; SHEET 1 0F 1

SHENZHEN CREALITY 3D TECHNOLOGY CO ., LTD

General Tolerance Reference
