Creality3DPrinting/Ender-3/Ender-3 Mechanical/PDF/Sheetmetal enclosure top.pdf

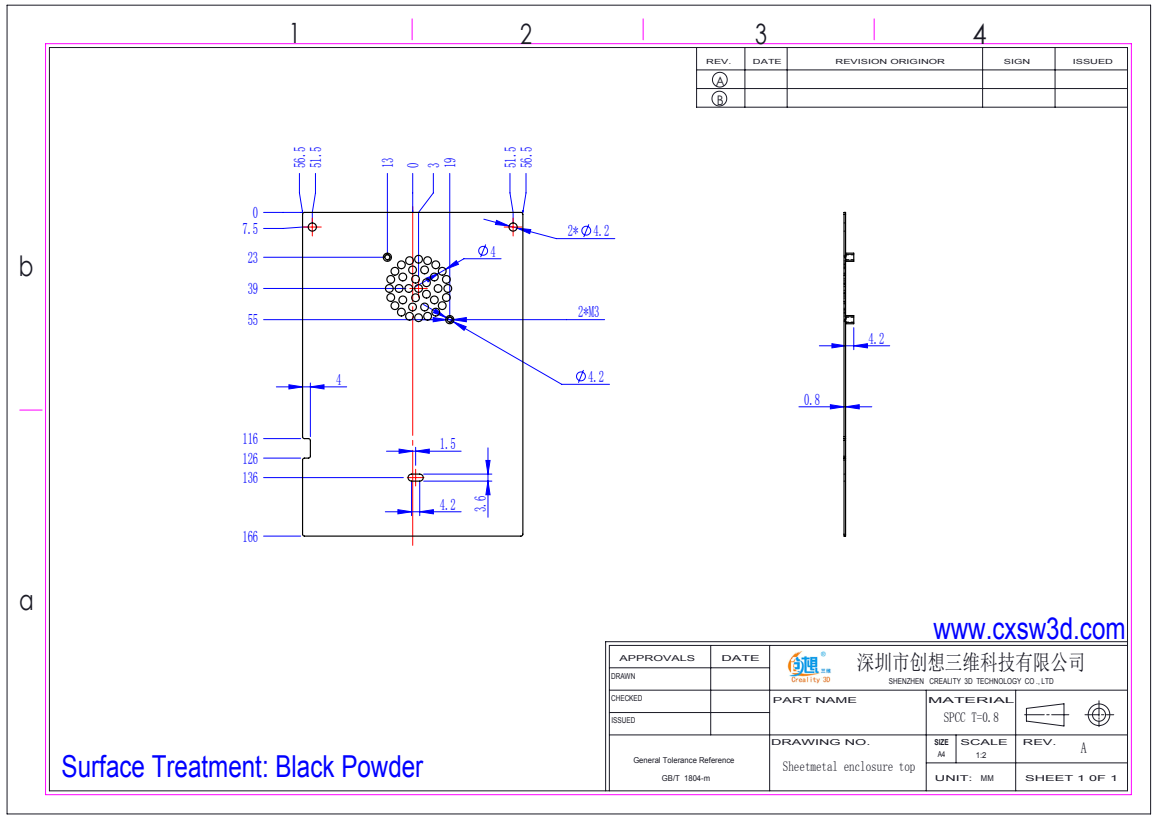
[picture p154: page 1]
Surface Treatment: Black Powder; SIZE SCALE; UNIT: MM; DRAWING NO.; REV.; DATE; REVISION ORIGINOR; SIGN; ISSUED; PART NAME; Sheetmetal enclosure top; SHEET 1 0F 1; SPCC T=0.8

SHENZHEN CREALITY 3D TECHNOLOGY CO ., LTD

General Tolerance Reference
