Creality3DPrinting/Ender-3/Ender-3 Mechanical/PDF/Spacers for rollers.pdf

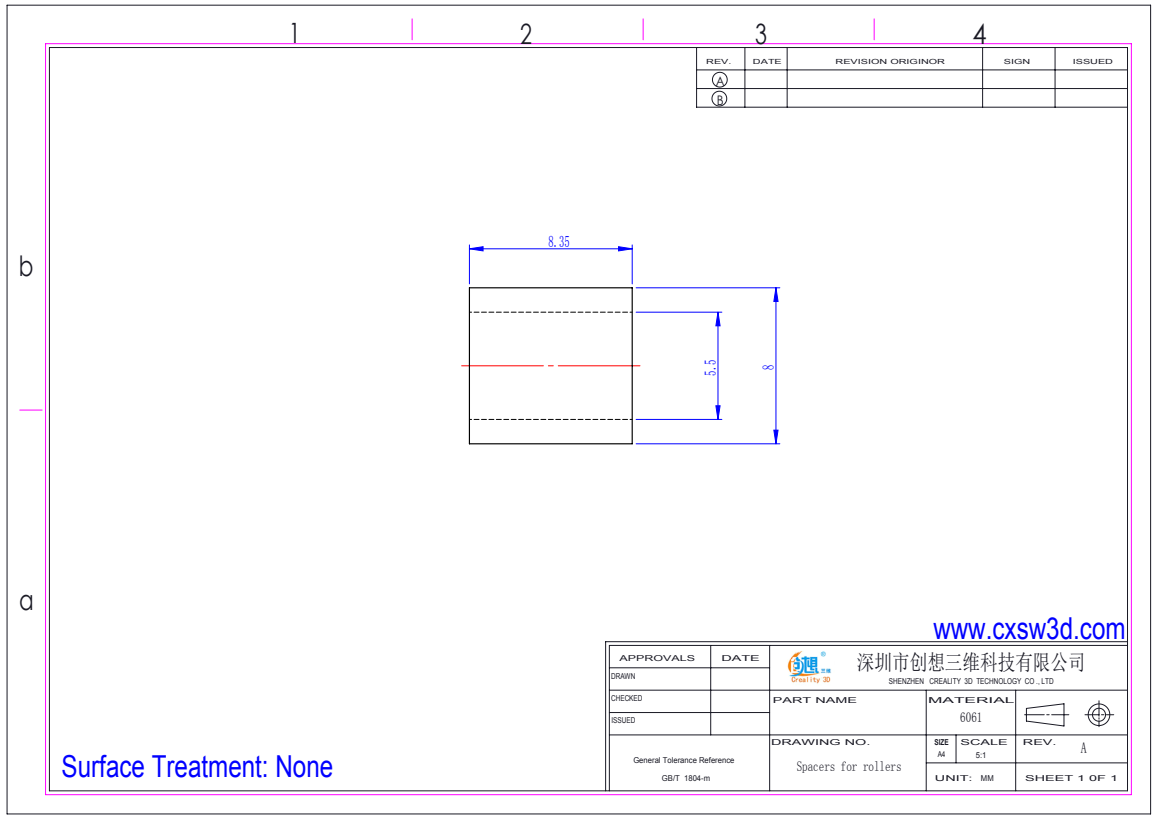
[picture p155: page 1]
Surface Treatment: None; SIZE SCALE; UNIT: MM; DRAWING NO.; REV.; DATE; REVISION ORIGINOR; SIGN; ISSUED; PART NAME; Spacers for rollers; SHEET 1 0F 1

SHENZHEN CREALITY 3D TECHNOLOGY CO ., LTD

General Tolerance Reference
