Creality3DPrinting/Ender-3/Ender-3 Mechanical/PDF/Support frame.pdf

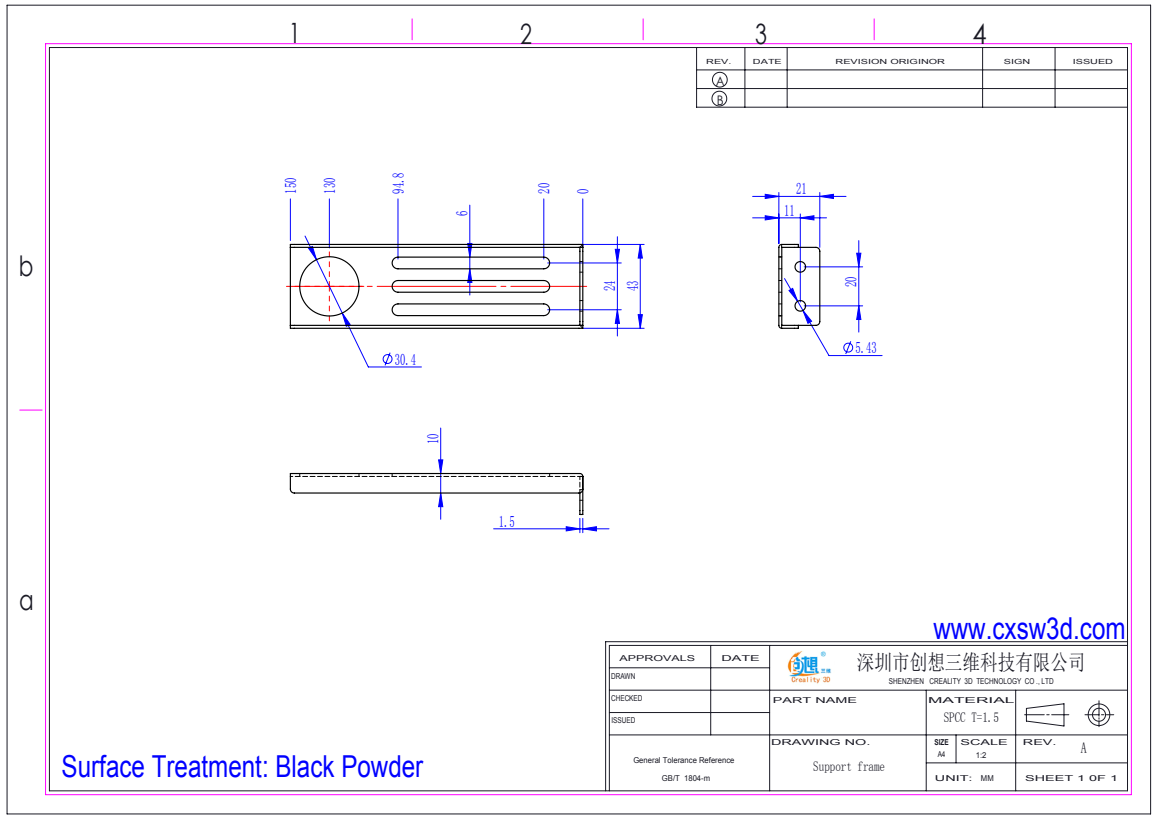
[picture p156: page 1]
Surface Treatment: Black Powder; SIZE SCALE; UNIT: MM; DRAWING NO.; REV.; DATE; REVISION ORIGINOR; SIGN; ISSUED; PART NAME; Support frame; SHEET 1 0F 1; SPCC T=1.5

SHENZHEN CREALITY 3D TECHNOLOGY CO ., LTD

General Tolerance Reference
