Creality3DPrinting/Ender-3/Ender-3 Mechanical/PDF/z nut.pdf

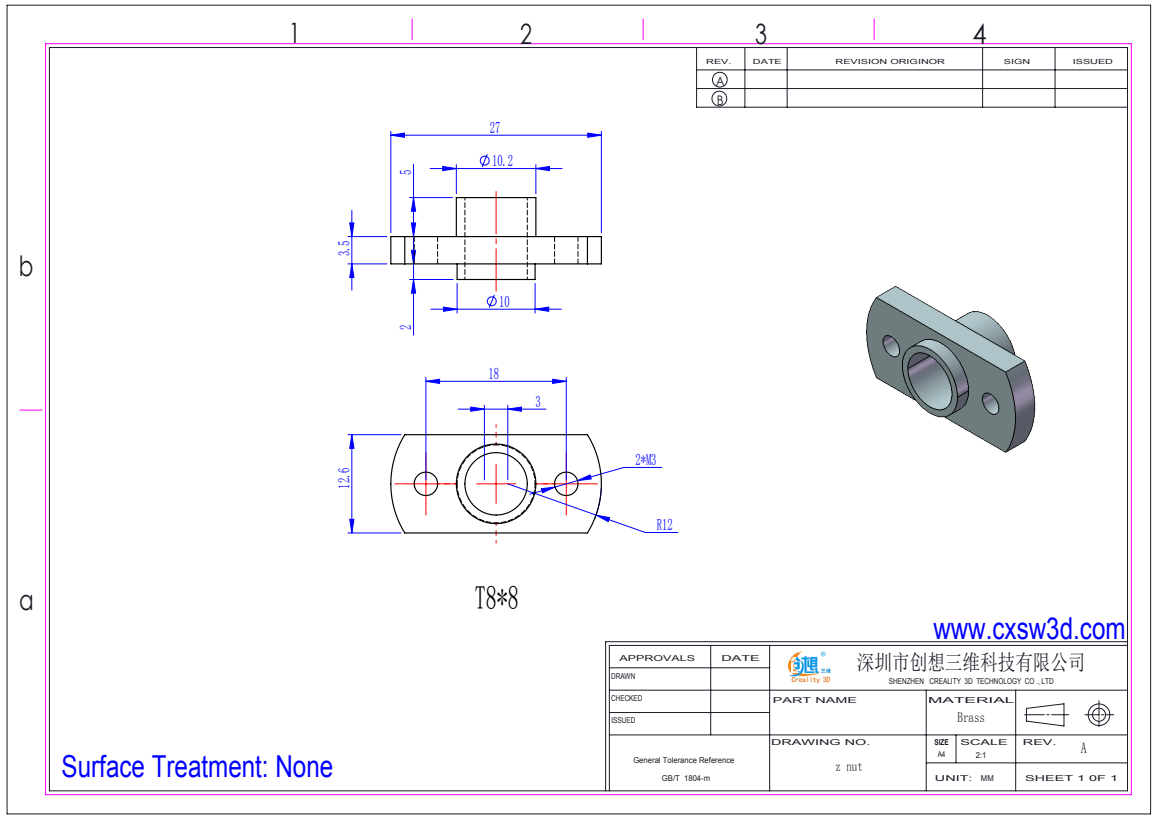
[picture p160: page 1]
SIZE SCALE; UNIT: MM; DRAWING NO.; REV.; DATE; REVISION ORIGINOR; SIGN; ISSUED; PART NAME; z nut; SHEET 1 0F 1

SHENZHEN CREALITY 3D TECHNOLOGY CO ., LTD

Surface Treatment: None

General Tolerance Reference
