Creality3DPrinting/Ender-3/Ender-3 Mechanical/PDF/Z threaded rod.pdf

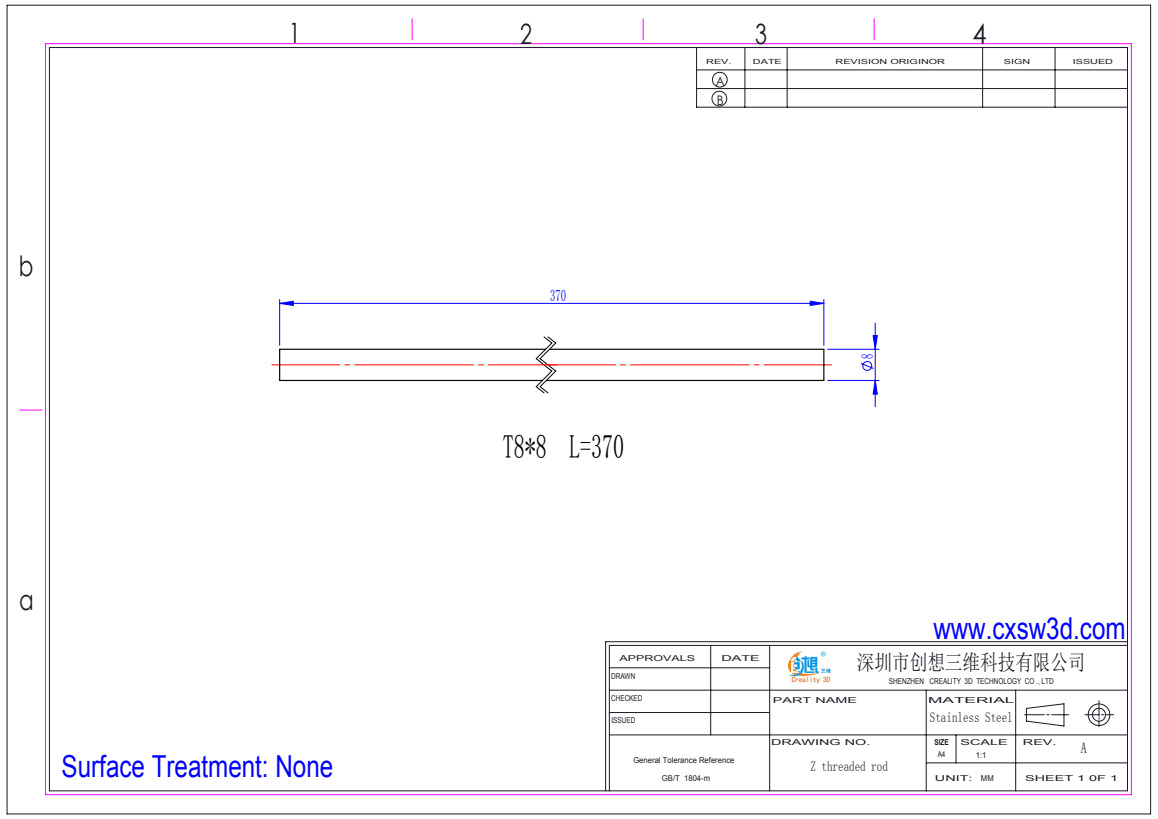
[picture p161: page 1]
Surface Treatment: None; SIZE SCALE; UNIT: MM; DRAWING NO.; REV.; DATE; REVISION ORIGINOR; SIGN; ISSUED; PART NAME; Z threaded rod; SHEET 1 0F 1; Stainless Steel

SHENZHEN CREALITY 3D TECHNOLOGY CO ., LTD

General Tolerance Reference
