Creality3DPrinting/Ender-3/Ender-3 PCB/Ender3_pcb_parts.PDF

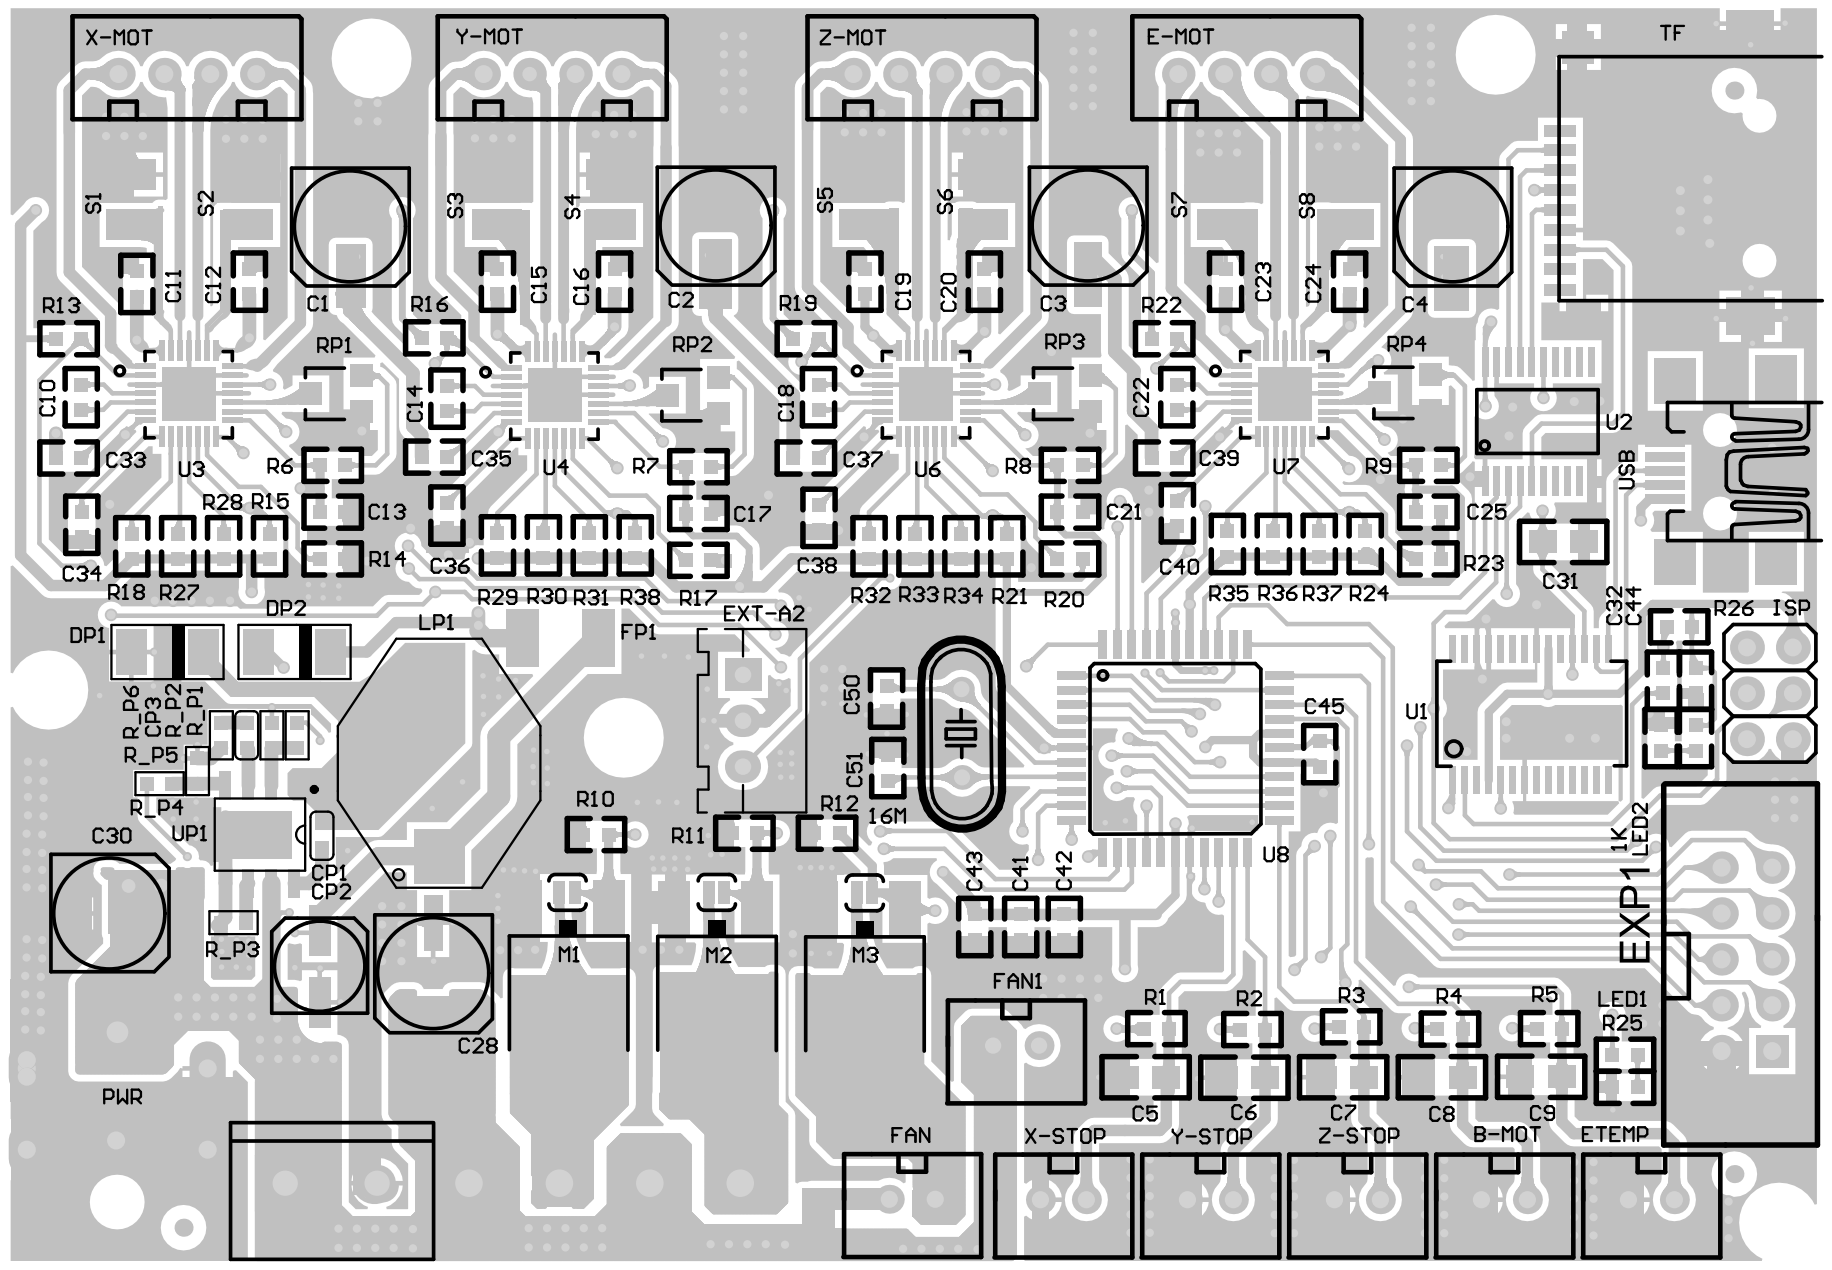
[picture p162: page 1]

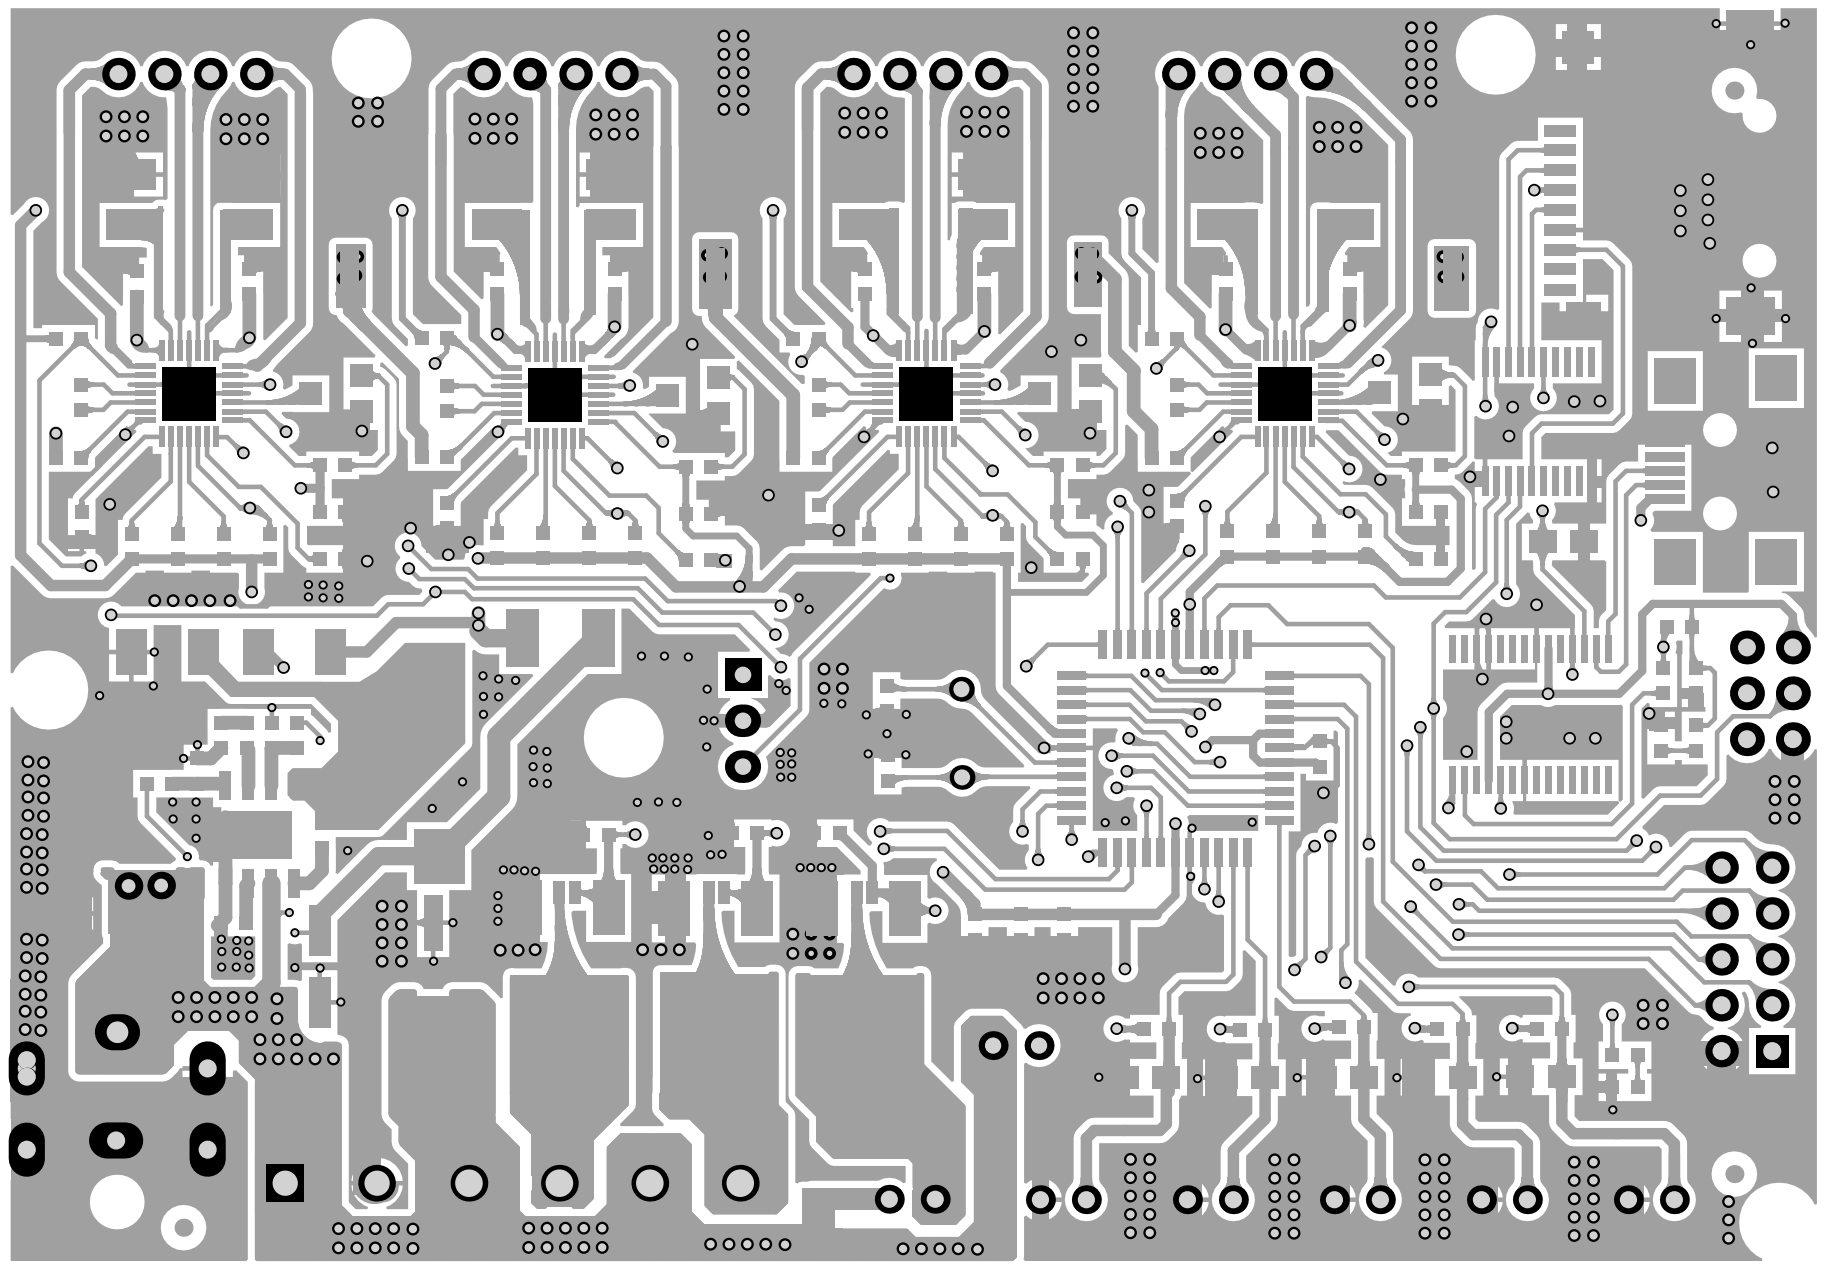
[picture p163: page 2]

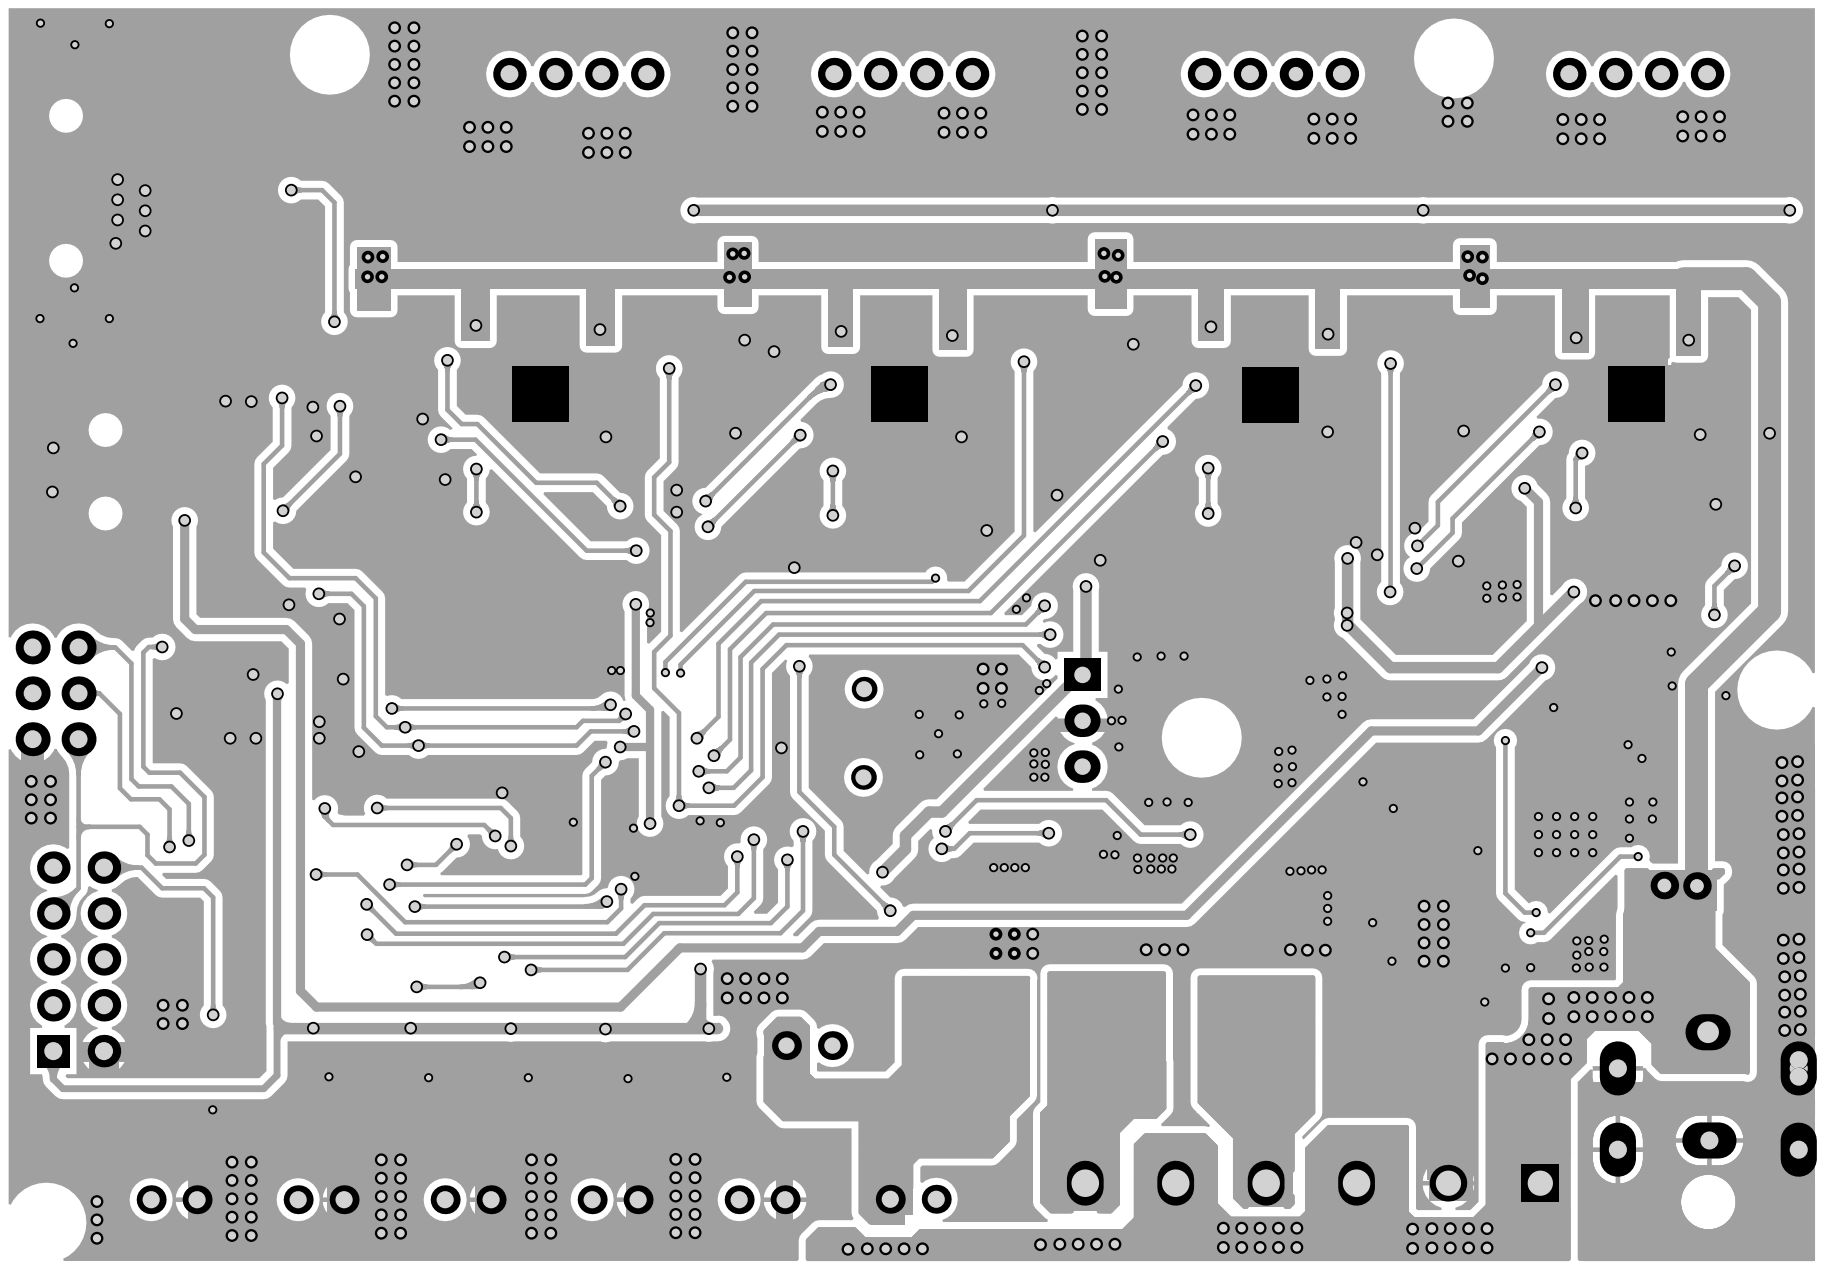
[picture p164: page 3]

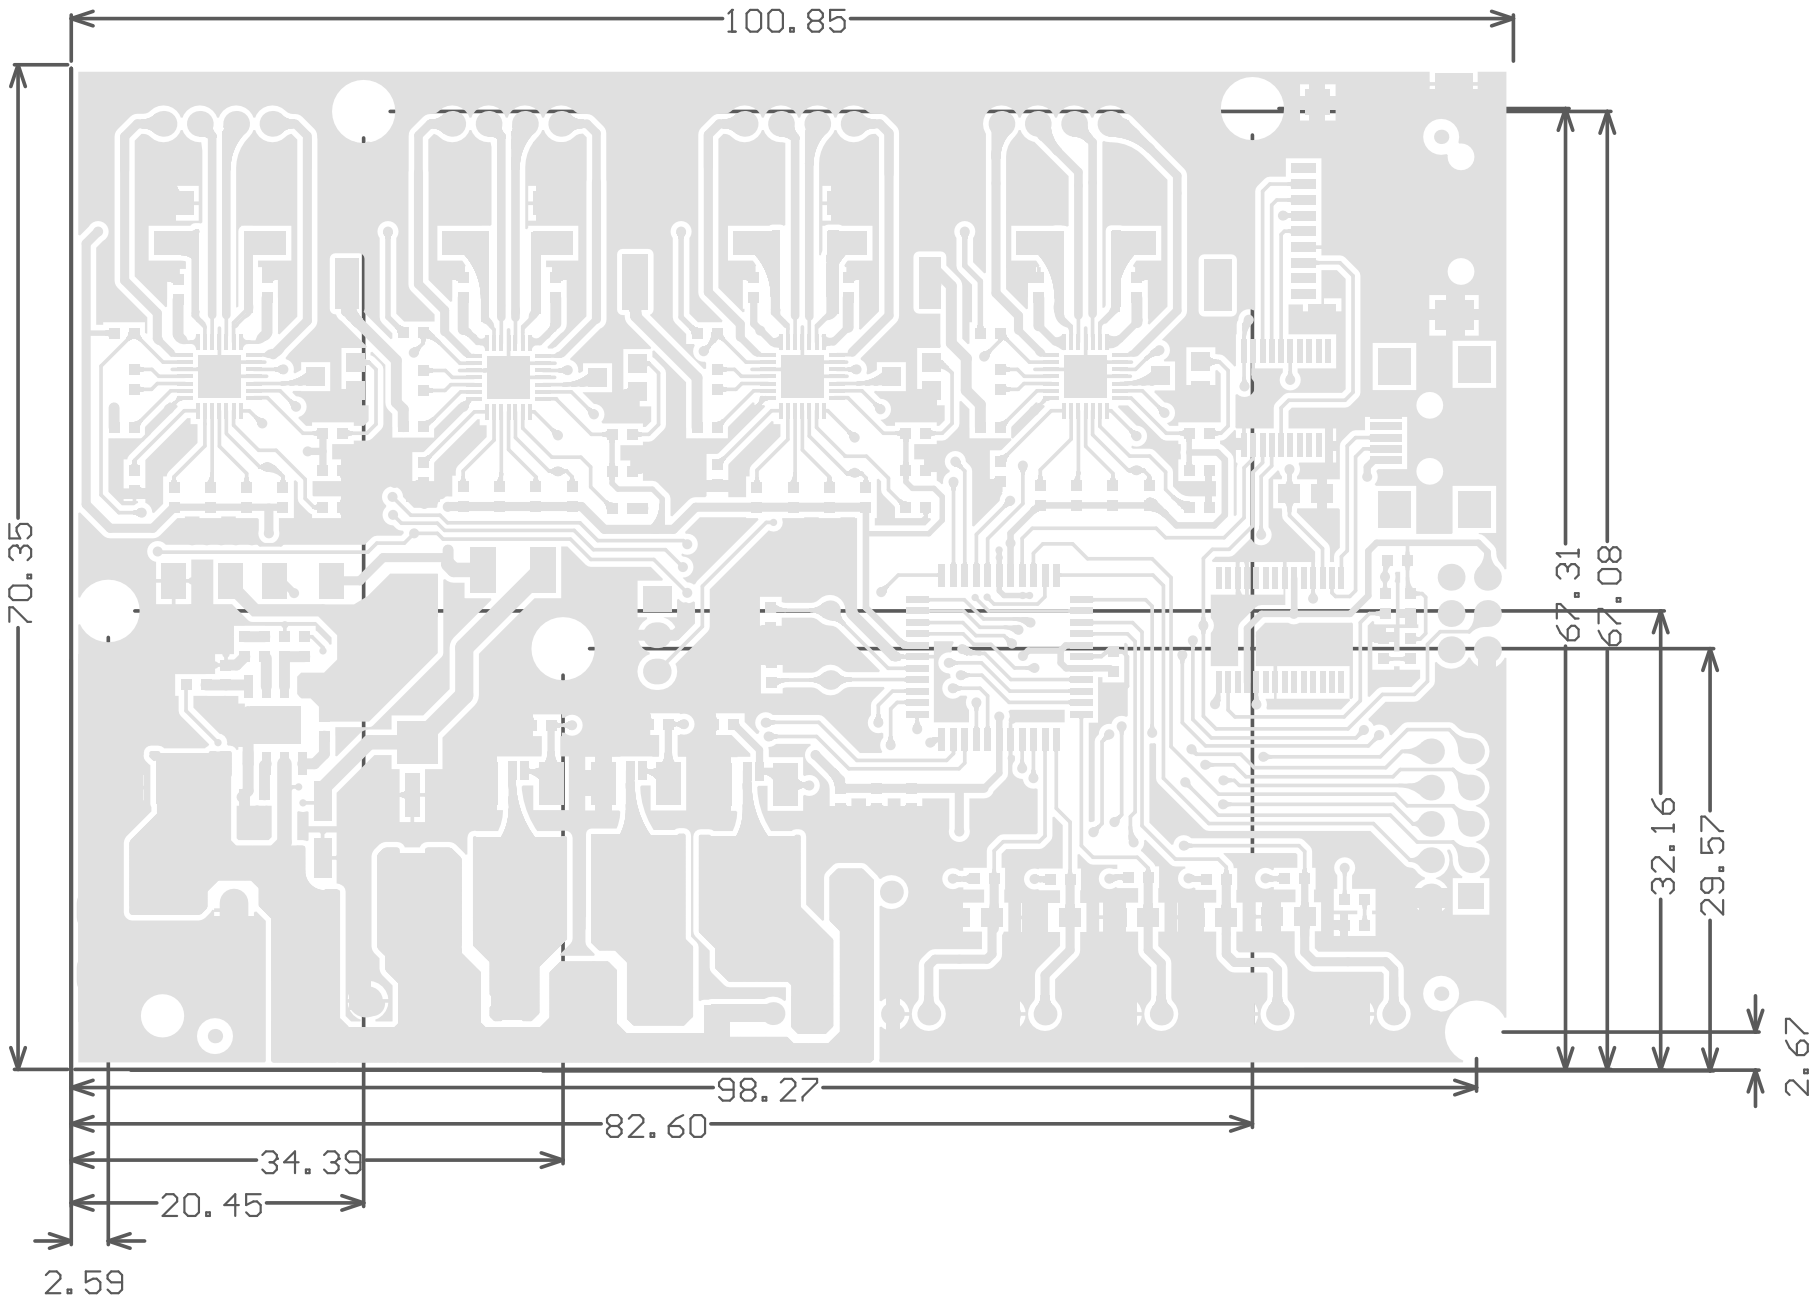
[picture p165: page 4]
