Creality3DPrinting/Ender-3/Ender-3 Mechanical/PDF/2020 profile1.PDF

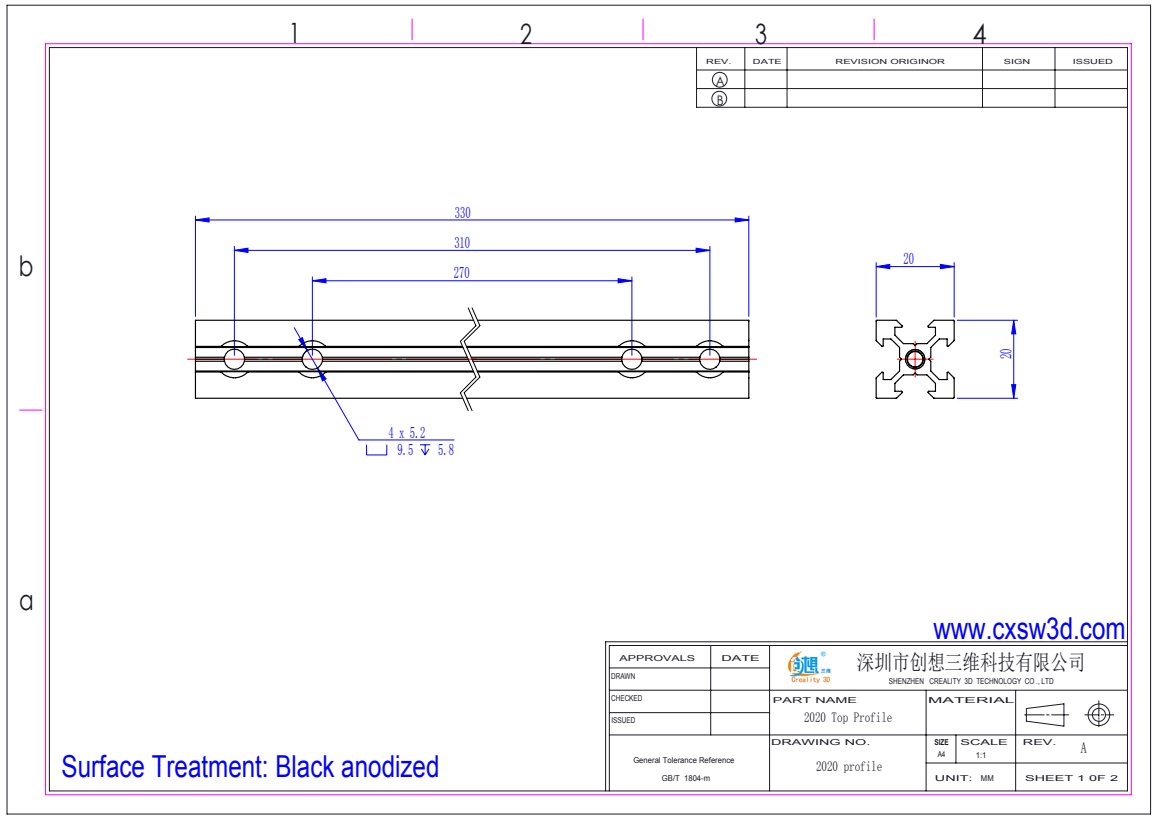
[picture p166: page 1]
Surface Treatment: Black anodized; SIZE SCALE; UNIT: MM; DRAWING NO.; REV.; DATE; REVISION ORIGINOR; SIGN; ISSUED; PART NAME 2020 Top Profile; 2020 profile; SHEET 1 0F 2

SHENZHEN CREALITY 3D TECHNOLOGY CO ., LTD

General Tolerance Reference
