Creality3DPrinting/Ender-3/Ender-3 Mechanical/PDF/2020 profile2.PDF

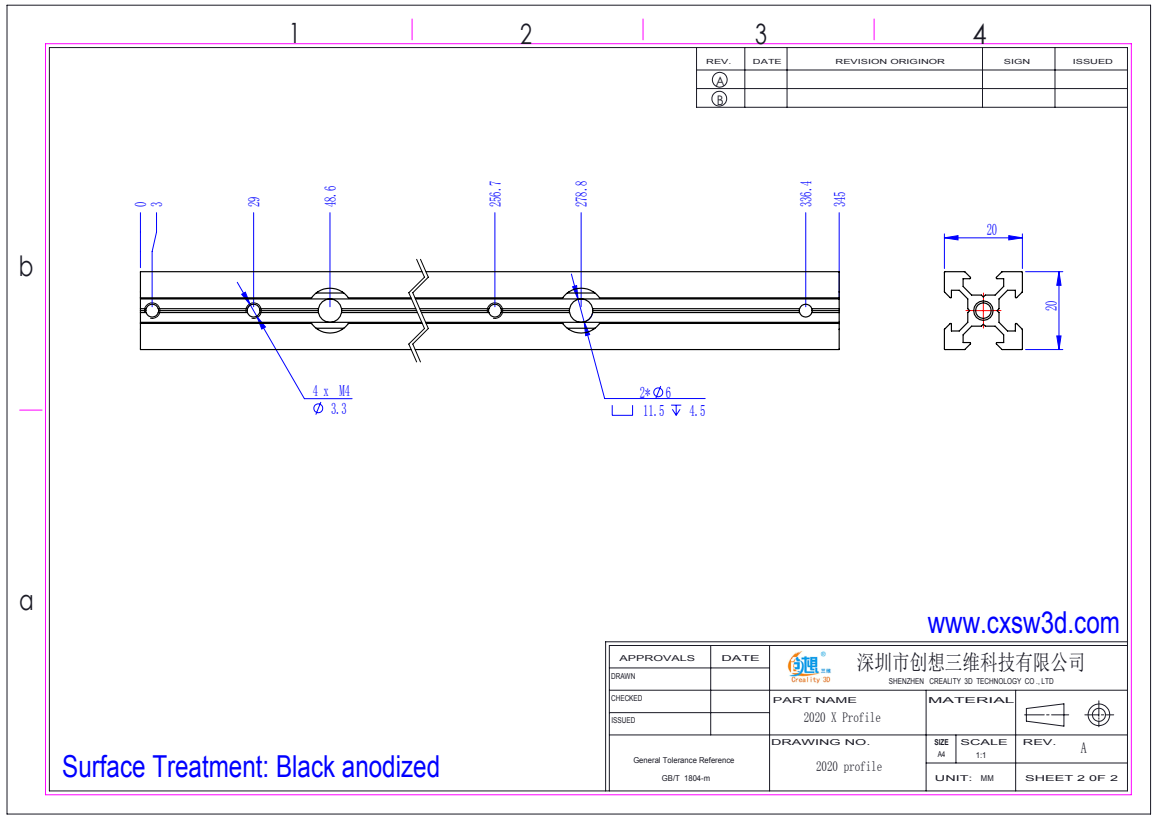
[picture p167: page 1]
SIZE SCALE; UNIT: MM; DRAWING NO.; REV.; DATE; REVISION ORIGINOR; SIGN; ISSUED; PART NAME; 2020 profile; SHEET 2 0F 2; 2020 X Profile

SHENZHEN CREALITY 3D TECHNOLOGY CO ., LTD

Surface Treatment: Black anodized

General Tolerance Reference
