Creality3DPrinting/Ender-3/Ender-3 Mechanical/PDF/2040 profile2.PDF

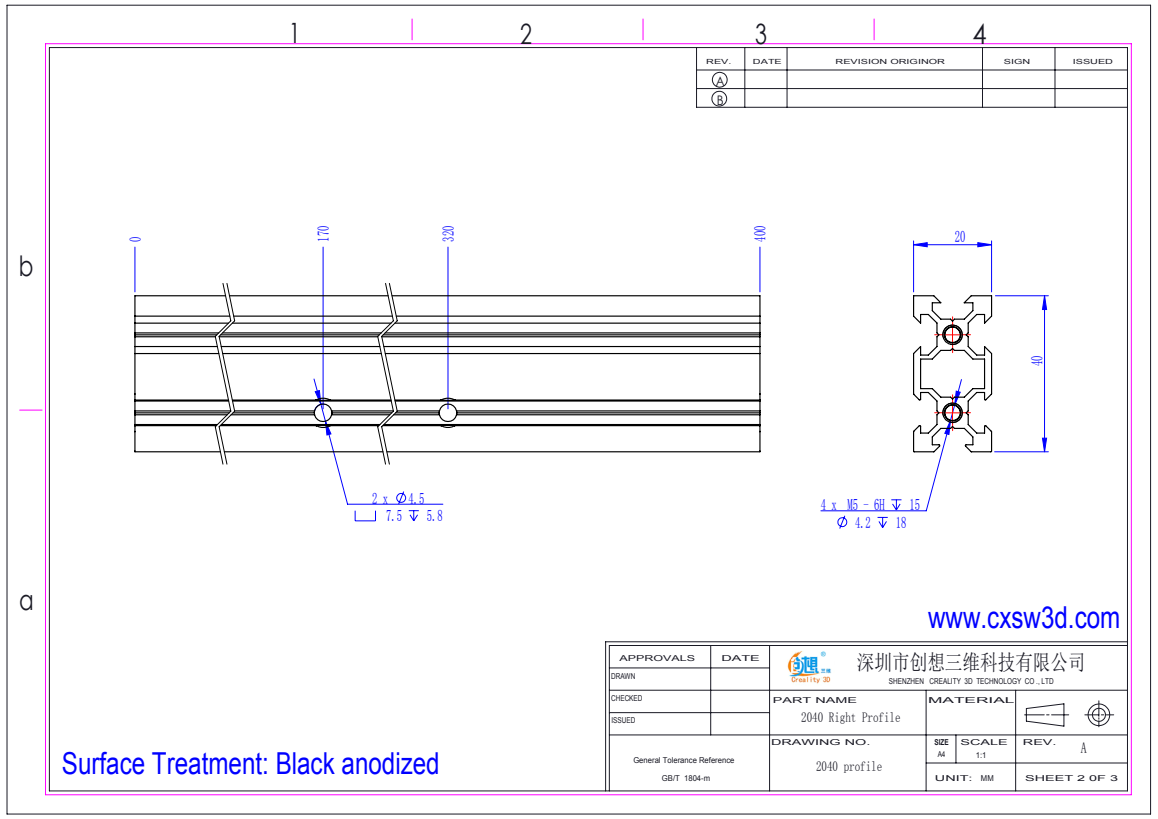
[picture p169: page 1]
SIZE SCALE; UNIT: MM; DRAWING NO.; REV.; DATE; REVISION ORIGINOR; SIGN; ISSUED; PART NAME 2040 Right Profile; 2040 profile; SHEET 2 0F 3

SHENZHEN CREALITY 3D TECHNOLOGY CO ., LTD

Surface Treatment: Black anodized

General Tolerance Reference
