Creality3DPrinting/Ender-3/Ender-3 Mechanical/PDF/4040 profile1.PDF

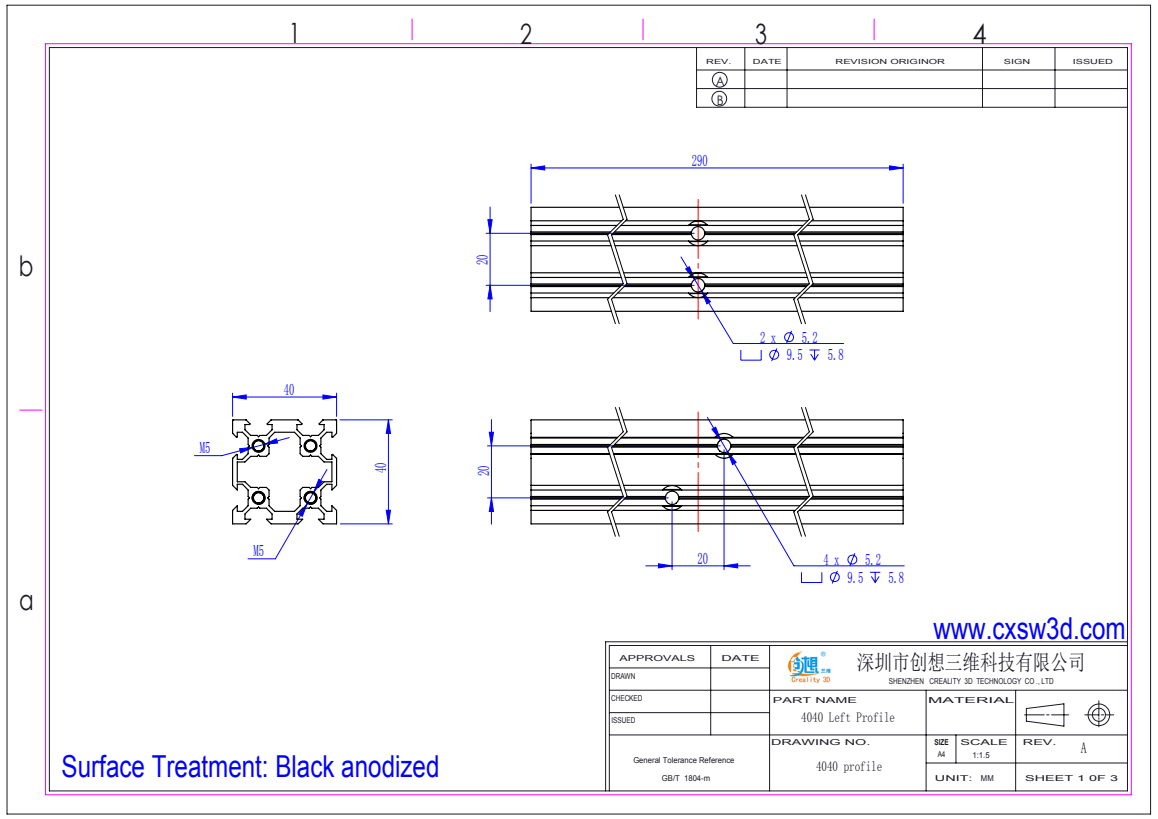
[picture p171: page 1]
Surface Treatment: Black anodized; SIZE SCALE; UNIT: MM; DRAWING NO.; REV.; DATE; REVISION ORIGINOR; SIGN; ISSUED; PART NAME 4040 Left Profile; 4040 profile; SHEET 1 0F 3

SHENZHEN CREALITY 3D TECHNOLOGY CO ., LTD

General Tolerance Reference
