Creality3DPrinting/Ender-3/Ender-3 Mechanical/PDF/4040 profile3.PDF

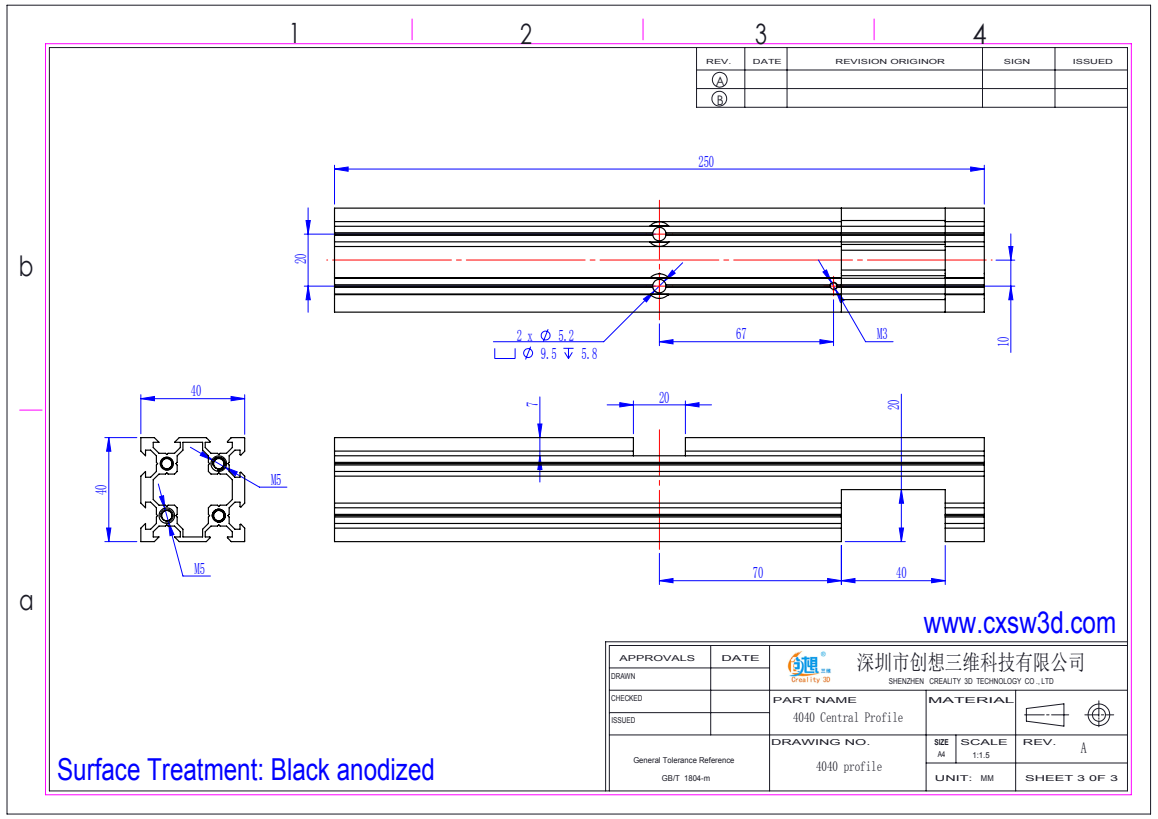
[picture p173: page 1]
SIZE SCALE; UNIT: MM; DRAWING NO.; REV.; DATE; REVISION ORIGINOR; SIGN; ISSUED; PART NAME 4040 Central Profile; 4040 profile; SHEET 3 0F 3

SHENZHEN CREALITY 3D TECHNOLOGY CO ., LTD

Surface Treatment: Black anodized

General Tolerance Reference
