Creality3DPrinting/Ender-3/Ender-3 Mechanical/PDF/Catheter.pdf

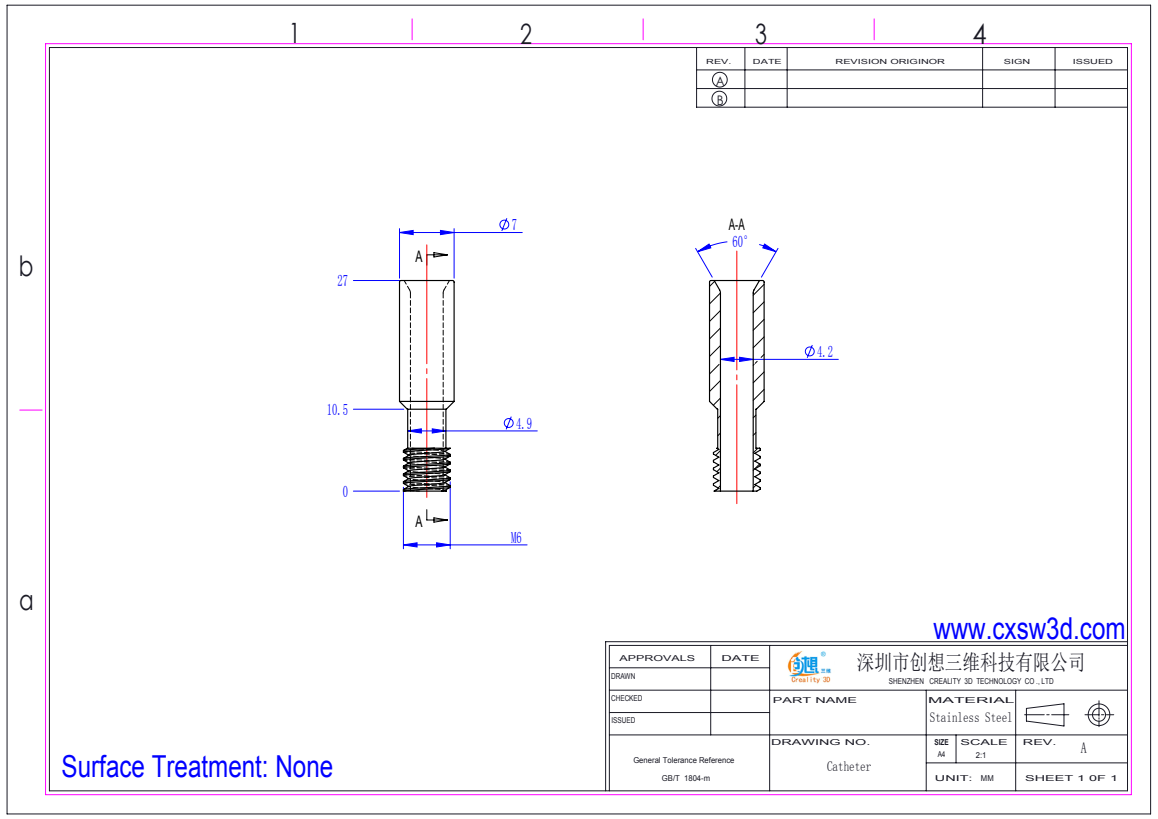
[picture p174: page 1]
Surface Treatment: None; SIZE SCALE; UNIT: MM; DRAWING NO.; REV.; DATE; REVISION ORIGINOR; SIGN; ISSUED; PART NAME; Catheter; SHEET 1 0F 1; Stainless Steel

SHENZHEN CREALITY 3D TECHNOLOGY CO ., LTD

General Tolerance Reference
