Creality3DPrinting/Ender-3/Ender-3 Mechanical/PDF/LCD support.pdf

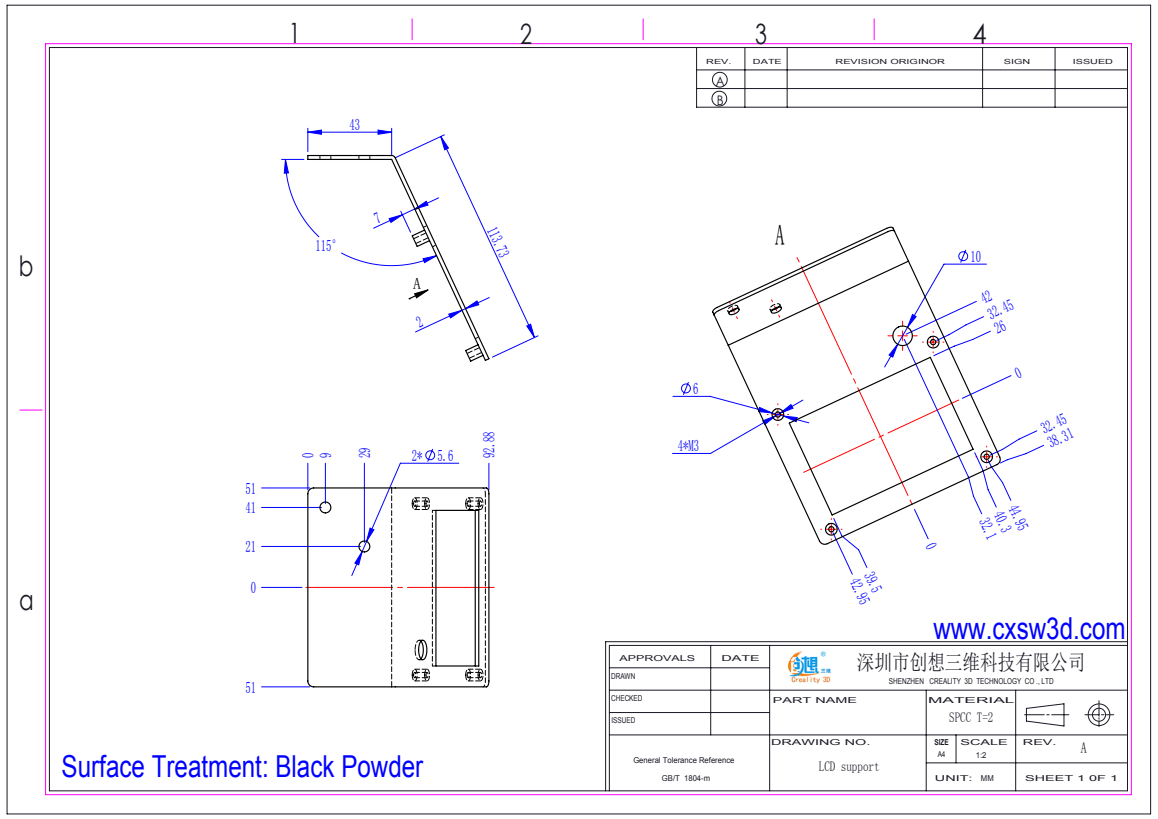
[picture p177: page 1]
Surface Treatment: Black Powder; SIZE SCALE; UNIT: MM; DRAWING NO.; REV.; DATE; REVISION ORIGINOR; SIGN; ISSUED; PART NAME; LCD support; SHEET 1 0F 1; SPCC T=2

SHENZHEN CREALITY 3D TECHNOLOGY CO ., LTD

General Tolerance Reference
