Creality3DPrinting/Ender-3/Ender-3 Wiring/PDF/400306127-Red silicone wire-Model.pdf

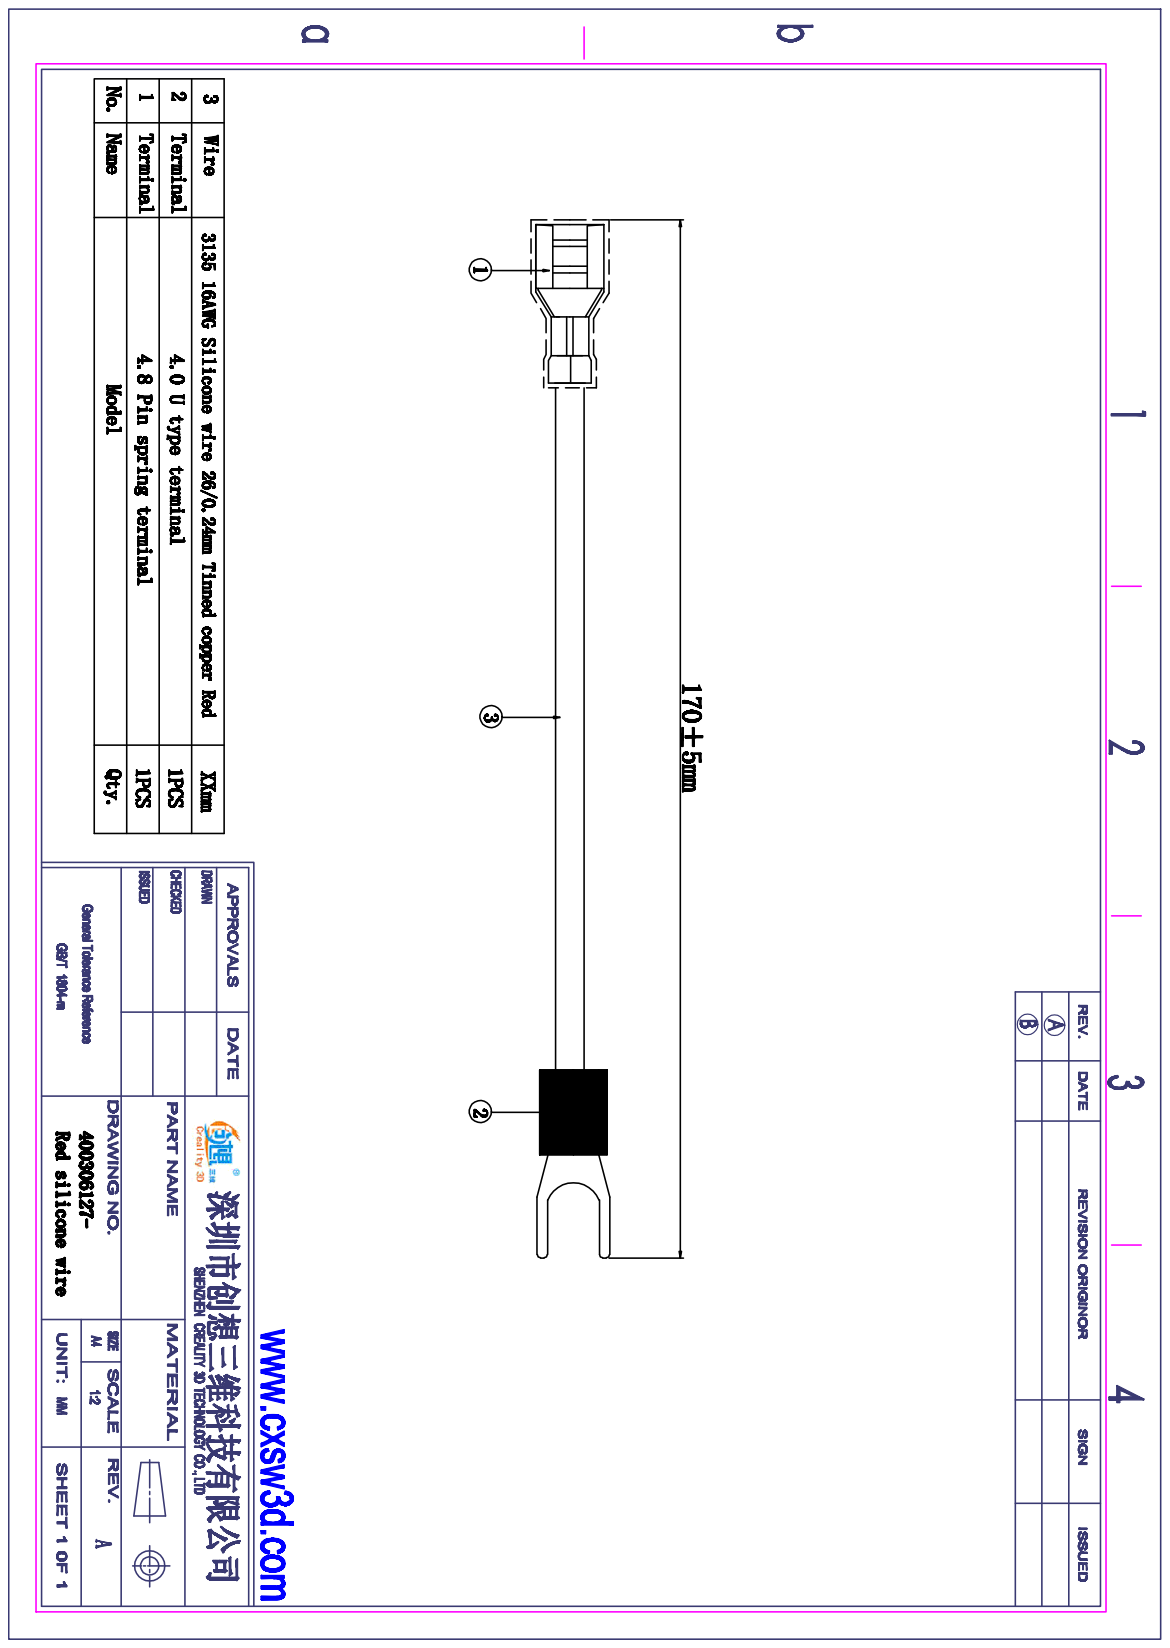
[picture p180: page 1]
