Creality3DPrinting/Ender-3/Ender-3 Wiring/PDF/400306128-Yellow silicone wire-Model.pdf

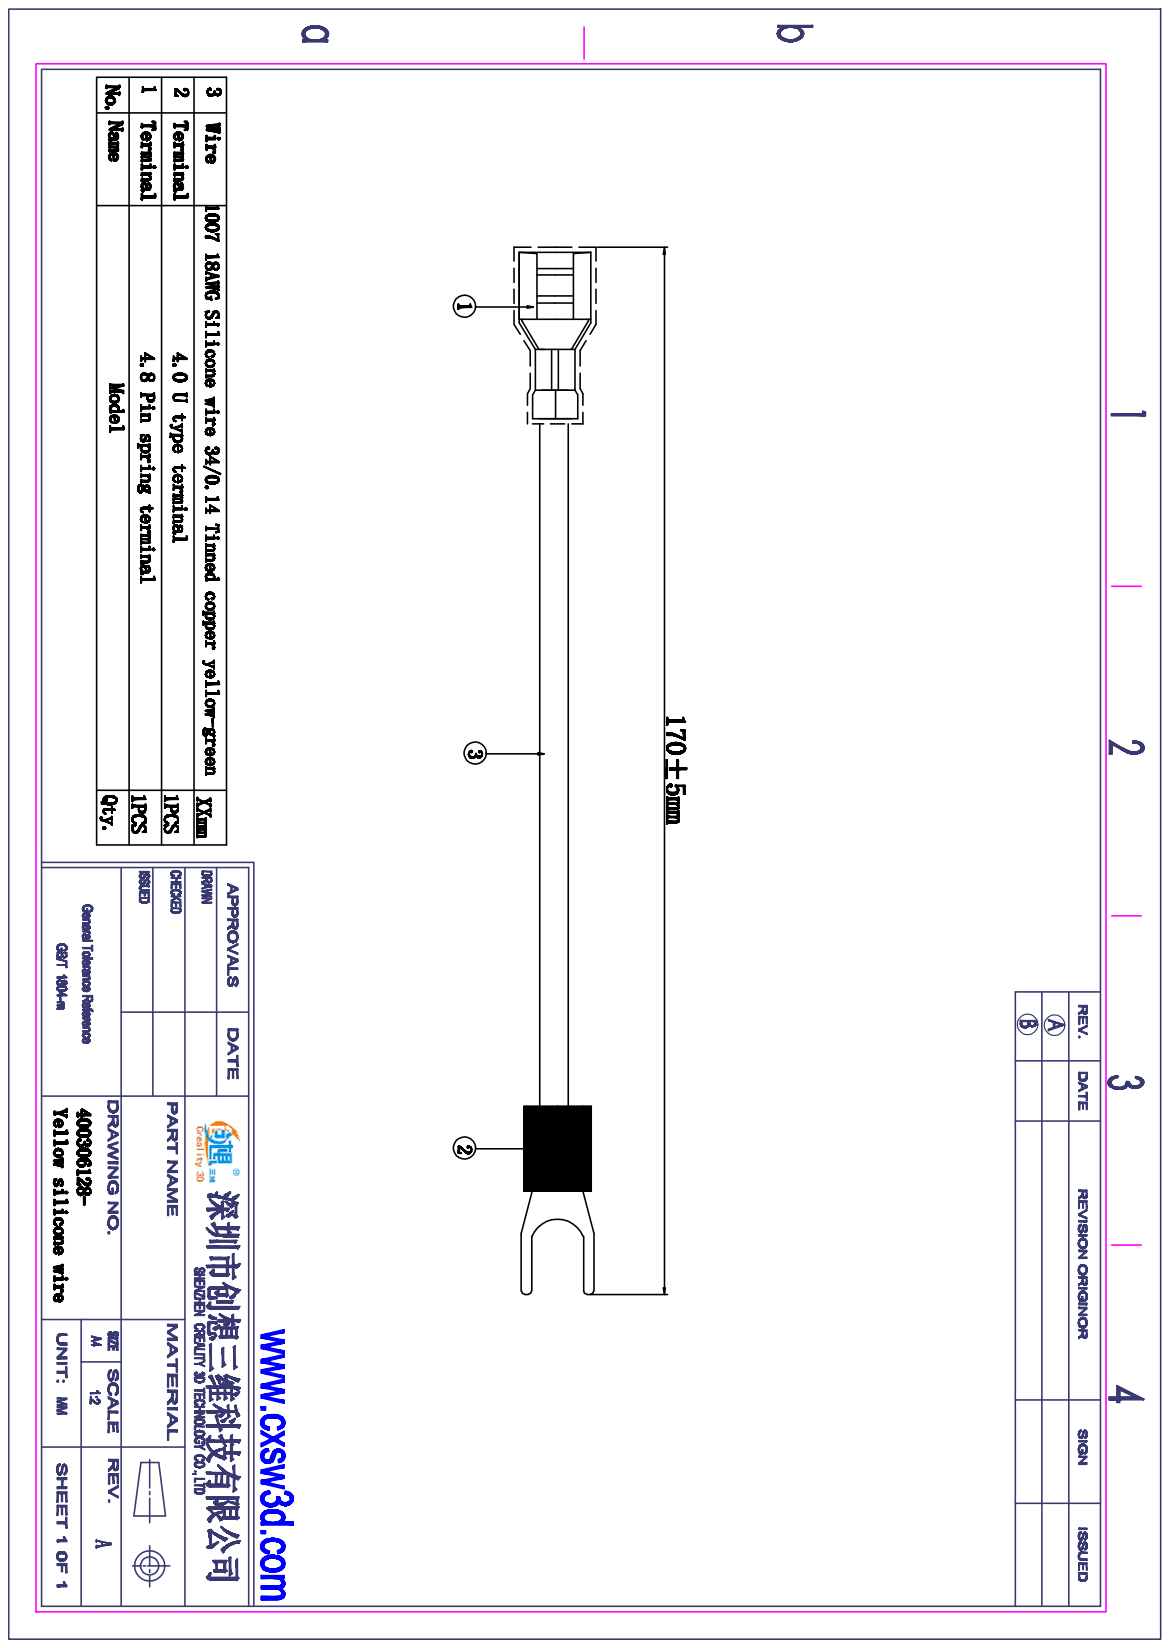
[picture p181: page 1]
