Creality3DPrinting/Ender-3/Ender-3 Wiring/PDF/400306145-Black silicone wire-Model.pdf

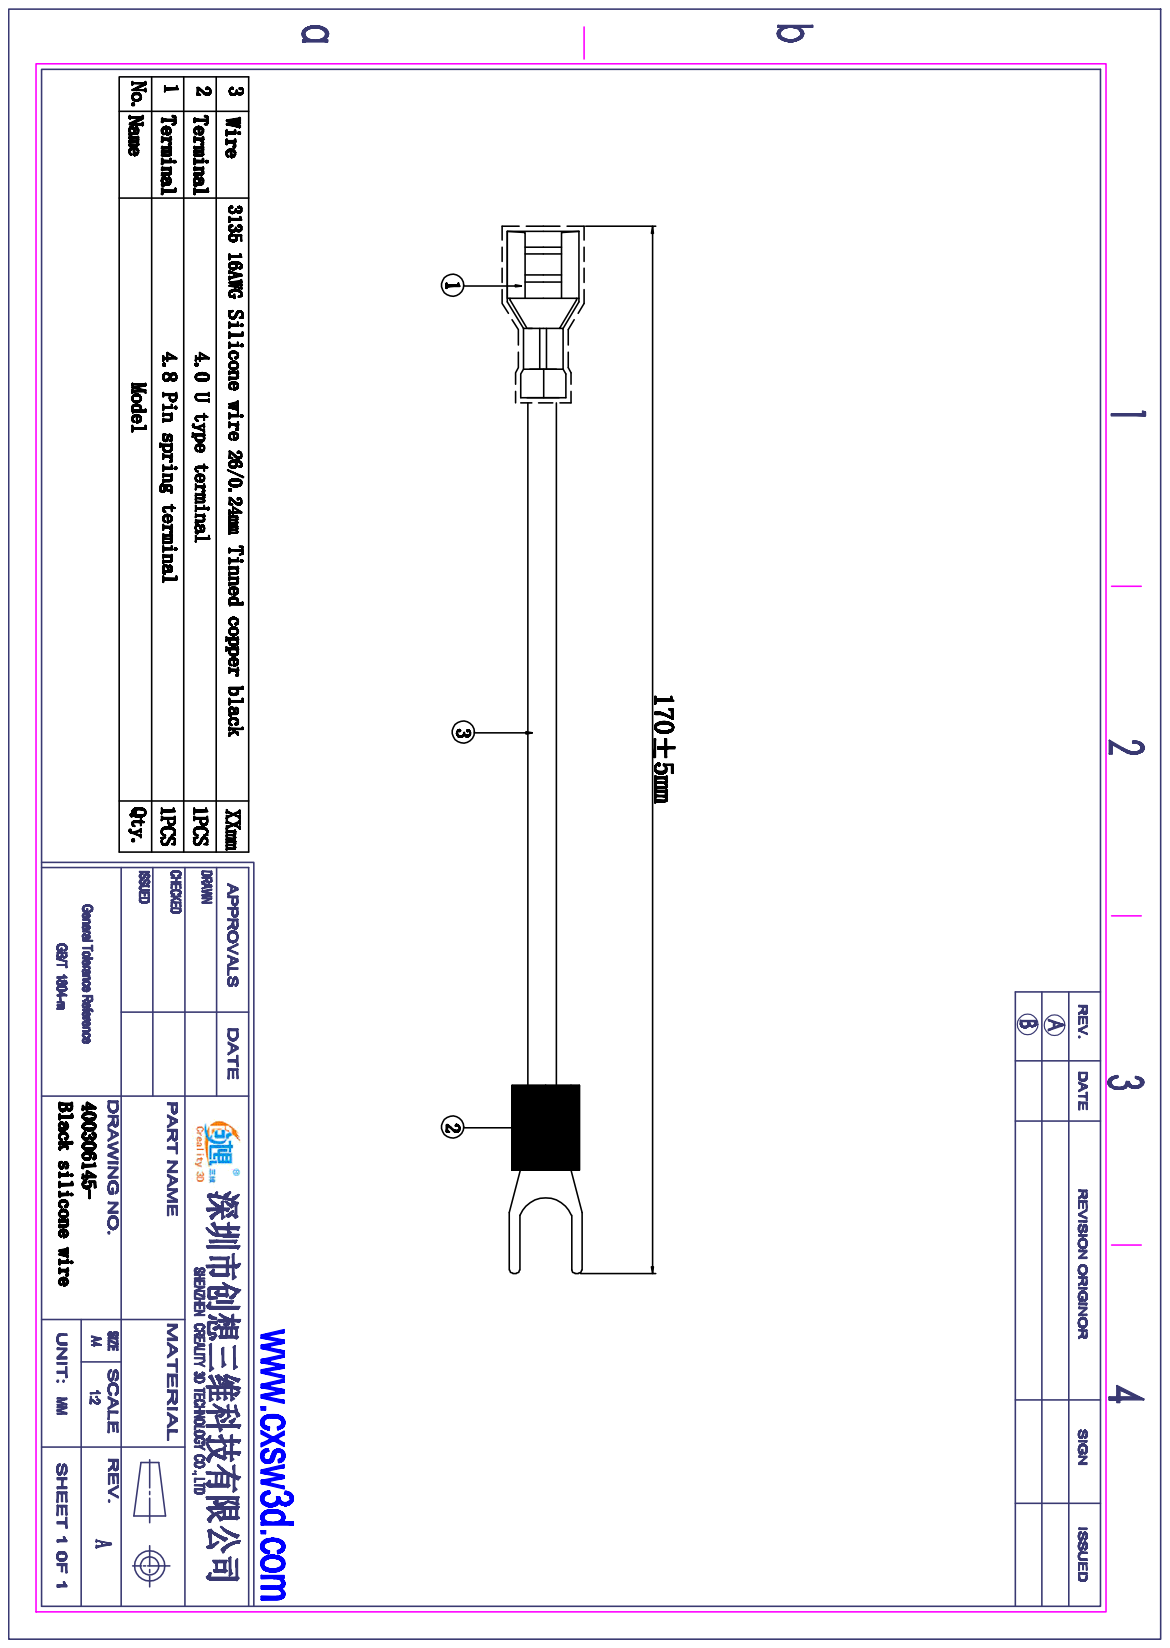
[picture p182: page 1]
