Creality3DPrinting/Ender-3/Ender-3 Wiring/PDF/400306217-Hot bed line-Model.pdf

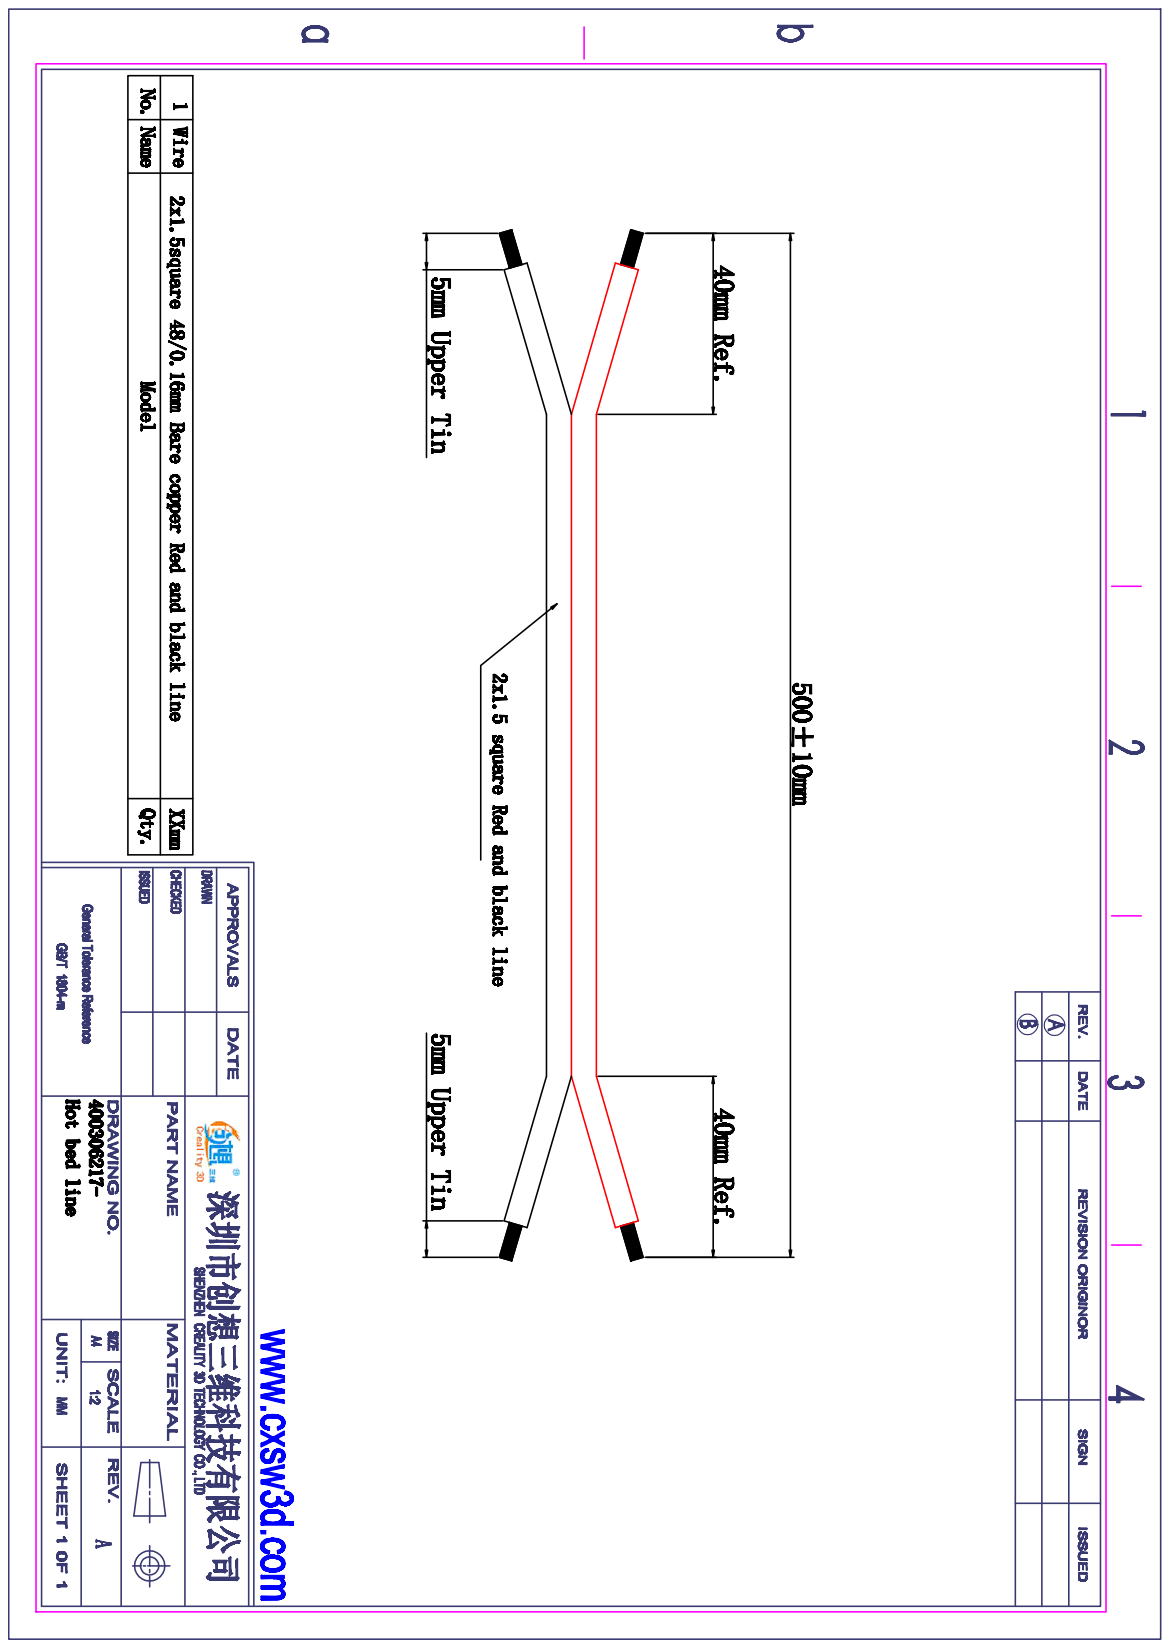
[picture p183: page 1]
