Creality3DPrinting/Ender-3/Ender-3 Wiring/PDF/400306221-Red silicone wire-Model.pdf

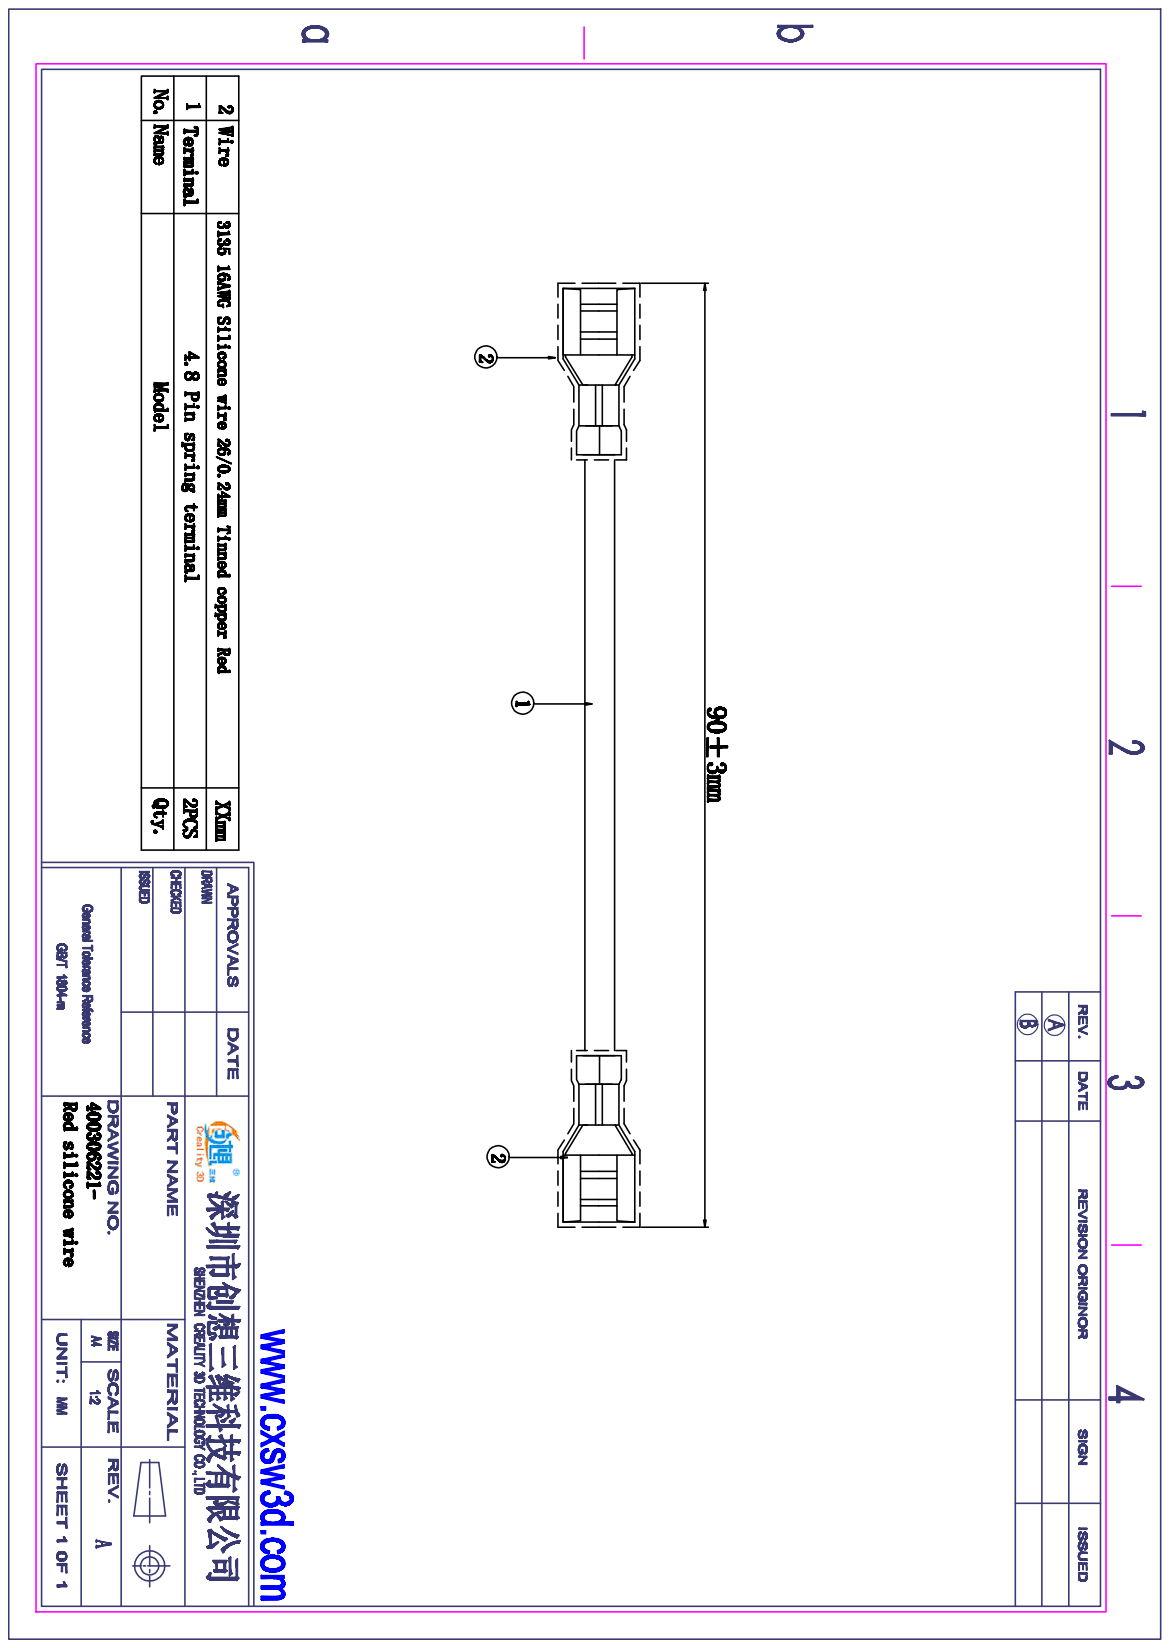
[picture p184: page 1]
