Creality3DPrinting/Ender-3/Ender-3 Wiring/PDF/400306222-Main board line-Model.pdf

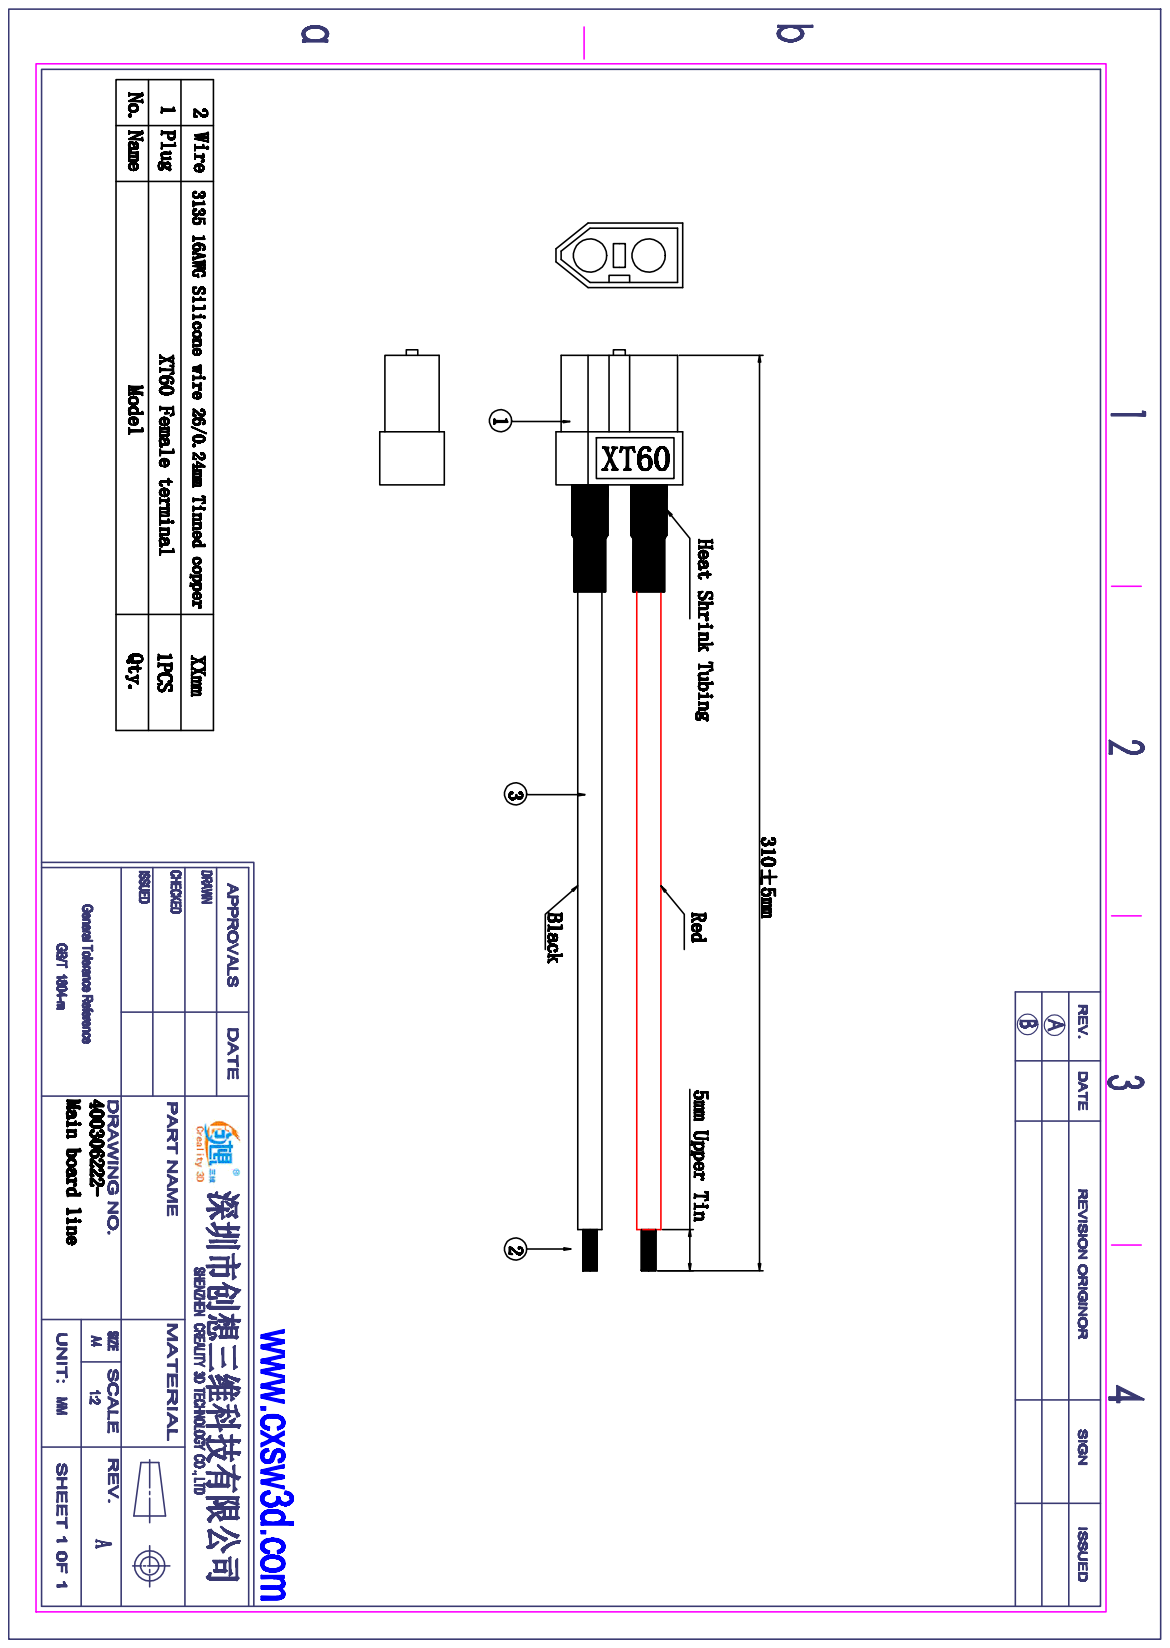
[picture p185: page 1]
