Creality3DPrinting/Ender-3/Ender-3 Wiring/PDF/400306223-power line-Model.pdf

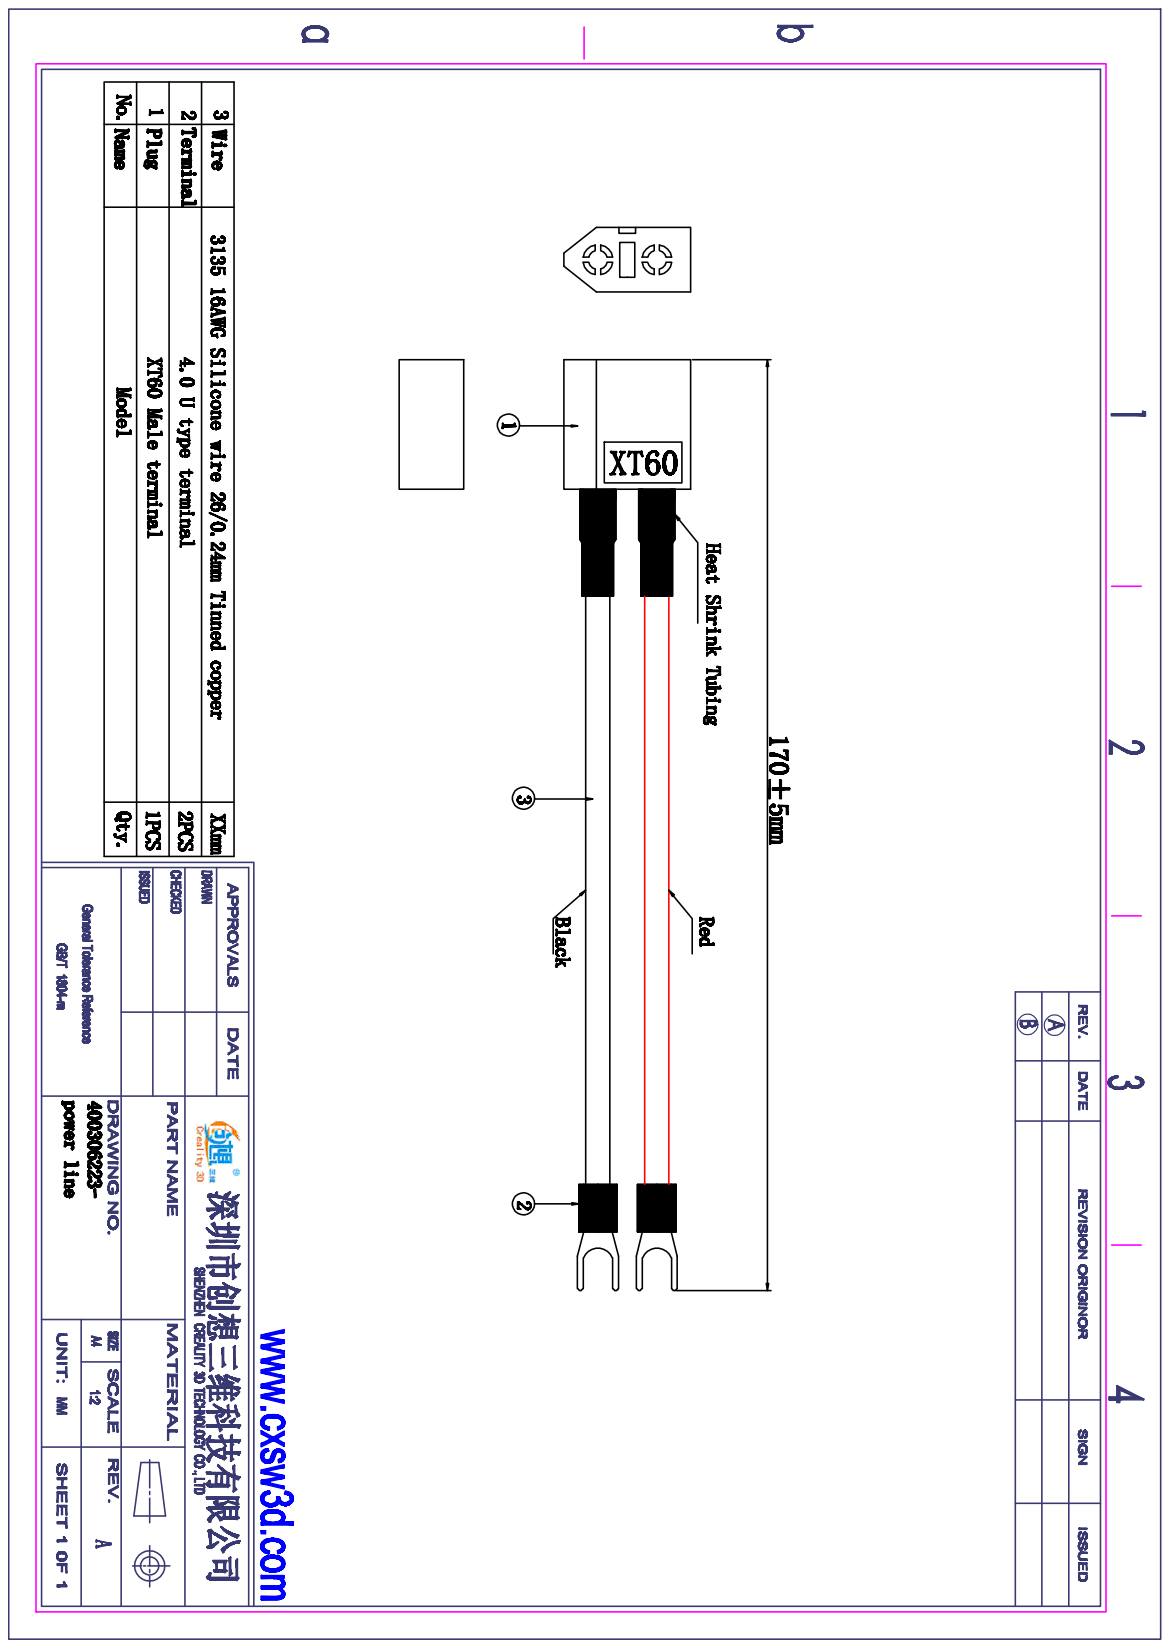
[picture p186: page 1]
