Creality3DPrinting/Ender-3/Ender-3 Wiring/PDF/400306224-X,E Motor Line-Model.pdf

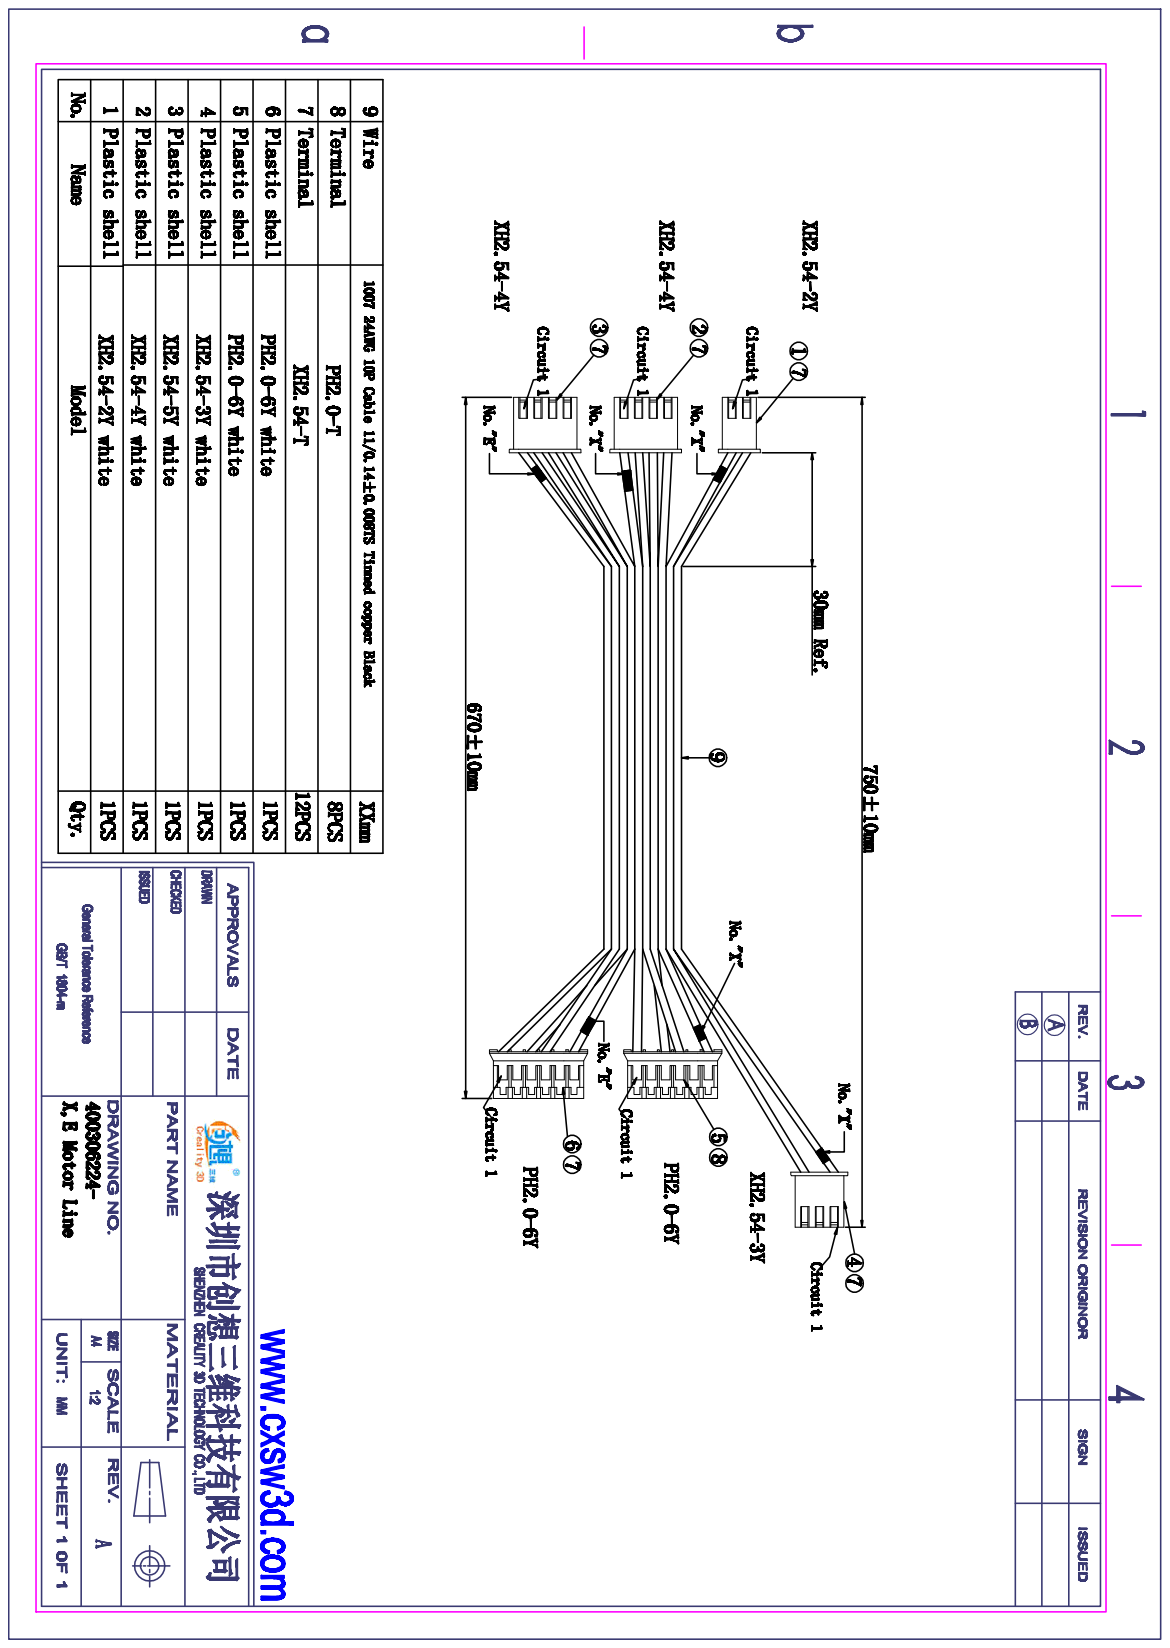
[picture p187: page 1]
