Creality3DPrinting/Ender-3/Ender-3 Wiring/PDF/400306225-Y Motor Line-Model.pdf

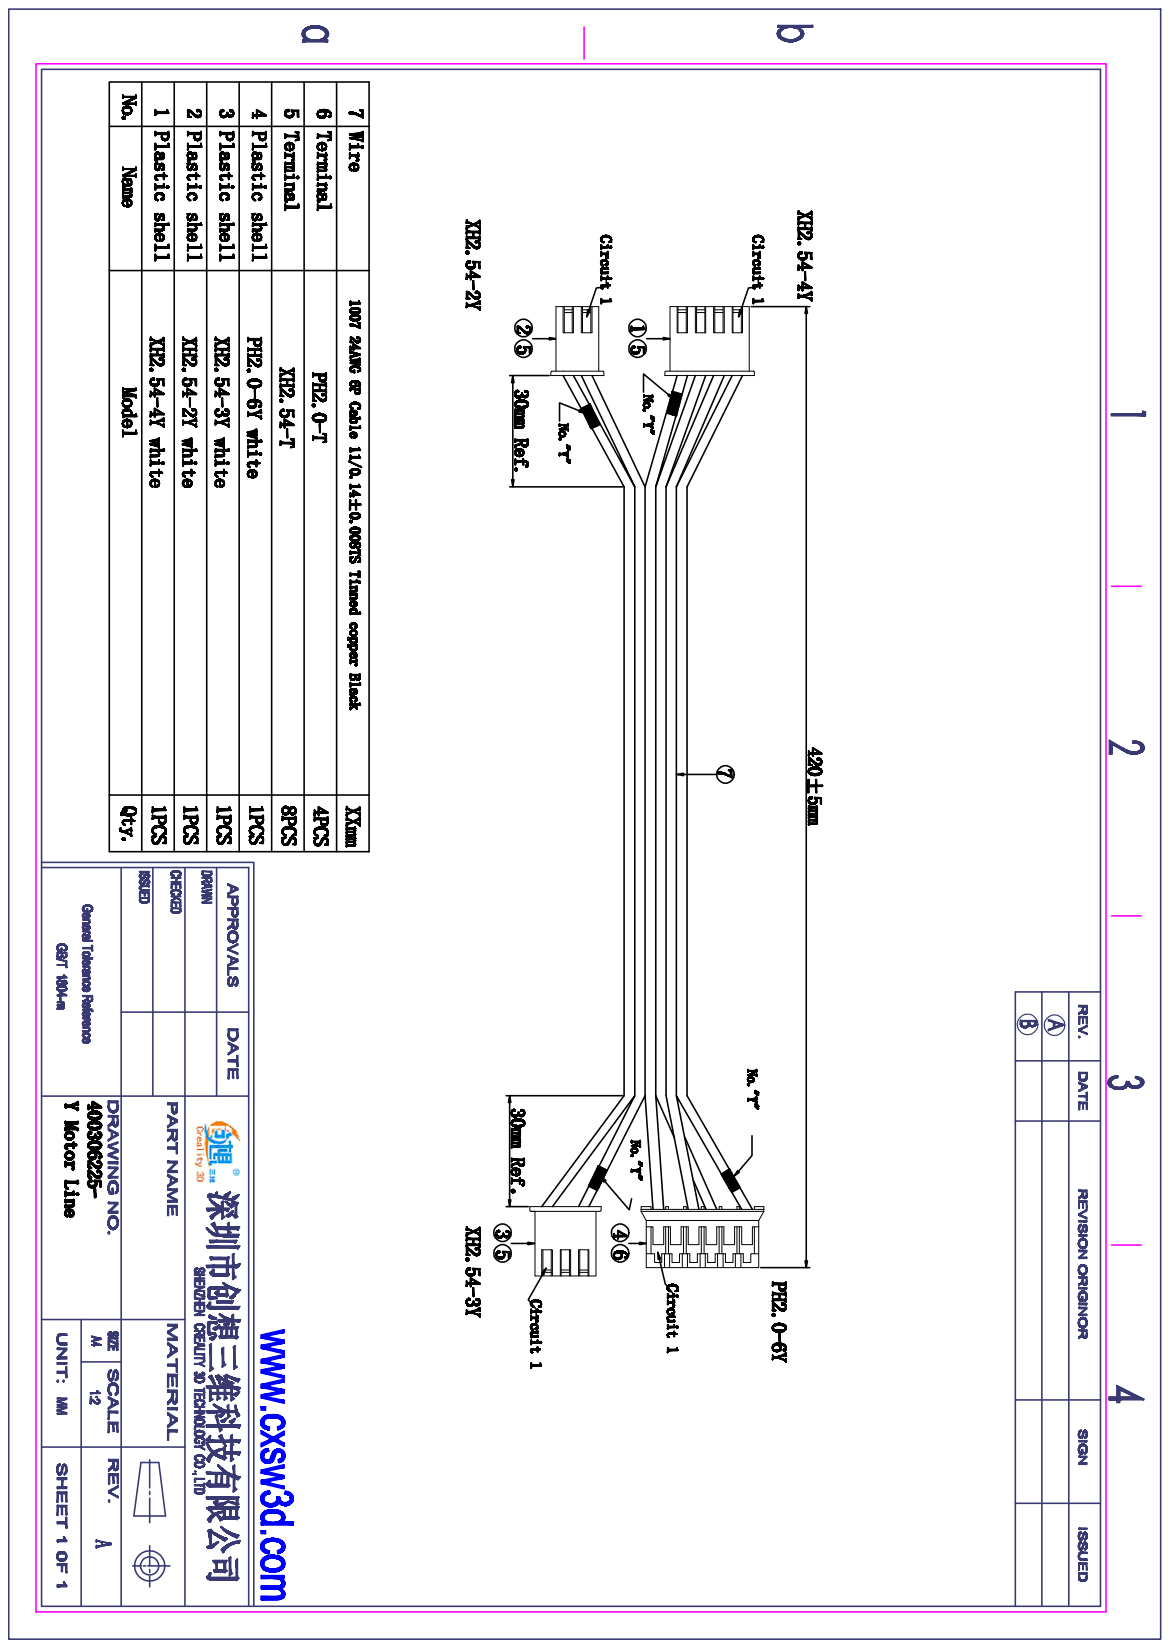
[picture p188: page 1]
