Creality3DPrinting/Ender-3/Ender-3 Wiring/PDF/400306226-Z Motor Line-Model.pdf

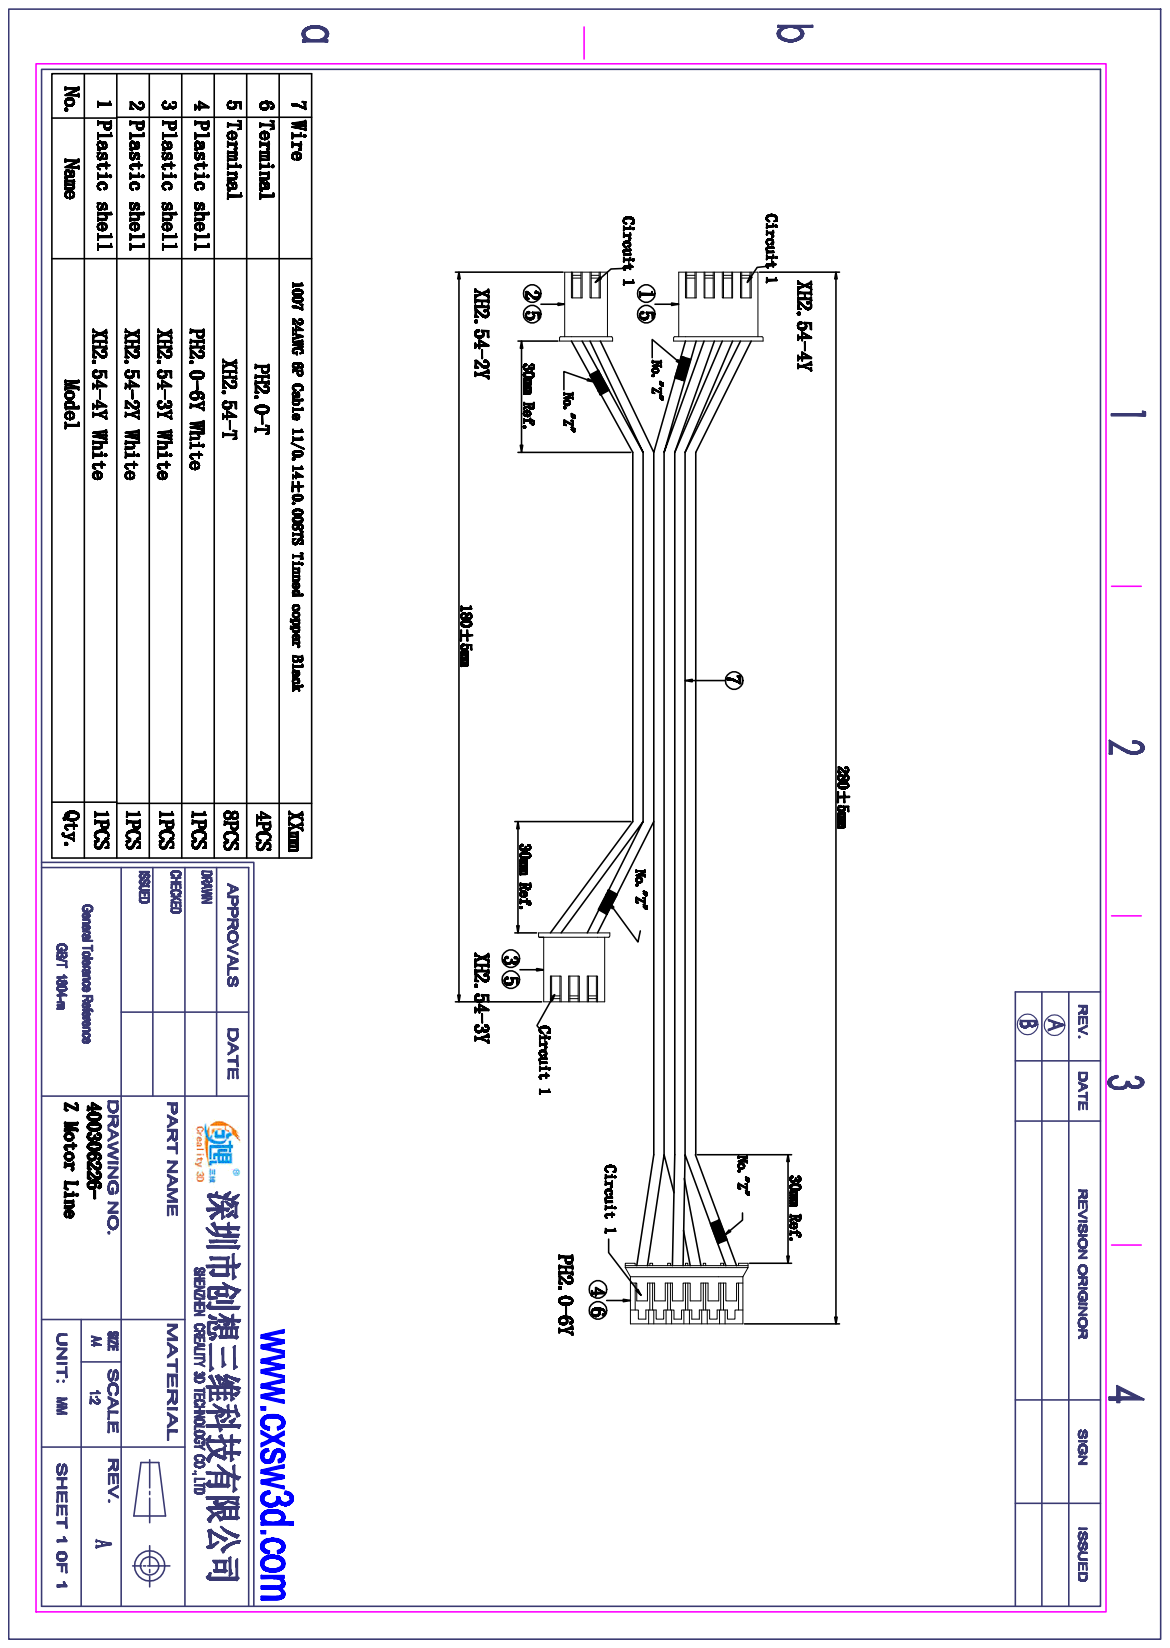
[picture p189: page 1]
