Creality3DPrinting/Ender-3/Ender-3 Wiring/PDF/400306228-Display line-Model.pdf

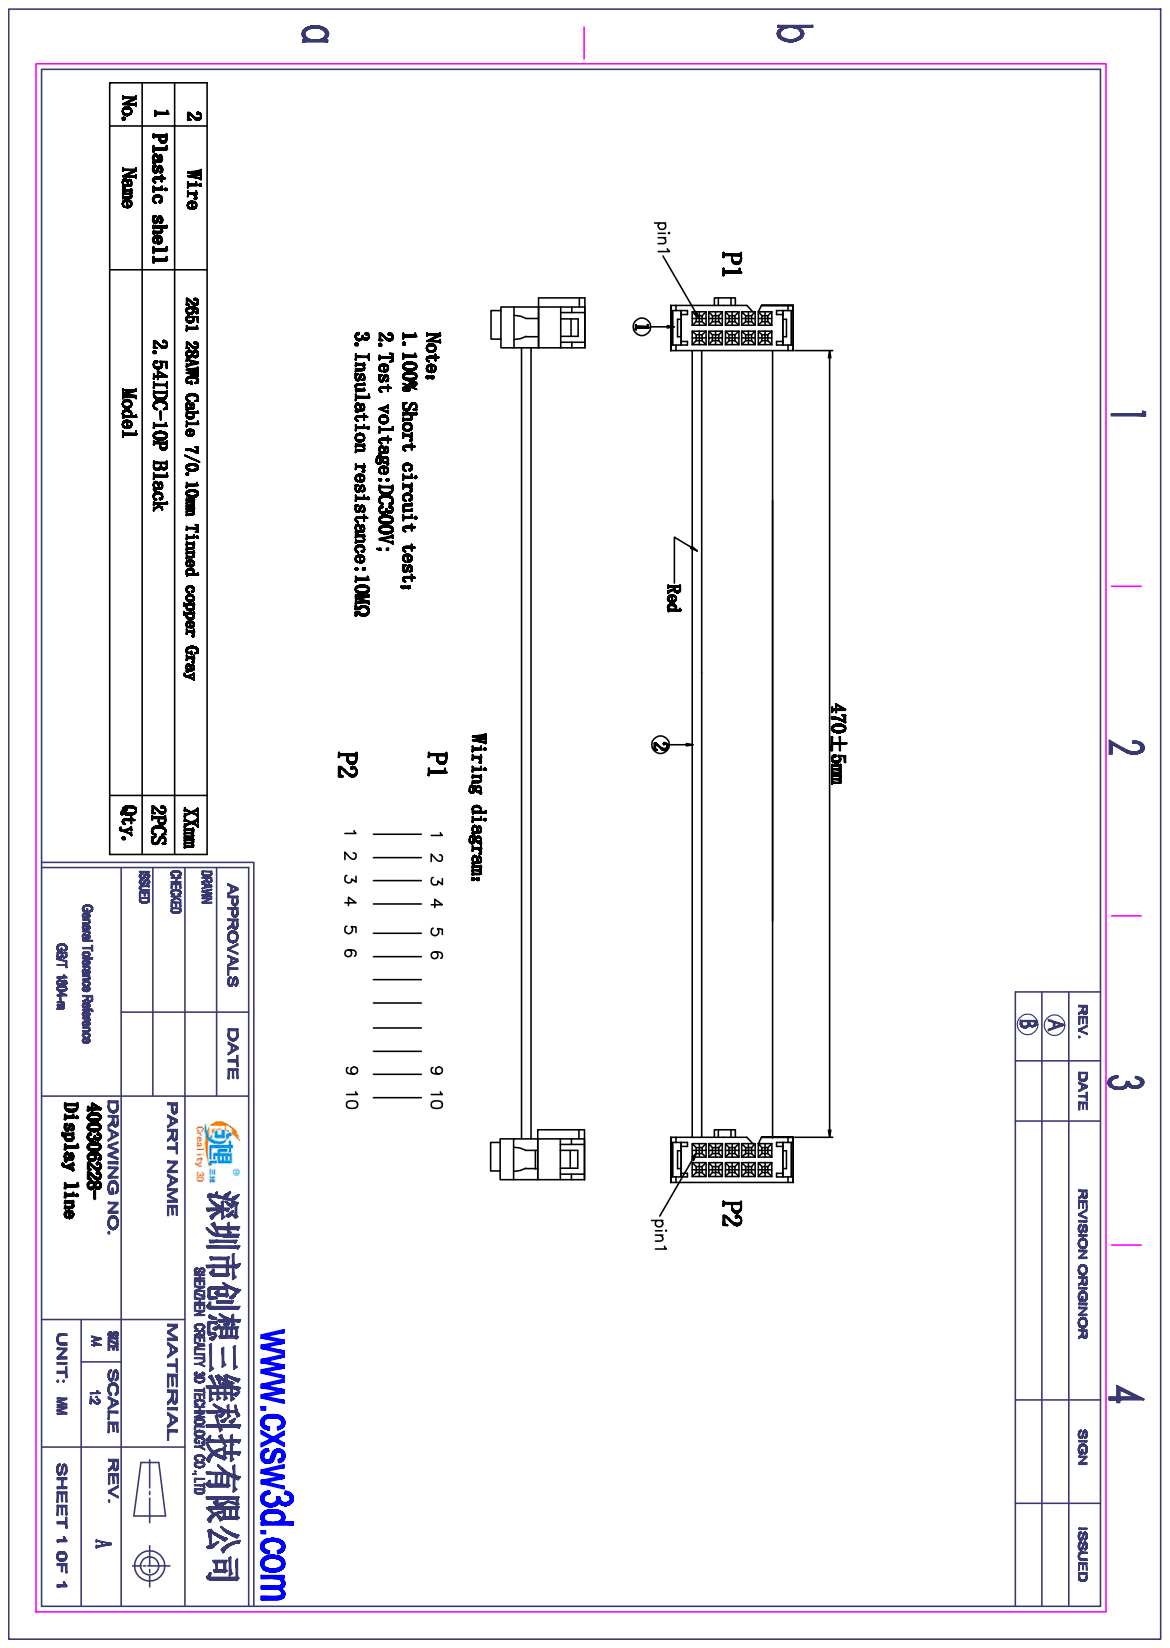
[picture p190: page 1]
