Creality3DPrinting/Ender-3/(list of files, drawings)

Other design files:
Ender-3 PCB/2.8 ASCII File/Ender-3.pcb
Ender-3 PCB/PCB 3.0 Binary File/Ender-3.pcb
Ender-3 PCB/PCB 5.0 Binary File/Ender-3.PcbDoc
Ender-3 PCB/PCB Binary File/Ender-3.PCB
