Creality3DPrinting/Ender-3/Ender-3 Firmware (Marlin)/Ender-3 (includes power failure resume- English)/Marlin/Configuration.h

#define CONFIGURATION_H
#define CONFIGURATION_H_VERSION 010100
#define STRING_CONFIG_H_AUTHOR "(Ender-3)" // Who made the changes.
#define SHOW_BOOTSCREEN
#define SERIAL_PORT 0
#define BAUDRATE 115200
  #define MOTHERBOARD BOARD_MELZI_CREALITY
#define CUSTOM_MACHINE_NAME "Ender-3"
#define EXTRUDERS 1
#define TEMP_SENSOR_0 1
#define TEMP_SENSOR_1 0
#define TEMP_SENSOR_2 0
#define TEMP_SENSOR_3 0
#define TEMP_SENSOR_4 0
#define TEMP_SENSOR_BED 1
#define DUMMY_THERMISTOR_998_VALUE 25
#define DUMMY_THERMISTOR_999_VALUE 100
#define MAX_REDUNDANT_TEMP_SENSOR_DIFF 10
#define TEMP_RESIDENCY_TIME 10  // (seconds)
#define TEMP_HYSTERESIS 3       // (degC) range of +/- temperatures considered "close" to the target one
#define TEMP_WINDOW     1       // (degC) Window around target to start the residency timer x degC early.
#define TEMP_BED_RESIDENCY_TIME 10  // (seconds)
#define TEMP_BED_HYSTERESIS 3       // (degC) range of +/- temperatures considered "close" to the target one
#define TEMP_BED_WINDOW     1       // (degC) Window around target to start the residency timer x degC early.
#define HEATER_0_MINTEMP 5
#define HEATER_1_MINTEMP 5
#define HEATER_2_MINTEMP 5
#define HEATER_3_MINTEMP 5
#define HEATER_4_MINTEMP 5
#define BED_MINTEMP 5
#define HEATER_0_MAXTEMP 275
#define HEATER_1_MAXTEMP 275
#define HEATER_2_MAXTEMP 275
#define HEATER_3_MAXTEMP 275
#define HEATER_4_MAXTEMP 275
#define BED_MAXTEMP 125
#define PIDTEMP
#define BANG_MAX 255 // limits current to nozzle while in bang-bang mode; 255=full current
#define PID_MAX BANG_MAX // limits current to nozzle while PID is active (see PID_FUNCTIONAL_RANGE below); 255=full current
  #define PID_FUNCTIONAL_RANGE 10 // If the temperature difference between the target temperature and the actual temperature
  #define K1 0.95 //smoothing factor within the PID
  #define  DEFAULT_Kp 20.84
  #define  DEFAULT_Ki 1.96
  #define  DEFAULT_Kd 55.47
#define MAX_BED_POWER 255 // limits duty cycle to bed; 255=full current
#define PREVENT_COLD_EXTRUSION
#define EXTRUDE_MINTEMP 170
#define PREVENT_LENGTHY_EXTRUDE
#define EXTRUDE_MAXLENGTH 200
#define THERMAL_PROTECTION_HOTENDS // Enable thermal protection for all extruders
#define THERMAL_PROTECTION_BED     // Enable thermal protection for the heated bed
#define USE_XMIN_PLUG
#define USE_YMIN_PLUG
#define USE_ZMIN_PLUG
#define ENDSTOPPULLUPS // Comment this out (using // at the start of the line) to disable the endstop pullup resistors
#define X_MIN_ENDSTOP_INVERTING false // set to true to invert the logic of the endstop.
#define Y_MIN_ENDSTOP_INVERTING false // set to true to invert the logic of the endstop.
#define Z_MIN_ENDSTOP_INVERTING false // set to true to invert the logic of the endstop.
#define X_MAX_ENDSTOP_INVERTING false // set to true to invert the logic of the endstop.
#define Y_MAX_ENDSTOP_INVERTING false // set to true to invert the logic of the endstop.
#define Z_MAX_ENDSTOP_INVERTING false // set to true to invert the logic of the endstop.
#define Z_MIN_PROBE_ENDSTOP_INVERTING false // set to true to invert the logic of the probe.
#define DEFAULT_AXIS_STEPS_PER_UNIT   { 80.00, 80.00, 400.00, 93.00 }
#define DEFAULT_MAX_FEEDRATE          { 500, 500, 5, 25 }
#define DEFAULT_MAX_ACCELERATION      { 500, 500, 100, 1000 }
#define DEFAULT_ACCELERATION          500    // X, Y, Z and E acceleration for printing moves
#define DEFAULT_RETRACT_ACCELERATION  500    // E acceleration for retracts
#define DEFAULT_TRAVEL_ACCELERATION   1000   // X, Y, Z acceleration for travel (non printing) moves
#define DEFAULT_XJERK                 10.0
#define DEFAULT_YJERK                 10.0
#define DEFAULT_ZJERK                  0.4
#define DEFAULT_EJERK                  5.0
#define Z_MIN_PROBE_USES_Z_MIN_ENDSTOP_PIN
#define X_PROBE_OFFSET_FROM_EXTRUDER 0  // X offset: -left  +right  [of the nozzle]
#define Y_PROBE_OFFSET_FROM_EXTRUDER 0  // Y offset: -front +behind [the nozzle]
#define Z_PROBE_OFFSET_FROM_EXTRUDER 0  // Z offset: -below +above  [the nozzle]
#define XY_PROBE_SPEED 3000
#define Z_PROBE_SPEED_FAST HOMING_FEEDRATE_Z
#define Z_PROBE_SPEED_SLOW (Z_PROBE_SPEED_FAST / 2)
#define Z_CLEARANCE_DEPLOY_PROBE   10 // Z Clearance for Deploy/Stow
#define Z_CLEARANCE_BETWEEN_PROBES  5 // Z Clearance between probe points
#define Z_PROBE_OFFSET_RANGE_MIN -20
#define Z_PROBE_OFFSET_RANGE_MAX 20
#define X_ENABLE_ON 0
#define Y_ENABLE_ON 0
#define Z_ENABLE_ON 0
#define E_ENABLE_ON 0 // For all extruders
#define DISABLE_X false
#define DISABLE_Y false
#define DISABLE_Z false
#define DISABLE_E false // For all extruders
#define DISABLE_INACTIVE_EXTRUDER true // Keep only the active extruder enabled.
#define INVERT_X_DIR true
#define INVERT_Y_DIR true
#define INVERT_Z_DIR false
#define INVERT_E0_DIR true
#define INVERT_E1_DIR false
#define INVERT_E2_DIR false
#define INVERT_E3_DIR false
#define INVERT_E4_DIR false
#define X_HOME_DIR -1
#define Y_HOME_DIR -1
#define Z_HOME_DIR -1
#define X_BED_SIZE 235
#define Y_BED_SIZE 235
#define X_MIN_POS 0
#define Y_MIN_POS 0
#define Z_MIN_POS 0
#define X_MAX_POS X_BED_SIZE
#define Y_MAX_POS Y_BED_SIZE
#define Z_MAX_POS 250
#define MIN_SOFTWARE_ENDSTOPS
#define MAX_SOFTWARE_ENDSTOPS
#define HOMING_FEEDRATE_XY (50*60)
#define HOMING_FEEDRATE_Z  (4*60)
#define EEPROM_SETTINGS // Enable for M500 and M501 commands
#define HOST_KEEPALIVE_FEATURE        // Disable this if your host doesn't like keepalive messages
#define DEFAULT_KEEPALIVE_INTERVAL 2  // Number of seconds between "busy" messages. Set with M113.
#define BUSY_WHILE_HEATING            // Some hosts require "busy" messages even during heating
#define PREHEAT_1_TEMP_HOTEND 185
#define PREHEAT_1_TEMP_BED     45
#define PREHEAT_1_FAN_SPEED   255 // Value from 0 to 255
#define PREHEAT_2_TEMP_HOTEND 240
#define PREHEAT_2_TEMP_BED     70
#define PREHEAT_2_FAN_SPEED   255 // Value from 0 to 255
#define PRINTJOB_TIMER_AUTOSTART
#define LCD_LANGUAGE en
#define DISPLAY_CHARSET_HD44780 JAPANESE
#define SDSUPPORT
#define CR10_STOCKDISPLAY
#define SOFT_PWM_SCALE 0
#define SERVO_DELAY { 300 }
#define DEFAULT_NOMINAL_FILAMENT_DIA 1.75   // (mm) Diameter of the filament generally used (3.0 or 1.75mm), also used in the slicer. Used to validate sensor reading.
