Creality3DPrinting/Ender-3/(commit log)

2018-09-13 Adding files provided by github user SIeeepy
    [2020 Endcap.SLDPRT, 2020 profile.SLDPRT, 2020-2 profile.SLDPRT, 2040-2 profile.SLDPRT, 2040-3L profile.SLDPRT, 2040-3R profile.SLDPRT, 24V15A power supply.SLDPRT, 2GT-pulley.SLDPRT]
2018-09-13 More CAD formats provided
2019-03-04 Fix compilation error caused by fpos_t struct
    Appearently building Marlin on Arduino IDE version 1.8.x causes
    the compilation error `using typedef-name 'fpos_t' after 'struct'`
    Renaming `fpos_t` to `filepos_t` fixed the error.
2019-12-11 updated PCB PDF with all layer version from PR #14 comments
2019-12-11 fix filename of '42-40 motor.SLDPRT'
    [42-40 motor.SLDPRT]
2019-12-11 update English firmware to 2019-04-29 version
    [Configuration.h, Configuration_adv.h, Menu Plans.xlsx]
2019-12-11 add SD card contents
    [Ender 3 User Guide.xls, test-dog.stl]
