Creality3DPrinting/Ender-3/(notices)

Notices in the files:
Ender-3 Firmware (Marlin)/Ender-3 (includes power failure resume- English)/Marlin/Configuration_adv.h:
Copyright (C) 2016 MarlinFirmware [https://github.com/MarlinFirmware/Marlin]
Copyright (C) 2011 Camiel Gubbels / Erik van der Zalm
This program is free software: you can redistribute it and/or modify
it under the terms of the GNU General Public License as published by
the Free Software Foundation, either version 3 of the License, or
(at your option) any later version.
